reprapperMC/mini-gladiola/production_parts/machined_parts/bed_mount_plate/README

bed-mount-plate-mini_PP-MP0146_revD - without laser etching
bed-mount-plate-mini_PP-MP0146_revC - with laser etching
