reprapperMC/mini-gladiola/production_parts/machined_parts/electronics_case/README

revH - without laser etching
revG - with laser etching
