reprapperMC/mini-gladiola/gladiola_update.odt

Gladiola Feature Change/Addition | Notes
Cork/or other Dampening (z and y motors) | Using Moon’s dampener for Y axis, still reviewing for Z.
Wipe Fail Detect | Completed and need further testing
Thermal Runaway | Completed and need further testing
Moons Motors | Built up and testing with motors. Motors on BOM
Add fan guard inside of case on back side of fan to protect wiring captures and external ingress ease | Existing part – adding to BOM
Cable Chain Modifications/wiring improvements - Add ferrules to all power carrying wires and all wires connected to screw terminals. - Widen e-chains to maximum width available same height and radius in place today - Change all wires in cable chains to wiring rated for continuous bend applications - Correct wiring layout inside of the control box to address excessive wire bends, spiraling of wires, no service loops | Design Review held, prints out for quote and prototype
Sheet Metal - Power entry module opening need to account for powder coat thickness and over spray in the region. - Bed Plate – modified outline to accommodate safety warning etching, modified for cable chain attachment and powder coating - Bottom chassis – modified to accommodate cable chain attachment | Completed and out for quoting/prototyping
Pelonis Fans, extruder and case fan | So far current low speed fan is looking good. Testing thermal performance of z chip to verify
Tool head Mods | Decision not to move forward with most mods. Will be modifying the cap piece though
Plastic Components that are being modified or considering modified: Belt Mount strengthened Bearing holders on bed to add strain relief Bed corners to match taz 6 and possibly other materials Spool Mount - Spool mount v1.3, Mini- 50 NC's- propose extending mount tip 5mm to improve fit up clearance. Upper and lower chassis strain relief X end motor Possibly lower z’s if we do dampeners Extruder body and toolhead brace if toolhead Upper x bearing holder Wiper mount to TAZ6 version | dafsdfds
Evaluate Alternative Materials for components | PCTPE Gears, Cheetah Handle(possibly)
PP-GP0175 Y Idler mount, v1.3, Mini- RMA's and production parts show split parts, Change M8 FHS to a M8 BHCS, change screw head recess to accept the BHCS
Hardware: Black Oxide hardware- lacking oil protection- suggest dry finish Propose increasing the screw length used to secure PP-GP0173 to PP-GP0171 as it only gives 1 to 2 threads engagement | Evaluating Options
Remove or actually use the Z axis over travel switch | Removing
