reprapperMC/mini-gladiola/production_docs/toolhead_brace_notes.odt

Mini Toolhead change for gladiola:

A proposed change for the Gladiola batch of Mini's is to include a toolhead stiffening brace in the redesign.

An initial drop test was performed with a working foxglove mini equipped with the toolhead brace. This was a standard fedex drop test involving dropping the boxed printer on 1 corner, 3 edges and all 6 sides from a height of 30”. While the printer survived the test without damage, 1 of the foam pieces securing the x-carriage in place came loose, and the cable chain was sagging. We could likely prevent both of these issues with appliance tape securing the foam pieces, as the chain for gladiola should be much more robust than the foxglove version tested.

In order to be confident that the printer will survive shipping without the front and rear foam blocks, we will need to drop test a prototype unit with the updated sheet metal, printed parts and cable chains, as well as appliance tape securing the foam on the x axis.

PRO:

- Stiffer toolhead mounting, although there is little to no difference in the prints
- Early testing indicates that we would be able to ship the printer without the 2 pieces of foam that brace the front and back of the printer.
- The modified toolhead cap eliminates the need for zip ties when changing print heads.
  - This could also be done without the brace part

CONS:

- Although the printers and toolheads will be both backwards and forward compatable, a new printhead on and old machine and an old printhead on an new machine won't seem to fit together well.
  - We could resolve this by sending all new brace style toolheads with 2 M3x12 screws and washers, allowing users to print the braced cap to upgrade
  - We need to decide if and when we will roll this into the mini Flexystruder toolhead. Going from the braced version to having an unbraced accessory seems like a downgrade.
