reprapperMC/mini-gladiola/production_docs/Mini_Packing_list.pdf

## PACKING LIST

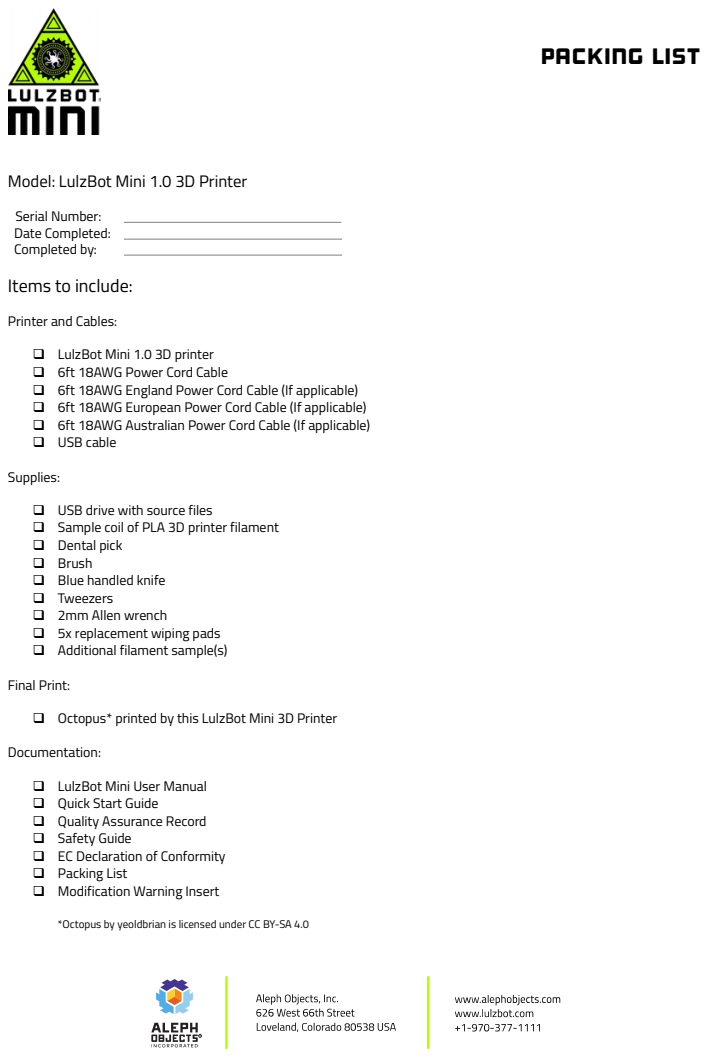
[picture p1: page 1]

Model: LulzBot Mini 1.0 3D Printer

Serial Number:
Date Completed:
Completed by:
Items to include:

Printer and Cables:
θ LulzBot Mini 1.0 3D printer
θ 6ft 18AWG Power Cord Cable
θ 6ft 18AWG England Power Cord Cable (If applicable)
θ 6ft 18AWG European Power Cord Cable (If applicable)
θ 6ft 18AWG Australian Power Cord Cable (If applicable)
θ USB cable
Supplies:
θ USB drive with source files
θ Sample coil of PLA 3D printer filament
θ Dental pick
θ Brush
θ Blue handled knife
θ Tweezers
θ 2mm Allen wrench
θ 5x replacement wiping pads
θ Additional filament sample(s)
Final Print:
θ Octopus* printed by this LulzBot Mini 3D Printer
Documentation:
θ LulzBot Mini User Manual
θ Quick Start Guide
θ Quality Assurance Record
θ Safety Guide
θ EC Declaration of Conformity
θ Packing List
θ Modification Warning Insert

*Octopus by yeoldbrian is licensed under CC BY-SA 4.0
