reprapperMC/mini-gladiola/production_parts/machined_parts/hexagon_hotend/Inspection_notes.odt

Incoming inspection notes on first 10 prototypes

Cooling block numbered by dots on upper ring

thermal grease is Insignia NS-PCYTC55 and is good to 300C

1. Single Dot

- Thermal grease applied
- Tube is bent
- Assembled heater block with old HC and thermistor
- Turning on temp to 290C for dwell test – Started at 7:25am – Stopped at 8:05am for inspection
- Lots of burn off smoke on initial heat up – Thermal grease? Stopped smoking after about 7 minutes – I think the smoke was from the machining oils on the nozzle.
- Wrong plating – Electroless Nickel with no PTFE
- No change in coating after 40 min 290C test
- Broke press fit loose with pliers and crescent wrench – add set screw back in

2. Two Dots

- Thermal grease applied
- Tube is bent
- Upper thread doesn't go quite flush
- Wrong plating – Electroless Nickel with no PTFE

3. Three Dots

- Thermal grease applied
- This can be used as a fully assembled nozzle
- Upper thread doesn't go quite flush
- Wrong plating – Electroless Nickel with no PTFE
- Being built up with new thermistor (#9) and HC from Xuanyuan Tech
- Now a flexystruder on a Mini
- Drilled out to 0.60mm nozzle size
- First print successful, didn't calibrate
- Printed a good bit of Ninjaflex through the nozzle
- Printed Semiflex – looks really good

4. Four Dots

- Thermal grease applied
- This can be used as a fully assembled nozzle
- Upper thread doesn't go quite flush
- Wrong plating – Electroless Nickel with no PTFE
- Started spinning at the press when heater block got tight

5. Five Dots

- No thermal grease
- This can be used as a fully assembled nozzle
- Upper thread doesn't go quite flush
- Wrong plating – Electroless Nickel with no PTFE
- Being built into full extruder – has old thermistor and HC
- In cluster since 10/22 in the evening

6. Six Dots

- No thermal grease
- This can be used as a fully assembled nozzle
- Upper thread doesn't go quite flush
- Wrong plating – Electroless Nickel with no PTFE
- Being built into full extruder – has old thermistor – has new HC from Xuanyuan Tech
- Ran 10m of ABS through with no issue at 75mm/min
- Ran 10m of Polycarbonate through at 75mm/min and noticed leaking (twice as fast as our fast print)
- Ran 10m of woodfill through the nozzle now at 75mm/min
- This was built with no loctite leaking makes sense

7. Seven Dots

- No thermal grease
- This can be used as a fully assembled nozzle
- Upper thread doesn't go quite flush
- Wrong plating – Electroless Nickel with no PTFE
- Forced removal of center tube – it's about the same as the Hexagon is to remove

8. Eight Dots

- No thermal grease
- This can be used as a fully assembled nozzle
- Upper thread doesn't go quite flush
- Wrong plating – Electroless Nickel with no PTFE
- Being built into full extruder – gave to Brent for speed testing – has old HC and thermistor

9. Nine Dots

- No thermal grease
- Upper thread doesn't go quite flush
- Going to extract tube to check press strength
- Wrong plating – Electroless Nickel with no PTFE
- Being built into full extruder – has old HC and thermistor installed on Mini- Running PLA
- Heating to 240C to run ABS through
- No visible smoke on heat up
- Ran a 3 hours house on medium and a 3 hour gear on fast with no issues
- Printing PCTPE gears (leveling had issues)
- Printing with Coffee PLA from Proto-pasta
- Printed HIPS
- Printed Bronzefill – clogged on first layer – wrong profile
- Printing Bronzefill again

10. Ten Dots

- Unknown if it's greased or not
- Labeled Bent from Shop
- Wrong plating – Electroless Nickel with no PTFE

Other parts

- 3x of the mount plates are out of spec. The nozzle doesn't slide on to them.
- Some of the nozzles were on the small side, tolerances on drawing should be updated
- There were huge metal chips in 3 of the nozzles
- Threads in top end of at least 3 cooling blocks are trash
- M6 on heat break tube and cooling block don't work with go/no-go gauges

Heater Cartridges:

Samples from Xuanyuan Technologies

22mm long instead of 20mm requested

Measured 18.9ohms (18.8-19.8 on RD ones)
