reprapperMC/mini-gladiola/production_docs/Mini-Subassembly-BOM.ods

Sheet: Engineering BOM
Description | AO Part # | Released to Order | Manufacturer | Manufacturer PN | Material | Category | Qty Per | UOM | Price Per Unit | N0TES | Price Total | Distributor | Distributor SKU | Vendor Subtotal | Guess Price/Unit | Guess Total | Guess Vendor Sub | Qty to Order | PO | PO Date | Expected Date | Notes | 1000 |  | Mass each (g) | Mass per Printer (g) | Mass Total (kg)
 |  |  |  |  |  |  |  |  |  |  |  |  |  |  |  |  |  | 3,050
This BOM does not yet reflect all of the modifications for Gladiola
Possibly Change part, part number or modify
Purchasing ordering – long lead item
 |  |  |  |  |  |  |  |  |  |  | #VALUE!
Gladiola Printer Assembly
Mini Frame with Y Axis Assembly
Bottom Plate | PP-MP0149_IR |  |  |  |  | Mechanical | 1 | ea | $28.25 |  | $28.25 | Rapid Sheet Metal |  |  |  | $28.25 |  | 3,050
Y Axis Assembly
Double Bearing Holder, switch, complete | - |  |  |  |  |  | - |  | $0.00
Double bearing holder Gladiola v0.1 | PP-GP0189??? |  |  |  |  | Printed | 1 | ea | $1.24 |  | $1.24 | Aleph Objects |  |  |  |  |  | 3,050 |  |  |  |  |  |  | 29.78 | 29.78 | 89.34 | black
Metric Brass Heat-Set Insert for Plastics Tapered, M3-.5 Internal Thread, 3.8mm Length | HD-MS0030 |  |  | 11125995 |  | Hardware | 4 | ea | $0.04 |  | $0.14 | Fastenal | 11125995 |  | $0.07 | $0.14 |  | 12,200 |  |  |  | Fastenal 1500 Pcs 10/8 34000 pcs 10/12 180,000 delivery 12/8/15 completes liability with fastenal moving to CEH for 2016 | 10/16/14 | 01/05/15 | PO04956 | 10/16/14 | 01/05/15 | PO04956 | 10/16/14 | 01/05/15
Metric Brass Heat-Set Insert for Plastics, Tapered, M2-.4 Internal Thread, 2.9MM Length | PP-MP0066 |  |  | 11126009 |  | Hardware | 4 | ea | $0.05 |  | $0.20 | Fastenal | 11126009 |  | $0.09 | $0.20 |  | 12,200 |  |  |  | 40,000 10/8 completes liability with fastenal moving to CEH for 2016 | Mcmaster | 94180A307
Double Bearing Holder, complete | - |  |  |  |  |  | - |  | $0.00
Double bearing holder Gladiola v0.1 | PP-GP0189 |  |  |  |  | Printed | 1 | ea | $1.24 |  | $1.24 | Aleph Objects |  |  |  |  |  | 3,050 |  |  |  |  |  |  | 29.78 | 29.78 | 89.34 | black
Metric Brass Heat-Set Insert for Plastics Tapered, M3-.5 Internal Thread, 3.8mm Length | HD-MS0030 |  |  | 11125995 |  | Hardware | 4 | ea | $0.04 |  | $0.14 | Fastenal | 11125995 |  | $0.07 | $0.14 |  | 12,200 |  |  |  | Fastenal 1500 Pcs 10/8 34000 pcs 10/12 180,000 delivery 12/8/15 completes liability with fastenal moving to CEH for 2016 | 10/16/14 | 01/05/15 | PO04956 | 10/16/14 | 01/05/15 | PO04956 | 10/16/14 | 01/05/15
SWITCH BASIC SPDT 3A .110QC 125V | EL-SW0022 | Y |  | SS-3GPT |  | Electronic | 2 | ea | $0.42 | Y | $0.84 | TTI | SW766-ND |  | $0.52 | $0.84 |  | 6,100 |  |  |  | TTI 18-20 wk Ltime Interium stock ordered Cyclop Electronics – until Heilind stock available
Metric Class 12.9 Socket Head Cap Screw Alloy Steel, Black, M2 Thread, 10mm Length, 0.4mm Pitch | HD-BT0107 |  |  | 0134599 |  | Hardware | 4 | ea | $0.02 |  | $0.09 | Fastenal | 0134599 |  | $0.04 | $0.09 |  | 6,080 |  |  |  | 8000 pcs requested delivery 10/16 | Mcmaster | 91290A017
Steel Flat Washer, DIN 125 zinc-plated class 4,M2 screw sz, 5mm OD, .25mm-.35mm thick | HD-WA0012 |  |  | 40350 |  | Hardware | 4 | ea | $0.00 |  | $0.01 | Fastenal | 40350 |  | $0.00 | $0.01 |  | 12,200 |  |  |  | 12,000 pcs requested delivery 10/19 | Mcmaster | 91166A180
DryLin® R - Solid polymer bearing RJM-01, 8mm | HD-BU0013 |  |  |  |  | Mechanical | 4 | ea | $1.15 |  | $4.60 | IGUS | RJM-01-08 | 2.90 | $2.00 | $4.60 | 0.00 | 12,200
8mm Smooth rod, 315mm, 304 Stainless Steel | HD-RD0035 | Y |  |  |  | Mechanical | 2 | ea | $3.65 | Y | $7.30 | Igus |  |  |  | $7.30 |  | 6,100
Y idler mount complete | - |  |  |  |  |  | - |  | $0.00 |  | #VALUE!
Y idler mount v1.3, Mini | PP-GP0175 |  |  |  |  | Printed | 1 | ea | $0.85 |  | $0.85 | Aleph Objects |  |  |  |  |  | 3,050 |  |  |  |  |  |  | 21.82 | 21.82 | 66.551 | black
Metric Brass Heat-Set Insert for Plastics Tapered, M3-.5 Internal Thread, 3.8mm Length | HD-MS0030 |  |  | 11125995 |  | Hardware | 4 | ea | $0.04 |  | $0.14 | Fastenal | 11125995 |  | $0.07 | $0.14 |  | 12,200 |  |  |  | Fastenal 1500 Pcs 10/8 34000 pcs 10/12 180,000 delivery 12/8/15 completes liability with fastenal moving to CEH for 2016 | 10/16/14 | 01/05/15 | PO04956 | 10/16/14 | 01/05/15 | PO04956 | 10/16/14 | 01/05/15
M8 Nyloc Nut, Zinc Plated | HD-NT0002 |  |  | 40163 |  | Hardware | 1 | ea | $0.03 |  | $0.03 | Fastenal | 40163 |  | $0.05 | $0.03 |  | 3,050 |  |  |  | Bin stock program Provided Fastenal totals for Foxglove demand and totals needed | Mcmaster | 90576A117
608-2RS ABEC3/C3 Rubber Sealed Bearing – BLACK | HD-MS0282 | Y |  |  |  | Mechanical | 2 | ea | $0.42 | Y | $0.84 | Just Great Bearings | 608-2RS ABEC3/C3 | 0.84 | $0.54 | $0.84 | 0.84 | 6,100 |  |  |  | SB Confirmed delivery middle October.
Black Alloy Steel Flat-Head Socket Cap Screw, Class 10.9, M8 Size, 40mm Length, 1.25mm Pitch | HD-BT0117 |  |  |  |  | Hardware | 1 | ea | $0.12 |  | $0.12 | Fastenal | 1139965 |  | $0.29 | $0.12 |  | 3,050 |  |  |  | Bin stock program Provided Fastenal totals for Foxglove demand and totals needed | Mcmaster | 91294A289
M8 Washer, Steel, Zinc Plated | HD-WA0006 |  |  | 1140357 |  | Hardware | 3 | ea | $0.01 |  | $0.03 | Fastenal | A1062TR-ND |  | $0.01 | $0.03 |  | 9,150 |  |  |  | Bin stock program Provided Fastenal totals for Foxglove demand and totals needed | Mcmaster | 91166A270
Y end motor complete | - |  |  |  |  |  | - |  | $0.00 |  | $0.00
Y End Motor | PP-GP0196 |  |  |  |  | Printed | 1 | ea | $0.99 |  | $0.99 | Aleph Objects |  |  |  |  |  | 3,050 |  |  |  |  |  |  | 27.3 | 27.3 | 83.265 | black
Metric Brass Heat-Set Insert for Plastics Tapered, M3-.5 Internal Thread, 3.8mm Length | HD-MS0030 |  |  | 11125995 |  | Hardware | 4 | ea | $0.04 |  | $0.14 | Fastenal | 11125995 |  | $0.07 | $0.14 |  | 12,200 |  |  |  | Fastenal 1500 Pcs 10/8 34000 pcs 10/12 180,000 delivery 12/8/15 completes liability with fastenal moving to CEH for 2016 | 10/16/14 | 01/05/15 | PO04956 | 10/16/14 | 01/05/15 | PO04956 | 10/16/14 | 01/05/15
M3 x 8 Bolt, BHCS, Black-Oxide | HD-BT0137 |  |  | 40868 |  | Hardware | 8 | ea | $0.01 |  | $0.09 | Fastenal | 40868 |  |  | $0.09 |  | 24,400 |  |  |  | 9000 pcs requested delivery 10/19 | Mcmaster | 91239A113
Black-Oxide 18-8 Stainless Steel Flat Washer, M3 Screw Size, 3.2mm ID, 7.0mm OD | HD-WA0038 |  |  |  |  |  | 8 | ea | $0.02 |  | $0.16 | Fastenal |  |  | $0.00 | $0.16 |  | 24,400
NEMA 17 Stepper Motor, Moons' - NOT INCLUDING wire harness - As per attached Drawing. | EL-MT0029 |  | Moons | MS17HD6P4150MS17HD6P4150-01-B | Moons | MS17HD6P4150-01-B | 1 | ea | $8.30 |  | $8.30 | 0 | PO11681 | 01/25/16 | 03/08/16 | The first 1500 units might have to ship via Air, remaining units will come FOB Chicago as needed to meet production. TS
GT2 Timing Pulley, 5mm Bore Aluminum w/set screws | HD-MS0033 |  |  | B & B Manufacturing, Inc | 16-2P06M6CA5 5MM BORE ALUMINUM |  | 1 | ea | $2.90 |  | $2.90 | 2.90 | 0 | 0.00 | 0
Moon’s motor Dampener | EL-MT0032 |  | Moons | 4696325000008 | Moons | Hardware | 1 | ea | $2.45 |  | $2.45
M3 x 6 Bolt, BHCS Black-Oxide | HD-BT0140 |  |  | 39502 |  | Hardware | 4 | ea | $0.02 |  | $0.08 | Fastenal | 39502 |  |  | $0.08 |  | 12,200 |  |  |  | 12,000 pcs requested delivery 10/19
Black-Oxide 18-8 Stainless Steel Flat Washer, M3 Screw Size, 3.2mm ID, 7.0mm OD | HD-WA0038 |  |  |  |  |  | 4 | ea | $0.02 |  | $0.08 | Fastenal |  |  | $0.00 | $0.08 |  | 12,200
GT2, Single sided Neoprene Belt | HD-BL0015 |  |  |  |  | Mechanical | 1 | ea | $1.93 |  | $1.93 | B & B Manufacturing, Inc | 744-2P-06 (2MR-744-06) |  | $2.29 | $1.93 |  | 3,050
Mini Bed Plate Assembly
Bed Mount Plate | PP-MP0146_rA |  |  |  |  | Mechanical | 1 | ea | $9.50 |  | $9.50 | Rapid Sheet Metal |  |  |  | $9.50 |  | 3,050
bed corners, mini v2.5 | PP-GP0248 |  |  |  |  | Printed | 4 | ea | $0.20 |  | $0.80
M3 x 8 Bolt, BHCS, Black-Oxide | HD-BT0137 |  |  | 40868 |  | Hardware | 13 | ea | $0.01 |  | $0.15 | Fastenal | 40868 |  |  | $0.15 |  | 39,650 |  |  |  | 9000 pcs requested delivery 10/19 | Mcmaster | 91239A113
Black-Oxide 18-8 Stainless Steel Flat Washer, M3 Screw Size, 3.2mm ID, 7.0mm OD | HD-WA0038 |  |  |  |  |  | 15 | ea | $0.02 |  | $0.30 | Fastenal |  |  | $0.00 | $0.30 |  | 45,750
Wiper mount v1.0, Mini | PP-GP0168 |  |  |  |  | Printed | 1 | ea | $0.38 |  | $0.38 | Aleph Objects |  |  |  |  |  | 3,050 |  |  |  |  |  |  | 11.39 | 11.39 | 34.7395 | black
LulzBot Wiper Pad | PP-FP0084 |  |  |  |  |  | 1 | ea | $0.29 |  | $0.29
Belt Mount Complete | - |  |  |  |  |  | -
Belt mount v1.0, Mini | PP-GP0181 |  |  |  |  | Printed | 1 | ea | $0.50 |  | $0.50 | Aleph Objects |  |  |  |  |  | 3,050 |  |  |  |  |  |  | 12.43 | 12.43 | 37.9115 | black
Metric Brass Heat-Set Insert for Plastics Tapered, M3-.5 Internal Thread, 3.8mm Length | HD-MS0030 |  |  | 11125995 |  | Hardware | 5 | ea | $0.04 |  | $0.18 | Fastenal | 11125995 |  | $0.07 | $0.18 |  | 15,250 |  |  |  | Fastenal 1500 Pcs 10/8 34000 pcs 10/12 180,000 delivery 12/8/15 completes liability with fastenal moving to CEH for 2016 | 10/16/14 | 01/05/15 | PO04956 | 10/16/14 | 01/05/15 | PO04956 | 10/16/14 | 01/05/15
Bottom Belt Mount | Need P/N |  |  |  |  |  | 1
M3 x 12 Bolt, SHCS Black-Oxide | HD-BT0039 |  |  | 39505 |  | Hardware | 2 | ea | $0.01 |  | $0.02 | Fastenal | 39505 |  | $0.01 | $0.02 |  | 6,100 |  |  |  | Bin stock program Provided Fastenal totals for Foxglove demand and totals needed | Mcmaster | 91290A117
M3 x 8 Bolt, BHCS, Black-Oxide | HD-BT0137 |  |  | 40868 |  | Hardware | 6 | ea | $0.01 |  | $0.07 | Fastenal | 40868 |  |  | $0.07 |  | 18,300 |  |  |  | 9000 pcs requested delivery 10/19 | Mcmaster | 91239A113
Black-Oxide 18-8 Stainless Steel Flat Washer, M3 Screw Size, 3.2mm ID, 7.0mm OD | HD-WA0038 |  |  |  |  |  | 6 | ea | $0.02 |  | $0.12 | Fastenal |  |  | $0.00 | $0.12 |  | 18,300
M3 Nyloc Nut, Zinc Plated | HD-NT0001 |  |  | 40143 |  | Hardware | 1 | ea | $0.05 | Fasten fan to cover | $0.05 | Fastenal | 40143 |  | $0.01 | $0.05 |  | 3,050 |  |  |  | Bin stock program Provided Fastenal totals for Foxglove demand and totals needed | Mcmaster | 90576A102
M3 star washer | HD-WA0035 |  |  |  |  |  | 1 |  | $0.02 |  | $0.02
M3 x 8 steel bolt | HD-BT0104 |  |  |  |  |  | 1 |  | $0.09 |  | $0.09
Bed Harness Completed Assembly | EL-HR0114 |  |  |  |  |  | 1
Igus Bed Harness | EL-HR0102 |  | Igus |  |  | Electronic | 1 | ea | $27.10 |  | $27.10
TVS Diode – 1500W, 5V Reverse Standoff, 6V Breakdown, 9.4V Clamp, 200A Surge | EL-MS0329 |  | ON Semiconductor | 1N6373RL4G |  | Electronic | 1 | ea | $0.00 |  | $0.00
Solder Sleeve B155-9002, one step | EL-MS0416 |  | Te Connectivity | B-155-9002 |  | Electronic | 1 | ea | $0.00 |  | $0.00 |  |  |  |  |  |  |  |  |  |  | Added in Rev F
Term Ring Non Ins 26-22AWG #4 Order Bulk Only | EL-MS0141 |  | Panduit | P22-4R-M |  | Electronic | 3 | ea | $0.07 |  | $0.00 | P22-4R-M |  |  | $0.21 |  | 0
CONN RECEPT FASTON 22-26AWG .110 | EL-MS0142 |  | TE Connectivity / AMP | 7-520365-2 |  | Electronic | 4 | ea | $0.08 |  | $0.00 | A27793-ND |  | $0.22 | $0.30 |  | 0
CONN TERM FEMALE 22-24AWG TIN | EL-MS0059 |  | Molex Inc. | 16-02-0086 / 16-02-0102 |  | Electronic | 9 | ea | $0.01 |  | $0.00 | WM2510TR-ND |  | $0.05 | $0.13 |  | 0
CONN HOUSING 2POS .100 W/LATCH | PC-CN0001 |  | Molex Inc. | 050579402 |  | Electronic | 1 | ea | $0.05 |  | $0.00 | WM2900-ND |  | $0.13 | $0.05 |  | 0
Heavy Duty Power Connectors HOUSING ONLY, BLACK POWERPOLE 15/45 | EL-MS0008 |  | Anderson | 1327G6-BK |  | Electronic | 2 | ea | $0.19 |  | $0.00 | 879-1327G6-BK |  | $0.26 | $0.38 |  | 0
Heavy Duty Power Connectors POWERPOLE 15A CONT | EL-MS0010 |  | Anderson | 1332-BK |  | Electronic | 2 | ea | $0.10 |  | $0.00 | 879-1332-BK | 0.00 | $0.10 | $0.20 | 0.52 | 0
Ferrule for 16 AWG wire | EL-MS0361 |  | Panduit | FSD78-6-D |  | Electronic | 2 | ea | $0.00 |  | $0.00
Polyester wire labels for thermal transfer printers | OF-MS0461 |  | BradyBondz | THT-3-423-10 |  | Electronic | 4 | ea | $0.00 |  | $0.00
Igus 6-wire Chainflex Cable | EL-WR0138 |  | Igus | CF9-02-06 |  | Electronic | 700 | mm | $0.00 |  | $0.00
IGUS Chainflex® CF9 control cable TPE | EL-WR0141 |  | Igus | CF9-02-02 |  | Electronic | 670 | mm | $0.00 |  | $0.00
IGUS 2-Wire 16AWG Chainflex Cable | EL-WR0137 |  | Igus | CF9-15-02 |  | Electronic | 630 | mm | $0.00 |  | $0.00
Igus 06 Series Energy Chain 20mm Inner Width, 28mm Bend Radius | EL-MS0379 |  | Igus | 06-20-028-0 |  | Electronic | 11 | ea | $0.00 |  | $0.00 | 06-10-028-0 |  |  | 0 |  | 8100 feet
Igus 06 Series Mounting Bracket Set 20mm Inner Width (male and female) | EL-MS0382 |  | Igus | E2-100-20-12 |  | Electronic | 1 | ea | $1.80 |  | $0.00 |  |  |  | 9,150 |  |  |  | Female and Males are sold as a set under a single MFR Part Number. Please see part number description in ERP for details and make sure we don't double order.
XY Harness Assembly | EL-HR0115 |  |  |  |  | Electronic
Ferrite Tubular Bead 10.16MM | EL-MS0343 |  | Laird-Signal Integrity Products | 28B0735-000 |  | Electronic | 1 | ea | $0.50 |  | $0.50 |  |  |  |  |  |  |  |  |  |  |  | `
Heat Shrink DL WL Q53X ¾" | EL-MS0259 |  | Qualtek | Q5-3X-3/4-01-QB48IN-5 |  | Electronic | 50 | mm | $0.01 |  | $0.50
Term Ring Non Ins 26-22AWG #4 Order Bulk Only | EL-MS0141 |  | Panduit | P22-4R-M |  | Electronic | 2 | ea | $0.07 |  | $0.14 | P22-4R-M |  |  | $0.14 |  | 0
CONN TERM FEMALE 22-24AWG TIN | EL-MS0059 |  | Molex Inc. | 16-02-0086 / 16-02-0102 |  | Electronic | 12 | ea | $0.01 |  | $0.18 | WM2510TR-ND |  | $0.05 | $0.18 |  | 0
CONN HOUSING 2POS .100 W/LATCH | PC-CN0001 |  | Molex Inc. | 050579402 |  | Electronic | 1 | ea | $0.05 |  | $0.05 | WM2900-ND |  | $0.13 | $0.50 |  | 0
Connector, 4 pin Female housing with latch | EL-MS0062 |  | Molex Inc. | 050579404 |  | Electronic | 3 | ea | $0.05 |  | $0.16 | SAGER | WM2902-ND |  | $0.12 | $0.16 |  | 9,150
Term Block Plug 2POS STR 5.08MM | PC-CN0032 |  | Molex | 395300002 |  | Electronic | 1 | ea | $0.46 |  | $0.46 | WM7819-ND |  | $0.56 | $0.91 |  | 0 |  |  |  | TTI confirmed, Juniperbush build may need to use some of this stock- SAGER 600 pcs 9/4 12 wks balance aprox 11/10 delivery- There is stock on hand from 10/16 delivery for Foxglove | 695 * 3050 / 304.8 = 6955 ft need 3 x 3200' rolls ordered 9600 ft 2 x 3200' rolls
Connector Housing 3POS .100 W/Latch | PC-CN0003 |  | Molex | 50579403 |  | Electronic | 3 | ea | $0.05 |  | $0.15 | WM2901-ND |  | $0.18 | $0.15 |  | 0
Shielded 4Cond 22AWG | EL-WR0099 |  | General Cable/Carol Brand | C0762A.41.10 |  | Electronic | 1680 | mm | $0.00 |  | $1.70 | C0762A.41.10 |  | $0.00 | $1.70 |  | 16,811
Motor JST 6-pin Housing | EL-MS0355 |  | JST | PHR-6 |  | Electronic | 3 | ea | $0.10 |  | $0.30
Female JST pin | EL-MS0351 |  | JST | SPH-002T-P0.5S |  | Electronic | 12 | ea | $0.05 |  | $0.60
Tubing, Corrugated Loom .25" | EL-MS0073 |  | Panduit | 708161 |  | Electronic | 790 | mm | $0.00 |  | $0.79 |  |  |  | $0.79 |  | 7,905 |  |  |  | 695 * 3050 / 304.8 = 6955 ft need 3 x 3200' rolls ordered 9600 ft 2 x 3200' rolls
24AWG Stranded – Black | EL-WR0105 |  |  | HU1569247BK |  | Electronic | 182 | mm | $0.00 |  | $0.01 | Allcable | HU1569247BK |  |  | $0.01 |  | 1,821
Ferrule, Terminals 16AWG NON-INSL | EL-MS0360 |  | Panduit | F78-8-M |  | Electronic | 1 | ea | $0.00 |  | $0.00
Flexible Polyolefin Heat Shrink Tubing 1/8" ID Before, 1/16" ID After, 100' L, Black | HD-TB0032 |  |  |  |  | Electronic | 65 | mm | $0.00 |  | $0.00
M3 x 6 Bolt, FHCS Black-Oxide | HD-BT0128 |  |  | 40921 |  | Hardware | 6 | ea | $0.04 |  | $0.22 | Fastenal | 40921 |  |  | $0.22 |  | 18,300 |  |  |  | Bin stock program Provided Fastenal totals for Foxglove demand and totals needed | Mcmaster | 91294A126
Bed clip v3 | PP-GP0249 |  |  |  |  |  | 1 | ea | $0.40 |  | $0.40
Square Bumper | HD-MS0054 |  | Advanced Antivibration components |  |  | Hardware | 4 | ea | $0.09 |  | $0.36
Left Plate | PP-FP0055_rD |  |  |  |  | Mechanical | 1 | ea | $17.75 |  | $17.75 | Rapid Sheet Metal |  |  |  | $17.75 |  | 3,050
Right Plate | PP-FP0052rC |  |  |  |  | Mechanical | 1 | ea | $17.75 |  | $17.75
Top Plate | PP-FP0051_rD |  |  |  |  | Mechanical | 1 | ea | $18.50 |  | $18.50 | Rapid Sheet Metal |  |  |  | $18.50 |  | 3,050
Relief Mount Complete (Upper) |  |  |  |  |  |  |  |  | $0.00 |  | $0.00
Relief Mount v3.0 | Need P/N |  |  |  |  | Printed | 1 | ea | $0.20 |  | $0.20
Metric Brass Heat-Set Insert for Plastics Tapered, M3-.5 Internal Thread, 3.8mm Length | HD-MS0030 |  |  | 11125995 |  | Hardware | 2 | ea | $0.04 |  | $0.07 | Fastenal | 11125995 |  | $0.07 | $0.07 |  | 6,100 |  |  |  | Fastenal 1500 Pcs 10/8 34000 pcs 10/12 180,000 delivery 12/8/15 completes liability with fastenal moving to CEH for 2016 | 10/16/14 | 01/05/15 | PO04956 | 10/16/14 | 01/05/15 | PO04956 | 10/16/14 | 01/05/15
Lower Relief Mount v 1.2 | Need P/N |  |  |  |  | Printed | 1 | ea | $1.00 |  | $1.00
Handle | - |  |  |  |  |  | -
Handle bar v2.4, Mini | PP-GP0169 |  |  |  |  | Printed | 1 | ea | $1.32 |  | $1.32 | Aleph Objects |  |  |  |  |  | 3,050 |  |  |  |  |  |  | 40.45 | 40.45 | 123.3725 | black
Metric Brass Heat-Set Insert for Plastics Tapered, M3-.5 Internal Thread, 3.8mm Length | HD-MS0030 |  |  | 11125995 |  | Hardware | 3 | ea | $0.04 |  | $0.11 | Fastenal | 11125995 |  | $0.07 | $0.11 |  | 9,150 |  |  |  | Fastenal 1500 Pcs 10/8 34000 pcs 10/12 180,000 delivery 12/8/15 completes liability with fastenal moving to CEH for 2016 | 10/16/14 | 01/05/15 | PO04956 | 10/16/14 | 01/05/15 | PO04956 | 10/16/14 | 01/05/15
M3 x 12 Bolt, SHCS Black-Oxide | HD-BT0039 |  |  | 39505 |  | Hardware | 5 | ea | $0.01 |  | $0.06 | Fastenal | 39505 |  | $0.01 | $0.06 |  | 15,250 |  |  |  | Bin stock program Provided Fastenal totals for Foxglove demand and totals needed | Mcmaster | 91290A117
Black-Oxide 18-8 Stainless Steel Flat Washer, M3 Screw Size, 3.2mm ID, 7.0mm OD | HD-WA0038 |  |  |  |  |  | 5 | ea | $0.02 |  | $0.10 | Fastenal |  |  | $0.00 | $0.10 |  | 15,250
Mini Spool Arm Assembly
Spool Hinge | - |  |  |  |  |  | -
Spool hinge v1.3, Mini | PP-GP0173 |  |  |  |  | Printed | 1 | ea | $0.39 |  | $0.39 | Aleph Objects |  |  |  |  |  | 3,050 |  |  |  |  |  |  | 10.69 | 10.69 | 32.6045 | black
Metric Brass Heat-Set Insert for Plastics Tapered, M3-.5 Internal Thread, 3.8mm Length | HD-MS0030 |  |  | 11125995 |  | Hardware | 4 | ea | $0.04 |  | $0.14 | Fastenal | 11125995 |  | $0.07 | $0.14 |  | 12,200 |  |  |  | Fastenal 1500 Pcs 10/8 34000 pcs 10/12 180,000 delivery 12/8/15 completes liability with fastenal moving to CEH for 2016 | 10/16/14 | 01/05/15 | PO04956 | 10/16/14 | 01/05/15 | PO04956 | 10/16/14 | 01/05/15
Spool arm v1.0, Mini | PP-GP0172 |  |  |  |  | Printed | 1 | ea | $0.60 |  | $0.60 | Aleph Objects |  |  |  |  |  | 3,050 |  |  |  |  |  |  | 16.72 | 16.72 | 50.996 | black
Spool Mount | - |  |  |  |  |  | -
Spool mount v1.3, Mini | PP-GP0171 |  |  |  |  | Printed | 1 | ea | $2.20 |  | $2.20
Metric Brass Heat-Set Insert For Plastics Tapered, M5-.8 Internal Thread, 6.7mm Length | HD-MS0158 |  |  | 11125997 |  | Hardware | 4 | ea | $0.07 |  | $0.30 | Fastenal | 11125997 |  | $0.17 | $0.30 |  | 12,200 |  |  |  | Fastenal 10,000 Pcs 10/8 30,000 12/8 completes liability with fastenal moving to CEH for 2016 | Mcmaster | 94180A361 - As of 09/17/2014 they have a 2 week lead time on this part. I don't want to fill in because Fastenal Rep is hoping to get units from the Manufacturer sooner, just can't promise
Alloy Steel Shoulder Screw, 6mm Diameter x 10mm Long Shoulder, M5 Thread | HD-BT0120 |  |  | 40000 |  | Hardware | 2 | ea | $0.55 |  | $1.11 | Fastenal | 40000 |  |  | $1.11 |  | 6,100 |  |  |  | Requested 4000 pcs delivery 10/19 | Mcmaster | 92981A100
Black-Oxide 18-8 Stainless Steel Flat Washer, M5 Screw Size, 5.3mm ID, 10.0mm OD | HD-WA0040 |  |  |  |  |  | 2 |  | $0.03 |  | $0.06 | Fastenal |  |  |  | $0.06 |  | 6,100 |  |  |  | Bin stock program Provided Fastenal totals for Foxglove demand and totals needed | Mcmaster | 91166A240
M5 x 14 Bolt, SHCS Black-Oxide | HD-BR0159 |  |  | 39544 |  | Hardware | 2 | ea | $0.12 |  | $0.24 | Fastenal | 39544 |  | $0.02 | $0.24 |  | 6,100 |  |  |  | Bin stock program Provided Fastenal totals for Foxglove demand and totals needed | Mcmaster | 91290A224
M3 x 6 Bolt, FHCS Black-Oxide | HD-BT0128 |  |  | 40921 |  | Hardware | 4 | ea | $0.04 |  | $0.15 | Fastenal | 40921 |  |  | $0.15 |  | 12,200 |  |  |  | Bin stock program Provided Fastenal totals for Foxglove demand and totals needed | Mcmaster | 91294A126
Mini X Carriage Assembly
Mini X End Idler Z Drive Assembly
NEMA 17 Stepper Motor, Moons' - NOT INCLUDING wire harness - As per at | EL-MT0029 |  | Moons | MS17HD6P4150MS17HD6P4150-01-B | Moons | MS17HD6P4150-01-B | 1 | ea | $8.30 |  | $8.30 | 0 | PO11681 | 01/25/16 | 03/08/16 | The first 1500 units might have to ship via Air, remaining units will come FOB Chicago as needed to meet production. TS
Moon’s motor Dampener | EL-MT0032 |  | Moons | 4696325000008 | Moons |  | 1 | ea | $2.45 |  | $2.45
Helical Flexible Shaft Coupling with Set Screw - X10835-5mm-5mm - Anodize IAW HPS1000 w/set screws | HD-MS0351 |  | Helical Products Company, Inc. | 30070 | Helical Products Company, Inc. | Mechanical | 1 | ea | $6.33 |  | $6.33 | 0 | PO11245 | 12/23/15 | 01/08/16 | Recieved QUOTE drafted PO11245 for Nutmeg and Olive. KG Toni will manage this line item.TS (R&D going to build up with R+W products coupler) - Pulling in the Nutmeg units by 1/8/16 – Olive will be here before 2/5/16. TS
Z lower right complete |  |  |  |  |  |  |  |  |  |  |  |  |  |  |  |  |  | 0 |  |  |  |  |  |  | 58 | 0 | 0 | green
Z lower right v1.2, Mini, Lulzbot green | PP-GP0205 |  |  |  |  | Printed | 1 | ea | $2.20 |  | $2.20 | Aleph Objects
Metric Brass Heat-Set Insert for Plastics Tapered, M3-.5 Internal Thread, 3.8mm Length | HD-MS0030 |  |  | 11125995 |  | Hardware | 5 | ea | $0.04 |  | $0.18 | Fastenal | 11125995 |  | $0.07 | $0.18 |  | 15,250 |  |  |  | Fastenal 1500 Pcs 10/8 34000 pcs 10/12 180,000 delivery 12/8/15 completes liability with fastenal moving to CEH for 2016 | 10/16/14 | 01/05/15 | PO04956 | 10/16/14 | 01/05/15 | PO04956 | 10/16/14 | 01/05/15
M3 x 10 SHCS | Need P/N |  |  |  |  |  | 2
M3 x 6 BHCS | HD-BT0096 |  |  | 39502 |  | Hardware | 2 | ea | $0.07 |  | $0.14 | Fastenal | 39502 |  |  | $0.14 |  | 6,100 |  |  |  | 12,000 pcs requested delivery 10/19
Black-Oxide 18-8 Stainless Steel Flat Washer, M3 Screw Size, 3.2mm ID, 7.0mm OD | HD-WA0038 |  |  |  |  |  | 4 | ea | $0.02 |  | $0.08 | Fastenal |  |  | $0.00 | $0.08 |  | 12,200
Drive Rod 10mm (Rev D) | HD-RD0037 |  |  |  |  | Mechanical | 1 | ea | $16.94 |  | $16.94 | Thomson |  |  |  | $16.94 |  | 3,050
10mm x 2mm Flange mount supernut | HD-NT0047 |  |  | MTS10 x 2m |  | Mechanical | 1 | ea | $4.81 |  | $4.81 | Thomson |  |  |  | $4.81 |  | 3,050
M5 x 10 Bolt, SHCS Black-Oxide | HD-BT0048 |  |  | 39544 |  | Hardware | 3 | ea | $0.02 |  | $0.06 | Fastenal | 39544 |  | $0.02 | $0.06 |  | 9,150 |  |  |  | Bin stock program Provided Fastenal totals for Foxglove demand and totals needed | Mcmaster | 91290A224
Black-Oxide 18-8 Stainless Steel Flat Washer, M5 Screw Size, 5.3mm ID, 10.0mm OD | HD-WA0040 |  |  |  |  |  | 3 |  | $0.03 |  | $0.09 | Fastenal |  |  |  | $0.09 |  | 9,150 |  |  |  | Bin stock program Provided Fastenal totals for Foxglove demand and totals needed | Mcmaster | 91166A240
Mini X End Idler Assembly
X end idler v2.4, Mini, Complete
X end idler v2.4, Mini | PP-GP0185 |  |  |  |  | Printed | 1 | ea | $3.31 |  | $3.31 | Aleph Objects |  |  |  |  |  | 3,050 |  |  |  |  |  |  | 91.17 | 91.17 | 278.0685 | black
Metric Brass Heat-Set Insert For Plastics Tapered, M5-.8 Internal Thread, 6.7mm Length | HD-MS0158 |  |  | 11125997 |  | Hardware | 3 | ea | $0.07 |  | $0.22 | Fastenal | 11125997 |  | $0.17 | $0.22 |  | 9,150 |  |  |  | Fastenal 10,000 Pcs 10/8 30,000 12/8 completes liability with fastenal moving to CEH for 2016 | Mcmaster | 94180A361 - As of 09/17/2014 they have a 2 week lead time on this part. I don't want to fill in because Fastenal Rep is hoping to get units from the Manufacturer sooner, just can't promise
Metric Brass Heat-Set Insert for Plastics Tapered, M3-.5 Internal Thread, 3.8mm Length | HD-MS0030 |  |  | 11125995 |  | Hardware | 2 | ea | $0.04 |  | $0.07 | Fastenal | 11125995 |  | $0.07 | $0.07 |  | 6,100 |  |  |  | Fastenal 1500 Pcs 10/8 34000 pcs 10/12 180,000 delivery 12/8/15 completes liability with fastenal moving to CEH for 2016 | 10/16/14 | 01/05/15 | PO04956 | 10/16/14 | 01/05/15 | PO04956 | 10/16/14 | 01/05/15
608-2RS ABEC3/C3 Rubber Sealed Bearing – BLACK | HD-MS0282 |  |  |  |  | Mechanical | 2 | ea | $0.42 |  | $0.84 | Just Great Bearings | 608-2RS ABEC3/C3 | 0.84 | $0.54 | $0.84 | 0.84 | 6,100 |  |  |  | SB Confirmed delivery middle October.
DryLin® R - Solid polymer bearing RJM-01, 8mm | HD-BU0013 | Y |  |  |  | Mechanical | 2 | ea | $1.15 | Y | $2.30 | IGUS | RJM-01-08 | Err:509 | $2.00 | $2.30 | Err:509 | 6,100
M8 Nyloc Nut, Zinc Plated | HD-NT0002 |  |  | 40163 |  | Hardware | 1 | ea | $0.03 |  | $0.03 | Fastenal | 40163 |  | $0.05 | $0.03 |  | 3,050 |  |  |  | Bin stock program Provided Fastenal totals for Foxglove demand and totals needed | Mcmaster | 90576A117
M8 Washer, Steel, Zinc Plated | HD-WA0006 |  |  | 1140357 |  | Hardware | 2 | ea | $0.01 |  | $0.02 | Fastenal | A1062TR-ND |  | $0.01 | $0.02 |  | 6,100 |  |  |  | Bin stock program Provided Fastenal totals for Foxglove demand and totals needed | Mcmaster | 91166A270
Black Alloy Steel Flat-Head Socket Cap Screw, Class 10.9, M8 Size, 45mm Length, 1.25mm Pitch | HD-BT0131 |  |  |  |  | Hardware | 1 | ea | $0.13 |  | $0.13 | Fastenal | 0154350 |  | $0.33 | $0.13 |  | 3,050 |  |  |  | Bin stock program Provided Fastenal totals for Foxglove demand and totals needed | Mcmaster | 91294A290
Z upper right v1.2, Mini, Complete
Z upper right v1.2, Mini | PP-GP0180 |  |  |  |  | Printed | 1 | ea | $1.10 |  | $1.10 | Aleph Objects |  |  |  |  |  | 3,050 |  |  |  |  |  |  | 32.25 | 32.25 | 98.3625 | black
Metric Brass Heat-Set Insert for Plastics Tapered, M3-.5 Internal Thread, 3.8mm Length | HD-MS0030 |  |  | 11125995 |  | Hardware | 6 | ea | $0.04 |  | $0.21 | Fastenal | 11125995 |  | $0.07 | $0.21 |  | 18,300 |  |  |  | Fastenal 1500 Pcs 10/8 34000 pcs 10/12 180,000 delivery 12/8/15 completes liability with fastenal moving to CEH for 2016 | 10/16/14 | 01/05/15 | PO04956 | 10/16/14 | 01/05/15 | PO04956 | 10/16/14 | 01/05/15
Bearing 627 Ball Bearings 627 RS – BLACK | HD-MS0277 |  |  |  |  | Mechanical | 2 | ea | $0.65 |  | $1.30 | Just Great Bearings | 627-2RS | 1.30 | $0.54 | $1.30 | 1.30 | 6,100 |  |  |  | SB Confirmed delivery middle October.
8mm Smooth rod, 315mm, 304 Stainless Steel | HD-RD0035 |  |  |  |  | Mechanical | 1 | ea | $3.65 |  | $3.65 | Igus |  |  |  | $3.65 |  | 3,050
M3 Set Screw (Grub Screw) | HD-BT0012 |  |  | 40818 |  | Hardware | 1 | ea | $0.03 |  | $0.03 | Fastenal | 40818 |  | $0.02 | $0.03 |  | 3,050 |  |  |  | Bin stock program Provided Fastenal totals for Foxglove demand and totals needed | Mcmaster | 91390A100
Mini X End Motor Z Drive Assembly
NEMA 17 Stepper Motor, Moons' - NOT INCLUDING wire harness - As per attached Drawing. | EL-MT0029 |  | Moons | MS17HD6P4150MS17HD6P4150-01-B | Moons | MS17HD6P4150-01-B | 1 | ea | $8.30 |  | $8.30 | 0 | PO11681 | 01/25/16 | 03/08/16 | The first 1500 units might have to ship via Air, remaining units will come FOB Chicago as needed to meet production. TS
Helical Flexible Shaft Coupling with Set Screw - X10835-5mm-5mm - Anodize IAW HPS1000 | HD-MS0351 |  | Helical Products Company, Inc. | 30070 | Helical Products Company, Inc. | Mechanical | 1 | ea | $6.33 |  | $6.33 | 0 | PO11245 | 12/23/15 | 01/08/16 | Recieved QUOTE drafted PO11245 for Nutmeg and Olive. KG Toni will manage this line item.TS (R&D going to build up with R+W products coupler) - Pulling in the Nutmeg units by 1/8/16 – Olive will be here before 2/5/16. TS
Moon’s motor Dampener | EL-MT0032 |  | Moons | 4696325000008 | Moons |  | 1 | ea | $2.45 |  | $2.45
Z lower left v1.2, Mini, Lulzbot green, complete
Z lower left v1.2, Mini, Lulzbot green | PP-GP0204 |  |  |  |  | Printed | 1 | ea | $2.02 |  | $2.02 | Aleph Objects |  |  |  |  |  | 3,050 |  |  |  |  |  |  | 58 | 58 | 176.9 | green
Metric Brass Heat-Set Insert for Plastics Tapered, M3-.5 Internal Thread, 3.8mm Length | HD-MS0030 |  |  | 11125995 |  | Hardware | 5 | ea | $0.04 |  | $0.18 | Fastenal | 11125995 |  | $0.07 | $0.18 |  | 15,250 |  |  |  | Fastenal 1500 Pcs 10/8 34000 pcs 10/12 180,000 delivery 12/8/15 completes liability with fastenal moving to CEH for 2016 | 10/16/14 | 01/05/15 | PO04956 | 10/16/14 | 01/05/15 | PO04956 | 10/16/14 | 01/05/15
M3 x 10 SHCS | Need P/N |  |  |  |  |  | 2
M3 x 6 BHCS | Need P/N |  |  | 39502 |  | Hardware | 2 | ea | $0.02 | attaching y Axis to Frame | $0.04 | Fastenal | 39502 |  |  | $0.04 |  | 6,100 |  |  |  | 12,000 pcs requested delivery 10/19
Black-Oxide 18-8 Stainless Steel Flat Washer, M3 Screw Size, 3.2mm ID, 7.0mm OD | HD-WA0038 |  |  |  |  |  | 4 | ea | $0.02 |  | $0.08 | Fastenal |  |  | $0.00 | $0.08 |  | 12,200
Drive Rod 10mm (Rev D) | HD-RD0037 |  |  |  |  | Mechanical | 1 | ea | $16.94 |  | $16.94 | Thomson |  |  |  | $16.94 |  | 3,050
10mm x 2mm Flange mount supernut | HD-NT0047 |  |  | MTS10 x 2m |  | Mechanical | 1 | ea | $4.81 |  | $4.81 | Thomson |  |  |  | $4.81 |  | 3,050
Bearing 627 Ball Bearings 627 RS – BLACK | HD-MS0277 |  |  |  |  | Mechanical | 2 | ea | $0.65 |  | $1.30 | Just Great Bearings | 627-2RS | 1.30 | $0.54 | $1.30 | 1.30 | 6,100 |  |  |  | SB Confirmed delivery middle October.
Mini X End Motor Assembly |  |  |  |  |  |  |  |  |  |  | $0.00
X end motor complete |  |  |  |  |  |  |  |  |  |  |  |  |  |  |  |  |  |  |  |  |  |  |  |  | 100.91 | 0 | 0 | black
X end motor v1.6, Mini | PP-GP0182 |  |  |  |  | Printed | 1 | ea | $3.82 |  | $3.82 | Aleph Objects |  |  |  |  |  | 3,050 |  |  |  |  |  |  | 100.91 | 100.91 | 307.7755 | black
Metric Brass Heat-Set Insert For Plastics Tapered, M5-.8 Internal Thread, 6.7mm Length | HD-MS0158 |  |  | 11125997 |  | Hardware | 3 | ea | $0.07 |  | $0.22 | Fastenal | 11125997 |  | $0.17 | $0.22 |  | 9,150 |  |  |  | Fastenal 10,000 Pcs 10/8 30,000 12/8 completes liability with fastenal moving to CEH for 2016 | Mcmaster | 94180A361 - As of 09/17/2014 they have a 2 week lead time on this part. I don't want to fill in because Fastenal Rep is hoping to get units from the Manufacturer sooner, just can't promise
Metric Brass Heat-Set Insert for Plastics Tapered, M3-.5 Internal Thread, 3.8mm Length | HD-MS0030 |  |  | 11125995 |  | Hardware | 6 | ea | $0.04 |  | $0.21 | Fastenal | 11125995 |  | $0.07 | $0.21 |  | 18,300 |  |  |  | Fastenal 1500 Pcs 10/8 34000 pcs 10/12 180,000 delivery 12/8/15 completes liability with fastenal moving to CEH for 2016 | 10/16/14 | 01/05/15 | PO04956 | 10/16/14 | 01/05/15 | PO04956 | 10/16/14 | 01/05/15
Metric Brass Heat-Set Insert for Plastics, Tapered, M2-.4 Internal Thread, 2.9MM Length | PP-MP0066 |  |  | 11126009 |  | Hardware | 4 | ea | $0.05 |  | $0.20 | Fastenal | 11126009 |  | $0.09 | $0.20 |  | 12,200 |  |  |  | 40,000 10/8 completes liability with fastenal moving to CEH for 2016 | Mcmaster | 94180A307
DryLin® R - Solid polymer bearing RJM-01, 8mm | HD-BU0013 | Y |  |  |  | Mechanical | 2 | ea | $1.15 | Y | $2.30 | IGUS | RJM-01-08 | Err:509 | $2.00 | $2.30 | Err:509 | 6,100
M3 x 6 Bolt, FHCS Black-Oxide | HD-BT0128 |  |  | 40921 |  | Hardware | 4 | ea | $0.04 |  | $0.15 | Fastenal | 40921 |  |  | $0.15 |  | 12,200 |  |  |  | Bin stock program Provided Fastenal totals for Foxglove demand and totals needed | Mcmaster | 91294A126
SWITCH BASIC SPDT 3A .110QC 125V | EL-SW0022 |  |  | SS-3GPT |  | Electronic | 2 | ea | $0.42 |  | $0.84 | TTI | SW766-ND |  | $0.52 | $0.84 |  | 6,100 |  |  |  | TTI 18-20 wk Ltime Interium stock ordered Cyclop Electronics – until Heilind stock available
Metric Class 12.9 Socket Head Cap Screw Alloy Steel, Black, M2 Thread, 10mm Length, 0.4mm Pitch | HD-BT0107 |  |  | 0134599 |  | Hardware | 4 | ea | $0.02 |  | $0.09 | Fastenal | 0134599 |  | $0.04 | $0.09 |  | 6,080 |  |  |  | 8000 pcs requested delivery 10/16 | Mcmaster | 91290A017
Steel Flat Washer, DIN 125 zinc-plated class 4,M2 screw sz, 5mm OD, .25mm-.35mm thick | HD-WA0012 |  |  | 40350 |  | Hardware | 4 | ea | $0.00 |  | $0.01 | Fastenal | 40350 |  | $0.00 | $0.01 |  | 12,200 |  |  |  | 12,000 pcs requested delivery 10/19 | Mcmaster | 91166A180
NEMA 17 Stepper Motor, Moons' - NOT INCLUDING wire harness - As per attached Drawing. | EL-MT0029 |  | Moons | MS17HD6P4150MS17HD6P4150-01-B | Moons | MS17HD6P4150-01-B | 1 | ea | $8.30 |  | $8.30 | 0 | PO11681 | 01/25/16 | 03/08/16 | The first 1500 units might have to ship via Air, remaining units will come FOB Chicago as needed to meet production. TS
M3 x 12 Bolt, SHCS Black-Oxide | HD-BT0039 |  |  | 39505 |  | Hardware | 4 | ea | $0.01 |  | $0.05 | Fastenal | 39505 |  | $0.01 | $0.05 |  | 12,200 |  |  |  | Bin stock program Provided Fastenal totals for Foxglove demand and totals needed | Mcmaster | 91290A117
Black-Oxide 18-8 Stainless Steel Flat Washer, M3 Screw Size, 3.2mm ID, 7.0mm OD | HD-WA0038 |  |  |  |  |  | 4 | ea | $0.02 |  | $0.08 | Fastenal |  |  | $0.00 | $0.08 |  | 12,200
GT2 Timing Pulley, 5mm Bore Aluminum | HD-MS0033 |  |  | B & B Manufacturing, Inc | 16-2P06M6CA5 5MM BORE ALUMINUM | Hardware | 1 | ea | $2.90 |  | $2.90 | 2.90 | #VALUE! | #VALUE! | #VALUE!
M5 x 10 Bolt, SHCS Black-Oxide | HD-BT0048 |  |  | 39544 |  | Hardware | 3 | ea | $0.02 |  | $0.06 | Fastenal | 39544 |  | $0.02 | $0.06 |  | 9,150 |  |  |  | Bin stock program Provided Fastenal totals for Foxglove demand and totals needed | Mcmaster | 91290A224
Black-Oxide 18-8 Stainless Steel Flat Washer, M5 Screw Size, 5.3mm ID, 10.0mm OD | HD-WA0040 |  |  |  |  |  | 3 |  | $0.03 |  | $0.09 | Fastenal |  |  |  | $0.09 |  | 9,150 |  |  |  | Bin stock program Provided Fastenal totals for Foxglove demand and totals needed | Mcmaster | 91166A240
Z upper left v1.2, Mini, complete
Z upper left v1.2, Mini | PP-GP0179 |  |  |  |  | Printed | 1 | ea | $1.10 |  | $1.10 | Aleph Objects |  |  |  |  |  | 3,050 |  |  |  |  |  |  | 32.25 | 32.25 | 98.3625 | black
Metric Brass Heat-Set Insert for Plastics Tapered, M3-.5 Internal Thread, 3.8mm Length | HD-MS0030 |  |  | 11125995 |  | Hardware | 6 | ea | $0.04 |  | $0.21 | Fastenal | 11125995 |  | $0.07 | $0.21 |  | 18,300 |  |  |  | Fastenal 1500 Pcs 10/8 34000 pcs 10/12 180,000 delivery 12/8/15 completes liability with fastenal moving to CEH for 2016 | 10/16/14 | 01/05/15 | PO04956 | 10/16/14 | 01/05/15 | PO04956 | 10/16/14 | 01/05/15
8mm Smooth rod, 315mm, 304 Stainless Steel | HD-RD0035 |  |  |  |  | Mechanical | 1 | ea | $3.65 |  | $3.65 | Igus |  |  |  | $3.65 |  | 3,050
M3 Set Screw (Grub Screw) | HD-BT0012 |  |  | 40818 |  | Hardware | 3 | ea | $0.03 |  | $0.08 | Fastenal | 40818 |  | $0.02 | $0.08 |  | 9,150 |  |  |  | Bin stock program Provided Fastenal totals for Foxglove demand and totals needed | Mcmaster | 91390A100
X Extruder Harness (Igus Assembly) | EL-HR0108 |  | Igus |  |  |  | 1 | ea | $68.62 |  | $68.62 | Igus
Ferrite Tubular Bead 10.16MM | EL-MS0343 |  | Laird-Signal Integrity Products | 28B0735-000 |  | Electronic | 1 | ea | $0.00 |  | $0.00
Heat Shrink DL WL Q53X ¾" | EL-MS0259 |  | Qualtek | Q5-3X-3/4-01-QB48IN-4 |  | Electronic | 50 | mm | $0.00 |  | $0.00
CONN TERM FEMALE 22-24AWG TIN | EL-MS0059 |  | Molex | 16-02-0086 / 16-02-0102 |  | Electronic | 32 | ea | $0.01 |  | $0.00 | TTI | WM2510TR-ND |  | $0.05 | $0.47 |  | 97,600
CONN HOUSING 2POS .100 W/LATCH | PC-CN0001 |  | Molex | 050579402 |  | Electronic | 3 | ea | $0.05 |  | $0.00 | SAGER | WM2900-ND |  | $0.13 | $0.16 |  | 9,150
Connector Housing 3POS .100 W/Latch | PC-CN0003 |  | Molex | 50579403 |  | Electronic | 3 | ea | $0.05 |  | $0.00 | SAGER | WM2901-ND |  | $0.18 | $0.15 |  | 9,150
Connector, 4 pin Female housing with latch | EL-MS0062 |  | Molex | 050579404 |  | Electronic | 2 | ea | $0.05 |  | $0.00 | SAGER | WM2902-ND |  | $0.12 | $0.10 |  | 6,100
20-POS .100 Dual (Black) | EL-MS0074 |  | Molex | 22-55-2201 |  | Electronic | 1 | ea | $0.51 |  | $0.00 | SAGER | WM2527-ND |  |  | $1.02 |  | 6,100
24 AWG 6.0mm Pin Length Single Wire - Insulated Ferrule | EL-MS0362 |  | Panduit | FSD73-6-D |  | Electronic | 2 | ea | $0.00 |  | $0.00
Term Block Plug 2POS STR 5.08MM | PC-CN0032 |  | Molex | 395300002 |  | Electronic | 1 | ea | $0.46 |  | $0.00 | TTI | WM7819-ND |  | $0.56 | $0.46 |  | 3,050 |  |  |  | TTI confirmed, Juniperbush build may need to use some of this stock- SAGER 600 pcs 9/4 12 wks balance aprox 11/10 delivery- There is stock on hand from 10/16 delivery for Foxglove
Term Ring Non Ins 26-22AWG #4 Order Bulk Only | EL-MS0141 |  | Panduit | P22-4R-M |  | Electronic | 2 | ea | $0.07 |  | $0.00 | TTI | P22-4R-M |  |  | $0.14 |  | 6,100 |  |  |  |  | `
CONN RECEPT FASTON 22-26AWG .110 | EL-MS0142 |  | TE Connectivity / AMP | 7-520365-2 |  | Electronic | 4 | ea | $0.08 |  | $0.00 | TTI | A27793-ND |  | $0.22 | $0.30 |  | 12,200
Heat-Shrink Tubing 1/8" ID Before, 1/16" ID After, 100' L, Black | HD-TB0032 |  | EDC | 84-01250 |  | Electronic | 100 | mm | $0.00 |  | $0.00 | McMaster-Carr | 7856K33
Motor JST 6-pin Housing | EL-MS0355 |  | JST | PHR-6 |  | Electronic | 1 | ea | $0.00 |  | $0.00
Female JST pin | EL-MS0351 |  | JST | SPH-002T-P0.5S |  | Electronic | 4 | ea | $0.00 |  | $0.00
Heat Shrink Tubing – 0.19-0.09 – Black, 100' | EL-MS0247 |  | Electronics Distributors Corp. | 88-01870 |  | Electronic | 280 | mm | $0.00 |  | $0.00
Polyester wire labels for thermal transfer printers | OF-MS0461 |  | BradyBondz | THT-3-423-10 |  | Electronic | 9 | ea | $0.00 |  | $0.00
Igus 6-wire Chainflex Cable | EL-WR0138 |  | Igus | CF9-02-06 |  | Electronic | 3270 | mm | $0.00 |  | $0.00 |  |  |  |  |  |  |  |  |  |  | Length increased on rev F
Igus 4-wire Shielded Chainflex Cable | EL-WR0140 |  | Igus | CF11-02-02-02 |  | Electronic | 1870 | mm | $0.00 |  | $0.00
Igus 06 Series Energy Chain 20mm Inner Width, 28mm Bend Radius | EL-MS0379 |  | Igus | 06-20-028-0 |  | Electronic | 18 | ea | $0.00 |  | $0.00 | IGUS | 06-10-028-0 |  |  | 0 |  | 8100 feet
Igus 06 Series Energy Chain 30mm Inner Width, 28mm Bend Radius | EL-MS0380 |  | Igus | 06-30-028-0 |  | Electronic | 11 | ea | $0.00 |  | $0.00
Igus 06 Series Mounting Bracket Set 20mm Inner Width (male and female) | EL-MS0382 |  | Igus | E2-100-20-12 |  | Electronic | 1 | ea | $1.80 |  | $0.00 |  |  |  |  | 9,150 |  |  |  | Female and Males are sold as a set under a single MFR Part Number. Please see part number description in ERP for details and make sure we don't double order.
Igus 06 Series Mounting Bracket Set 30mm Inner Width (male and female) | EL-MS0383 |  | Igus | E2-100-30-12 |  | Electronic | 1 | ea | $5.10 |  | $0.00 |  |  |  |  | 0
Wire Tie, 8" | HD-MS0058 |  |  |  |  |  | 3 |  | $0.02 |  | $0.06
m3 X 6 flat head(attaching motor and idler assemblies to chassis) |  |  |  |  |  |  | 20
Mini Print Head Assembly |  |  |  |  |  |  |  |  |  |  | $0.00
Upper bearing holder
Upper bearing holder v1.1, Mini | PP-GP0188 |  |  |  |  | Printed | 1 | ea | $1.46 |  | $1.46 | Aleph Objects |  |  |  |  |  | 3,050 |  |  |  |  |  |  | 30.69 | 30.69 | 93.6045 | black | Black
Metric Brass Heat-Set Insert for Plastics Tapered, M3-.5 Internal Thread, 3.8mm Length | HD-MS0030 |  |  | 11125995 |  | Hardware | 8 | ea | $0.04 |  | $0.28 | Fastenal | 11125995 |  | $0.07 | $0.28 |  | 24,400 |  |  |  | Fastenal 1500 Pcs 10/8 34000 pcs 10/12 180,000 delivery 12/8/15 completes liability with fastenal moving to CEH for 2016 | 10/16/14 | 01/05/15 | PO04956 | 10/16/14 | 01/05/15 | PO04956 | 10/16/14 | 01/05/15
DryLin® R - Solid polymer bearing RJM-01, 8mm | HD-BU0013 |  |  |  |  | Mechanical | 4 | ea | $1.15 |  | $4.60 | IGUS | RJM-01-08 | Err:509 | $2.00 | $4.60 | Err:509 | 12,200
M3 x 12 Bolt, SHCS Black-Oxide | HD-BT0039 |  |  | 39505 |  | Hardware | 9 | ea | $0.01 |  | $0.11 | Fastenal | 39505 |  | $0.01 | $0.11 |  | 27,450 |  |  |  | Bin stock program Provided Fastenal totals for Foxglove demand and totals needed | Mcmaster | 91290A117
Black-Oxide 18-8 Stainless Steel Flat Washer, M3 Screw Size, 3.2mm ID, 7.0mm OD | HD-WA0038 |  |  |  |  |  | 9 | ea | $0.02 |  | $0.18 | Fastenal |  |  | $0.00 | $0.18 |  | 27,450
8mm Smooth rod, 315mm, 304 Stainless Steel | HD-RD0035 |  |  |  |  | Mechanical | 2 | ea | $3.65 |  | $7.30 | Igus |  |  |  | $7.30 |  | 6,100
X carriage v1.0, Mini | PP-GP0183 |  |  |  |  | Printed | 1 | ea | $2.08 |  | $2.08 | Aleph Objects |  |  |  |  |  | 3,050 |  |  |  |  |  |  | 52.36 | 52.36 | 159.698 | black
Belt Mount Complete
Belt mount v1.0, Mini | PP-GP0181 |  |  |  |  | Printed | 1 | ea | $1.50 |  | $1.50 | Aleph Objects |  |  |  |  |  | 3,050 |  |  |  |  |  |  | 12.43 | 12.43 | 37.9115 | black
Metric Brass Heat-Set Insert for Plastics Tapered, M3-.5 Internal Thread, 3.8mm Length | HD-MS0030 |  |  | 11125995 |  | Hardware | 5 | ea | $0.04 |  | $0.18 | Fastenal | 11125995 |  | $0.07 | $0.18 |  | 15,250 |  |  |  | Fastenal 1500 Pcs 10/8 34000 pcs 10/12 180,000 delivery 12/8/15 completes liability with fastenal moving to CEH for 2016 | 10/16/14 | 01/05/15 | PO04956 | 10/16/14 | 01/05/15 | PO04956 | 10/16/14 | 01/05/15
Bottom Clamp | PN – printed part |  |  |  |  |  | 1
GT2, Single sided Neoprene Belt |  |  |  |  |  | Mechanical | 1 | ea | $1.93 |  | $1.93 | B & B Manufacturing, Inc | 744-2P-06 (2MR-744-06) |  | $2.29 | $1.93 |  | 3,050
Extruder Assembly |  |  |  |  |  |  |  |  |  |  | $0.00
Beefy Extruder Idler, v0.3 | PP-GP0241 |  |  |  |  | Printed | 1 | ea | $0.41 |  | $0.41 | Aleph Objects |  |  |  |  |  | 3,050 |  |  |  |  |  |  | 9.23 | 9.23 | 28.1515 | black
608-2RS ABEC3/C3 Rubber Sealed Bearing – BLACK | HD-MS0282 | Y |  |  |  | Mechanical | 1 | ea | $0.42 | Y | $0.42 | Just Great Bearings | 608-2RS ABEC3/C3 | 0.42 | $0.54 | $0.42 | 0.42 | 3,050 |  |  |  | SB Confirmed delivery middle October.
8mm Smooth Rod x 18-19mm (Nubbin) | HD-RD0004 | Y |  |  |  | Mechanical | 1 | ea | $1.50 | Y | $1.50 | Igus |  |  | $4.50 | $1.50 |  | 3,050
Wade extruder body for Hex nozzle v1.4.1 | PP-GP0186 |  |  |  |  | Printed | 1 | ea | $1.50 |  | $1.50 | Aleph Objects |  |  |  |  |  | 3,050 |  |  |  |  |  |  | 40.5 | 40.5 | 123.525 | black | 01/05/15
Wade Reloaded Bearing Washer | PPGP0060 |  |  |  |  |  | 1 |  |  |  | $0.00
Herringbone Large Gear v1.3, Lulzbot green | PP-GP0191 |  |  |  |  | Printed | 1 | ea | $1.15 |  | $1.15 | Aleph Objects |  |  |  |  |  | 3,050 |  |  |  |  |  |  | 23 | 23 | 70.15 | green | Green
608-2RS ABEC3/C3 Rubber Sealed Bearing – BLACK | HD-MS0282 | Y |  |  |  | Mechanical | 2 | ea | $0.42 | Y | $0.84 | Just Great Bearings | 608-2RS ABEC3/C3 | 0.84 | $0.54 | $0.84 | 0.84 | 6,100 |  |  |  | SB Confirmed delivery middle October.
M3 Nut, Zinc Plated | HD-NT0004 |  |  | 40302 |  | Hardware | 2 | ea | $0.01 |  | $0.01 | Fastenal | 40302 |  | $0.01 | $0.01 |  | 6,100 |  |  |  | Bin stock program Provided Fastenal totals for Foxglove demand and totals needed | Mcmaster | 90591A121
M3 x 25 Bolt, SHCS Black-Oxide | HD-BT0041 |  |  | 39508 |  | Hardware | 1 | ea | $0.03 |  | $0.03 | Fastenal | 39508 |  | $0.03 | $0.03 |  | 3,050 |  |  |  | Bin stock program Provided Fastenal totals for Foxglove demand and totals needed | Mcmaster | 91290A125
M3 Washer, Black Oxide | HD-WA0038 |  |  | 40352 |  | Hardware | 4 | ea | $0.00 |  | $0.01 | Fastenal | 40352 |  | $0.00 | $0.01 |  | 12,200 |  |  |  | Bin stock program Provided Fastenal totals for Foxglove demand and totals needed | Mcmaster | 91166A210
Hobbed Bolt, M8 x 50mm Hex head, 26mm offset, Stainless Steel | HD-BT0108 |  |  |  |  | Hardware | 1 | ea | $4.84 |  | $4.84 | Quattro |  |  |  | $4.84 |  | 3,050
M8 Washer, Steel, Zinc Plated | HD-WA0006 |  |  | 1140357 |  | Hardware | 3 | ea | $0.01 |  | $0.03 | Fastenal | A1062TR-ND |  | $0.01 | $0.03 |  | 9,150 |  |  |  | Bin stock program Provided Fastenal totals for Foxglove demand and totals needed | Mcmaster | 91166A270
M8 Nyloc Nut, Zinc Plated | HD-NT0002 |  |  | 40163 |  | Hardware | 1 | ea | $0.03 |  | $0.03 | Fastenal | 40163 |  | $0.05 | $0.03 |  | 3,050 |  |  |  | Bin stock program Provided Fastenal totals for Foxglove demand and totals needed | Mcmaster | 90576A117
Metric Spring Steel Shim - DIN 988 0.5mm Thick, 8mm ID, 14mm OD | HD-WA0008 |  |  | 11511045 |  | Hardware | 1 | ea | $0.05 |  | $0.05 | Fastenal | 11511045 |  | $0.05 | $0.05 |  | 3,000 |  |  |  | Bin stock program Provided Fastenal totals for Foxglove demand and totals needed | Mcmaster | 98055A114
Metric Spring Steel Shim - DIN 988 1.0mm Thick, 8mm ID, 14mm OD | HD-WA0009 |  |  | 11511046 |  | Hardware | 1 | ea | $0.05 |  | $0.05 | Fastenal | 1151146 |  | $0.06 | $0.05 |  | 3,050 |  |  |  | Bin stock program Provided Fastenal totals for Foxglove demand and totals needed | Mcmaster | 98055A115
Herringbone Small Gear v1.1, Lulzbot green | PP-GP0192 |  |  |  |  | Printed | 1 | ea | $0.26 |  | $0.26 | Aleph Objects |  |  |  |  |  | 3,050 |  |  |  |  |  |  | 3.91 | 3.91 | 11.9255 | green | Err:509
M3 Set Screw (Grub Screw) | HD-BT0012 |  |  | 40818 |  | Hardware | 1 | ea | $0.03 |  | $0.03 | Fastenal | 40818 |  | $0.02 | $0.03 |  | 3,050 |  |  |  | Bin stock program Provided Fastenal totals for Foxglove demand and totals needed | Mcmaster | 91390A100
NEMA 17 Stepper Motor, Moons' - NOT INCLUDING wire harness - As per attached Drawing. | EL-MT0029 |  | Moons | MS17HD6P4150MS17HD6P4150-01-B | Moons | MS17HD6P4150-01-B | 1 | ea | $8.30 |  | $8.30 | 0 | PO11681 | 01/25/16 | 03/08/16 | The first 1500 units might have to ship via Air, remaining units will come FOB Chicago as needed to meet production. TS
M4 Nut,Zinc-Plated Steel | HD-NT0011 |  |  | 40143 |  | Hardware | 4 | ea | $0.01 |  | $0.02 | Fastenal | 40143 |  | $0.00 | $0.02 |  | 12,200 |  |  |  | Bin stock program Provided Fastenal totals for Foxglove demand and totals needed | Mcmaster | 90591A141
M3 x 12 Bolt, SHCS Black-Oxide | HD-BT0039 |  |  | 39505 |  | Hardware | 3 | ea | $0.01 |  | $0.04 | Fastenal | 39505 |  | $0.01 | $0.04 |  | 9,150 |  |  |  | Bin stock program Provided Fastenal totals for Foxglove demand and totals needed | Mcmaster | 91290A117
M4 Washer, Black Oxide | HD-WA0039 |  |  | 40353 |  | Hardware | 4 | ea | $0.00 |  | $0.01 | Fastenal | 40353 |  | $0.00 | $0.01 |  | 12,200 |  |  |  | Bin stock program Provided Fastenal totals for Foxglove demand and totals needed | Mcmaster | 91166A230
M4 x 55 Bolt, SHCS Black-Oxide | HD-BT0052 |  |  | ZT2530055PF0000 |  | Hardware | 2 | ea | $0.08 |  | $0.16 | Fastenal | ZT2530055PF0000 |  | $0.08 | $0.16 |  | 6,100 |  |  |  | Bin stock program Provided Fastenal totals for Foxglove demand and totals needed | Mcmaster | 91290A187
Beefy Idler Latch_v2.2 | PP-GP0245 |  |  |  |  | Printed | 1 | ea | $0.12 |  | $0.12 | Aleph Objects |  |  |  |  |  | 3,050 |  |  |  |  |  |  | 2.75 | 2.75 | 8.3875 | black
Thumb Screw Knob for M4 SHCS, Black | HD-MS0031 |  |  | 11102951 |  | Hardware | 2 | ea | $0.08 |  | $0.17 | Fastenal | 11102951 |  | $0.10 | $0.17 |  | 6,100 |  |  |  | Bin stock program Provided Fastenal totals for Foxglove demand and totals needed | Mcmaster | 91175A062
Spring, Extruder, 6mm OD, 0.8mm WD, 9.7mm FL | HD-MS0027 |  |  |  |  | Hardware | 2 | ea | $0.16 |  | $0.32 | Associated Spring | C0240-032-0380-M | 0.32 | $0.17 | $0.32 | 0.32 | 6,100
Extruder Mount Complete
Extruder mount v3.0, Mini | PP-GP0251 |  |  |  |  | Printed | 1 | ea | $1.31 |  | $1.31 | Aleph Objects |  |  |  |  |  | 3,050 |  |  |  |  |  |  | 31.55 | 31.55 | 96.2275 | black
Metric Brass Heat-Set Insert For Plastics Tapered, M5-.8 Internal Thread, 6.7mm Length | HD-MS0158 |  |  | 11125997 |  | Hardware | 3 | ea | $0.07 |  | $0.22 | Fastenal | 11125997 |  | $0.17 | $0.22 |  | 9,150 |  |  |  | Fastenal 10,000 Pcs 10/8 30,000 12/8 completes liability with fastenal moving to CEH for 2016 | Mcmaster | 94180A361 - As of 09/17/2014 they have a 2 week lead time on this part. I don't want to fill in because Fastenal Rep is hoping to get units from the Manufacturer sooner, just can't promise
Metric Brass Heat-Set Insert for Plastics Tapered, M3-.5 Internal Thread, 3.8mm Length | HD-MS0030 |  |  | 11125995 |  | Hardware | 3 | ea | $0.04 |  | $0.11 | Fastenal | 11125995 |  | $0.07 | $0.11 |  | 9,150 |  |  |  | Fastenal 1500 Pcs 10/8 34000 pcs 10/12 180,000 delivery 12/8/15 completes liability with fastenal moving to CEH for 2016 | 10/16/14 | 01/05/15 | PO04956 | 10/16/14 | 01/05/15 | PO04956 | 10/16/14 | 01/05/15
Reprap Modified Hexagon Hotend, Lulzbot Edition, 3.0mm Filament, 1.5 mm nozzle | HE-SH0031 |  |  |  |  | Hardware | 1 | ea | $23.00 |  | $23.00 | Reprapdiscount |  |  |  | $23.00 |  | 3,050
M4 Washer, Blk Oxide | HD-WA0039 |  |  | 40353 |  | Hardware | 2 | ea | $0.00 |  | $0.01 | Fastenal | 40353 |  | $0.00 | $0.01 |  | 6,100 |  |  |  | Bin stock program Provided Fastenal totals for Foxglove demand and totals needed | Mcmaster | 91166A230
M4 x 25 Bolt, SHCS Black-Oxide | HD-MS0229 |  |  | 11103314 |  | Hardware | 2 | ea | $0.32 |  | $0.63 | Fastenal | 11103314 |  |  | $0.63 |  | 6,100 |  |  |  | Bin stock program Provided Fastenal totals for Foxglove demand and totals needed | Mcmaster | 91290A176
Heatsink fan duct, TAZ6, v1.0 | PP-GP0232 |  |  |  |  | Printed | 1 | ea | $0.65 |  | $0.65
Metric Brass Heat-Set Insert for Plastics Tapered, M3-.5 Internal Thread, 3.8mm Length | HD-MS0030 |  |  | 11125995 |  | Hardware | 4 | ea | $0.04 |  | $0.14 | Fastenal | 11125995 |  | $0.07 | $0.14 |  | 12,200 |  |  |  | Fastenal 1500 Pcs 10/8 34000 pcs 10/12 180,000 delivery 12/8/15 completes liability with fastenal moving to CEH for 2016 | 10/16/14 | 01/05/15 | PO04956 | 10/16/14 | 01/05/15 | PO04956 | 10/16/14 | 01/05/15
Pelonis Fan 5V 40mm x 40mmx 10mm, low flow | EL-FA0034 |  |  |  |  |  | 1 | ea |  |  | $0.00
Fan Mount Complete |  |  |  |  |  |  |  |  |  |  | $0.00
Extruder Fan Mount v2.0, Mini | PP-GP0252 |  |  |  |  | Printed | 1 | ea | $0.53 |  | $0.53 | Aleph Objects |  |  |  |  |  | 3,050 |  |  |  |  |  |  | 10.6 | 10.6 | 32.33 | black
Metric Brass Heat-Set Insert for Plastics Tapered, M3-.5 Internal Thread, 3.8mm Length | HD-MS0030 |  |  | 11125995 |  | Hardware | 2 | ea | $0.04 |  | $0.07 | Fastenal | 11125995 |  | $0.07 | $0.07 |  | 6,100 |  |  |  | Fastenal 1500 Pcs 10/8 34000 pcs 10/12 180,000 delivery 12/8/15 completes liability with fastenal moving to CEH for 2016 | 10/16/14 | 01/05/15 | PO04956 | 10/16/14 | 01/05/15 | PO04956 | 10/16/14 | 01/05/15
Metric Brass Heat-Set Insert for Plastics, Tapered, M2-.4 Internal Thread, 2.9MM Length | PP-MP0066 |  |  | 11126009 |  | Hardware | 2 | ea | $0.05 |  | $0.10 | Fastenal | 11126009 |  | $0.09 | $0.10 |  | 6,100 |  |  |  | 40,000 10/8 completes liability with fastenal moving to CEH for 2016 | Mcmaster | 94180A307
SWITCH BASIC SPDT 3A .110QC 125V | EL-SW0022 | Y |  | SS-3GPT |  | Electronic | 1 | ea | $0.42 |  | $0.42 | TTI | SW766-ND |  | $0.52 | $0.42 |  | 3,050 |  |  |  | TTI 18-20 wk Ltime Interium stock ordered Cyclop Electronics – until Heilind stock available
Metric Class 12.9 Socket Head Cap Screw Alloy Steel, Black, M2 Thread, 10mm Length, 0.4mm Pitch | HD-BT0107 |  |  | 0134599 |  | Hardware | 2 | ea | $0.02 |  | $0.04 | Fastenal | 0134599 |  | $0.04 | $0.04 |  | 3,040 |  |  |  | 8000 pcs requested delivery 10/16 | Mcmaster | 91290A017
Steel Flat Washer, DIN 125 zinc-plated class 4,M2 screw sz, 5mm OD, .25mm-.35mm thick | HD-WA0012 |  |  | 40350 |  | Hardware | 2 | ea | $0.00 |  | $0.00 | Fastenal | 40350 |  | $0.00 | $0.00 |  | 6,100 |  |  |  | 12,000 pcs requested delivery 10/19 | Mcmaster | 91166A180
M3 x 14 Bolt FHCS, Black-Oxide | HD-BT0118 |  |  | 40925 |  | Hardware | 2 | ea | $0.02 |  | $0.04 | Fastenal | 40925 |  |  | $0.04 |  | 6,100 |  |  |  | 2000 requested delivery 10/19 | Mcmaster | 91294A133
Pelonis Fan 24V 40mm x 40mmx 10mm, low flow | EL-FA0032 |  |  |  |  |  | 1 |  | $2.00 |  | $2.00
M3 x 12 Bolt, SHCS Black-Oxide | HD-BT0039 |  |  | 39505 |  | Hardware | 6 | ea | $0.01 |  | $0.07 | Fastenal | 39505 |  | $0.01 | $0.07 |  | 18,300 |  |  |  | Bin stock program Provided Fastenal totals for Foxglove demand and totals needed | Mcmaster | 91290A117
M3 x 25 Bolt, SCHS blk-oxide | HD-BT0041 |  |  |  |  |  | 1 | ea |  |  | $0.00
M3 Washer, Black oxide | HD-WA0038 |  |  |  |  |  | 1 | ea |  |  | $0.00
X max switch wiring | need assy # |  |  |  |  |  |  |  |  |  | $0.00
CONN TERM MALE 22-24AWG TIN | EL-MS0205 |  | Molex | 16-02-0107 |  | Electronic | 15 | ea | $0.02 |  | $0.28 | TTI | WM2517TR-ND |  | $0.04 | $0.28 |  | 45,750
CONN RECEPT FASTON 22-26AWG .110 | EL-MS0142 |  |  | 7-520365-2 |  | Electronic | 2 | ea | $0.08 |  | $0.15 | TTI | A27793-ND |  | $0.22 | $0.15 |  | 6,100
24AWG Stranded – Black | EL-WR0105 |  |  | HU1569247BK |  | Electronic | 160 | mm | $0.00 |  | $0.01 | Allcable | HU1569247BK |  |  | $0.01 |  | 1,601
24AWG Stranded – Purple | EL-WR0120 |  |  | HU1569247VT |  | Electronic | 160 | mm | $0.00 |  | $0.01 | Allcable | HU1569247VT |  |  | $0.01 |  | 1,601
20-POS .100 Dual (Black) | EL-MS0074 |  |  | 22-55-2201 |  | Electronic | 1 | ea | $0.51 |  | $0.51 | SAGER | WM2527-ND |  |  | $81.62 |  | 3,050
x carriage cover |  |  |  |  |  |  | 1 |  |  |  | $0.00
M3 shcs |  |  |  |  |  |  | 12
M3 Washer, Black oxide | HD-WA0038 |  |  |  |  |  | 2
M5 x 14 Bolt, SHCS Black_Oxide | HD-BT0049 |  |  | 1139539 |  | Hardware | 3 | ea | $0.02 |  | $0.07 | Fastenal | 1139539 |  | $0.03 | $0.07 |  | 9,150 |  |  |  | Bin stock program Provided Fastenal totals for Foxglove demand and totals needed
Black-Oxide 18-8 Stainless Steel Flat Washer, M5 Screw Size, 5.3mm ID, 10.0mm OD | HD-WA0040 |  |  |  |  |  | 3 |  | $0.03 |  | $0.09 | Fastenal |  |  |  | $0.09 |  | 9,150 |  |  |  | Bin stock program Provided Fastenal totals for Foxglove demand and totals needed | Mcmaster | 91166A240
Mini Electrical Cover Assembly |  |  |  |  |  |  |  |  |  |  | $0.00
Laser Etching Services for the Mini Electronics Cover |  |  |  |  |  | Etching | 1 | ea | $9.91 |  | $9.91 | Laser Engraving Designs, LLC |  |  |  | $9.91 |  | 3,050
Electronics cover | PP-FP0082_rA |  |  |  |  | Mechanical | 1 | ea | $20.00 |  | $20.00 | Rapid Sheet Metal |  |  |  | $20.00 |  | 3,050
SWITCH ROCKER DPST 20A 250V, illuminated red | EL-SW0023 |  | E-Switch | R5BBLKREDFF2 |  | Electronic | 1 | ea | $1.25 |  | $1.25 | Future |  |  |  | $1.25 |  | 3,050 | PO11896 |  |  | 12-14 wk lead time 2/5/16 Advised Julie this PO must be placed ASAP since current lead times put us with a 5/20 delivery date. TS - Per Jeff, Glad is not slated to start until July so we are holding off on this. TS
UV-Resistant Cable Tie Holder, Adhesive Back/Screw Mount, 4-Way, for.18" Maximum Tie, Black | HD-MS0249 |  |  |  |  | Hardware | 2 | ea | $0.24 |  | $0.48 | EDC (Electronics Distributors Corp. | 7582k22 |  |  | $0.48 |  | 6,100
AC Power Entry Modules SC MT FUSED .25" TAB | PP-MP0028 |  | Bulgin | PF0030/63 |  | Electronic | 1 | ea | $2.69 |  | $2.69 | Heilind | 161-PF0030/63 |  | $3.16 | $2.69 |  | 3,050 |  |  |  | Toni working w/heilindLT 12-14 wks Heilind, expediting. Digikey has some stock, high cost Mouser has some stock also
Cartridge Fuses(We need to change this to a ceramic one like EL-MS0347 but likely rated to a lower current. UPDATE – Erick spec'd one, we still need part number and to test it.) | EL-MS0414 |  |  | F4710-ND |  | Electronic | 2 | ea | $0.38 |  | $0.76 | Mouser | 576-0233007.MXP |  | $0.45 | $0.76 |  | 6,100
Ferrite Tubular Bead 19.00mm | EL-MS0216 |  |  |  |  |  | 1 | ea
Mini PS to Ground Post Extension | EL-HR0069 |  |  |  |  |  |  |  |  |  | $0.00
REEL – RING TONGUE CONN 16-22 AWG #10 PIDG | EL-MS0211 |  | TE | 2-36154-2 |  | Electronic | 1 | ea | $0.09 |  | $0.09 | SAGER | A1062TR-ND | Err:509 | $0.111 | $0.09 | Err:509 | 3,050
Conn Ring 16-22 AWG #4 Red PIDG | EL-MS0246 |  |  | 2-323758-1 |  | Electronic | 1 | ea | $0.41 |  | $0.41 | TTI | A27229TR-ND |  |  | $0.41 |  | 6,000 |  |  |  | TTI 10k min reels 5000 Confirmed 10/16 delivery 11-14 wks leadtime requested quote heilind 10 wks 5k min 0.414ea some stock at digikey
16AWG Stranded – Green w/ yellow stripe | EL-WR0124 |  |  | HU15691626GN |  | Electronic | 50 | mm | $0.00 |  | $0.16 | Allcable | HU15691626GN |  |  | $0.16 |  | 500
Mini Plug to Ground Post Extension | EL-HR0068 |  |  |  |  |  |  |  |  |  | $0.00
Conn Ring 16-22 AWG #4 Red PIDG | EL-MS0246 |  |  | 2-323758-1 |  | Electronic | 1 | ea | $0.41 |  | $0.41 | TTI | A27229TR-ND |  |  | $0.41 |  | 6,000 |  |  |  | TTI 10k min reels 5000 Confirmed 10/16 delivery 11-14 wks leadtime requested quote heilind 10 wks 5k min 0.414ea some stock at digikey
16AWG Stranded – Green w/ yellow stripe | EL-WR0124 |  |  | HU15691626GN |  | Electronic | 80 | mm | $0.00 |  | $0.26 | Allcable | HU15691626GN |  |  | $0.26 |  | 801
Conn Fast Receptacle14-16 AWG .250 | EL-MS0143 |  |  | 3-350819-2 |  | Electronic | 1 | ea | $0.07 |  | $0.07 | TTI | 22-26AWG .110 |  | $0.13 | $0.07 |  | 22,000
Metric 18-8 Stainless Steel External Serrated Lock Washer, M3 Screw Size, 6mm OD, 0.4mm min Thick | HD-WA0035 |  |  | 11511313 |  | Hardware | 1 | ea | $0.02 |  | $0.02 | Fastenal | 91120A120 |  |  | $0.02 |  | 3,050 |  |  |  | Bin stock program Provided Fastenal totals for Foxglove demand and totals needed
POWER SUP 150W 24V 6.25A PNL MT | EL-PS0025 |  | Delta | PMC-24V150W1AA |  | Electronic | 1 | ea | $23.00 |  | $23.00 | DELTA | PMC-24V150W1AA | 23.00 | $37.91 | $23.00 | 23.00 | 3,050
Mini PS to Rambo Harness | EL-HR0107 |  |  |  |  |  |  |  |  |  | $0.00
Term Block Plug 4POS STR 5.08MM | PC-CN0046 |  |  | 0395300004 |  | Electronic | 1 | ea | $0.76 |  | $0.76 | TTI | WM7953-ND |  | $1.22 | $0.76 |  | 3,050 |  |  |  | TTI 16 wk leadtimeconfirmed delivery 10/16
Ferrule for 16 AWG wire | EL-MS0361 |  |  |  |  |  | 4 |  |  |  | $0.00
16AWG Stranded – Red | EL-WR0106 |  |  | C2065A.21.03 |  | Electronic | 400 | mm | $0.00 |  | $1.15 | Allcable | C2065R-1000-ND |  |  | $1.15 |  | 4,003
16AWG Stranded – Black | EL-WR0121 |  |  | HU15691626BK |  | Electronic | 400 | mm | $0.00 |  | $1.15 | Allcable | HU15691626BK |  |  | $1.15 |  | 4,003
REEL – RING TONGUE CONN 16-22 AWG #10 PIDG | EL-MS0211 |  | TE | 2-36154-2 |  | Electronic | 4 | ea | $0.09 |  | $0.34 | SAGER | A1062TR-ND | Err:509 | $0.111 | $0.34 | Err:509 | 12,200
Switch to PS Extension | EL-HR0107 |  |  |  |  |  | 1 |  |  |  | $0.00
16AWG Stranded – Black | EL-WR0121 |  |  | HU15691626BK |  | Electronic | 260 | mm | $0.00 |  | $0.75 | Allcable | HU15691626BK |  |  | $0.75 |  | 2,602
16AWG Stranded – White | EL-WR0123 |  |  | HU15691626WE |  |  | 260 | mm | $0.00 |  | $0.75 | Allcable
Conn Fast Receptacle14-16 AWG .250 | EL-MS0143 |  |  | 3-350819-2 |  | Electronic | 2 | ea | $0.07 |  | $0.14 | TTI | 22-26AWG .110 |  | $0.13 | $0.14 |  | 22,000
REEL – RING TONGUE CONN 16-22 AWG #10 PIDG | EL-MS0211 |  | TE | 2-36154-2 |  | Electronic | 2 | ea | $0.09 |  | $0.17 | SAGER | A1062TR-ND | Err:509 | $0.111 | $0.17 | Err:509 | 6,100
Plug to Sw Extension | EL-HR0104 |  |  |  |  |  | 1 |  |  |  | $0.00
16AWG Stranded – Black | EL-WR0121 |  |  | HU15691626BK |  | Electronic | 560 | mm | $0.00 |  | $1.62 | Allcable | HU15691626BK |  |  | $1.62 |  | 5,604
16AWG Stranded – White | EL-WR0123 |  |  | HU15691626WE |  |  | 560 | mm | $0.00 |  | $1.62 | Allcable
Conn Fast Receptacle14-16 AWG .250 | EL-MS0143 |  |  | 3-350819-2 |  | Electronic | 4 | ea | $0.07 |  | $0.28 | TTI | 22-26AWG .110 |  | $0.13 | $0.28 |  | 22,000
Wire Tie, 8" | HD-MS0058 |  |  | 63126 |  | Hardware | 2 | ea | $0.02 |  | $0.05 | Electronics Distributors Corp (Distrubutor for Advanced Cable Tie) | APU-08-18-0-M | Err:509 | $0.02 | $0.05 | Err:509 | 6,100 |  |  |  |  | McMaster | 7130K32
Case Fan Assembly | Assembly # |  |  |  |  |  |  |  |  |  | $0.00
PELONIS FAN, high flow,24VDC,BALL,31.60CFM,80×80×15 MM,100mA | EL-FA0045 |  |  |  |  |  | 1 | ea | $8.79 |  | $8.79 |  |  | 8.79 | $1.95 | $8.79 | 8.79 | 3,050
female molex pins for 22-24AWG wire | EL-MS0001 |  |  |  |  |  | 2 | ea |  |  | $0.00
2 pin female molex connector | PC-CN0001 |  |  |  |  |  | 1 |  | $0.05 |  | $0.05
Fan guard control box | Need P/N |  |  |  |  |  | 1 | ea | $0.30 |  | $0.30
M3 x 6 Bolt, FHCS Black-Oxide | HD-BT0128 |  |  | 40921 |  | Hardware | 6 | ea | $0.04 | 6 Attach Cover to Chassis, 4 attach ps to cover, 2 for power input | $0.22 | Fastenal | 40921 |  |  | $0.22 |  | 18,300 |  |  |  | Bin stock program Provided Fastenal totals for Foxglove demand and totals needed | Mcmaster | 91294A126
M3 x 25 Bolt FLCS, Black-Oxide | HD-BT0135 |  |  | 40929 |  | Hardware | 4 | ea | $0.03 | Fasten fan to cover | $0.13 | Fastenal | 40929 |  | $0.08 | $0.13 |  | 12,200 |  |  |  | Bin stock program Provided Fastenal totals for Foxglove demand and totals needed
M3 Nyloc Nut, Zinc Plated | HD-NT0001 |  |  | 40143 |  | Hardware | 5 | ea | $0.05 | Fasten fan to cover | $0.25 | Fastenal | 40143 |  | $0.01 | $0.25 |  | 15,250 |  |  |  | Bin stock program Provided Fastenal totals for Foxglove demand and totals needed | Mcmaster | 90576A102
Black-Oxide 18-8 Stainless Steel Flat Washer, M3 Screw Size, 3.2mm ID, 7.0mm OD | HD-WA0038 |  |  |  |  |  | 4 | ea | $0.02 |  | $0.08 | Fastenal |  |  | $0.00 | $0.08 |  | 12,200
Mini RAMBo 1.3, assembled board only |  |  |  |  |  | Electronic | 1 | ea | $57.00 |  | $57.00 | UltiMachine |  | 57.00 | $57.00 | $57.00 | 57.00 | 3,050
Cosmos ® mini Aluminum Chips VGA RAM Cooling Heatsinks 6(L)x6(W)x3.5(H)mm Industrial Packaging | PP-MP0049 |  |  |  |  | Hardware | 1 | ea | $0.04 |  | $0.04 | PCCooler |  |  |  |  |  | 3,050 |  |  |  | We have 300K of these – we will never have to reorder these.
Glass Bed Assembly |  |  |  |  |  |  |  |  |  |  | $0.00
Borosilicate Glass Bed 170mm x 170mm | HD-MS0211-1 | Y |  |  |  | Mechanical | 1 | ea | $6.75 | Y | $6.75 | Allen Scientific |  | 6.75 | $12.05 | $6.75 | 6.75 | 3,500
Ultem PEI, 0.010" x 26" x 90ft rolls (CONFIRM THIS LENGTH IF WE CHANGE VENDORS) | HD-MS0311 |  |  | SULT1000NA.010X26.000X90FT |  | Mechanical | 0.0025641025641 | ea | $730.00 |  | $1.87 | SABIC / Professional Plastics |  | 0 |  |  |  | 11 rolls |  |  |  | Per Toni- 'we will review in December'Toni has these / Calculations for PEI ~ 20 cm lengths are used and we get 3 units off of the width of 26” we need 200mm lengths so we will need 9656.16 feet of material / 65 foot rolls = 10.09 rolls at $730.00 per = 7365.70 / 3050 =
3M 468MP Adhesive Transfer Tape – 26” x 60 yards | HD-MS0310 |  | HBM | TAPE3M468MP.005X26.000X60YD .005" |  | Mechanical | 0.0012820512821 | ea | $409.99 |  | $0.53 | HBM |  | 0 |  | $0.53 |  | 8-10 |  |  |  | Pull in 2 logs as first articles before production units. TS
Silicon Heater, 24V, 168mm x 168mm, Self Adhesive, w/ connectors | PC-BD0029 | Y |  | NPH PC-BD0029 |  | Electronics | 1 | ea | $27.95 | Y | $27.95 | National Plastic Heater | NPH PC-BD0029 | 27.95 | $27.95 | $27.95 | 27.95 | 3,050
Bed leveling washer, 303 SST | PP-MP0082 |  |  |  |  | Hardware | 4 | ea | $2.90 |  | $11.60 | MBK |  |  |  | $11.60 |  | 12,200
Metric Aluminum Unthreaded Spacer, 4.5mm OD, 6mm Length, M3 Screw Size |  |  |  | 11225-04164 |  | Hardware | 4 | ea | $0.21 |  | $0.84 |  |  |  |  | $0.84 |  | 12,200
M3 x 12 Bolt FHCS, SST | HD-BT0136 |  |  | M42510012A4000 |  | Hardware | 4 | ea | $0.05 |  | $0.20 | Fastenal | M42510012A4000 |  |  | $0.20 |  | 12,200 |  |  |  | 6000 pcs requested delivery | Mcmaster | 92125A132
Cable Guide, Bed | PN – printed part |  |  |  |  |  | 1
USB support mini v1.0 | Need P/N |  |  |  |  | Printed | 1 | ea |  |  | $0.00
Chasiss Ground Cable |  |  |  |  |  |  | 1
Black 24 AWG Wire | EL-WR0105 |  |  |  |  |  | 100
Ring Term. Non ins. 26-22 AWG | EL-MS0141 |  |  |  |  |  | 2
Ground fingers
M3 x 8 Bolt, BHCS, SST | HD-BT0104 |  |  |  |  | Hardware | 4 | ea | $0.09 |  | $0.35 | Fastenal | MB251008A |  |  | $0.35 |  | 12,200 |  |  |  | Bin stock program Provided Fastenal totals for Foxglove demand and totals needed | Mcmaster | 92095A181
M3 x 16 Stainless Flathead | Need P/N |  |  |  |  |  | 4 | ea | $0.10 |  | $0.40
M3 Nyloc Nut, Zinc Plated | HD-NT0001 |  |  | 40143 |  | Hardware | 1 | ea | $0.05 |  | $0.05 | Fastenal | 40143 |  | $0.01 | $0.05 |  | 3,050 |  |  |  | Bin stock program Provided Fastenal totals for Foxglove demand and totals needed | Mcmaster | 90576A102
Metric 18-8 Stainless Steel External Serrated Lock Washer, M3 Screw Size, 6mm OD, 0.4mm min Thick | HD-WA0035 |  |  | 11511313 |  | Hardware | 1 | ea | $0.02 |  | $0.02 | Fastenal | 91120A120 |  |  | $0.02 |  | 3,050 |  |  |  | Bin stock program Provided Fastenal totals for Foxglove demand and totals needed
Wire Tie, 8" | HD-MS0058 |  |  | 63126 |  | Hardware | 6 | ea | $0.02 |  | $0.14 | Electronics Distributors Corp (Distrubutor for Advanced Cable Tie) | APU-08-18-0-M | Err:509 | $0.02 | $0.14 | Err:509 | 18,300 |  |  |  |  | McMaster | 7130K32
Wire tie mounts |  |  |  |  |  |  | 2
M3 x 6 Bolt, FHCS Black-Oxide | HD-BT0128 |  |  | 40921 |  | Hardware | 6 | ea | $0.04 | xz axis to chassis | $0.22 | Fastenal | 40921 |  |  | $0.22 |  | 18,300 |  |  |  | Bin stock program Provided Fastenal totals for Foxglove demand and totals needed | Mcmaster | 91294A126
Extreme-Temperature Pipe Sealant & Threadlocker, 4 oz bottle, blue | TL-CS0040 |  |  |  |  | Consumable | 0.1 | g | $0.07 |  | $0.01 | Mcmaster | 7604A55 |  |  | $0.01 |  |  |  |  |  | We have to purchase this as needed. 6 month shelf life – Bob Bowman will advise when to reorder this
Loctite® Threadlocker 220, 0.34 oz. Bottle | TL-CS0169 |  |  | 1810A315 |  | Consumable | 0.1 | g | $0.07 |  | $0.01 | Mcmaster | 1810A315 |  |  | $0.01 |  |  |  |  | see notes | 2/3/16 per Mickey I am adding this to the BOM in replace of TL-CS0140 but I do not show TL-CS0140 was ever on this BOM.TS ** PLEASE JUST ORDER THIS AS NEEDED DUE TO EXPIRATION DATES VS. CONSUMPTION.TS)
Packaging |  |  |  |  |  |  |  |  |  |  | $0.00
1.5# RECY & 2# CROSSLINK W/ 10030 CH URETHANE | SH-PG0075 |  |  |  |  | Packaging | 1 | ea | $20.53 |  | $20.53 | Shipper's Supply | 20140922SA |  |  | $20.53 |  | 3,050
22x17x19 275# dw white/ OUTSIDE PRINT 2 COLOR | SH-PG0076 |  |  |  |  | Packaging | 1 | ea | $3.70 |  | $3.70 | Shipper's Supply |  |  |  | $3.70 |  | 3,050
#260 White Reinforced Gummed Tape with LulzBot Printed Logo, 10 Pack | Need pn |  |  |  |  |  | 0.018
Label, Lulzbot Mini Barcode | DC-LB0028 |  |  |  |  | Packaging | 1 | ea | $0.14 |  | $0.14 | The print shop of loveland |  |  |  | $0.14 |  | 3,050
Mini v1 serial number sticker | DC-LB0029 |  |  |  |  | Packaging | 1 | ea | $0.01 |  | $0.01 | The print shop of loveland |  |  |  | $0.01 |  | 3,050
Sample Material |  |  |  |  |  |  |  |  |  |  | $0.00
3 x 4" 2 Mil Reclosable Polypropylene Bags | SH-PG0002 |  |  |  |  | Packaging | 1 | ea | $0.02 |  | $0.02 | Uline | S-1292 |  |  | $0.02 |  | 3,050
9 x 12" 8 Mil Reclosable Bags | SH-PG0083 |  |  |  |  | Packaging | 1 | ea | $0.27 |  | $0.27 | Uline | S-13440 |  |  | $0.27 |  | 3,050
6 x 10" 6 Mil Reclosable Bags | SH-PG0084 |  |  |  |  | Packaging | 1 | ea | $0.17 |  | $0.17 | Uline | S-17767 |  |  | $0.17 |  | 3,050
Documents |  |  |  |  |  |  |  |  |  |  | $0.00
Packing List, Mini 2.? | DC-MS0028 |  |  |  |  | Packaging | 1 | ea | $0.24 |  | $0.24 | The print shop of loveland |  |  |  | $0.24 |  | 3,050
Quality assurance record Mini 2.4 | DC-MS0029 |  |  |  |  | Packaging | 1 | ea | $0.72 |  | $0.72 | The print shop of loveland |  |  |  | $0.72 |  | 3,050
Lulzbot Mini Poster | DC-MS0030 |  |  |  |  | Packaging | 1 | ea | $0.75 |  | $0.75 | The print shop of loveland |  |  |  | $0.75 |  | 3,050
Mini Warning sheet | DC-MS0031 |  |  |  |  | Packaging | 1 | ea | $0.07 |  | $0.07 | The print shop of loveland |  |  |  | $0.07 |  | 3,050
Quick start guide, Mini | DC-MS0032 |  |  |  |  | Packaging | 1 | ea | $0.95 |  | $0.95 | Citizen Printing |  |  |  | $0.95 |  | 3,050
CE Declaration of Conformity, Mini v1.0 | DC-MS0033 |  |  |  |  | Packaging | 1 | ea | $0.11 |  | $0.11 | The print shop of loveland |  |  |  | $0.11 |  | 3,050
Modification Warning Insert Modification 2.75 x 8.5 on 100 lb. Astrobright Lift Off Lemon Very Bright | DC-LB0063 |  |  |  |  | Packaging | 1 | ea | $0.07 |  | $0.07 | The print shop of loveland
ToolKit |  |  |  |  |  |  |  |  |  |  | $0.00
.003 Stainless Steel/Straight Instrument Cleaner Brush | TL-MS0020 |  |  |  |  | Tools | 1 | ea | $5.29 |  | $5.29 | GORDON BRUSH MFG CO, INC | 906501 | 5.29 | $2.00 | $5.29 | 5.29 | 3,050 |  |  |  | 255 x 12 = 3060 Notified Gordon brush, early deliveries require prior approval. Confirm lead time.
SWM Style USB Flash drive, 4gb, Black Pre-flashed with Data and Logo | EL-MS0262 |  |  |  |  | Tools | 1 | ea | $3.95 |  | $3.95 | Nexcopy |  |  |  | $3.95 |  | 3,050
Pro Dental Pick, 5 3/4 in With Caps | TL-HD0046 |  |  |  |  | Tools | 1 | ea | $0.97 |  | $0.97 | Image Supply | (DP-19) M S V | 0.97 | $1.05 | $0.97 | 0.97 | 3,050
7 1/2" Nylon Handle Clam Knife | TL-HD0009 |  |  |  |  | Tools | 1 | ea | $2.03 |  | $2.03 | WEBstaurant Store | 35340592 |  |  | $2.03 |  | 3,050
LASER ETCHING ON CLAM KNIFE | TL-HD0359 |  |  |  |  |  |  |  | $0.47 |  | $0.00 | Laser Engraving Designs, LLC |  |  |  |  |  | 6,100
Clam Knife Sheath Sticker - Caution Sharp Blade! (1"x2.5" Rectangle) | DC-LB0062 |  |  |  |  | Packaging | 1 | ea | $0.03 |  | $0.03 | Sticker Giant
6'' Deluxe Bent Stainless Steel Tweezer with Serrated Teeth | TL-HD0049 |  |  |  |  | Tools | 1 | ea | $1.44 |  | $1.44 | ROEDER | TWE6 |  |  | $1.44 |  | 3,050
2mm Allen Wrench | TL-HD0223 |  |  |  |  | Tools | 1 | ea | $0.17 |  | $0.17 | MSC industrial | 5747035 |  |  | $0.17 |  | 3,050
LulzBot Wiper Pads | PP-FP0084 |  |  |  |  |  | 5 | ea | $0.29 |  | $1.43
6ft USB 2.0 A/B Gold Device Cable Ferrite Chokes A Male B Male | EL-CA0063 |  |  | U023-006 |  | Electronic | 1 | ea | $2.89 |  | $2.89 | EDC (Electronics Distributors Corp. | Tripplite U023-006 | 1.10 | $1.09 | $2.89 | 1.10 | 3,050
6ft 18AWG Power Cord Cable w/ 3 Conductor PC Power Connector Socket (C13/5-15P) – Black | EL-CA0030 |  |  |  |  | Electronic | 1 | ea | $1.10 |  | $1.10 | Linvox | 5279 |  | $1.65 | $1.10 |  | 3,050
6ft 18AWG England Power Cord Cable - H05VV-F NEMA C13 – Black | EL-CA0031 |  |  |  |  |  |  |  |  |  | $0.00 | Linvox | 7691 |  |  |  |  |  |  |  |  | confirmed
6ft 18AWG European Power Cord Cable - H05VV-F NEMA C13 – Black | EL-CA0032 |  |  |  |  |  |  |  |  |  | $0.00 | Linvox | 7692 |  |  |  |  |  |  |  |  | confirmed
 |  |  |  | 63126 |  | Hardware
 |  |  |  |  |  |  |  |  |  |  | $0.00
 |  |  |  |  |  |  |  |  |  |  | $0.00
 |  |  |  |  |  |  |  |  |  |  | $0.00
 |  |  |  |  |  |  |  |  |  |  | $0.00
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
