reprapperMC/mini-gladiola/production_parts/machined_parts/hexagon_hotend/Hot_end_BOM.ods

Category | AO Part # | Description | Manufacturer | Manufacturer PN | Distributor | Distributor SKU | Qty Per | UOM | Price Per Unit | Price Total | Qty to Order
 |  |  |  |  |  |  |  |  |  | $227.05
Mechanical | PP-MP0113 | Cooling Block 3mm short | MBK |  |  |  | 1 | ea | $38.80 | $38.80 | 10
Mechanical | PP-MP0114 | Heater Block 16 x 18 x 17 | MBK |  |  |  | 1 | ea | $26.90 | $26.90 | 10
Mechanical | PP-MP0118-X | Hexagon Nozzle | MBK |  |  |  | 1 | ea | $39.90 | $39.90 | 10
Mechanical | PP-MP0115 | Retention Plate v2 | MBK |  |  |  | 1 | ea | $9.80 | $9.80 | 10
Mechanical | PP-MP0112 | Hexagon HB Tube | MBK |  |  |  | 1 | ea | $68.60 | $68.60 | 10
Mechanical | PP-MP0116 | Upper Thread 3.2 | MBK |  |  |  | 1 | ea | $18.60 | $18.60 | 10
Mechanical | PP-MP0117 | Hexagon Mount Plate | MBK |  |  |  | 1 | ea | $19.90 | $19.90 | 10
Electrical | New Part | Heater Cartridge 30W 24VDC, 6mm diam, 20-22mm long |  |  |  |  | 1 | ea | $1.00 | $1.00 | 20
Hardware | HD-BT0162 | Alloy Steel Cup Point Set Screw, M3 Size, 4mm Long, 0.5mm Pitch |  |  | Mcmaster | 91390A098 | 1 | ea | $0.05 | $0.05 | 100
Hardware | HD-MS0230 | Black-Oxide Class 12.9 Socket Head Cap Screw, Alloy Steel, M2 Thread, 6mm Length, 0.4mm Pitch |  |  | Fastenal |  | 1 | ea | $0.03 | $0.03 | 0 | This will go away if pressing tube in works
Electrical | EL-HR0073 | Thermistor Assembly v1.0 | Allcable |  |  |  | 1 | ea |  | $3.47
Electrical | EL-TH0010 | NTC Thermistors 100kohm 3%, 4267 | Semitec | 104NT-4-R025H42G | Mouser | 954-104NT-4-R025H42G | 1 | ea | $3.01 | $3.01 | 20
Electrical | HD-TB0058 | High-Temperature Chemical-Resistant Tube Sleeving, .015" ID, for 28 AWG Wire |  |  | Mcmaster | 5335K11 | 40 | mm | $0.00 | $0.02 | 10ft
Electrical | EL-WR0130 | Wire, HOOK-UP STRND 28AWG BLACK 100' | Alpha Wire | 6710 BK005 | Digikey | 6710 BK005-ND | 200 | mm | $0.00 | $0.20 | 100ft
Electrical | EL-WR0131 | Wire, HOOK-UP STRND 28AWG RED 100' | Alpha Wire | 6710 RD005 | Digikey | 6710 RD005-ND | 200 | mm | $0.00 | $0.20 | 100ft
Electrical | EL-WR0133 | INSULTHERM TRU-FIT 18AWG | Insultherm | FGLG.18BK | Allcable | FGLG.18BK | 80 | mm | $0.00 | $0.03 | 250ft
