reprapperMC/mini-gladiola/production_parts/printed_parts/printed_part_status.ods

Sheet: Sheet1
Part number | Part name | Model status | Number required for emc | notes
 | Z-upper right | Ready to print | 1 | passed torque 8 in-lbs, passed pullout (6x M3's) used to mount non-axially loaded part that is mounted to a plate
 | Z-upper Left | Ready to print | 1 | passed torque 8 in-lbs, passed pullout (6x M3's) used to mount non-axially loaded part that is mounted to a plate
 | Z-lower left | Ready to print | 2
 | Z-lower right | Ready to print | 2
 | X-end motor | Ready to print | 2
 | X-end idler | Ready to print | 2
 | strain relief mount | Ready to print | 0
 | strain relief mount lower | Ready to print | 0
 | Y-idler | Ready to print | 2
 | y rod mount | Ready to print | 2
 | double bearing holder | In testing | 4
 | belt mount | Ready to print | 0 | 6 in-lbs closes clamp and does not split insert side of mount; 8 in-lbs of torque will split insert side of clamp; mount inserts passed torque 8 in-lbs, passed pullout (3x M3's) used to secure mount plate
 | bed corner | Ready to print | 8
 | wiper mount | Ready to print | 2
 | handle | Ready to print | 1 | Chamfer for inserts to be included, excess plastic bloom; increase insert hole depth- Soldering iron tip extends beyond insert by 1.5mm. Total hole depth to be near 5.4mm
 | X-carriage cap | Ready to print | 2
 | upper x bearing holder | Ready to print | 2
 | X-carriage | Ready to print | 2
 | extruder mount | Ready to print | 0 | Fan mount M3 holes crack at 8 in-lbs torque applied, pull out force is acceptable, front M3 passed 8 in-lbs torque and pull out
 | heatsink fan mount | Same as Olive | 2 | pull from current olive
 | extruder body | Same as foxglove | 2 | use same gcode as foxglove
 | Beefy extruder idler | NEW!! | 0 | We are going to roll with the extruder idler and latch from Opah, files have been updated
 | extruder washer | Ready to print | 0
 | Beefy idler latch | NEW!! | 2 | We are going to roll with the extruder idler and latch from Opah, files have been updated
 | small herringbone | Same as foxglove | 0
 | large herringbone | Same as foxglove | 0
 | Spool arm | Ready to print | 0
 | spool arm support | Ready to print | 2
 | spool arm bracket | Ready to print | 0
 | bed clip | Ready to print | 0 | test parts do not fit bed connectors, parts (2) cracked
 | upper bearing | Ready to print | 2
 | extruder fan mount | Ready to print | 0

Sheet: For R&D build
Part Name | Odoo Description | Odoo Part Number | Status | Pre-cosmetic approval (BI) | Mechanical Approval (Y/N) | Cosmetic Approval (Y/N) | Approved for cluster production (M.S.)
upper x bearing holder | upper-bearing-holder_black_v3.0 | PP-GP0257_v3.0 | Ready to print | 1.1.0.2 | Y | Y | Y
wiper mount | Wiper Mount, v1.1 | PP-GP0231 | Ready to print | 1.0.0.2 | Y | Y | Y
X-carriage | x-carriage-mini_black_v1.1 | PP-GP0256_v1.1 | Ready to print | 2.3.0.2 | Y | Y | Y
Z-lower left | lower-z-left-mini_lulz-green_v1.6 | PP-GP0269_v1.6 | Ready to print | 0.0.0.0 | Y | Y | Y
Z-lower right | lower-z-right-mini_lulz-green_v1.6 | PP-GP0270_v1.6 | Ready to print | 0.0.0.1 | Y | Y | Y
X-end motor | x-end-motor-mini_black_v1.7 | PP-GP0267_v1.7 | Ready to print | 2.2.0.4 | Y | Y | Y
X-end idler | x-end-idler-mini_black_v2.8 | PP-GP0268_v2.5 | Ready to print | 5.6.0.5 | Y | Y
strain relief mount lower | strain-relief-lower_black_1.2 | PP-GP0265_v1.2 | Ready to print | 0.1.0.1 | Y | Y | Y
double bearing holder | double-bearing-holder_black_v1.4 | PP-GP0262_v1.4 | Ready to print | 0.0.0.3 | Y | Y | Y
bed corner | bed corners, mini v2.5 | PP-GP0248 | Ready to print | 1.2.0.0 | Y | Y | Y
handle | handle-bar_black_v2.5 | PP-GP0259_v2.5 | Ready to print | 0.0.0.1 | Y | Y | Y
X-carriage cap | x-carriage-cap_black_v2.4 | PP-GP0258_v2.4 | Ready to print | 1.1.0.0 | Y | Y | Y
heatsink fan mount | heatsink-fan-duct_black_v0.6 | PP-GP0232 | Ready to print | 0.0.0.0 | Y | Y | Y
Beefy extruder idler | Beefy Extruder Idler v0.3 | PP-GP0241 | Ready to print | 1.3.1.0 | Y | Y | Y
Beefy idler latch | Beefy Idler Latch v2.2 | PP-GP0245 | Ready to print | 0.0.0.0 | Y | Y | Y
small herringbone | Herringbone Small Gear v1.1, Lulzbot green | PP-GP0192 | Same as foxglove | Use existing Gcode | Y | Y | Y
large herringbone | Herringbone Large Gear v1.3, Lulzbot green | PP-GP0191 | Same as foxglove | Use existing Gcode | Y | Y | Y
spool arm bracket | spool-arm-bracket_black_v1.0 | PP-GP0253_v1.0 | Ready to print | 2.1.0.0 | Y | Y | Y
bed clip | bed clip v3 | PP-GP0249 | Ready to print | 0.1.0.0 | Y | Y | Y
usb support | USB support mini v1.0 | PP-GP0247 | Ready to print | 2.2.0.4 | Y
Z-upper right | z-upper-mini-right_black_v2.0 | PP-GP0272_v2.0 | Ready to print | 1.1.0.4 | Y | Y | Y
Z-upper Left | z-upper-mini-left_black_v2.0 | PP-GP0271_v2.0 | Ready to print | 0.0.0.2 | Y | Y | Y
strain relief mount | strain-relief-upper_black_v3.0 | PP-GP0266_v3.0 | Ready to print | 0.0.0.3 | Y | Y | Y
Y-idler | y-idler-mini_black_v1.4 | PP-GP0264_v1.4 | Ready to print | 3.1.1.4 | Y | Y
y motor mount | y-motor-mount_black_v1.4 | PP-GP0263_v1.4 | Ready to print | 1.0.1.4 | Y | Y
belt mount | belt-mount_black_v1.1 | PP-GP0261_v1.1 | Ready to print | 1.0.1.3 | Y | Y | Y
Belt clamp | belt-clamp_black_v1.1 | PP-GP0260_v1.1 | Ready to print | 0.0.0.1 | Y | Y | Y
extruder mount | Extruder Mount v3.0, Mini | PP-GP0251 | Ready to print | 1.1.0.3 | Y | Y | Y
extruder body | extruder-body-hex_black_v1.4.1 | PP-GP0186 | Ready to print | 4.3.0.3 | Y | Y | Y
extruder washer | Extruder Washer v3.0, Taz | PP-GP0060 | Same as foxglove | Use existing Gcode | Y | Y | Y
Spool arm | spool-arm-mini_black_v1.4 | PP-GP0255_v1.4 | Ready to print | 1.1.1.2 | Y | Y
spool arm support | spool-arm-support_black_v1.1 | PP-GP0254_v1.1 | Ready to print | 0.0.0.2 | Y | Y
extruder fan mount | Extruder Fan Mount v2.1, Mini | PP-GP0252 | Ready to print | 0.1.0.2 | Y | N(part change) | N(part change)
