reprapperMC/mini-gladiola/production_docs/Mount_price_comparison.ods

Spool Mount | Tooling Cost | Time | Price for 10,000 | Extended price | Notes
Printed | $0.00 | Now | $2.24 | $2.24 | Inserts are purchased and installed by us
DP Colorado | $17,000.00 | 10 Weeks | $1.03 | $2.73 | Inserts are installed by them but supplied by us
Proto Mold | $6,125.00 | 2 Weeks | $4.44 | $5.05 | Inserts are purchased and installed by us
