reprapperMC/mini-gladiola/Assembly/Changes for assembly/extruder-body-hex-for-asm.step

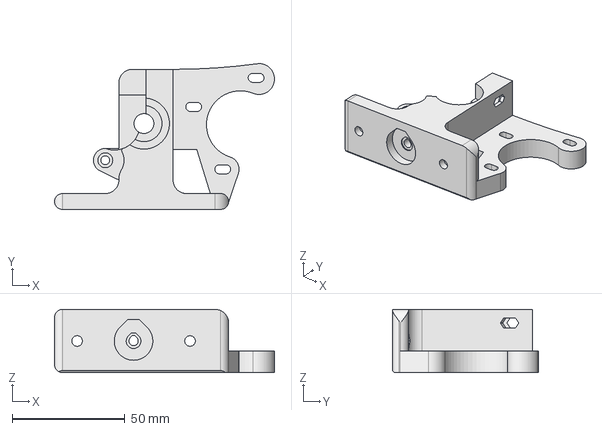
[picture p2: CAD file, 2016-11-16]
Assembly/Changes for assembly/extruder-body-hex-for-asm.step
97.4 x 64.5 x 28.0 mm
