reprapperMC/mini-gladiola/Assembly/assembly_parts/drive_rod_10mm_mini_full_length.step

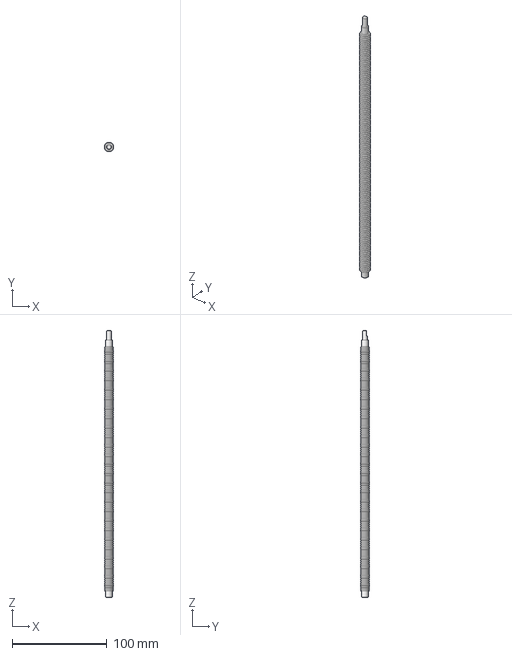
[picture p3: CAD file, 2016-11-16]
Assembly/assembly_parts/drive_rod_10mm_mini_full_length.step
9.99 x 10.00 x 282.0 mm
