reprapperMC/mini-gladiola/Assembly/assembly_parts/nema17_damper.step

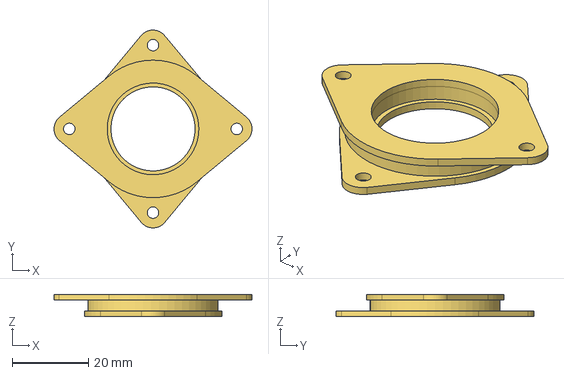
[picture p5: CAD file, 2016-11-18]
Assembly/assembly_parts/nema17_damper.step
51.8 x 51.8 x 5.80 mm
