reprapperMC/mini-gladiola/Assembly/x_motor_end_assm.fcstd

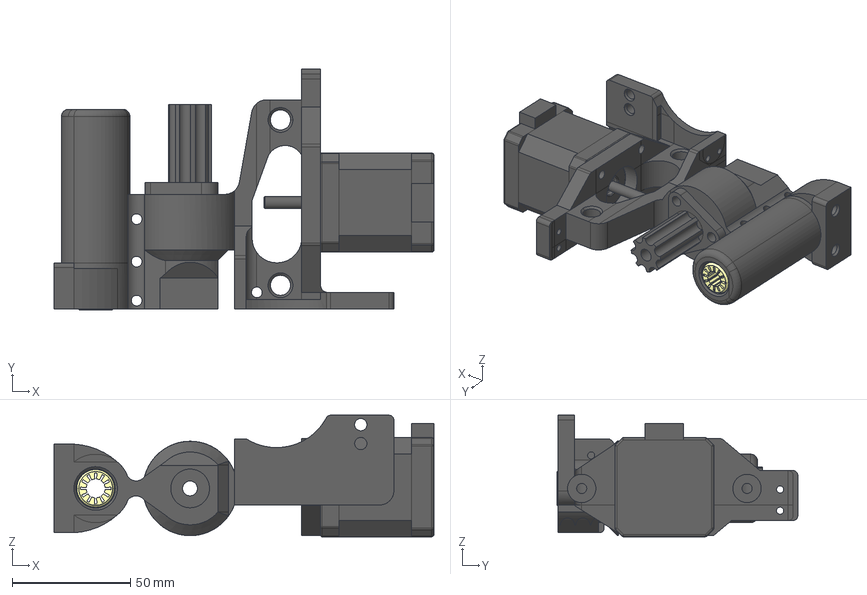
[picture p6: CAD file, 2016-11-18]
Assembly/x_motor_end_assm.fcstd
160.9 x 101.9 x 51.5 mm
x_end_motor_mini_black_v2_0_step1_01
mts10x2m_stp1_01
RJM_01_08_1_stp1_01
RJM_01_08_1_stp1_02
NEMA17_step1_01
