reprapperMC/mini-gladiola/production_parts/jigs/HerringBone6shooter.stl

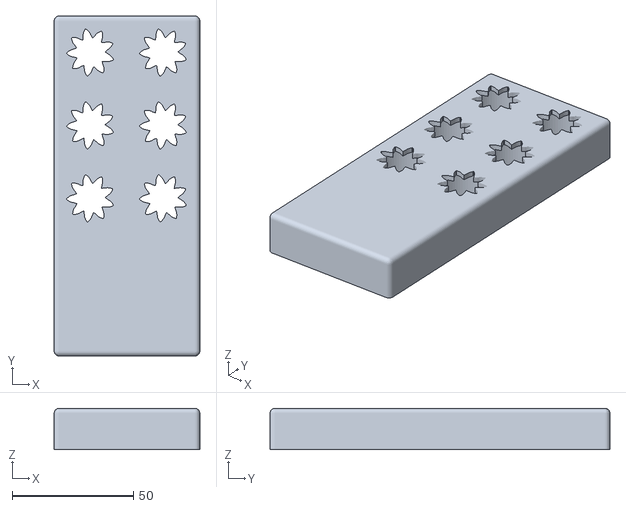
[picture p7: CAD file, 2017-08-30]
production_parts/jigs/HerringBone6shooter.stl
60.0 x 140.0 x 17.0
