reprapperMC/mini-gladiola/production_parts/machined_parts/8_mm_rod/8x19mm_smooth_rod_revB.fcstd

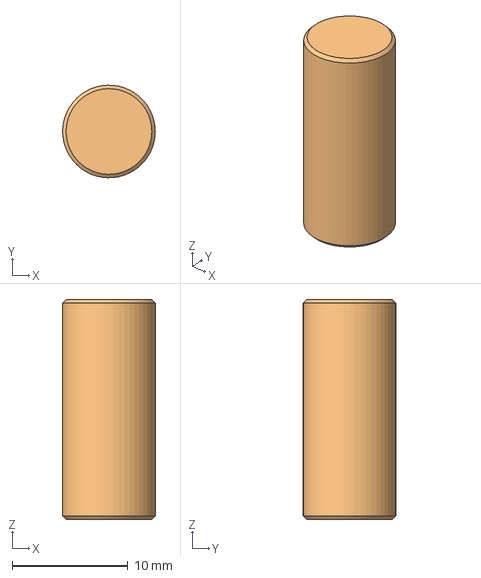
[picture p8: CAD file, 2017-07-31]
production_parts/machined_parts/8_mm_rod/8x19mm_smooth_rod_revB.fcstd
7.99 x 8.00 x 19.0 mm
