reprapperMC/mini-gladiola/production_parts/machined_parts/bed_mount_plate/bed-mount-plate-mini_PP-FP0138_revF.fcstd

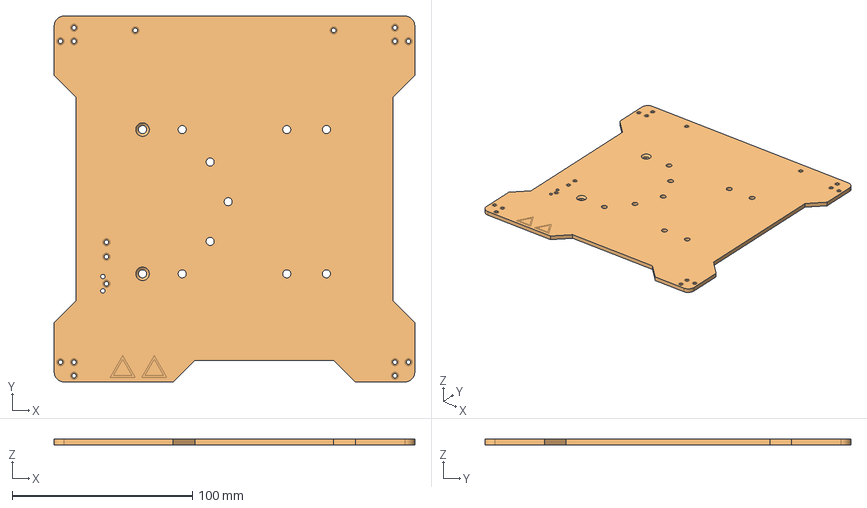
[picture p9: CAD file, 2017-12-08]
production_parts/machined_parts/bed_mount_plate/bed-mount-plate-mini_PP-FP0138_revF.fcstd
200.0 x 203.0 x 3.18 mm
