reprapperMC/mini-gladiola/production_parts/machined_parts/bottom_plate_mini/bottom-plate-mini_PP-MP0149_revE.step

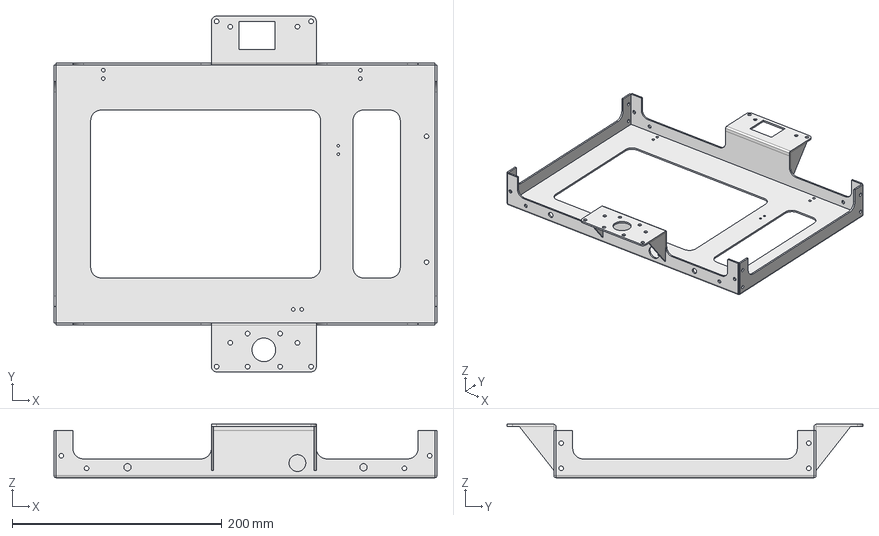
[picture p10: CAD file, 2018-03-05]
production_parts/machined_parts/bottom_plate_mini/bottom-plate-mini_PP-MP0149_revE.step
365.0 x 339.0 x 51.0 mm
