reprapperMC/mini-gladiola/production_parts/machined_parts/drive_rods/drive_rod_10mm_mini_HD-RD0037_revF.fcstd

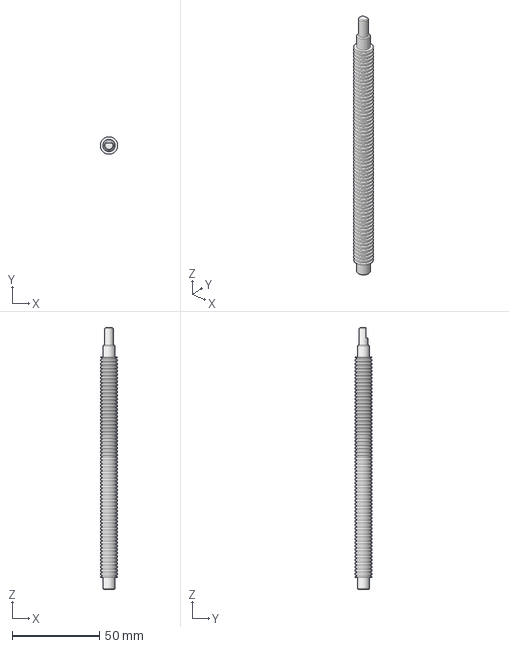
[picture p11: CAD file, 2017-02-20]
production_parts/machined_parts/drive_rods/drive_rod_10mm_mini_HD-RD0037_revF.fcstd
9.99 x 10.00 x 150.0 mm
