reprapperMC/mini-gladiola/production_parts/machined_parts/electronics_case/electronics-case-mini_PP-FP0139_revJ.fcstd

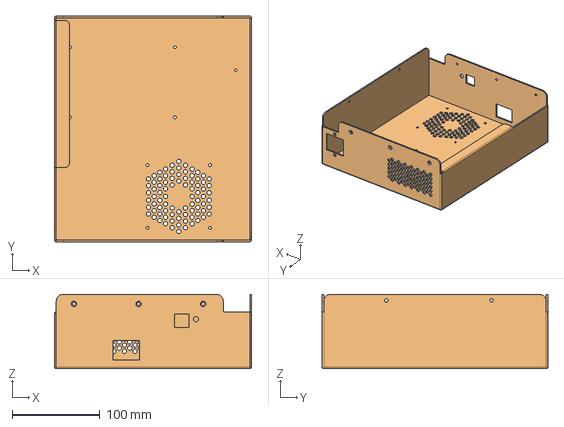
[picture p12: CAD file, 2017-12-08]
production_parts/machined_parts/electronics_case/electronics-case-mini_PP-FP0139_revJ.fcstd
225.0 x 258.0 x 85.0 mm
