reprapperMC/mini-gladiola/production_parts/machined_parts/hexagon_hotend/source/Upper_Thread.fcstd

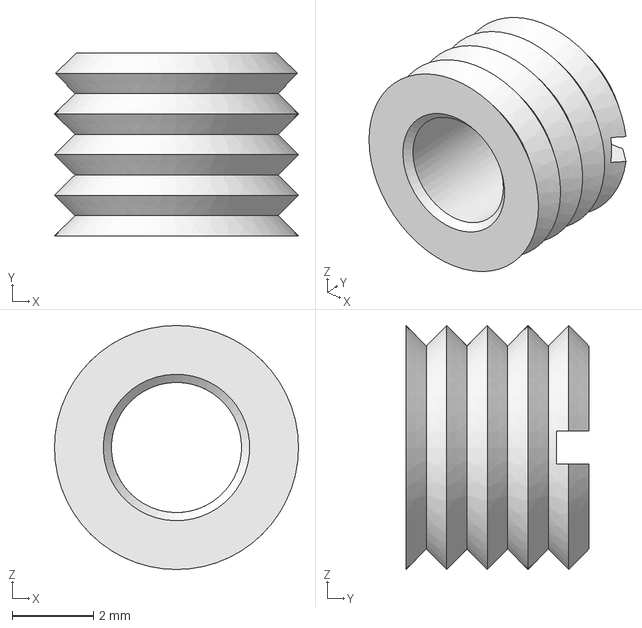
[picture p13: CAD file, 2016-05-03]
production_parts/machined_parts/hexagon_hotend/source/Upper_Thread.fcstd
6.00 x 4.50 x 6.00 mm
