reprapperMC/mini-gladiola/production_parts/machined_parts/hexagon_hotend/STEP/Hotend_single_component.fcstd

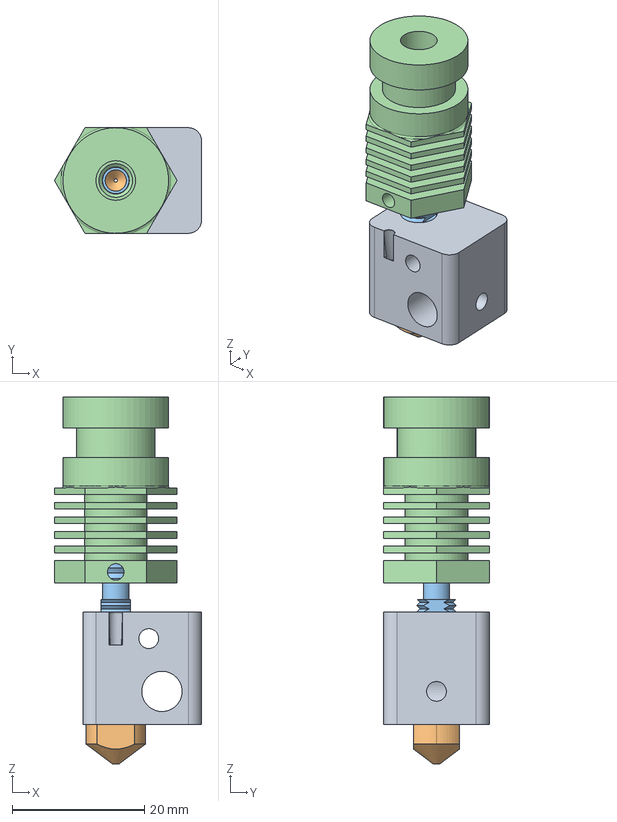
[picture p14: CAD file, 2016-11-16]
production_parts/machined_parts/hexagon_hotend/STEP/Hotend_single_component.fcstd
22.3 x 16.1 x 55.6 mm
Heater_Block_16_x_18_x_17_step1_01
Nozzle_step1_01
Heat_Break_Tube_step1_01
Cooling_Block_3mm_short_step1_01
