reprapperMC/mini-gladiola/production_parts/machined_parts/hotend_mount_plate/MOARstruder-mount-plate_PP-MP0156_revA.fcstd

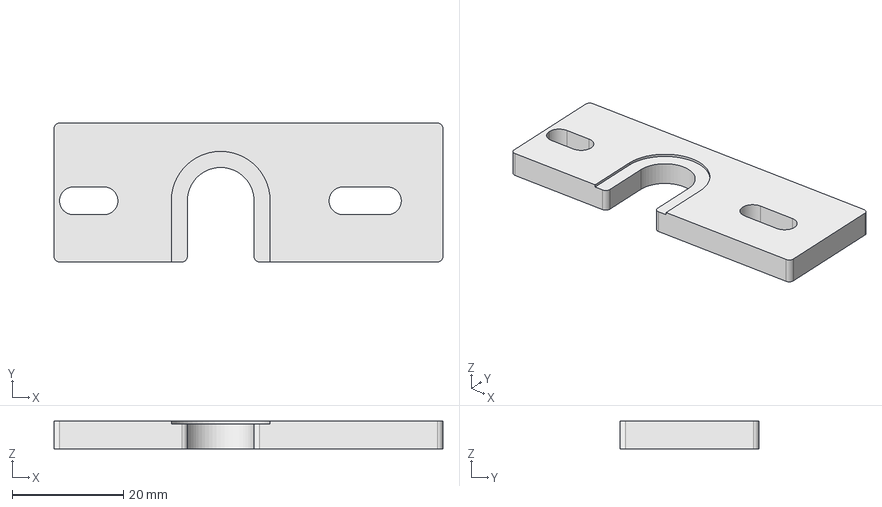
[picture p15: CAD file, 2019-01-09]
production_parts/machined_parts/hotend_mount_plate/MOARstruder-mount-plate_PP-MP0156_revA.fcstd
70.0 x 25.0 x 5.00 mm
