reprapperMC/mini-gladiola/production_parts/machined_parts/left_side/left-side-mini_PP-FP0055_revH.step

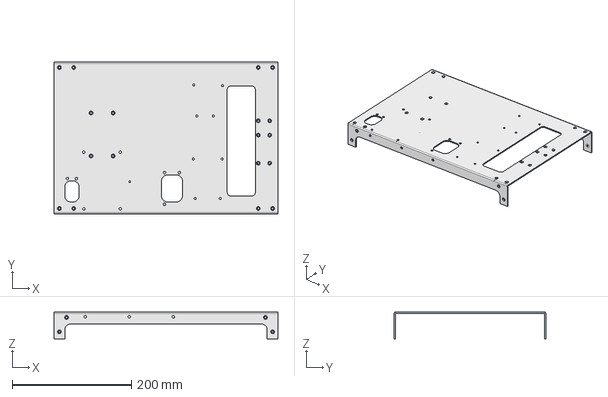
[picture p16: CAD file, 2016-09-20]
production_parts/machined_parts/left_side/left-side-mini_PP-FP0055_revH.step
375.0 x 254.0 x 45.0 mm
