reprapperMC/mini-gladiola/production_parts/machined_parts/right_side/right-side-mini_PP-FP0052_revF.step

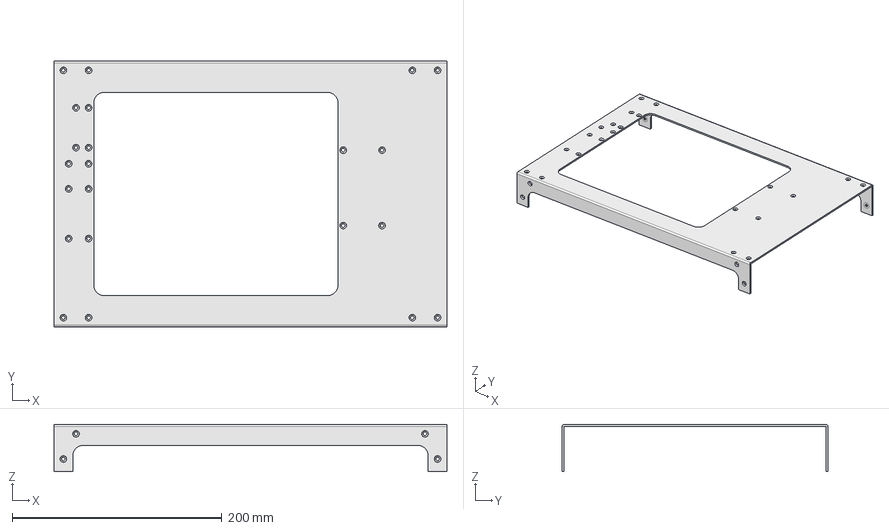
[picture p17: CAD file, 2016-08-25]
production_parts/machined_parts/right_side/right-side-mini_PP-FP0052_revF.step
375.0 x 254.0 x 45.0 mm
