reprapperMC/mini-gladiola/production_parts/machined_parts/smooth_rod_mini/8mmx315_rod_v1.0.step

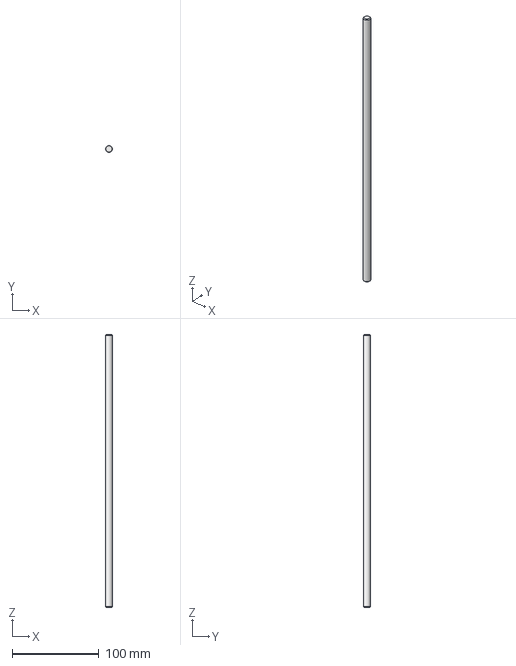
[picture p18: CAD file, 2016-11-16]
production_parts/machined_parts/smooth_rod_mini/8mmx315_rod_v1.0.step
7.99 x 8.00 x 315.0 mm
