reprapperMC/mini-gladiola/production_parts/machined_parts/top_plate_mini/top-plate-mini_PP-FP0051_revH.fcstd

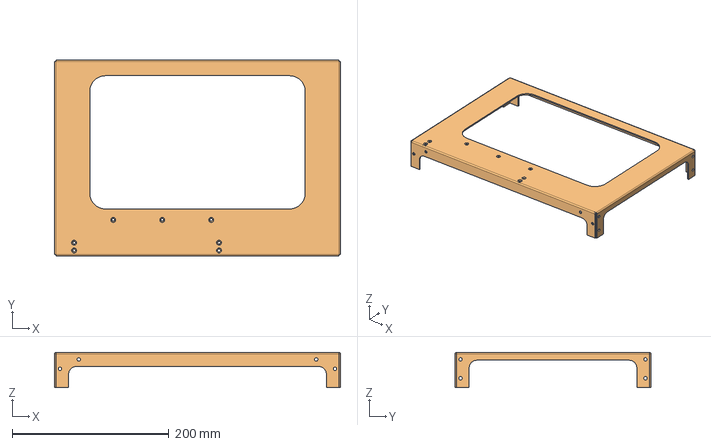
[picture p19: CAD file, 2017-12-08]
production_parts/machined_parts/top_plate_mini/top-plate-mini_PP-FP0051_revH.fcstd
365.0 x 250.0 x 45.0 mm
