reprapperMC/mini-gladiola/production_parts/printed_parts/bed_corner/bed_corner_v2.7.step

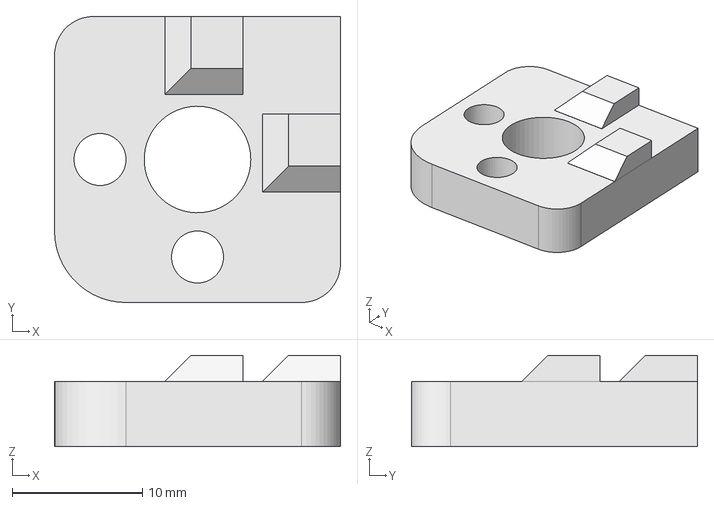
[picture p21: CAD file, 2016-11-16]
production_parts/printed_parts/bed_corner/bed_corner_v2.7.step
22.0 x 22.0 x 7.00 mm
