reprapperMC/mini-gladiola/production_parts/printed_parts/beefy_extruder_idler/beefy_extruder_idler_v0.4.step

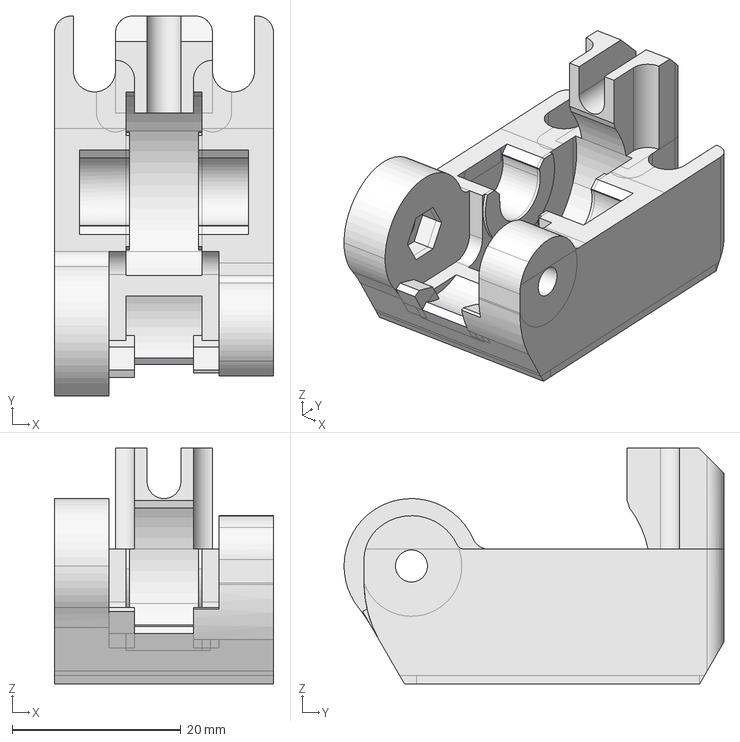
[picture p22: CAD file, 2016-11-16]
production_parts/printed_parts/beefy_extruder_idler/beefy_extruder_idler_v0.4.step
26.0 x 45.1 x 28.0 mm
