reprapperMC/mini-gladiola/production_parts/printed_parts/beefy_idler_latch/beefy_idler_latch_v2.2.step

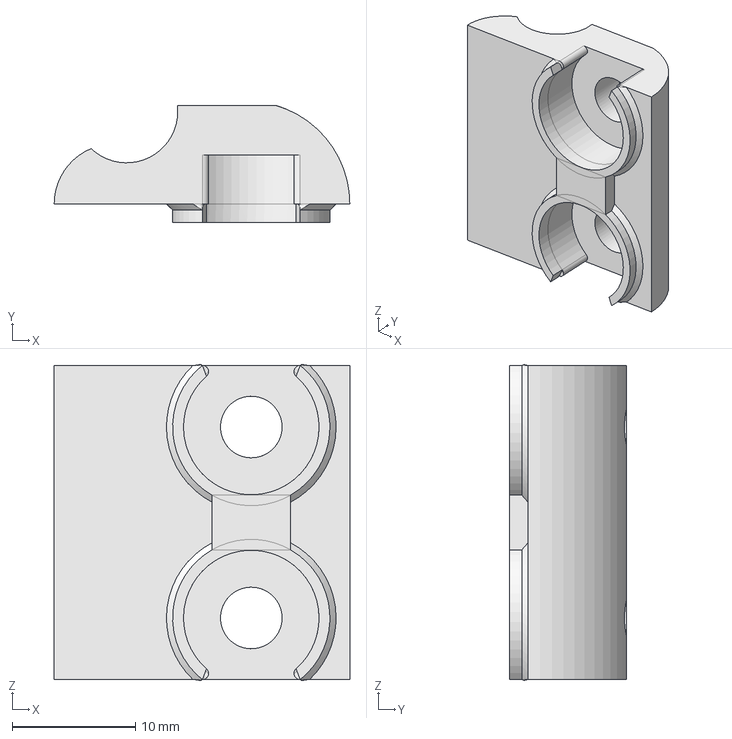
[picture p23: CAD file, 2016-11-16]
production_parts/printed_parts/beefy_idler_latch/beefy_idler_latch_v2.2.step
24.0 x 9.50 x 25.6 mm
