reprapperMC/mini-gladiola/production_parts/printed_parts/belt-clamp/belt-clamp-mini_black_v1.2.fcstd

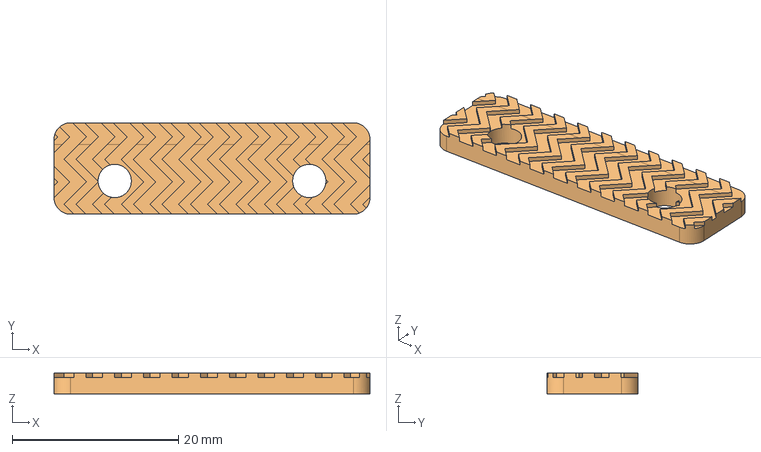
[picture p24: CAD file, 2016-11-28]
production_parts/printed_parts/belt-clamp/belt-clamp-mini_black_v1.2.fcstd
38.0 x 11.0 x 2.50 mm
