reprapperMC/mini-gladiola/production_parts/printed_parts/belt-mount/belt-mount_black_v1.2.fcstd

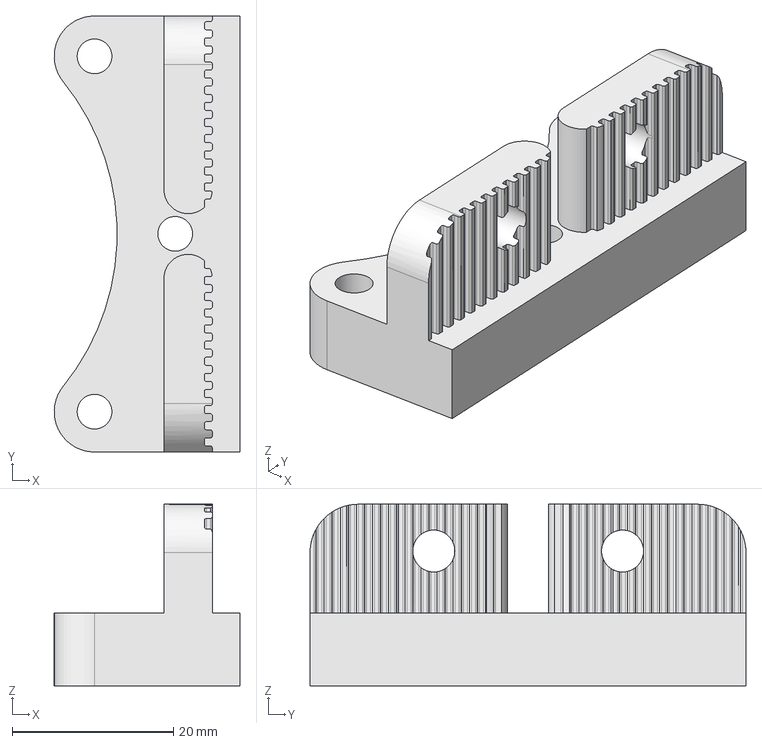
[picture p25: CAD file, 2016-11-28]
production_parts/printed_parts/belt-mount/belt-mount_black_v1.2.fcstd
23.0 x 54.0 x 22.5 mm
