reprapperMC/mini-gladiola/production_parts/printed_parts/double-bearing-holder/double-bearing-holder_black_v1.4.step

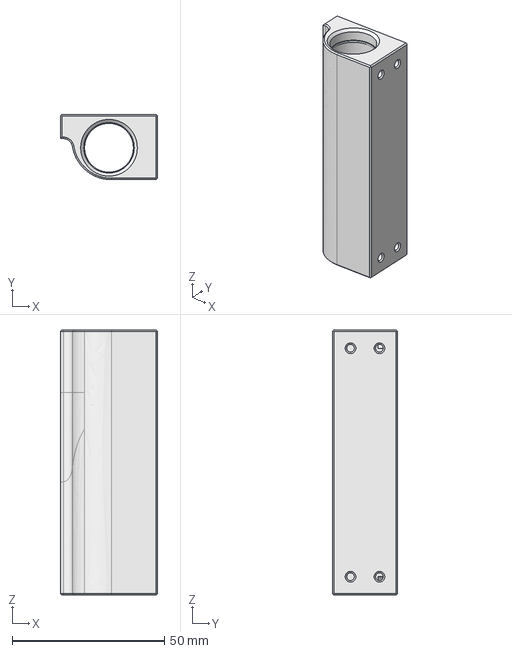
[picture p26: CAD file, 2016-11-16]
production_parts/printed_parts/double-bearing-holder/double-bearing-holder_black_v1.4.step
32.0 x 21.5 x 87.0 mm
