reprapperMC/mini-gladiola/production_parts/printed_parts/extruder-body-hex/extruder-body-hex_black_v1.4.1.stl

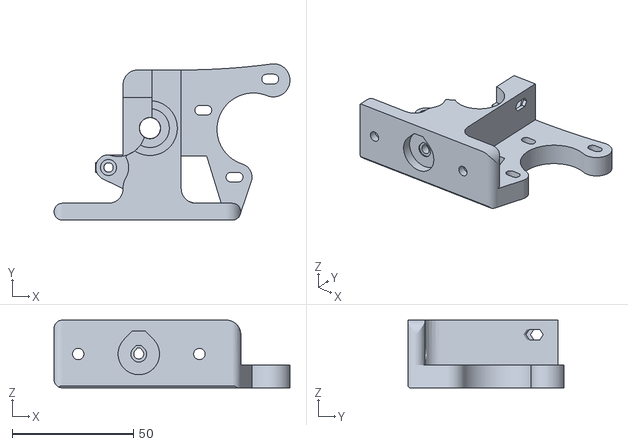
[picture p27: CAD file, 2016-08-12]
production_parts/printed_parts/extruder-body-hex/extruder-body-hex_black_v1.4.1.stl
97.4 x 64.5 x 28.0
