reprapperMC/mini-gladiola/production_parts/printed_parts/extruder_fan_mount/extruder_fan_mount_2.1_mini.step

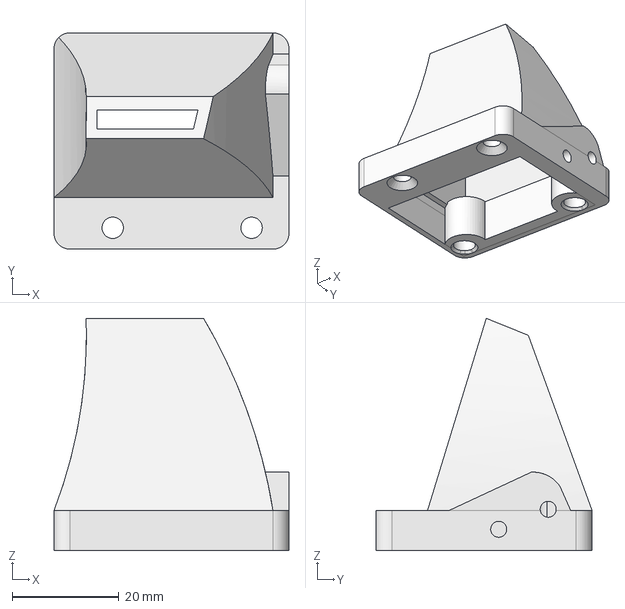
[picture p28: CAD file, 2016-11-16]
production_parts/printed_parts/extruder_fan_mount/extruder_fan_mount_2.1_mini.step
44.0 x 40.5 x 43.5 mm
