reprapperMC/mini-gladiola/production_parts/printed_parts/extruder_mount/extruder_mount_v2.11.step

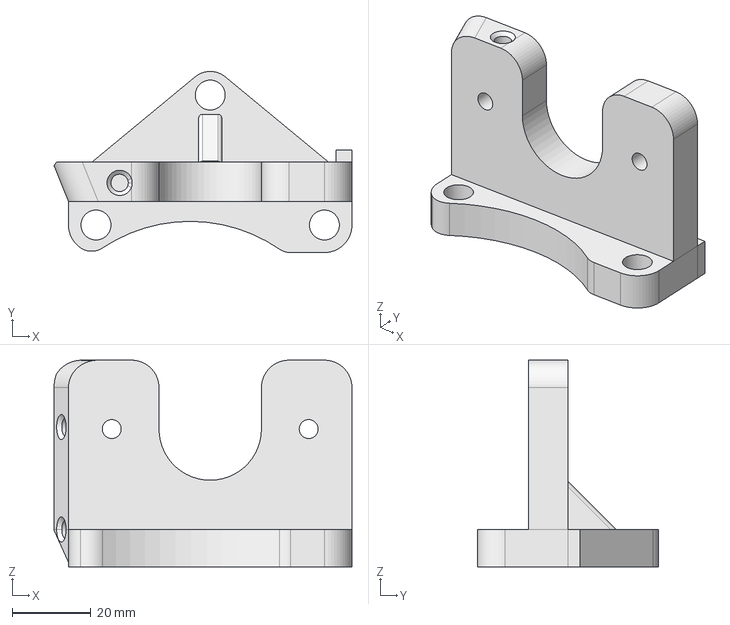
[picture p29: CAD file, 2016-11-16]
production_parts/printed_parts/extruder_mount/extruder_mount_v2.11.step
75.7 x 46.0 x 52.5 mm
