reprapperMC/mini-gladiola/production_parts/printed_parts/handle/handle-bar_black_v2.7.step

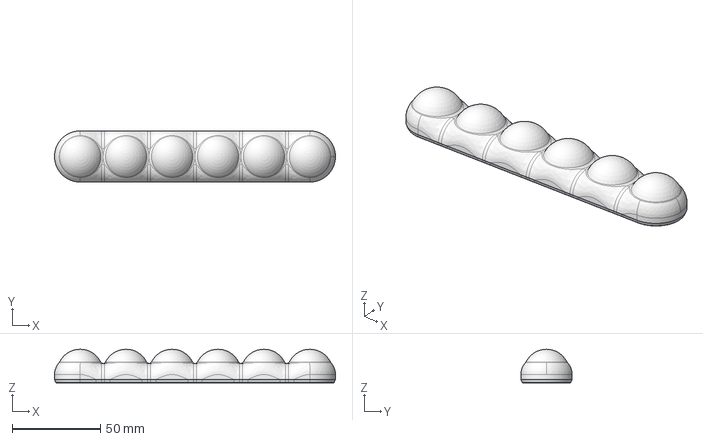
[picture p30: CAD file, 2016-11-16]
production_parts/printed_parts/handle/handle-bar_black_v2.7.step
159.0 x 29.0 x 19.0 mm
