reprapperMC/mini-gladiola/production_parts/printed_parts/heatsink-fan-duct/heatsink-fan-duct_black_v0.6.step

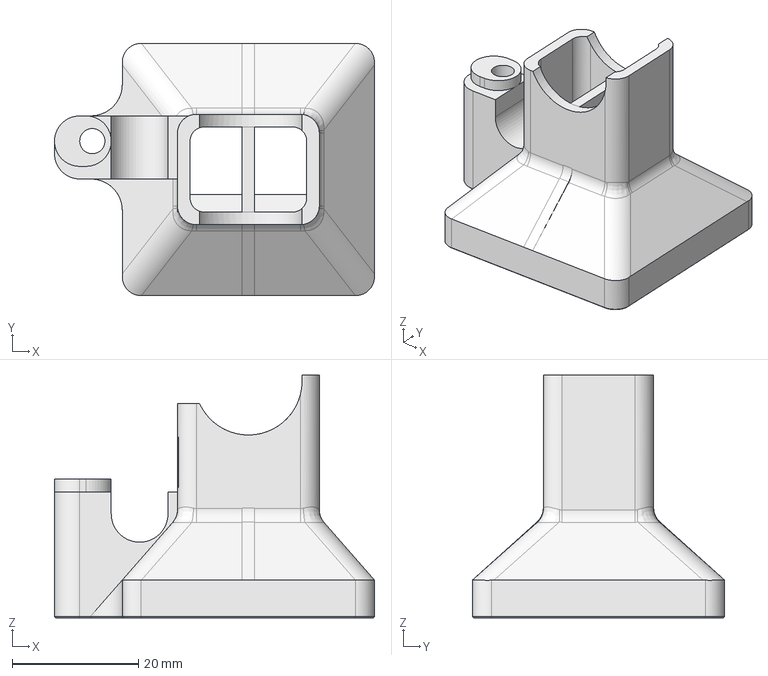
[picture p31: CAD file, 2016-11-16]
production_parts/printed_parts/heatsink-fan-duct/heatsink-fan-duct_black_v0.6.step
50.8 x 40.0 x 38.5 mm
