reprapperMC/mini-gladiola/production_parts/printed_parts/herringbone-gears/small-herringbone/herringbone_small_gear-1.1-highres.stl

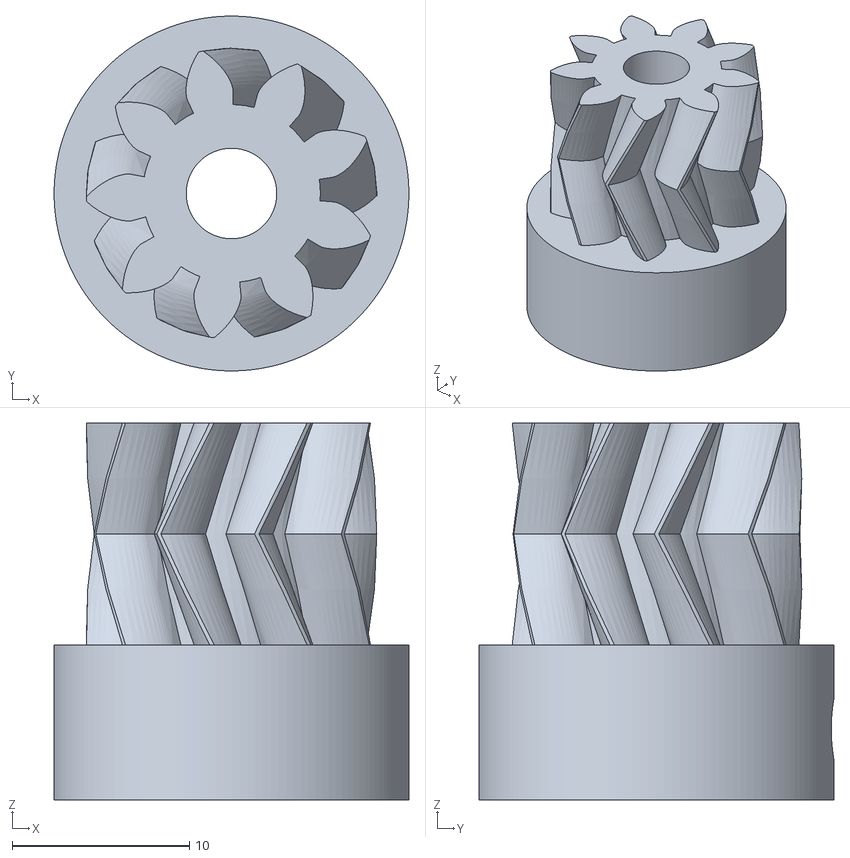
[picture p32: CAD file, 2016-05-03]
production_parts/printed_parts/herringbone-gears/small-herringbone/herringbone_small_gear-1.1-highres.stl
20.0 x 20.0 x 21.2
