reprapperMC/mini-gladiola/production_parts/printed_parts/herringbone_large_gear_blk/lrg_herringbone_gear_v1.3.stl

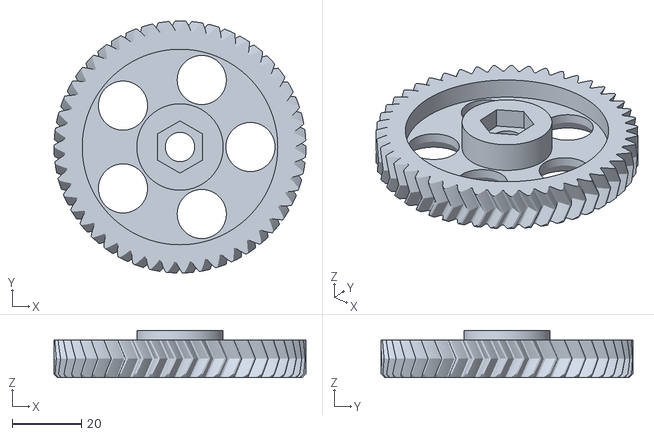
[picture p33: CAD file, 2016-05-03]
production_parts/printed_parts/herringbone_large_gear_blk/lrg_herringbone_gear_v1.3.stl
73.0 x 73.0 x 13.8
