reprapperMC/mini-gladiola/production_parts/printed_parts/lower-z-left-mini/lower-z-left-mini_lulz-green_v1.6.step

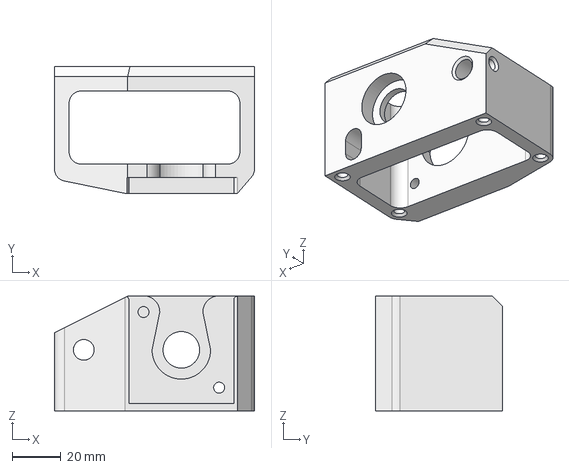
[picture p34: CAD file, 2016-11-16]
production_parts/printed_parts/lower-z-left-mini/lower-z-left-mini_lulz-green_v1.6.step
82.0 x 52.0 x 47.0 mm
