reprapperMC/mini-gladiola/production_parts/printed_parts/spool-arm-bracket/spool-arm-bracket_black_v1.0.step

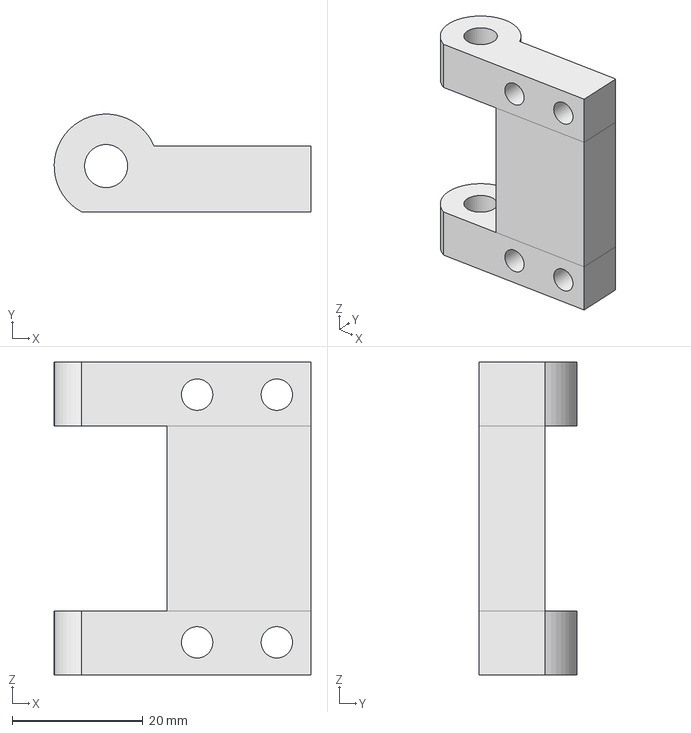
[picture p35: CAD file, 2016-11-16]
production_parts/printed_parts/spool-arm-bracket/spool-arm-bracket_black_v1.0.step
39.3 x 14.9 x 47.9 mm
