reprapperMC/mini-gladiola/production_parts/printed_parts/spool-arm-support/rd-test/spool-arm-support_black_v1.3.fcstd

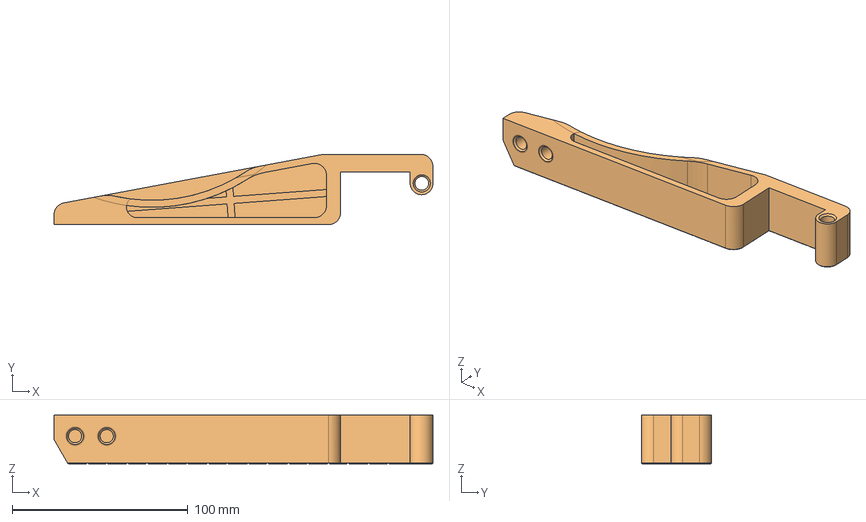
[picture p37: CAD file, 2016-10-25]
production_parts/printed_parts/spool-arm-support/rd-test/spool-arm-support_black_v1.3.fcstd
215.5 x 40.0 x 27.8 mm
