reprapperMC/mini-gladiola/production_parts/printed_parts/spool-arm-support/spool-arm-support_black_v1.3.stl

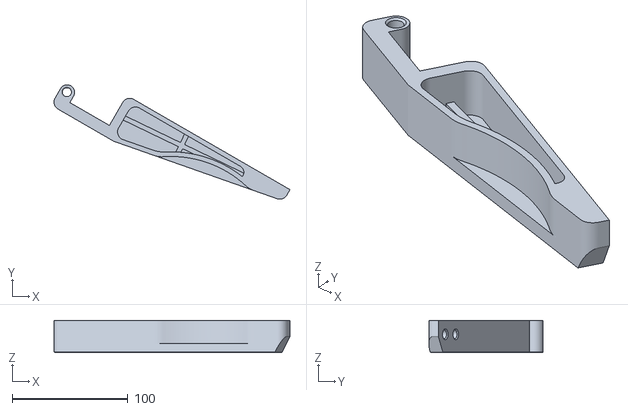
[picture p38: CAD file, 2017-08-08]
production_parts/printed_parts/spool-arm-support/spool-arm-support_black_v1.3.stl
204.1 x 98.9 x 27.8
