reprapperMC/mini-gladiola/production_parts/printed_parts/strain-relief-lower/strain-relief-lower_black_1.2.step

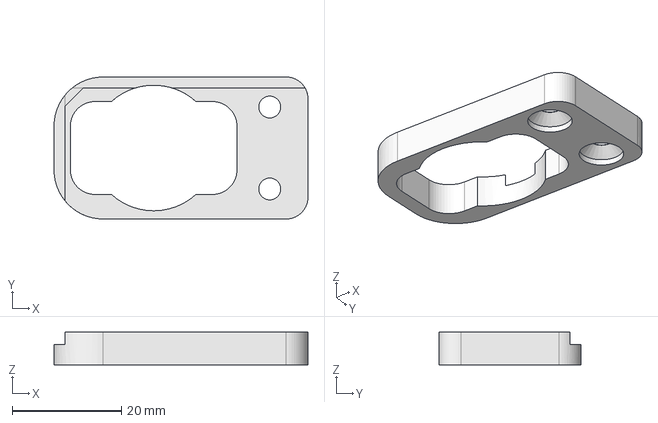
[picture p39: CAD file, 2016-11-16]
production_parts/printed_parts/strain-relief-lower/strain-relief-lower_black_1.2.step
46.5 x 26.0 x 6.00 mm
