reprapperMC/mini-gladiola/production_parts/printed_parts/strain-relief-upper/strain-relief-upper_black_v3.0.step

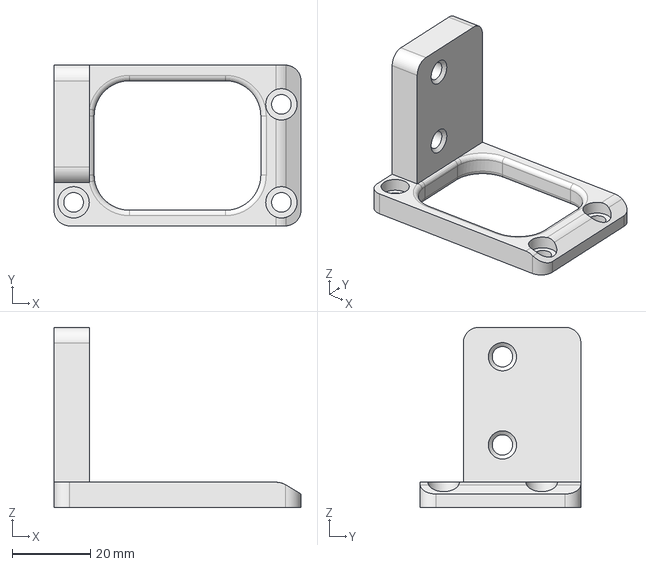
[picture p40: CAD file, 2016-11-16]
production_parts/printed_parts/strain-relief-upper/strain-relief-upper_black_v3.0.step
63.0 x 41.0 x 46.0 mm
