reprapperMC/mini-gladiola/production_parts/printed_parts/upper-bearing-holder/upper-bearing-holder_black_v3.0.step

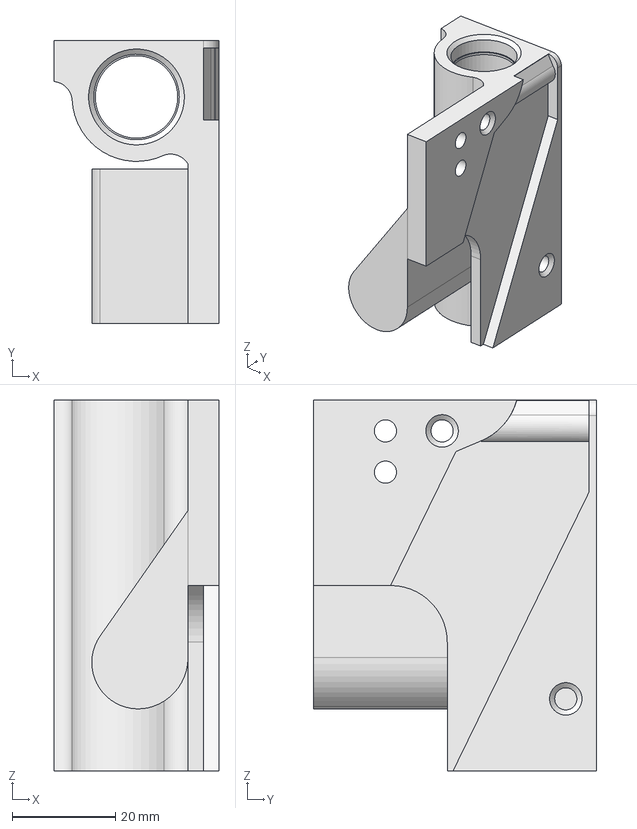
[picture p41: CAD file, 2016-11-16]
production_parts/printed_parts/upper-bearing-holder/upper-bearing-holder_black_v3.0.step
32.0 x 55.0 x 72.0 mm
