reprapperMC/mini-gladiola/production_parts/printed_parts/usb_support/usb_support_mini_v1.0.step

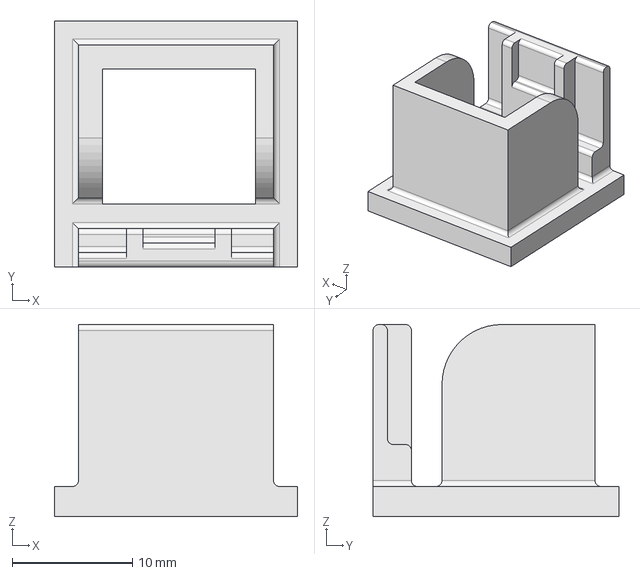
[picture p42: CAD file, 2016-11-16]
production_parts/printed_parts/usb_support/usb_support_mini_v1.0.step
20.2 x 20.5 x 16.0 mm
