reprapperMC/mini-gladiola/production_parts/printed_parts/wiper_mount/wiper_mount_v1.step

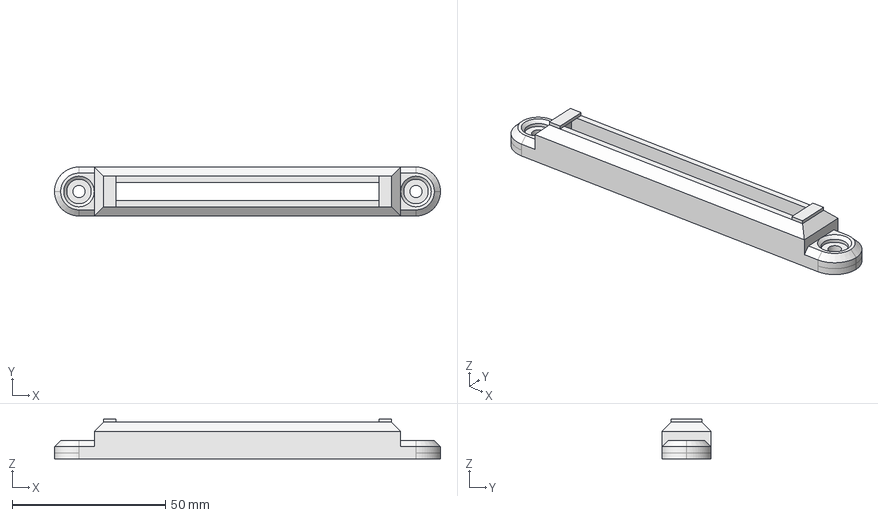
[picture p43: CAD file, 2016-11-16]
production_parts/printed_parts/wiper_mount/wiper_mount_v1.step
126.0 x 16.0 x 13.0 mm
