reprapperMC/mini-gladiola/production_parts/printed_parts/x-carriage-cap/x-carriage-cap_black_v2.5.fcstd

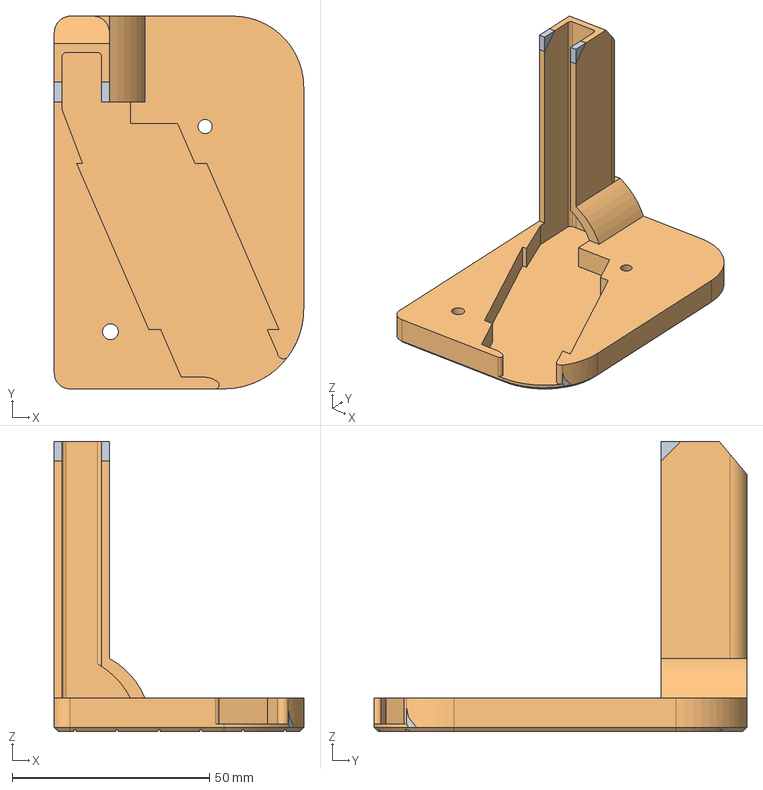
[picture p44: CAD file, 2016-12-02]
production_parts/printed_parts/x-carriage-cap/x-carriage-cap_black_v2.5.fcstd
63.2 x 94.5 x 73.5 mm
