reprapperMC/mini-gladiola/production_parts/printed_parts/x-carriage/x-carriage-mini_black_v1.1.step

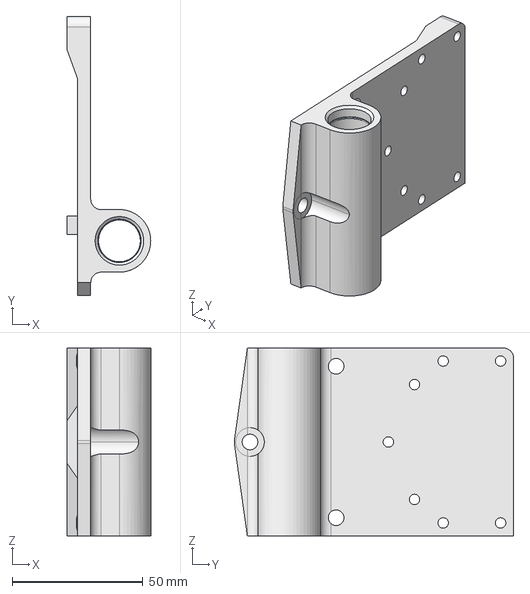
[picture p45: CAD file, 2016-11-16]
production_parts/printed_parts/x-carriage/x-carriage-mini_black_v1.1.step
32.0 x 107.0 x 72.0 mm
