reprapperMC/mini-gladiola/production_parts/printed_parts/x-end-motor/testing/CableGuideBeam-Gladiola7.stl

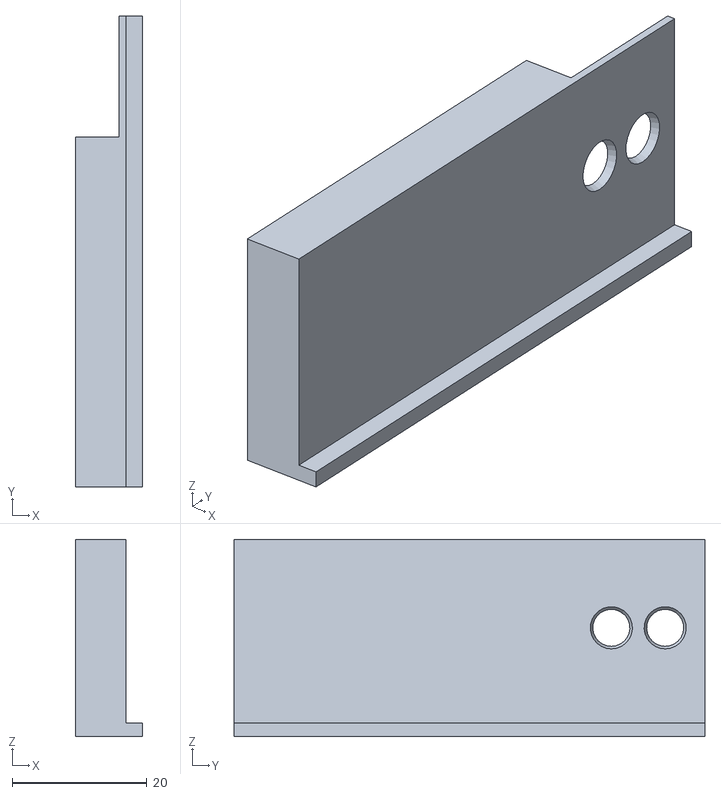
[picture p46: CAD file, 2017-07-21]
production_parts/printed_parts/x-end-motor/testing/CableGuideBeam-Gladiola7.stl
10.0 x 70.0 x 29.3
