reprapperMC/mini-gladiola/production_parts/printed_parts/x-end-motor/x-end-motor-mini_black_v2.0.step

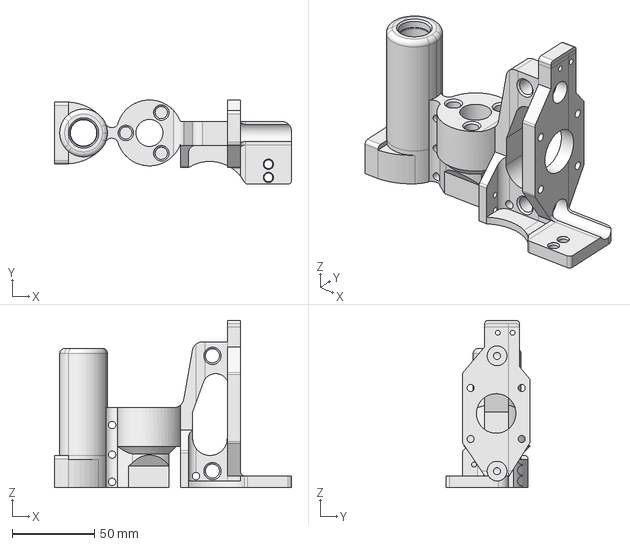
[picture p47: CAD file, 2016-11-16]
production_parts/printed_parts/x-end-motor/x-end-motor-mini_black_v2.0.step
143.9 x 51.0 x 101.5 mm
