reprapperMC/mini-gladiola/production_parts/printed_parts/x-end_idler/x-end-idler-mini_black_v2.8.step

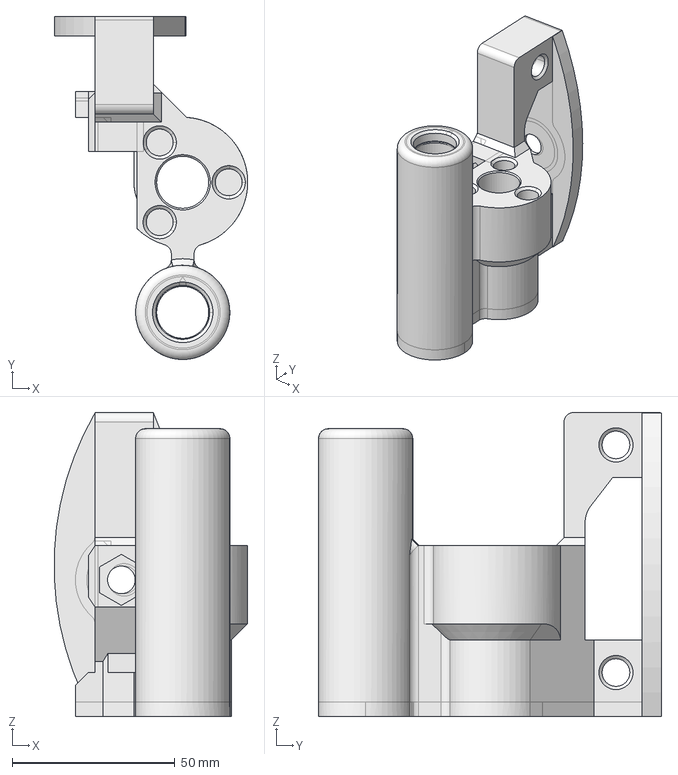
[picture p48: CAD file, 2016-11-16]
production_parts/printed_parts/x-end_idler/x-end-idler-mini_black_v2.8.step
59.5 x 105.5 x 93.5 mm
