reprapperMC/mini-gladiola/production_parts/printed_parts/x-end_motor/x_end_motor_v1.5.fcstd

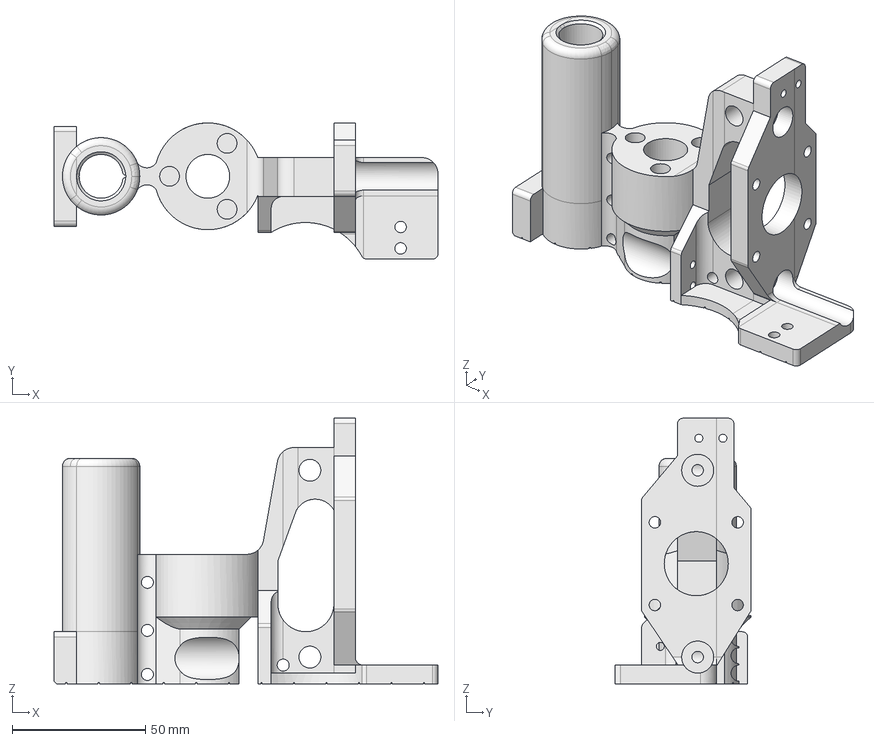
[picture p49: CAD file, 2016-06-15]
production_parts/printed_parts/x-end_motor/x_end_motor_v1.5.fcstd
143.9 x 51.0 x 99.5 mm
