reprapperMC/mini-gladiola/production_parts/printed_parts/y-idler/y-idler-mini_black_v1.4.step

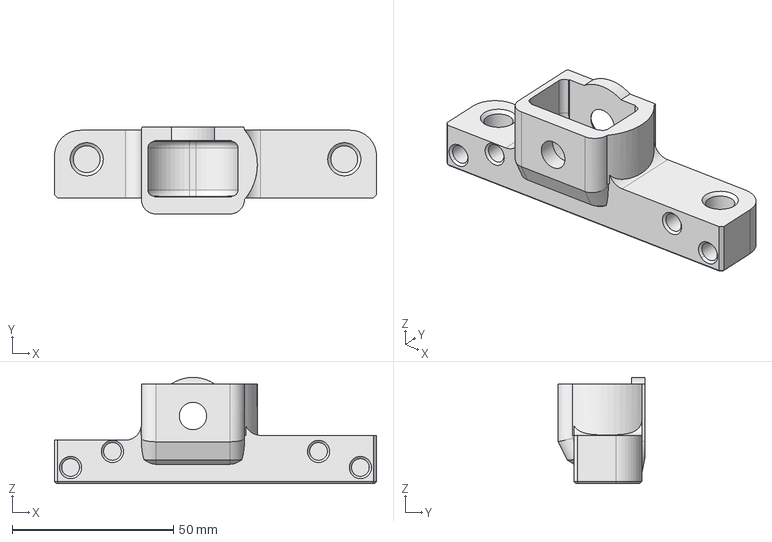
[picture p50: CAD file, 2016-11-16]
production_parts/printed_parts/y-idler/y-idler-mini_black_v1.4.step
100.0 x 27.0 x 33.0 mm
