reprapperMC/mini-gladiola/production_parts/printed_parts/y-motor-mount/y-motor-mount_black_v1.step

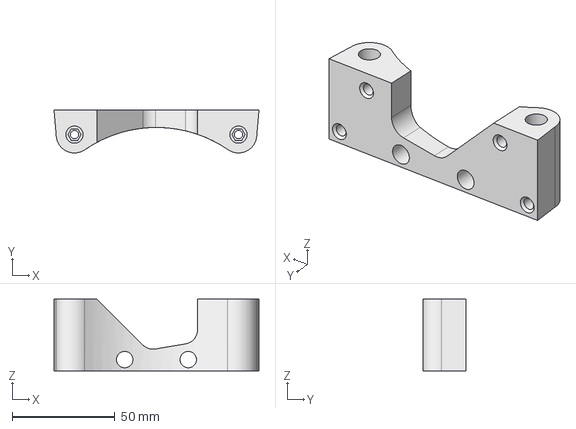
[picture p51: CAD file, 2016-11-16]
production_parts/printed_parts/y-motor-mount/y-motor-mount_black_v1.step
100.0 x 21.0 x 35.0 mm
