reprapperMC/mini-gladiola/production_parts/printed_parts/z-upper-mini-left/MiniZ-UpperLeft_24mmBearingHole.fcstd

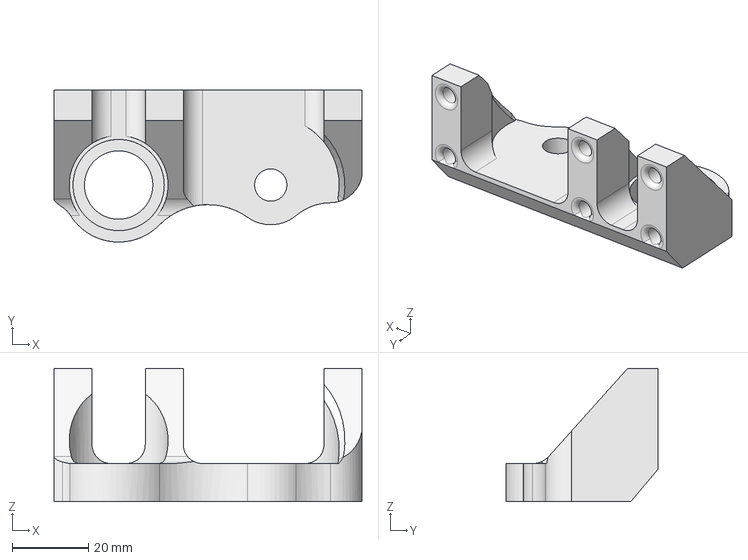
[picture p52: CAD file, 2017-08-14]
production_parts/printed_parts/z-upper-mini-left/MiniZ-UpperLeft_24mmBearingHole.fcstd
81.0 x 40.0 x 35.0 mm
