reprapperMC/mini-gladiola/sample_prints/make_test_parts/XY_resonance_test.stl

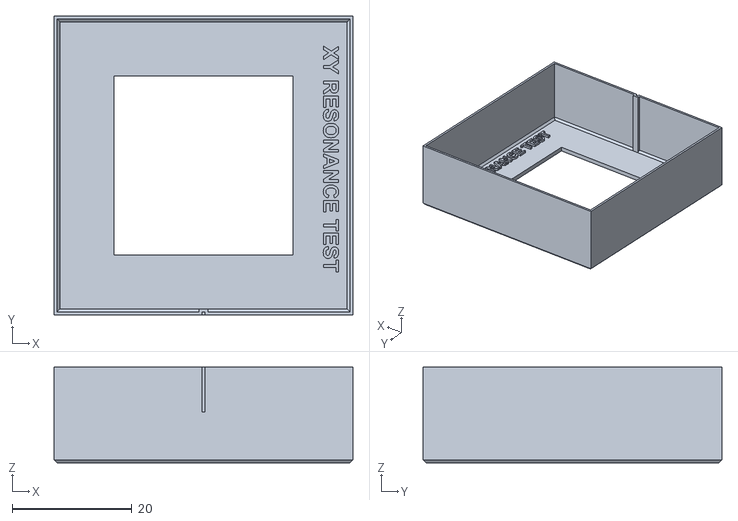
[picture p53: CAD file, 2016-05-03]
sample_prints/make_test_parts/XY_resonance_test.stl
50.0 x 50.0 x 16.0
