reprapperMC/mini-gladiola/sample_prints/oshw_keychain/logoOSHW.stl

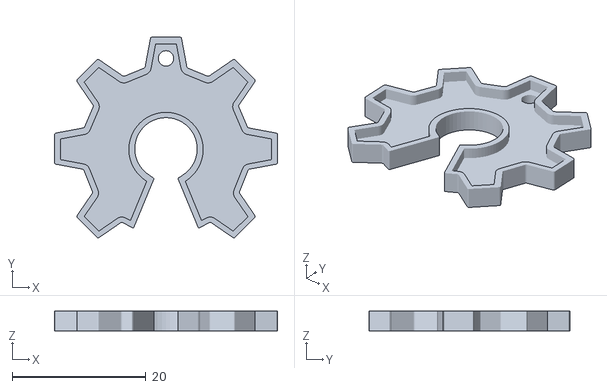
[picture p54: CAD file, 2016-05-03]
sample_prints/oshw_keychain/logoOSHW.stl
33.3 x 30.0 x 2.94
