reprapperMC/mini-gladiola/sample_prints/rocktopus/rocktopus_nsedit.stl

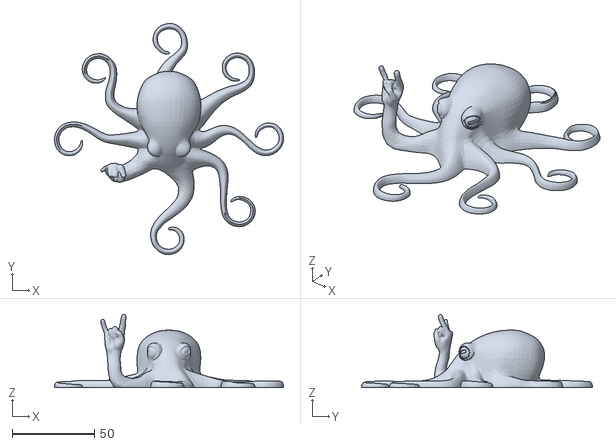
[picture p55: CAD file, 2016-11-21]
sample_prints/rocktopus/rocktopus_nsedit.stl
139.2 x 140.6 x 44.6
