reprapperMC/mini-gladiola/Assembly/assembly_parts/power_switch.fcstd

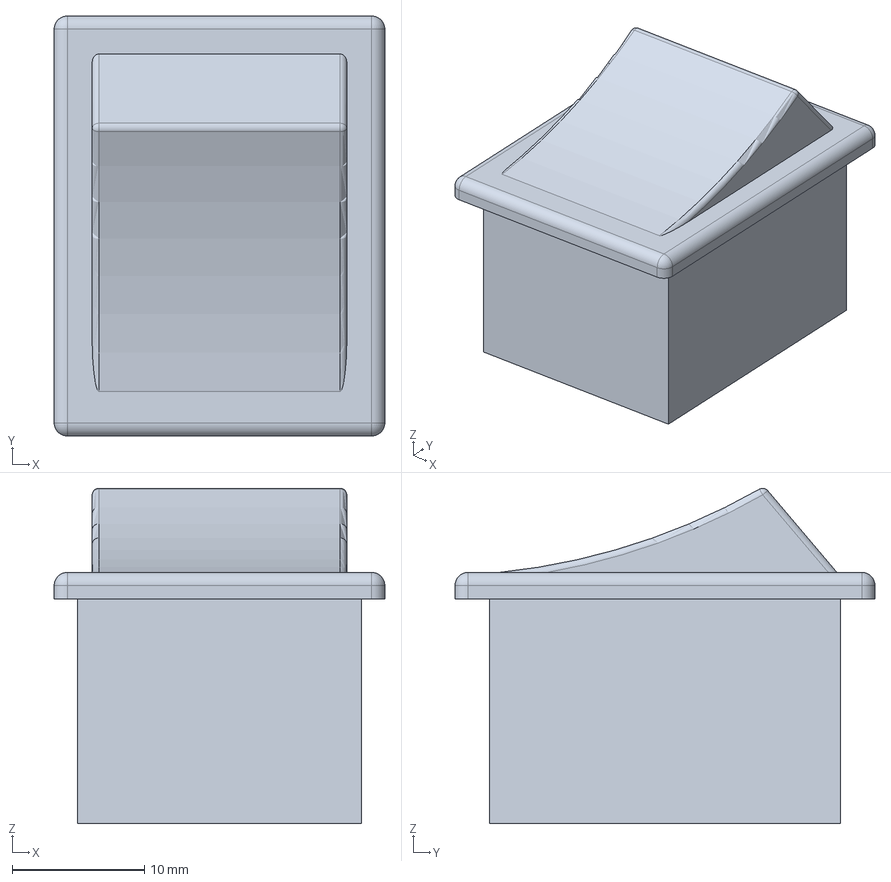
[picture p56: CAD file, 2016-11-18]
Assembly/assembly_parts/power_switch.fcstd
25.0 x 31.8 x 25.4 mm
