reprapperMC/mini-gladiola/Assembly/Changes for assembly/608ZZ_bearing.step

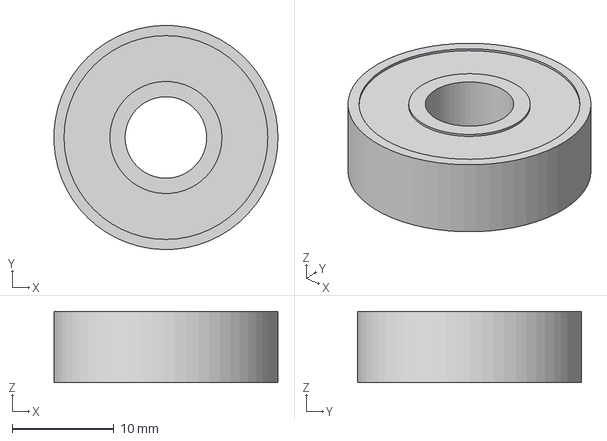
[picture p57: CAD file, 2016-11-16]
Assembly/Changes for assembly/608ZZ_bearing.step
22.0 x 22.0 x 7.00 mm
