reprapperMC/mini-gladiola/Assembly/x_idler_end_assm.fcstd

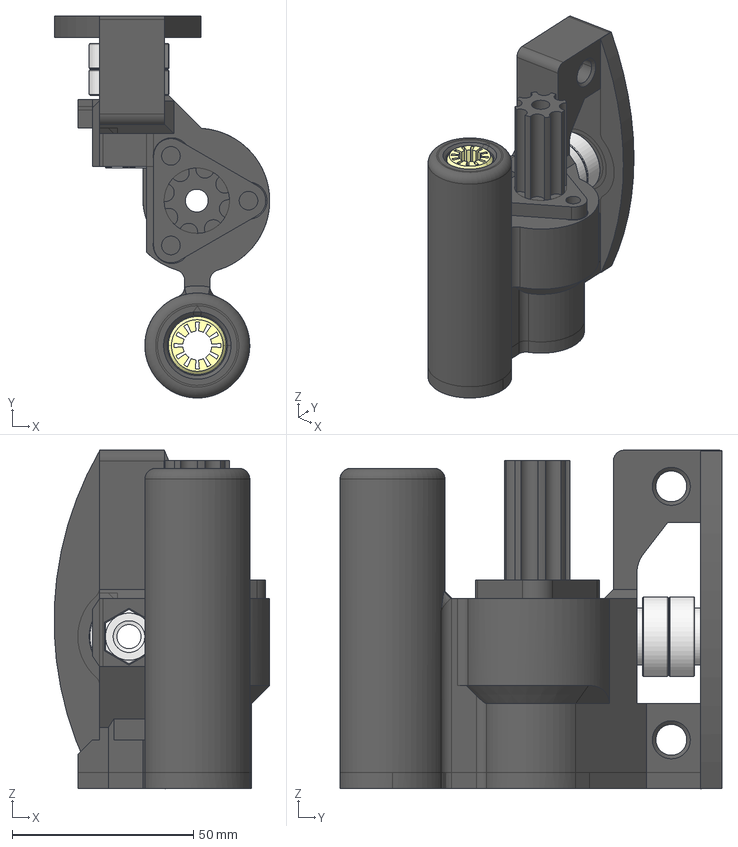
[picture p58: CAD file, 2016-11-18]
Assembly/x_idler_end_assm.fcstd
59.5 x 105.5 x 93.5 mm
x_end_idler_mini_black_v2_8_step1_01
RJM_01_08_1_stp1_01
RJM_01_08_1_stp1_02
mts10x2m_stp1_01
m8_washer_step1_01
m8_washer_step1_02
_08_bearing_step1_01
_08_bearing_step1_02
m8_nut_step1_01
