reprapperMC/mini-gladiola/production_parts/jigs/Herring6shooterTOP.stl

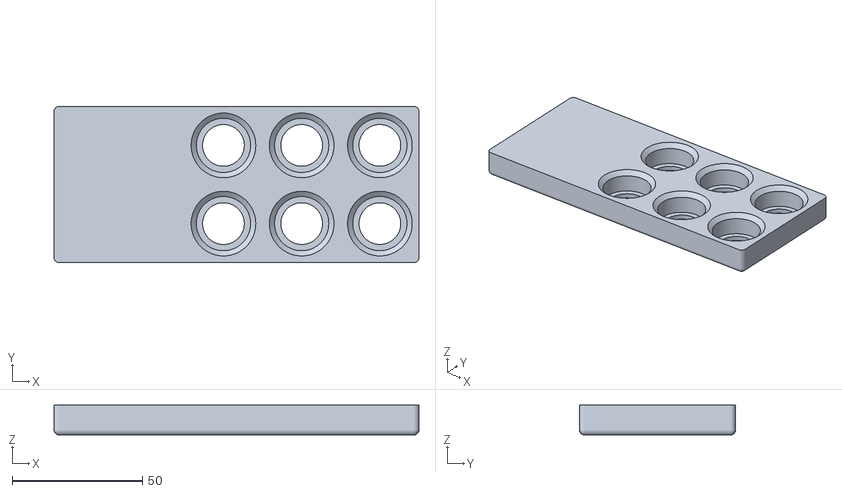
[picture p59: CAD file, 2017-08-30]
production_parts/jigs/Herring6shooterTOP.stl
140.0 x 60.0 x 11.5
