reprapperMC/mini-gladiola/production_parts/machined_parts/8_mm_rod/8x19mm_smooth_rod_revA.step

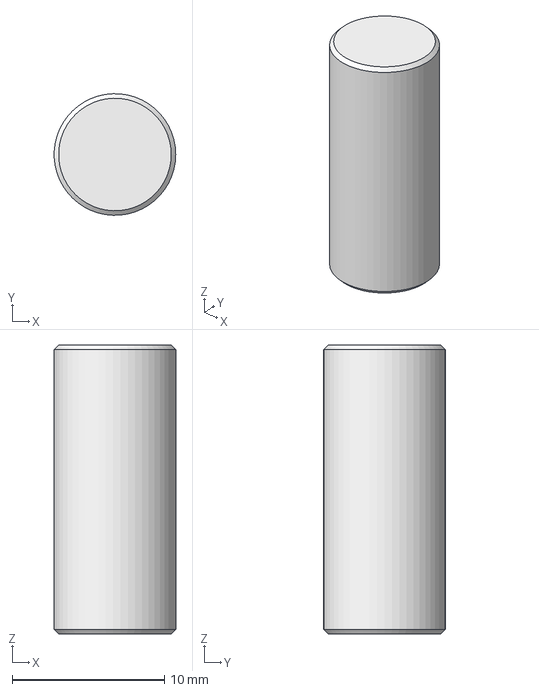
[picture p60: CAD file, 2016-11-16]
production_parts/machined_parts/8_mm_rod/8x19mm_smooth_rod_revA.step
7.99 x 8.00 x 19.0 mm
