reprapperMC/mini-gladiola/production_parts/machined_parts/bed_mount_plate/bed_mount_plate_mini_v1.2_revB.step

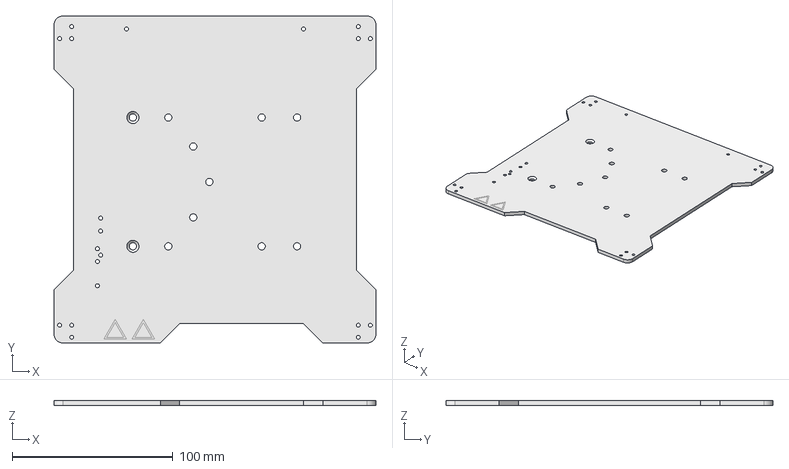
[picture p61: CAD file, 2016-08-18]
production_parts/machined_parts/bed_mount_plate/bed_mount_plate_mini_v1.2_revB.step
200.0 x 203.0 x 3.18 mm
