reprapperMC/mini-gladiola/production_parts/machined_parts/electronics_case/electronics_case_revE.step

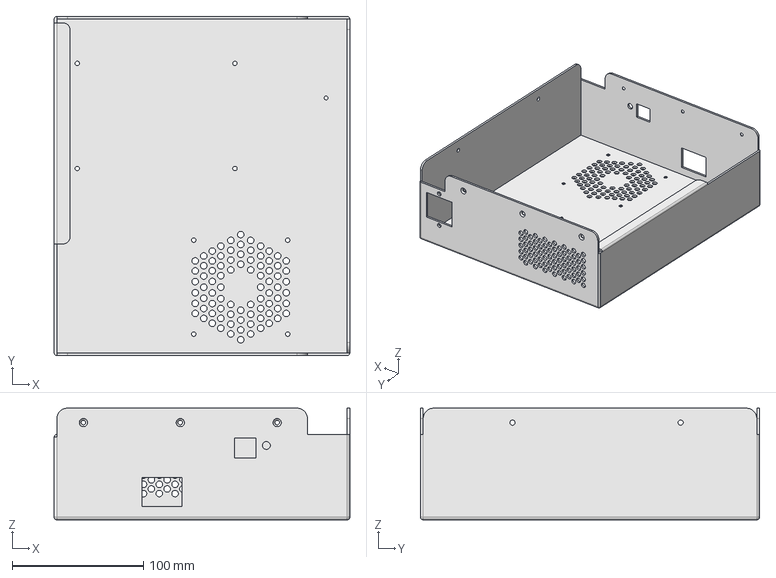
[picture p62: CAD file, 2016-08-18]
production_parts/machined_parts/electronics_case/electronics_case_revE.step
225.0 x 258.0 x 85.0 mm
