reprapperMC/mini-gladiola/production_parts/machined_parts/hexagon_hotend/STEP/Heat_Break_Tube.step

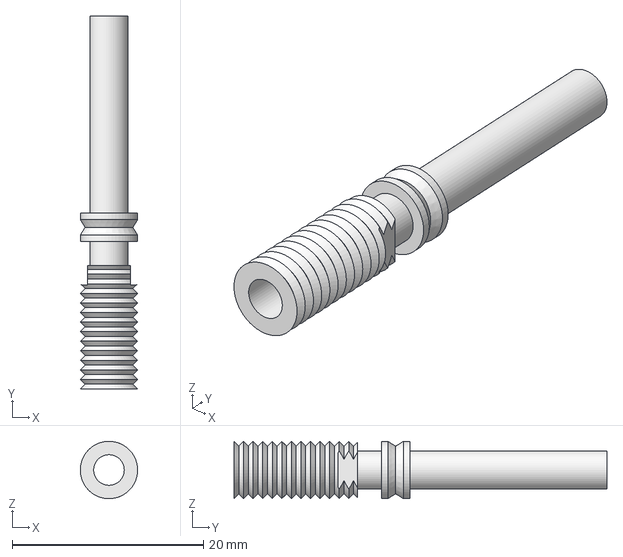
[picture p63: CAD file, 2016-05-03]
production_parts/machined_parts/hexagon_hotend/STEP/Heat_Break_Tube.step
5.99 x 39.0 x 6.00 mm
