reprapperMC/mini-gladiola/production_parts/machined_parts/top_plate_mini/top_plate_mini_v1.1_revE.step

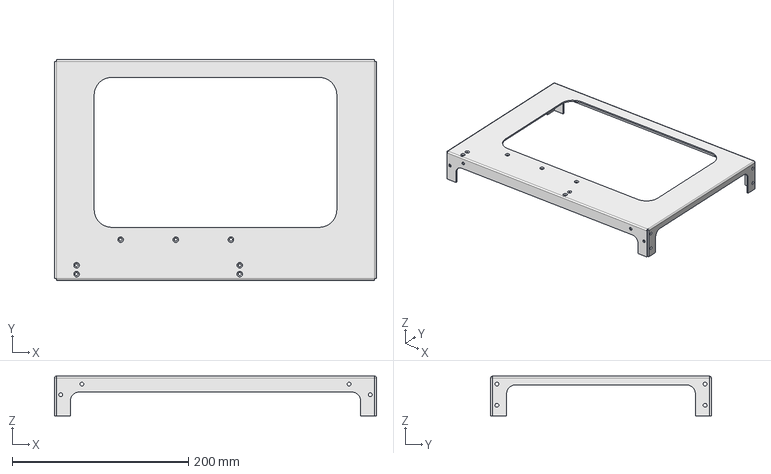
[picture p64: CAD file, 2016-08-18]
production_parts/machined_parts/top_plate_mini/top_plate_mini_v1.1_revE.step
365.0 x 250.0 x 45.0 mm
