reprapperMC/mini-gladiola/production_parts/printed_parts/spool-arm-support/spool-arm-support_black_v1.1.step

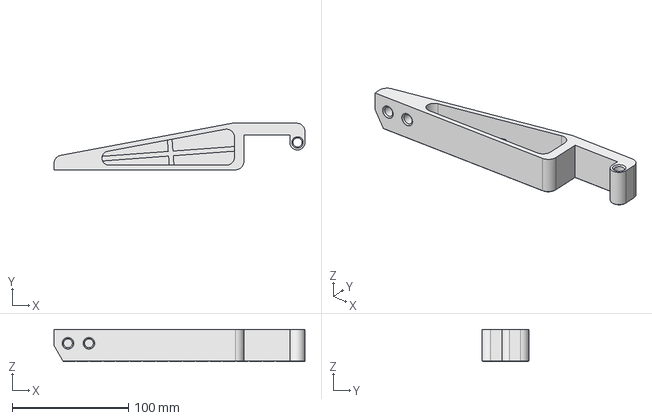
[picture p65: CAD file, 2016-11-16]
production_parts/printed_parts/spool-arm-support/spool-arm-support_black_v1.1.step
215.5 x 40.0 x 27.8 mm
