reprapperMC/mini-gladiola/production_parts/printed_parts/wiper_mount/wiper_mount_x3.stl

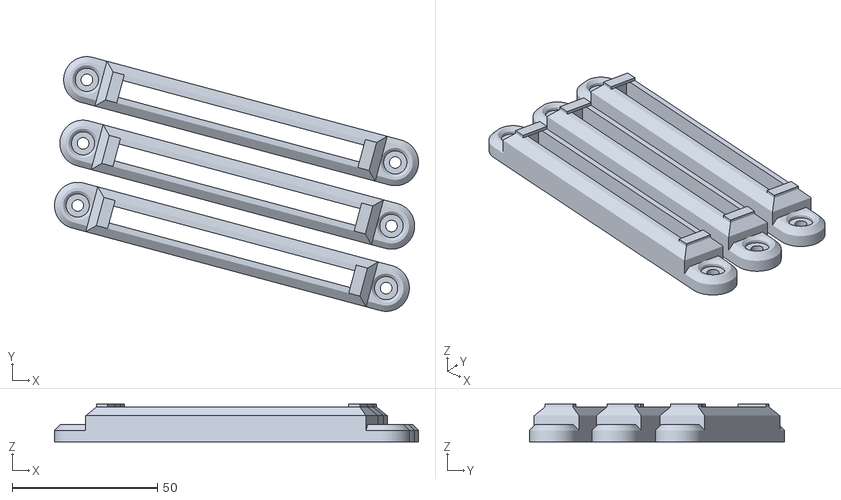
[picture p66: CAD file, 2016-09-07]
production_parts/printed_parts/wiper_mount/wiper_mount_x3.stl
125.4 x 87.8 x 13.0
