reprapperMC/mini-gladiola/production_parts/printed_parts/x-end-motor/testing/x-end-motor-mini_black_v2.2.stl

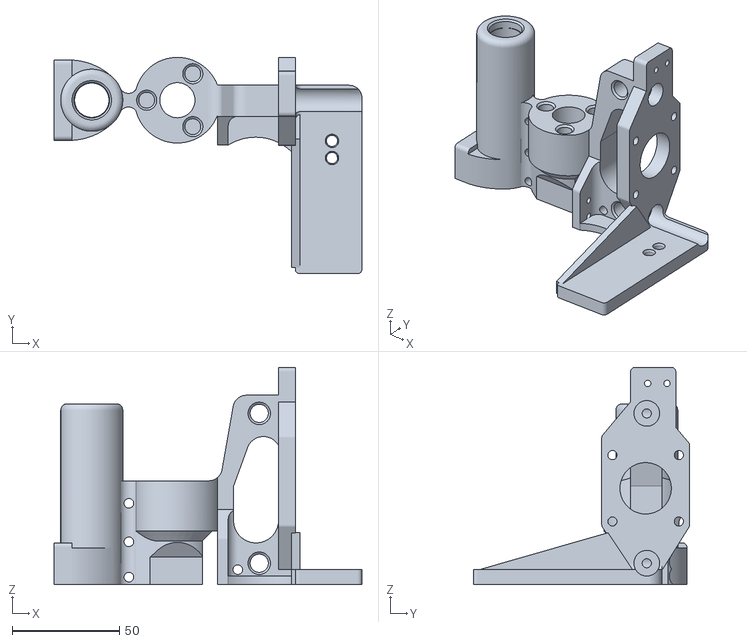
[picture p67: CAD file, 2017-07-17]
production_parts/printed_parts/x-end-motor/testing/x-end-motor-mini_black_v2.2.stl
143.9 x 101.0 x 101.5
