reprapperMC/mini-gladiola/production_parts/printed_parts/x-end_idler/x_end_idler_mini_v2.2.fcstd

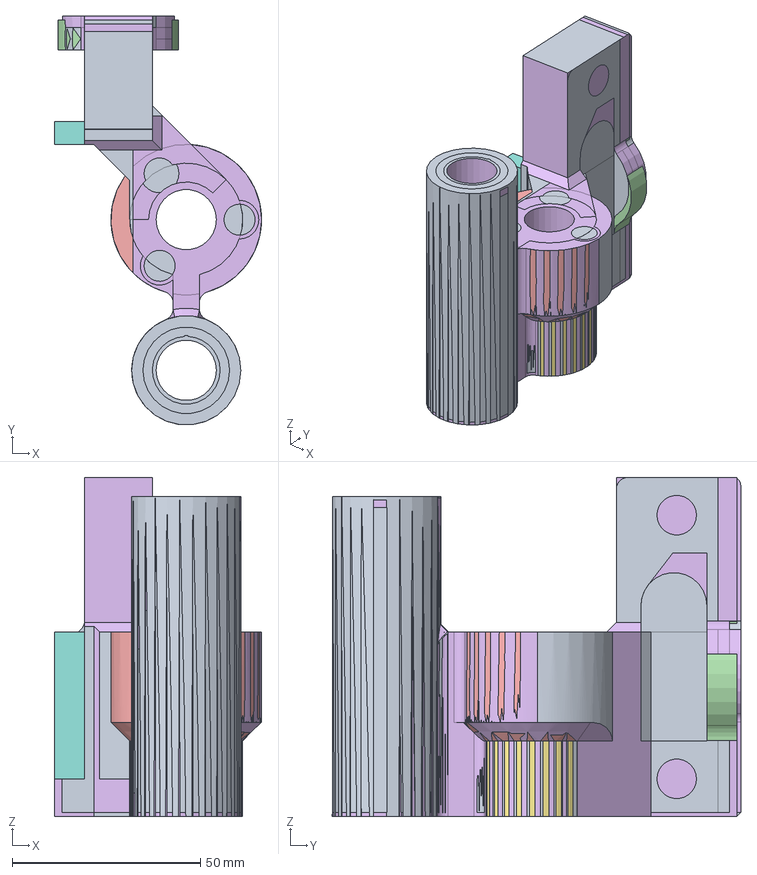
[picture p68: CAD file, 2016-06-23]
production_parts/printed_parts/x-end_idler/x_end_idler_mini_v2.2.fcstd
55.0 x 108.5 x 90.0 mm
