reprapperMC/mini-gladiola/production_parts/printed_parts/y-idler/y-idler-mini_black_v1.6.fcstd

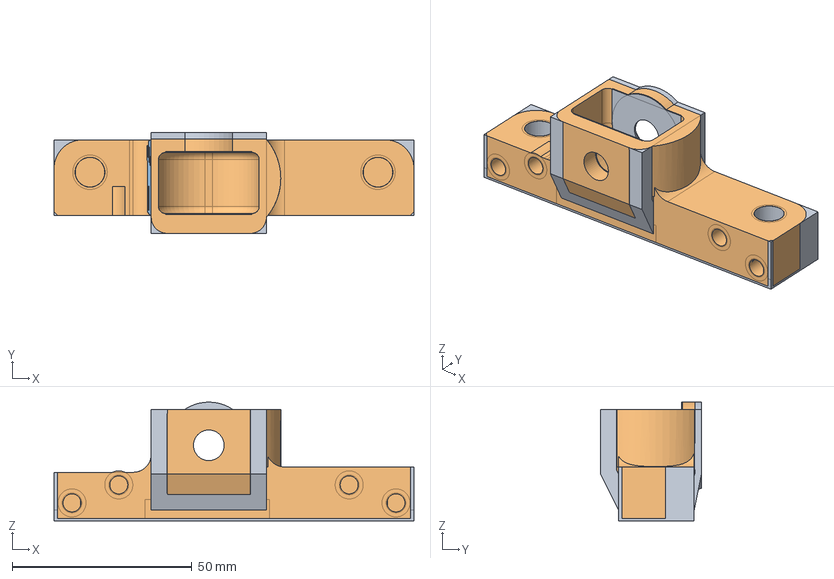
[picture p69: CAD file, 2016-11-10]
production_parts/printed_parts/y-idler/y-idler-mini_black_v1.6.fcstd
100.0 x 28.0 x 33.0 mm
