reprapperMC/mini-gladiola/production_parts/printed_parts/y-motor-mount/y-motor-mount_black_v1.4.fcstd

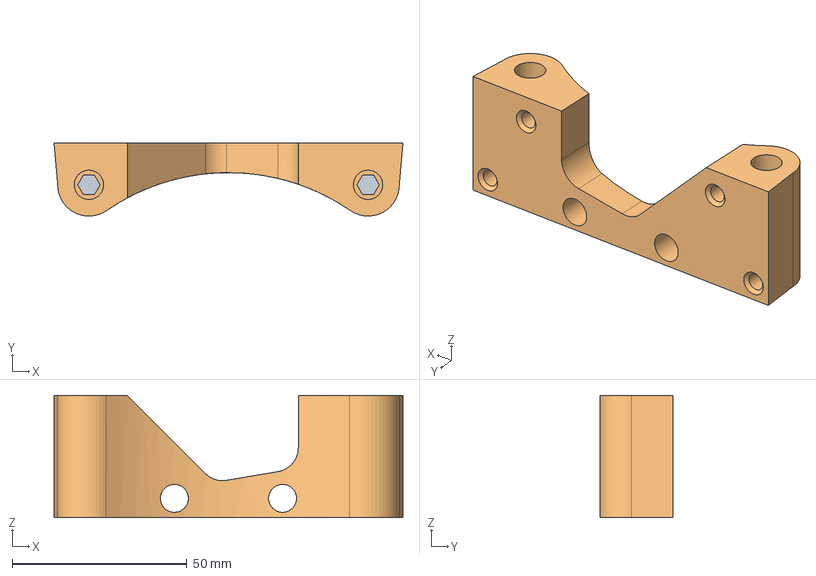
[picture p70: CAD file, 2016-09-08]
production_parts/printed_parts/y-motor-mount/y-motor-mount_black_v1.4.fcstd
100.0 x 21.0 x 35.0 mm
