reprapperMC/mini-gladiola/production_parts/printed_parts/z-upper-mini-left/z-upper-mini-left_black_v2.step

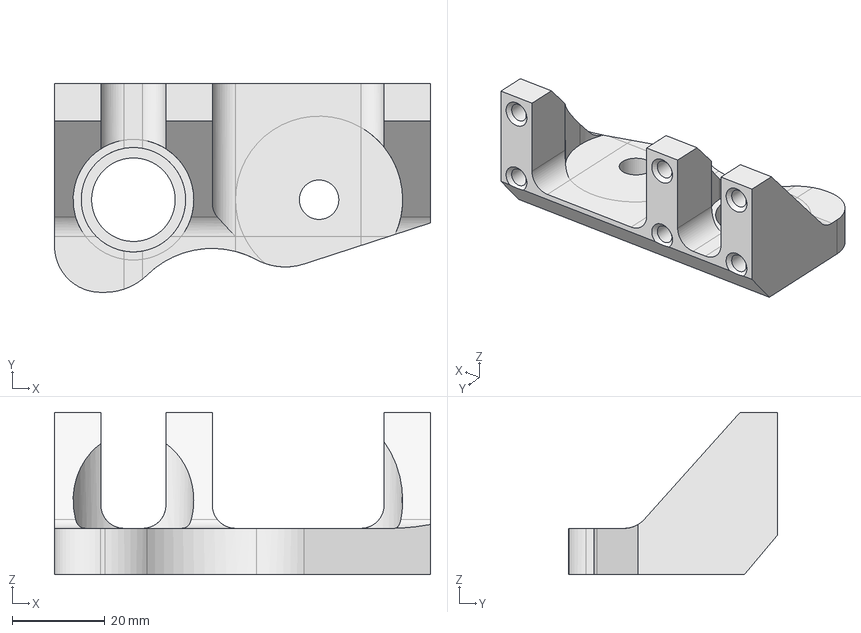
[picture p71: CAD file, 2016-11-16]
production_parts/printed_parts/z-upper-mini-left/z-upper-mini-left_black_v2.step
81.0 x 45.0 x 35.0 mm
