reprapperMC/mini-gladiola/sample_prints/make_test_parts/dimensional_accuracy_test.stl

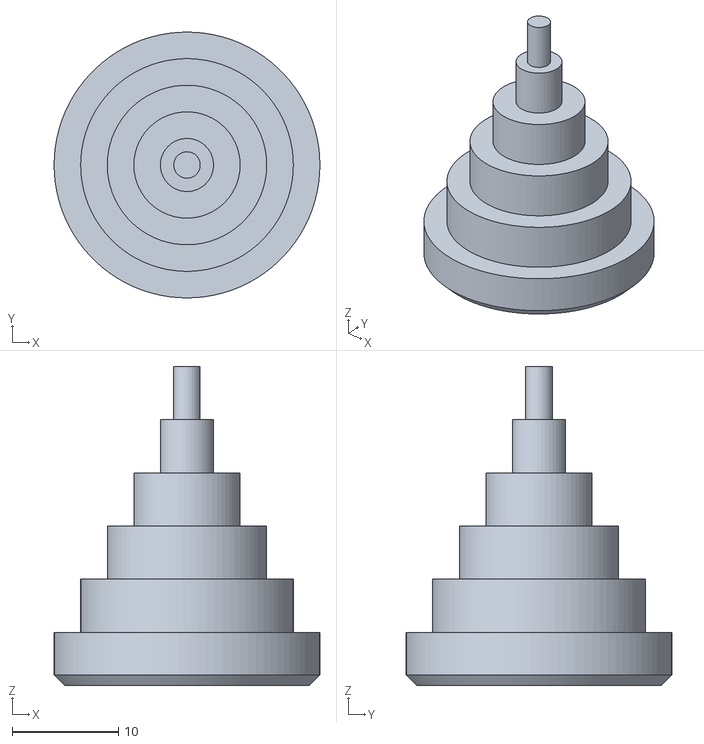
[picture p72: CAD file, 2016-05-03]
sample_prints/make_test_parts/dimensional_accuracy_test.stl
25.0 x 25.0 x 30.0
