reprapperMC/mini-gladiola/Assembly/assembly_parts/mts10x2m.stp

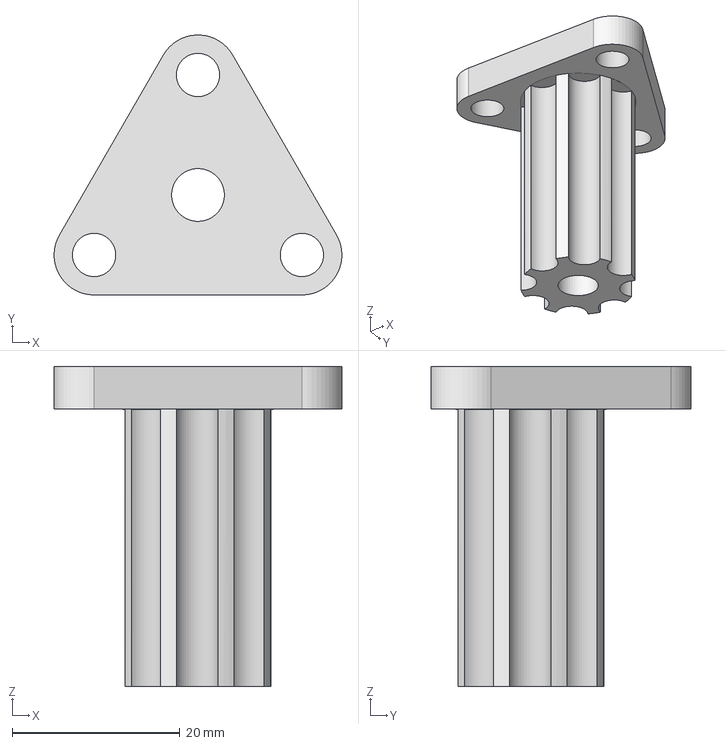
[picture p73: CAD file, 2016-11-18]
Assembly/assembly_parts/mts10x2m.stp
34.3 x 30.9 x 38.1 mm
