reprapperMC/mini-gladiola/Assembly/mini-gladiola_v1.fcstd

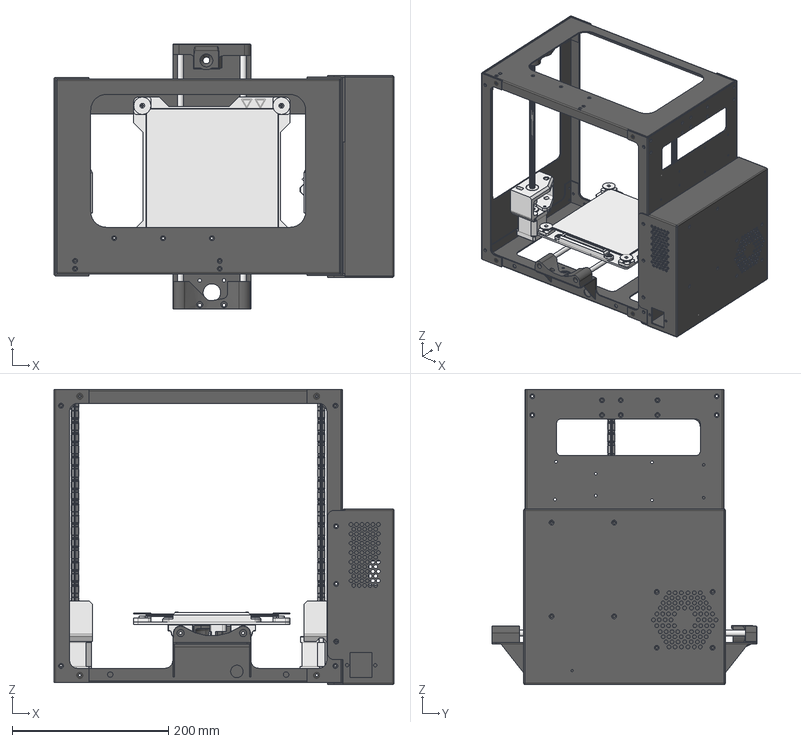
[picture p74: CAD file, 2016-11-16]
Assembly/mini-gladiola_v1.fcstd
435.0 x 339.0 x 378.0 mm
bottom_plate_mini_PP_MP0149_revB_step1_01
top_plate_mini_PP_FP0051_revF_step1_01
y_motor_mount_black_v1_step1_01
y_idler_mini_black_v1_4_step1_01
left_side_mini_PP_FP0055_revH_step1_01
right_side_mini_PP_FP0052_revF_step1_01
Y_Axis_01
electronics_case_mini_PP_FP0082_revG_step1_01
lower_z_right_mini_lulz_green_v1_6_step1_01
lower_z_left_mini_lulz_green_v1_6_step1_01
NEMA17_step1_01
NEMA17_step1_002
z_coupler_step1_01
_27_bearing_step1_01
_27_bearing_step1_002
z_coupler_step1_002
drive_rod_10mm_mini_full_length_step1_01
drive_rod_10mm_mini_full_length_step1_002
_27_bearing_step1_01002
_27_bearing_step1_01003
z_upper_mini_left_black_v2_step1_01
z_upper_mini_right_black_v2_0_step1_01
