reprapperMC/mini-gladiola/production_parts/jigs/HerringBone6shooterTOP.fcstd

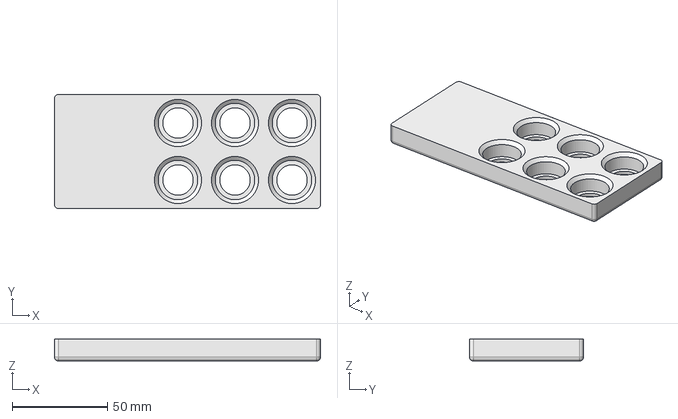
[picture p75: CAD file, 2017-08-30]
production_parts/jigs/HerringBone6shooterTOP.fcstd
140.0 x 60.0 x 11.5 mm
