reprapperMC/mini-gladiola/production_parts/printed_parts/wiper_mount/wiper_mount_v1.1-x3.stl

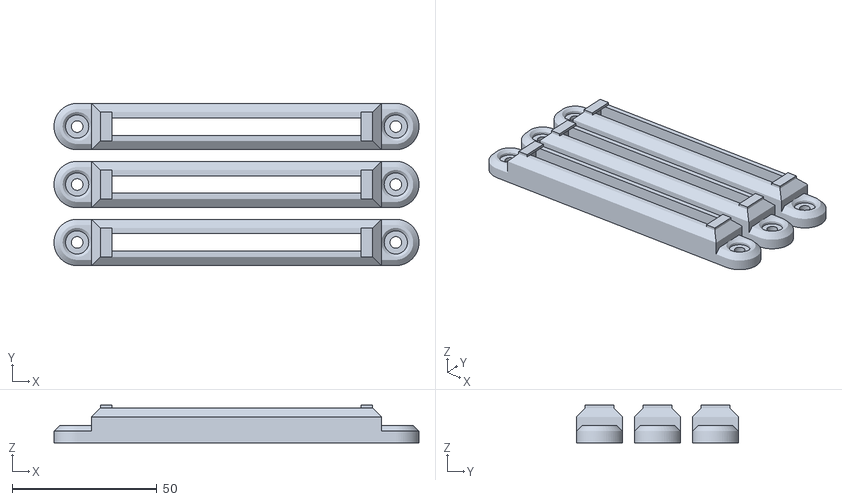
[picture p76: CAD file, 2016-06-22]
production_parts/printed_parts/wiper_mount/wiper_mount_v1.1-x3.stl
126.0 x 56.0 x 13.0
