reprapperMC/mini-gladiola/production_parts/printed_parts/z-upper-mini-left/z-upper-mini-left_black_v2.0.fcstd

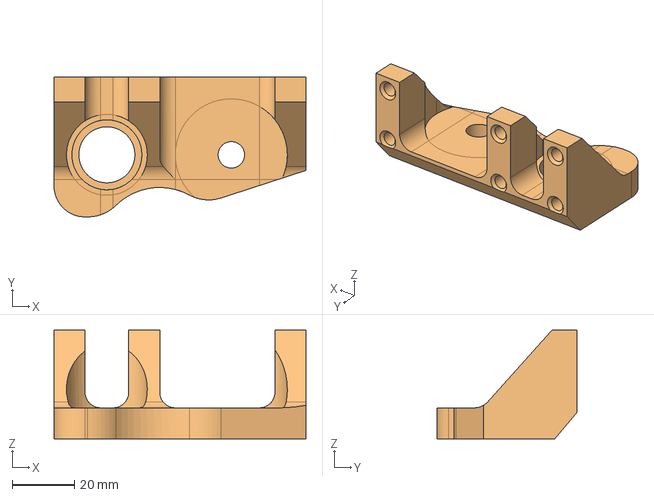
[picture p77: CAD file, 2016-10-07]
production_parts/printed_parts/z-upper-mini-left/z-upper-mini-left_black_v2.0.fcstd
81.0 x 45.0 x 35.0 mm
