reprapperMC/mini-gladiola/sample_prints/make_test_parts/overhang_test.stl

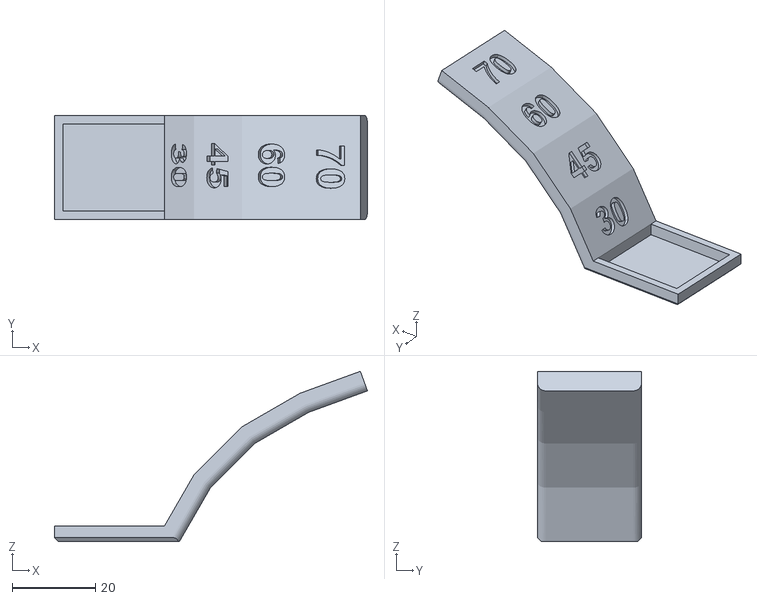
[picture p78: CAD file, 2016-05-03]
sample_prints/make_test_parts/overhang_test.stl
75.2 x 25.0 x 40.9
