reprapperMC/mini-gladiola/production_parts/jigs/Gladiola_y_rod_mount_insert_jig_0.2.stl

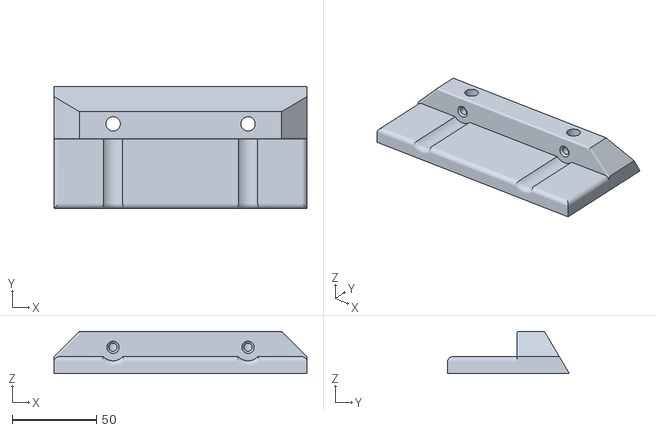
[picture p79: CAD file, 2017-06-21]
production_parts/jigs/Gladiola_y_rod_mount_insert_jig_0.2.stl
150.0 x 72.2 x 25.0
