reprapperMC/mini-gladiola/production_parts/machined_parts/hexagon_hotend/STEP/Retention_Plate_v2.step

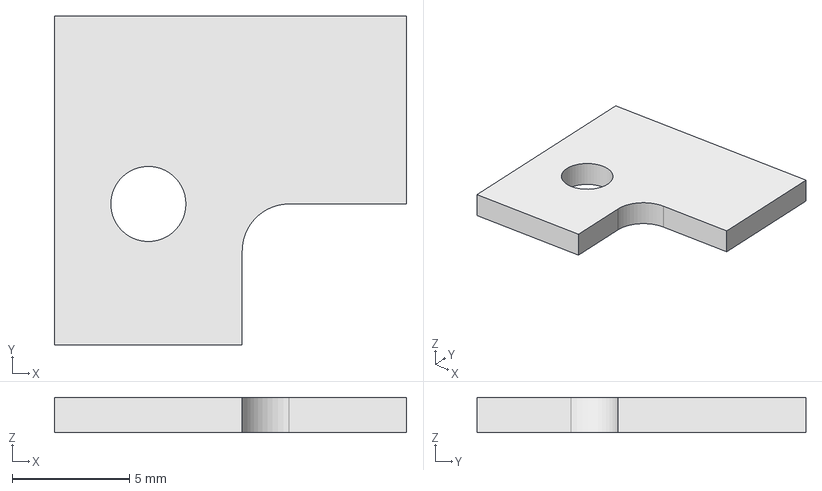
[picture p80: CAD file, 2016-05-03]
production_parts/machined_parts/hexagon_hotend/STEP/Retention_Plate_v2.step
15.0 x 14.0 x 1.50 mm
