reprapperMC/mini-gladiola/sample_prints/make_test_parts/XY_resonance_1.0mm_walls.stl

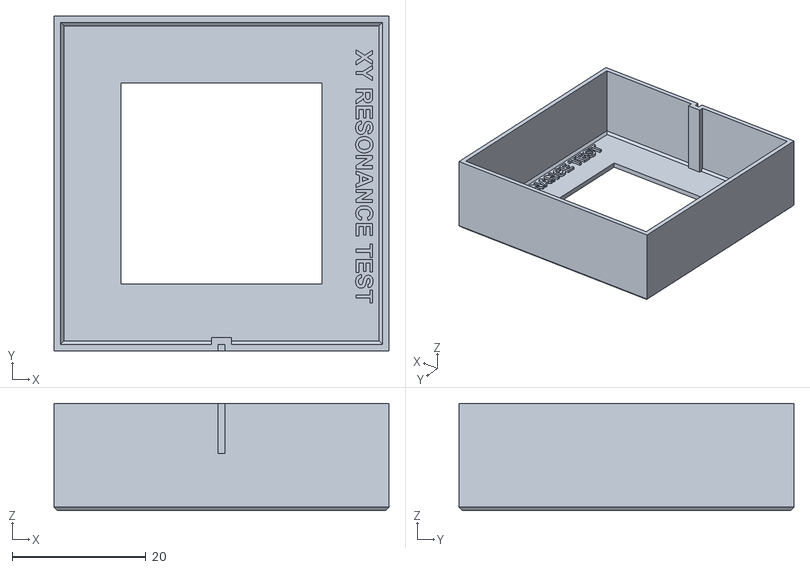
[picture p81: CAD file, 2016-05-03]
sample_prints/make_test_parts/XY_resonance_1.0mm_walls.stl
50.0 x 50.0 x 16.0
