reprapperMC/mini-gladiola/Assembly/assembly_parts/z_coupler.step

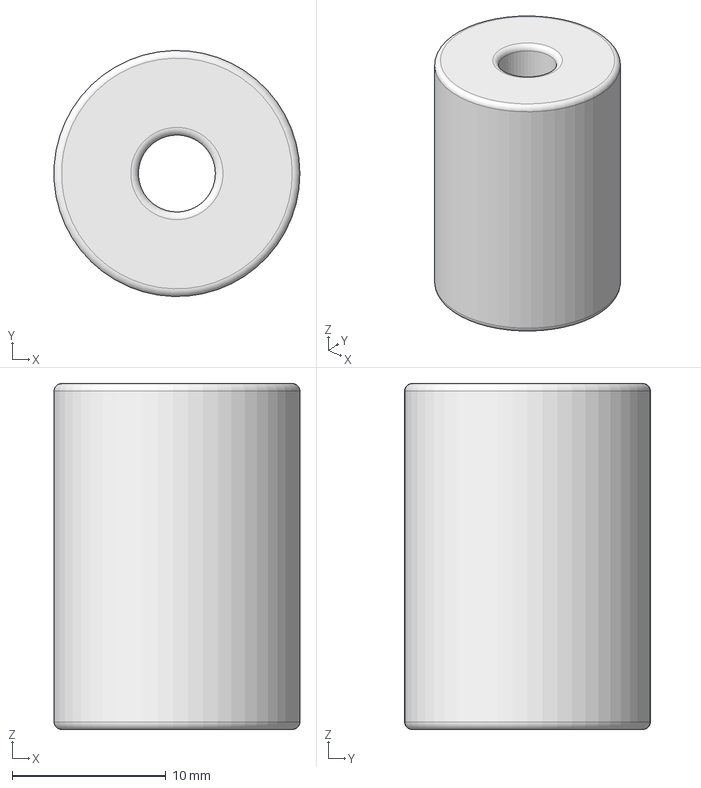
[picture p82: CAD file, 2016-11-16]
Assembly/assembly_parts/z_coupler.step
16.0 x 16.0 x 22.5 mm
