reprapperMC/mini-gladiola/Assembly/Y-Axis.fcstd

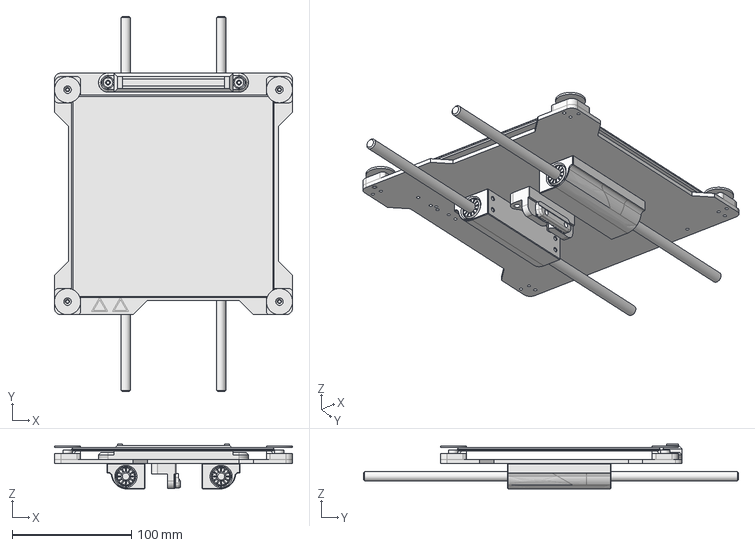
[picture p83: CAD file, 2016-11-16]
Assembly/Y-Axis.fcstd
200.0 x 315.0 x 37.7 mm
bed_mount_plate_mini_PP_MP0146_revC_step1_01
muxedAssembly
