reprapperMC/mini-gladiola/production_parts/jigs/glad_y_rod_mount_insertion_jig.fcstd

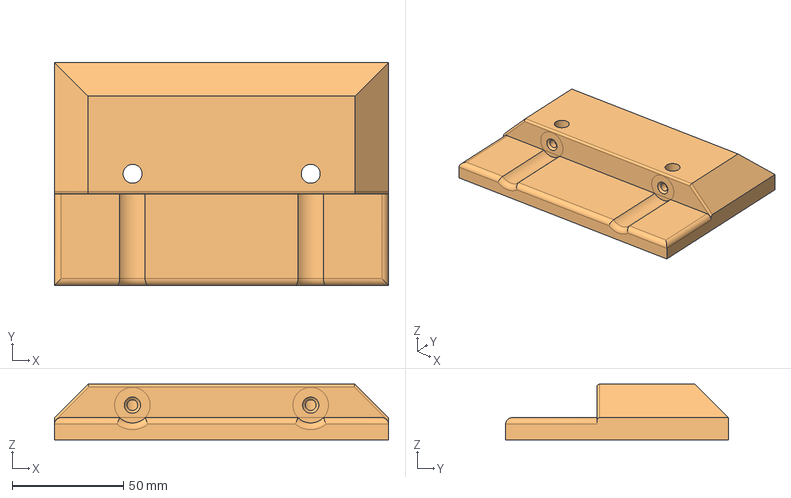
[picture p84: CAD file, 2017-06-19]
production_parts/jigs/glad_y_rod_mount_insertion_jig.fcstd
150.0 x 100.0 x 25.0 mm
