reprapperMC/mini-gladiola/production_parts/machined_parts/hexagon_hotend/STEP/Mounting_plate.step

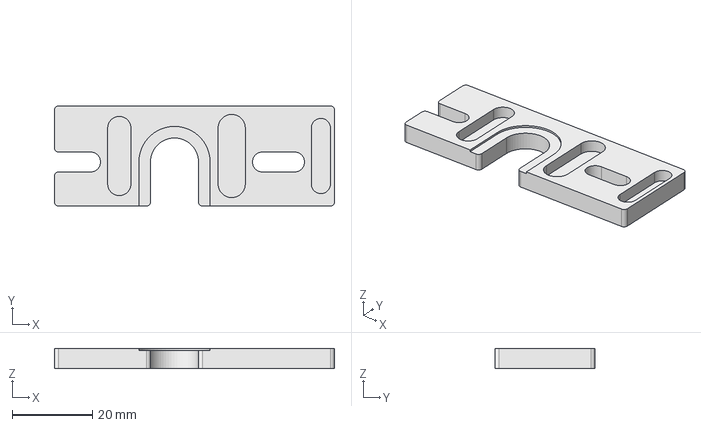
[picture p85: CAD file, 2016-05-03]
production_parts/machined_parts/hexagon_hotend/STEP/Mounting_plate.step
70.0 x 25.0 x 5.00 mm
