reprapperMC/mini-gladiola/sample_prints/make_test_parts/Z_resonance_test.stl

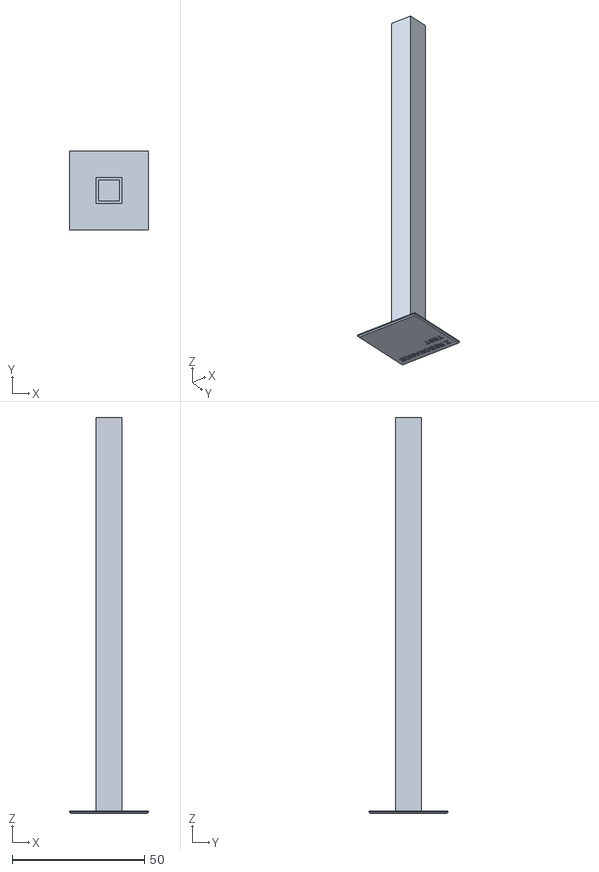
[picture p86: CAD file, 2016-05-03]
sample_prints/make_test_parts/Z_resonance_test.stl
30.0 x 30.0 x 150.0
