reprapperMC/mini-gladiola/Assembly/Beltmount_Clamp.fcstd

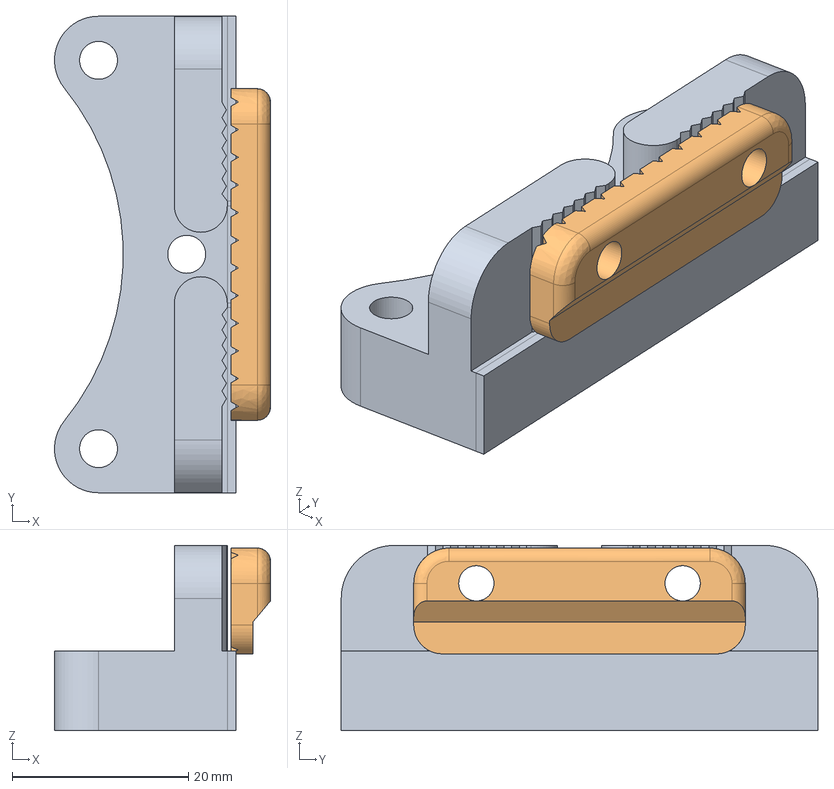
[picture p87: CAD file, 2016-11-16]
Assembly/Beltmount_Clamp.fcstd
24.5 x 54.0 x 21.0 mm
belt_mount_black_v1_1_step1_01
belt_clamp_black_v1_1_step1_01
