reprapperMC/mini-gladiola/production_parts/jigs/Gladiola_y_rod_mount_insert_jig.stl

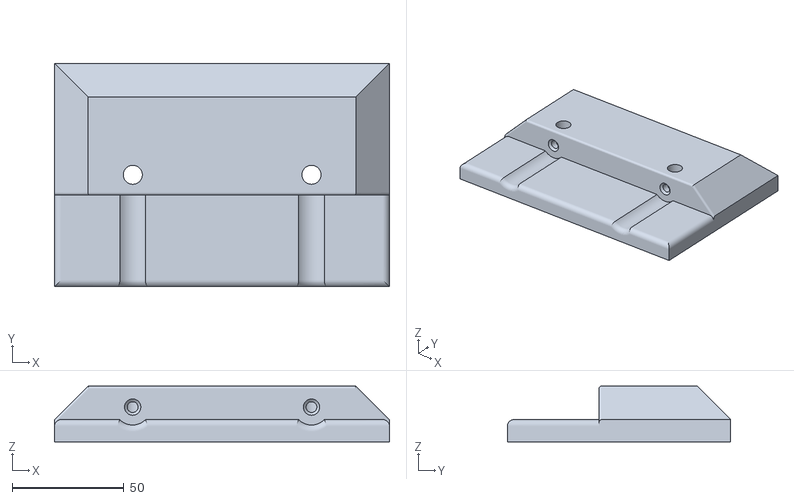
[picture p88: CAD file, 2017-06-19]
production_parts/jigs/Gladiola_y_rod_mount_insert_jig.stl
150.0 x 100.0 x 25.0
