reprapperMC/mini-gladiola/production_parts/machined_parts/hexagon_hotend/STEP/Heater_Block_16_x_18_x_27.step

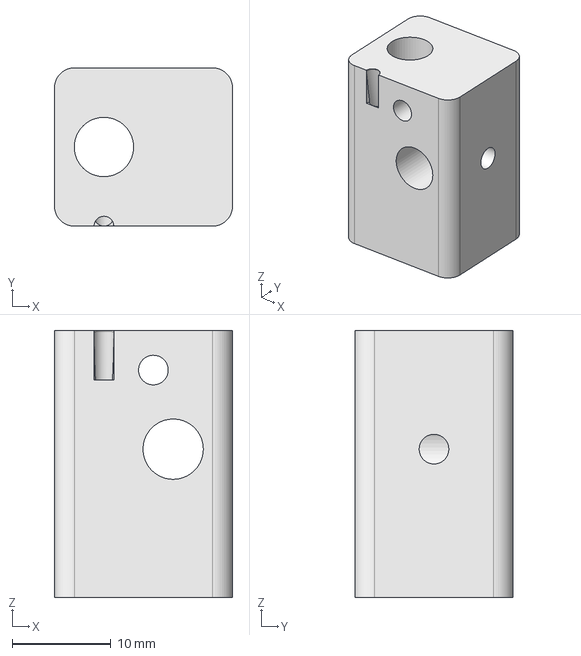
[picture p89: CAD file, 2016-05-03]
production_parts/machined_parts/hexagon_hotend/STEP/Heater_Block_16_x_18_x_27.step
18.0 x 16.0 x 27.0 mm
