reprapperMC/mini-gladiola/sample_prints/make_test_parts/fine_positive_features.stl

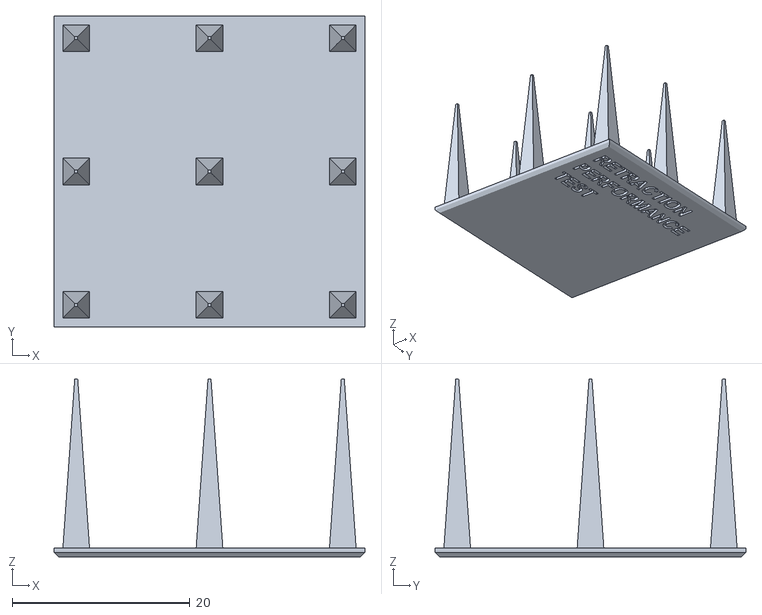
[picture p90: CAD file, 2016-05-03]
sample_prints/make_test_parts/fine_positive_features.stl
35.0 x 35.0 x 20.0
