reprapperMC/mini-gladiola/production_parts/jigs/EL-HR0180_80mm_spacer.fcstd

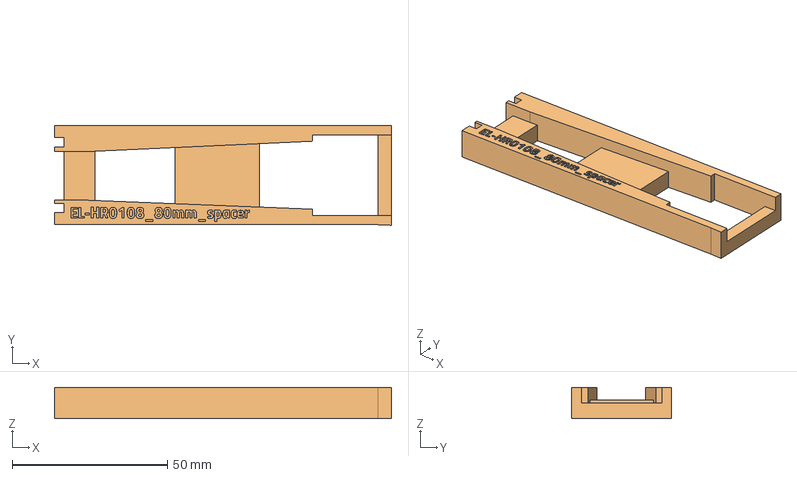
[picture p91: CAD file, 2016-11-23]
production_parts/jigs/EL-HR0180_80mm_spacer.fcstd
108.4 x 32.0 x 10.0 mm
