reprapperMC/mini-gladiola/production_parts/machined_parts/hexagon_hotend/STEP/Cooling_Block_3mm_short.step

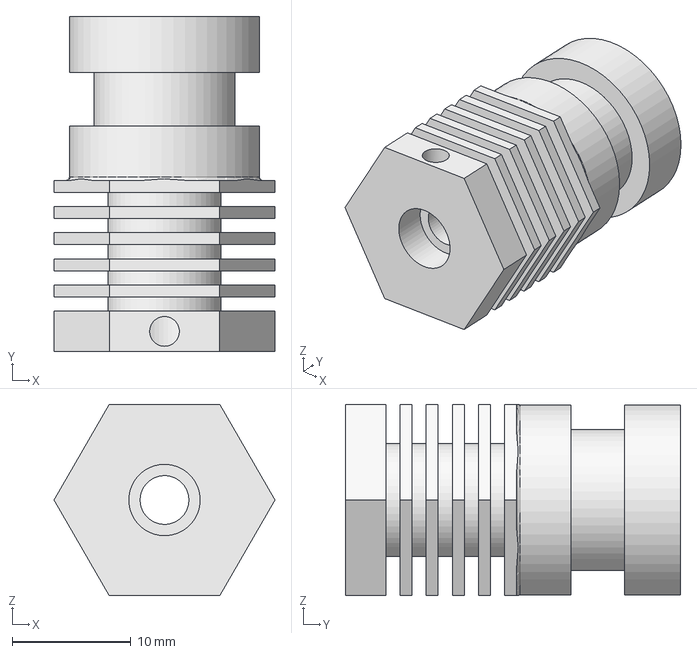
[picture p92: CAD file, 2016-05-03]
production_parts/machined_parts/hexagon_hotend/STEP/Cooling_Block_3mm_short.step
18.6 x 28.2 x 16.1 mm
