reprapperMC/mini-gladiola/sample_prints/make_test_parts/bridging_test.stl

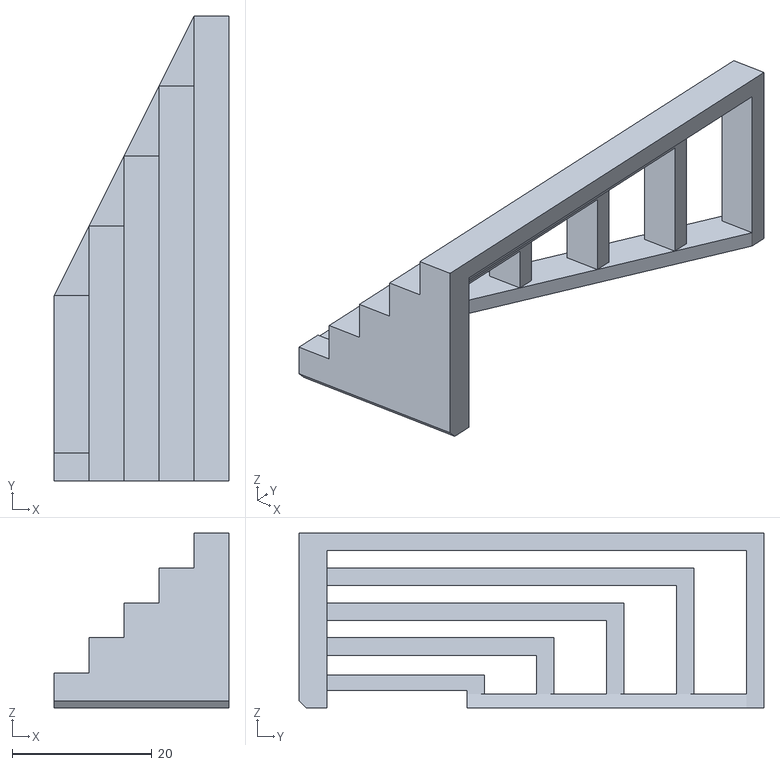
[picture p93: CAD file, 2016-05-03]
sample_prints/make_test_parts/bridging_test.stl
25.0 x 66.5 x 25.0
