reprapperMC/mini-gladiola/Assembly/assembly_parts/12mm_drive_rod.fcstd

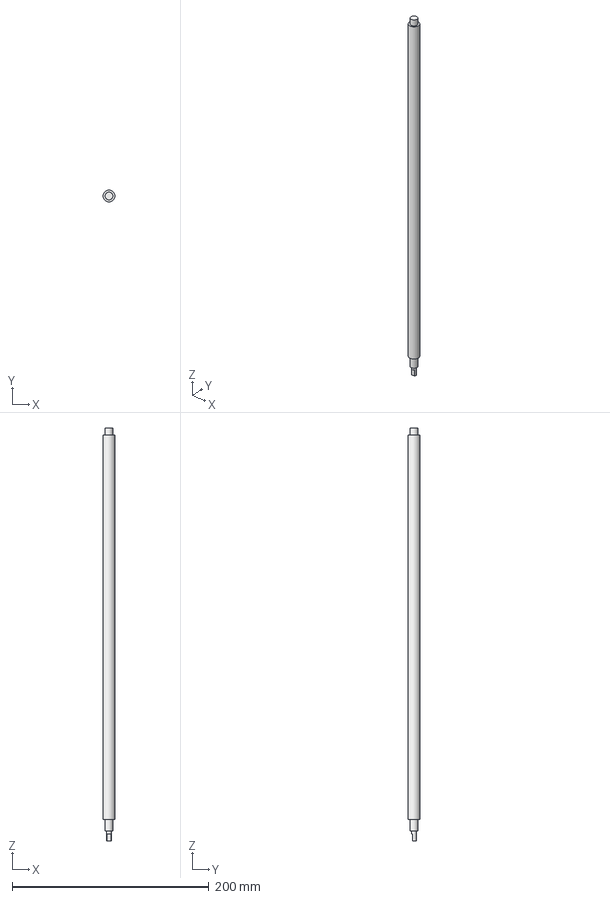
[picture p94: CAD file, 2016-11-16]
Assembly/assembly_parts/12mm_drive_rod.fcstd
12.0 x 12.0 x 420.0 mm
