reprapperMC/mini-gladiola/production_parts/jigs/EL-HR0108_80mm_spacer.stl

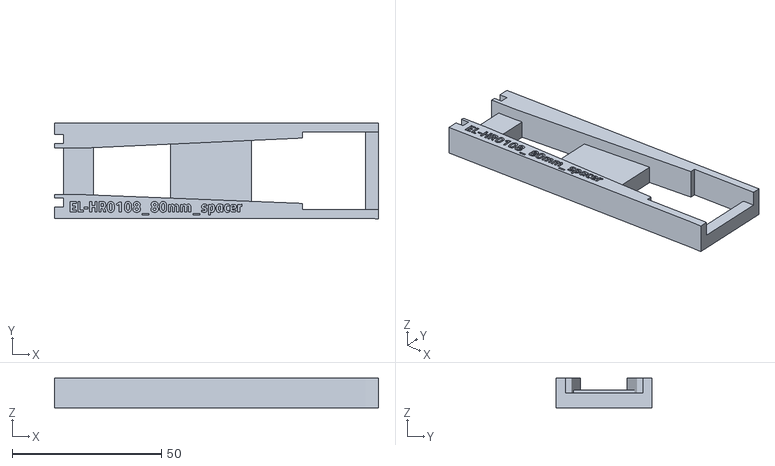
[picture p95: CAD file, 2016-11-23]
production_parts/jigs/EL-HR0108_80mm_spacer.stl
108.4 x 32.0 x 10.0
