reprapperMC/mini-gladiola/production_parts/machined_parts/hexagon_hotend/STEP/Heater_Block_16_x_18_x_17.step

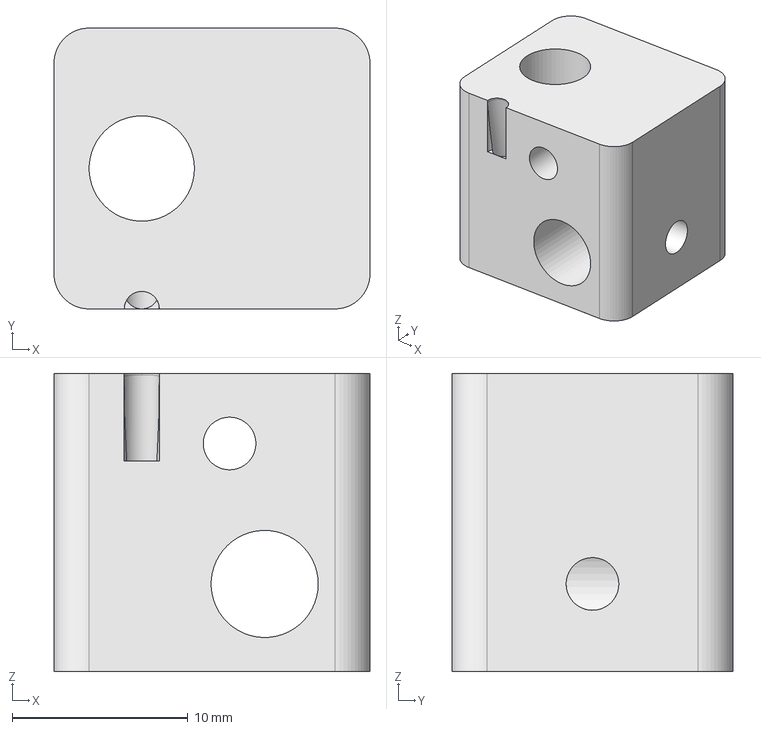
[picture p96: CAD file, 2016-05-03]
production_parts/machined_parts/hexagon_hotend/STEP/Heater_Block_16_x_18_x_17.step
18.0 x 16.0 x 17.0 mm
