reprapperMC/mini-gladiola/sample_prints/make_test_parts/negative_space_tolerance_test.stl

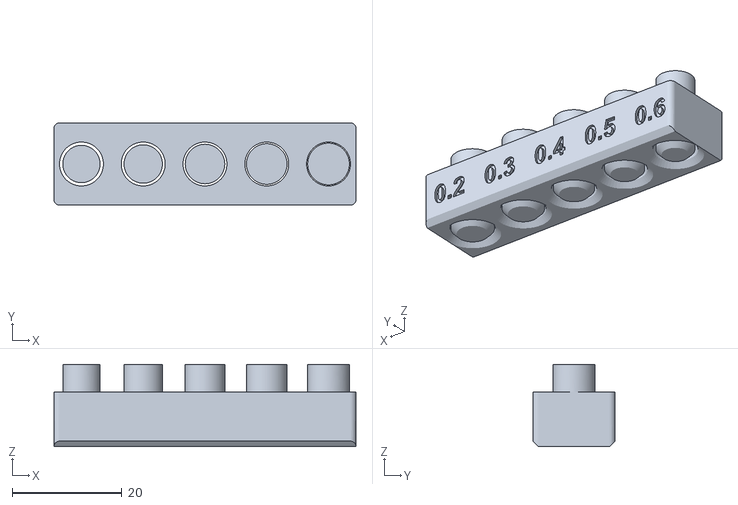
[picture p97: CAD file, 2016-05-03]
sample_prints/make_test_parts/negative_space_tolerance_test.stl
55.0 x 15.0 x 15.0
