reprapperMC/mini-gladiola/production_parts/jigs/X-MIN_WRAP_JIG.fcstd

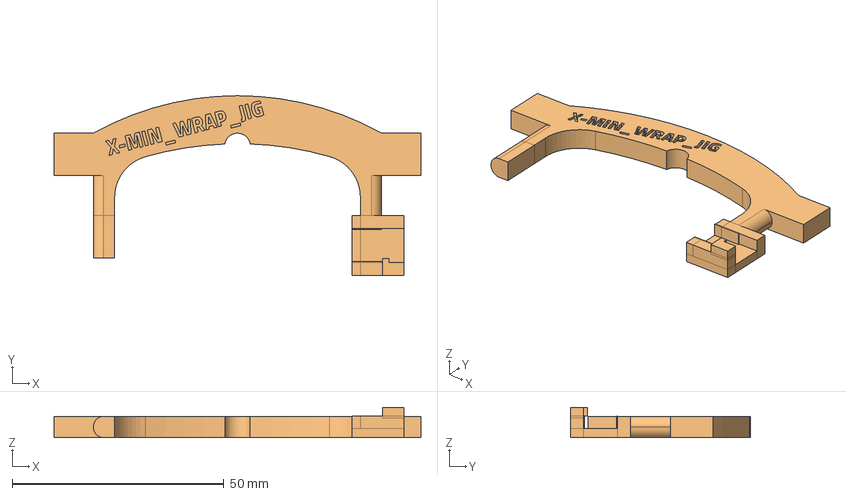
[picture p98: CAD file, 2016-11-23]
production_parts/jigs/X-MIN_WRAP_JIG.fcstd
86.6 x 42.4 x 7.14 mm
