reprapperMC/mini-gladiola/production_parts/machined_parts/hexagon_hotend/STEP/Nozzle_long.step

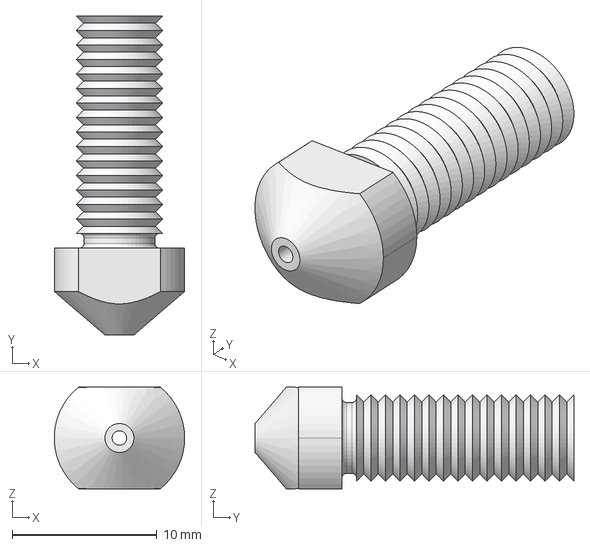
[picture p99: CAD file, 2016-05-03]
production_parts/machined_parts/hexagon_hotend/STEP/Nozzle_long.step
8.99 x 22.0 x 7.00 mm
