reprapperMC/mini-gladiola/Assembly/assembly_parts/40mm_fan.step

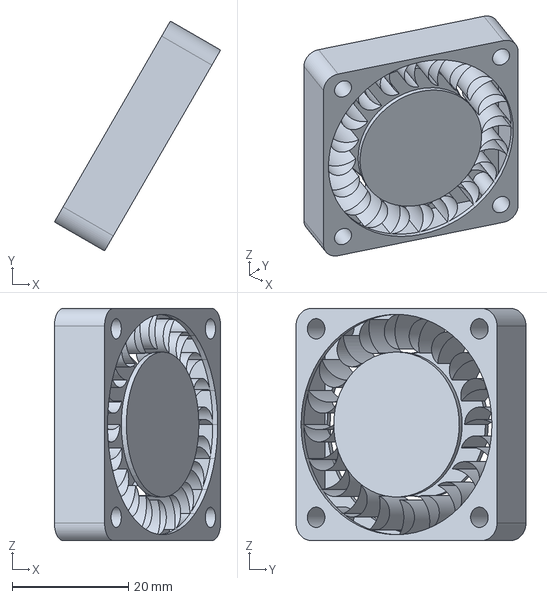
[picture p100: CAD file, 2016-11-16]
Assembly/assembly_parts/40mm_fan.step
28.7 x 39.6 x 40.0 mm
