reprapperMC/mini-gladiola/production_parts/jigs/beefy_spacer_v0.3.fcstd

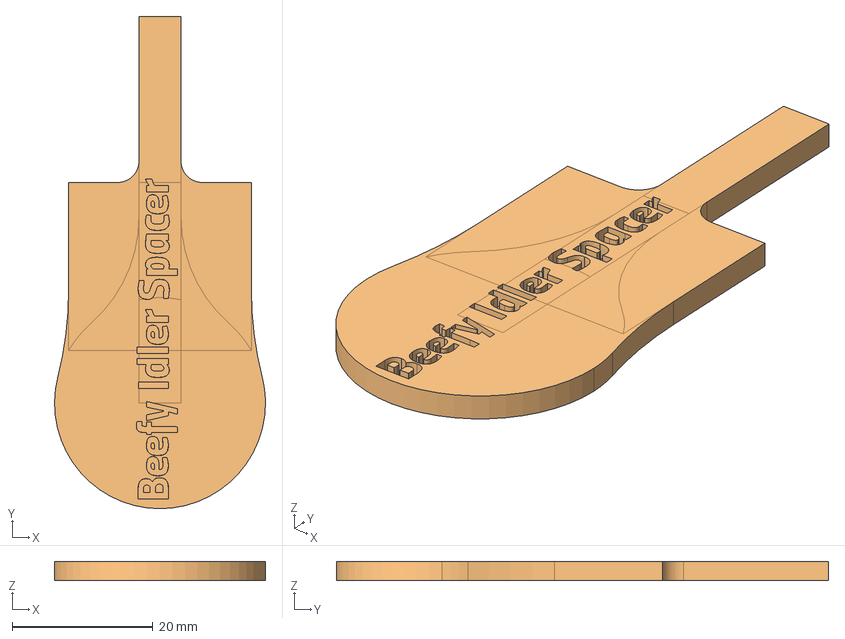
[picture p101: CAD file, 2016-11-23]
production_parts/jigs/beefy_spacer_v0.3.fcstd
30.0 x 70.0 x 2.75 mm
