reprapperMC/mini-gladiola/Assembly/assembly_parts/NEMA17.step

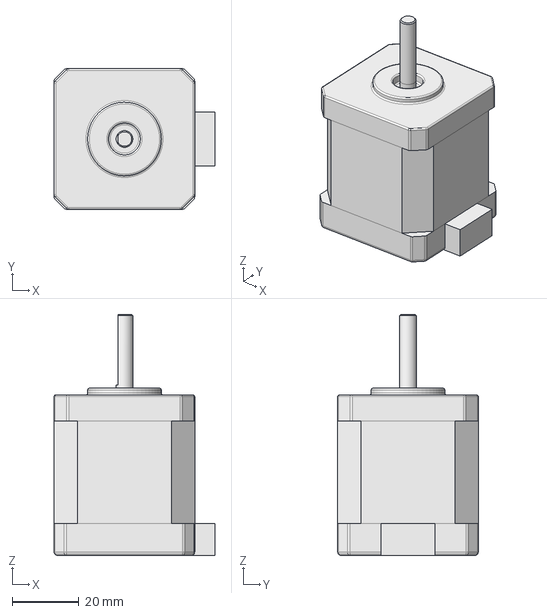
[picture p102: CAD file, 2016-11-16]
Assembly/assembly_parts/NEMA17.step
48.0 x 42.0 x 72.0 mm
