reprapperMC/mini-gladiola/production_parts/jigs/YZharnessjig1.fcstd

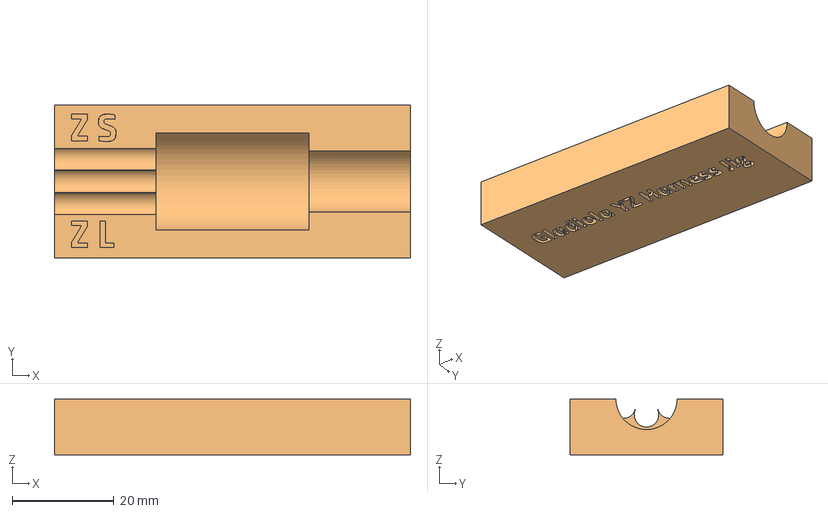
[picture p103: CAD file, 2016-11-16]
production_parts/jigs/YZharnessjig1.fcstd
70.0 x 30.0 x 11.0 mm
