reprapperMC/mini-gladiola/Assembly/assembly_parts/608_bearing.step

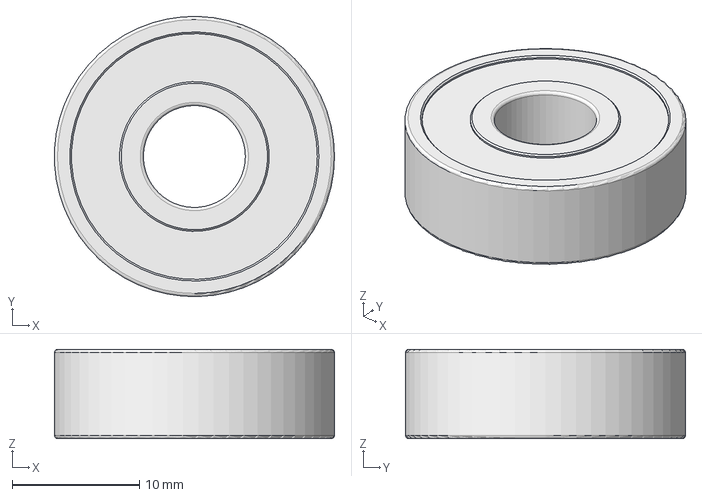
[picture p104: CAD file, 2016-11-16]
Assembly/assembly_parts/608_bearing.step
22.0 x 22.0 x 7.00 mm
