reprapperMC/mini-gladiola/production_parts/jigs/Glad_tie_down_jig.fcstd

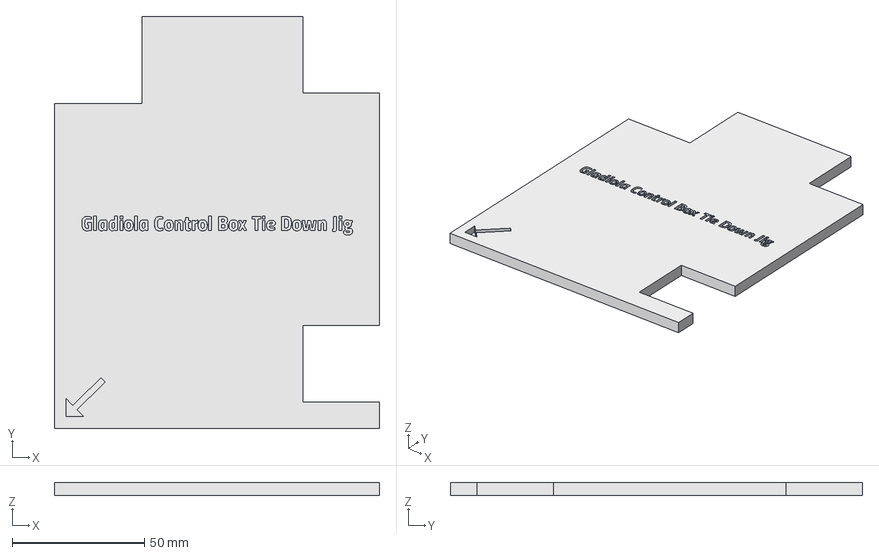
[picture p105: CAD file, 2016-11-09]
production_parts/jigs/Glad_tie_down_jig.fcstd
123.0 x 156.0 x 5.00 mm
