reprapperMC/mini-gladiola/production_parts/jigs/Gladiola_y_motor_jig.fcstd

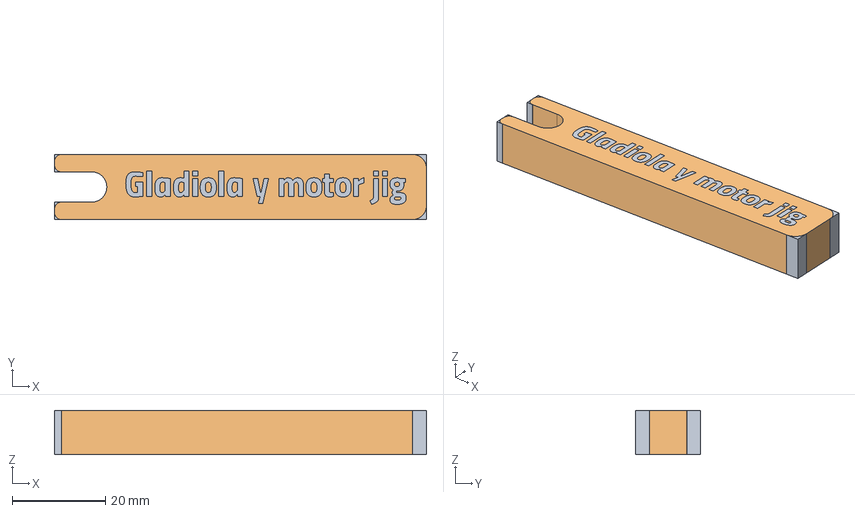
[picture p106: CAD file, 2016-10-24]
production_parts/jigs/Gladiola_y_motor_jig.fcstd
80.0 x 14.0 x 9.50 mm
Fillet002Body
