reprapperMC/mini-gladiola/production_parts/jigs/Gladiola_x_motor_jig.fcstd

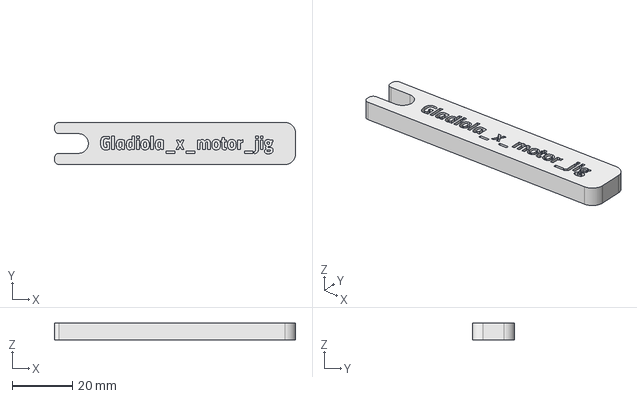
[picture p107: CAD file, 2016-10-24]
production_parts/jigs/Gladiola_x_motor_jig.fcstd
80.0 x 14.0 x 5.50 mm
