reprapperMC/mini-gladiola/Assembly/assembly_parts/compressed_spring.step

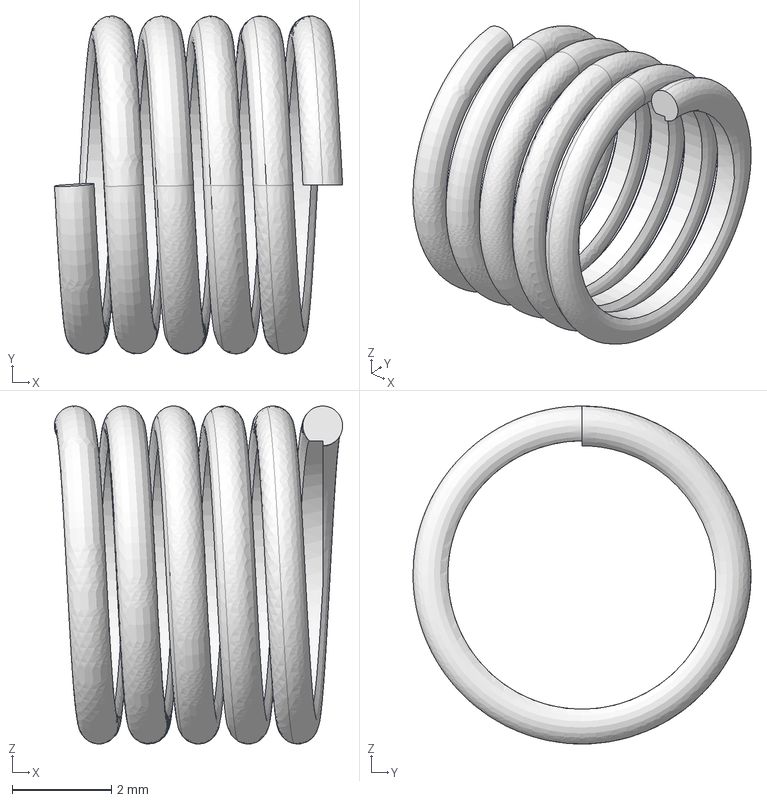
[picture p108: CAD file, 2016-11-16]
Assembly/assembly_parts/compressed_spring.step
5.80 x 6.80 x 6.80 mm
