reprapperMC/mini-gladiola/production_parts/jigs/Y-Extension_Radius_Jig.fcstd

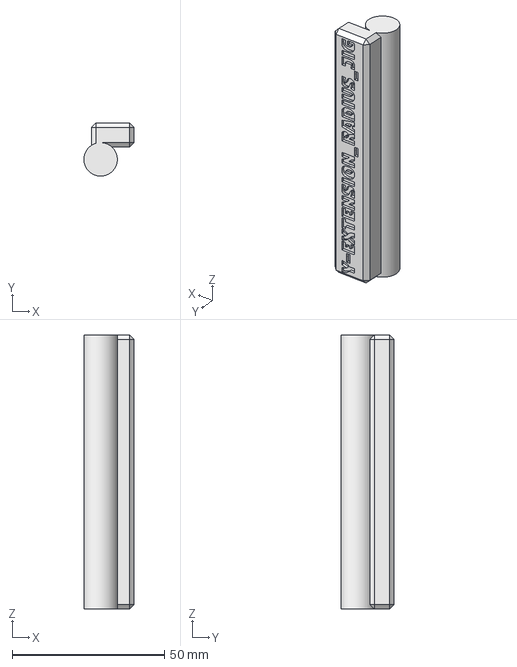
[picture p109: CAD file, 2016-10-24]
production_parts/jigs/Y-Extension_Radius_Jig.fcstd
16.5 x 17.5 x 90.0 mm
