reprapperMC/mini-gladiola/production_parts/jigs/Glad_80mmFanJig.fcstd

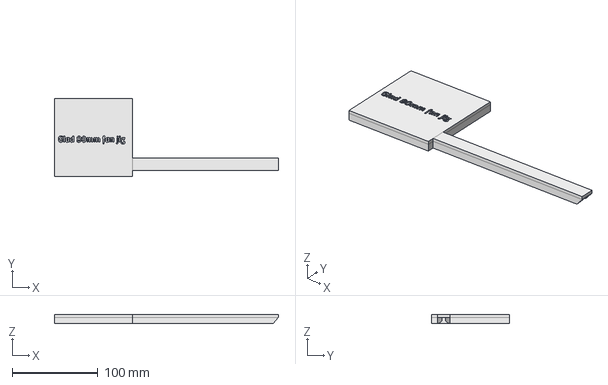
[picture p110: CAD file, 2016-10-18]
production_parts/jigs/Glad_80mmFanJig.fcstd
260.5 x 90.5 x 10.0 mm
