reprapperMC/mini-gladiola/Assembly/assembly_parts/pulley.fcstd

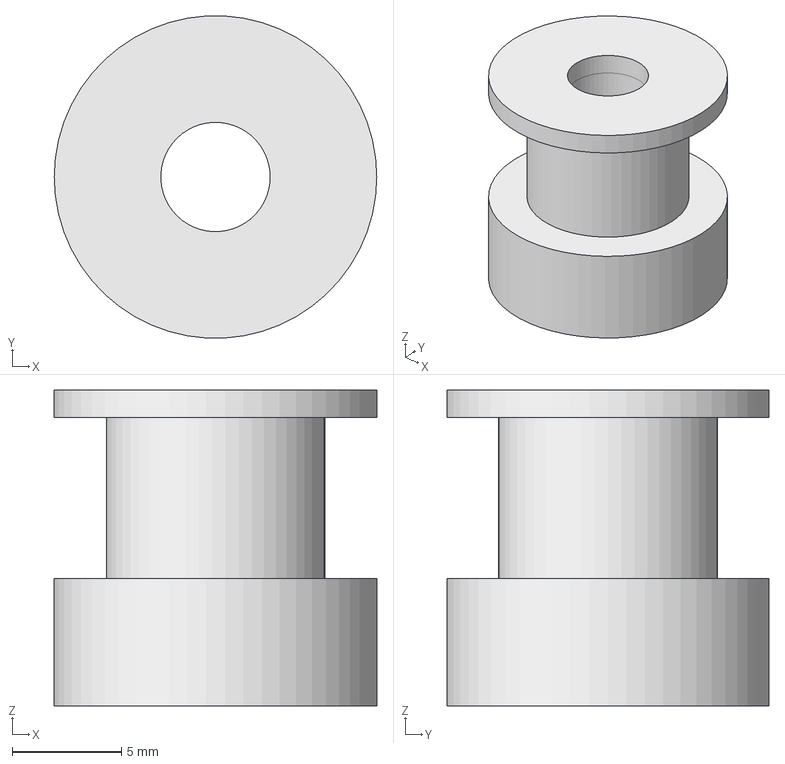
[picture p111: CAD file, 2016-11-16]
Assembly/assembly_parts/pulley.fcstd
14.8 x 14.7 x 14.4 mm
