reprapperMC/mini-gladiola/production_parts/jigs/15mm_z_motor_jig.fcstd

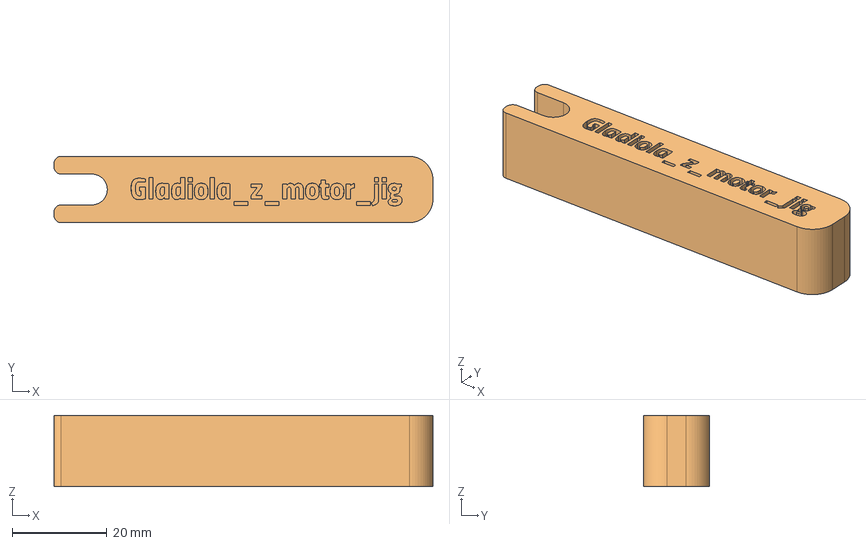
[picture p112: CAD file, 2016-09-01]
production_parts/jigs/15mm_z_motor_jig.fcstd
80.0 x 14.0 x 15.0 mm
