reprapperMC/mini-gladiola/Assembly/assembly_parts/510mm_extrusion.fcstd

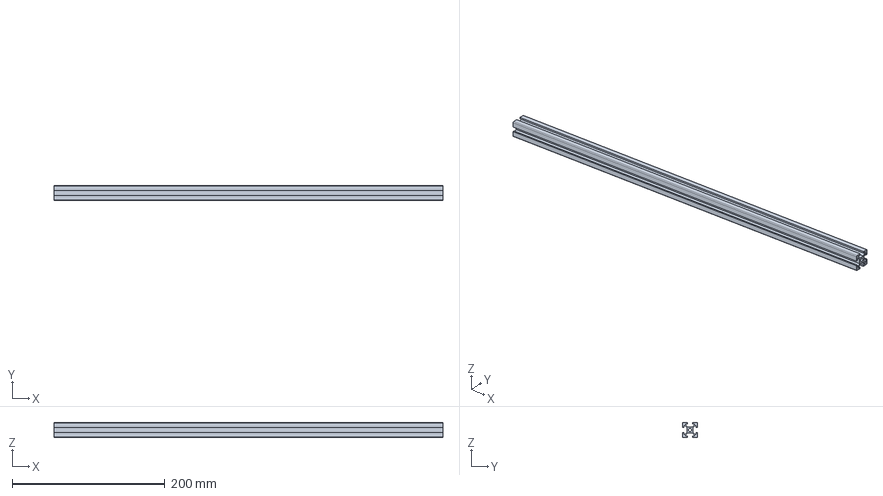
[picture p113: CAD file, 2016-11-16]
Assembly/assembly_parts/510mm_extrusion.fcstd
510.0 x 20.0 x 20.0 mm
