reprapperMC/mini-gladiola/production_parts/jigs/heat_pad_alignment_jig_mini.fcstd

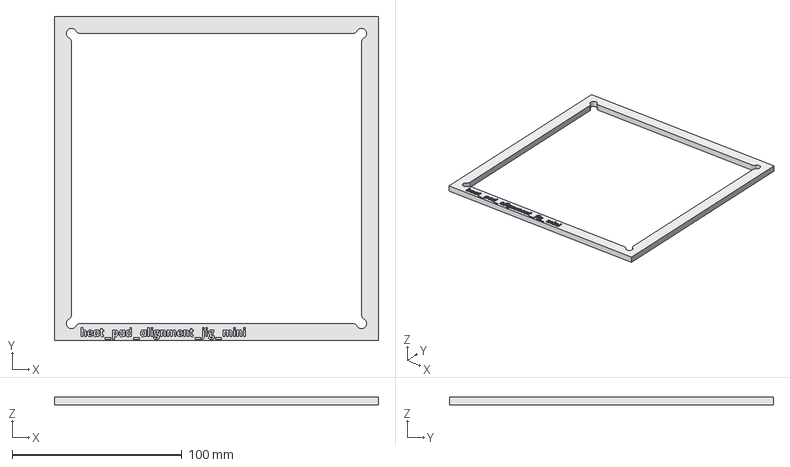
[picture p114: CAD file, 2016-05-03]
production_parts/jigs/heat_pad_alignment_jig_mini.fcstd
191.0 x 191.0 x 5.00 mm
