reprapperMC/mini-gladiola/production_parts/jigs/z-low3r_spacer_v0.1.fcstd

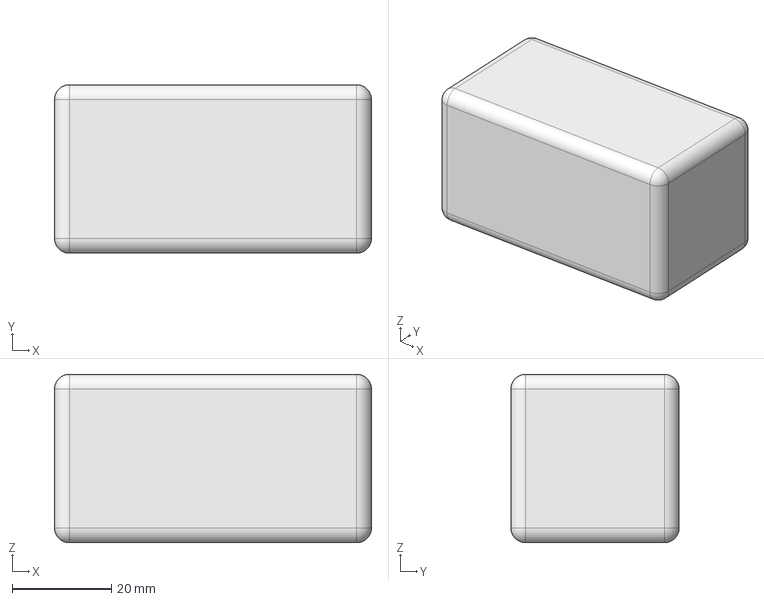
[picture p115: CAD file, 2016-05-03]
production_parts/jigs/z-low3r_spacer_v0.1.fcstd
64.0 x 34.0 x 34.0 mm
