reprapperMC/mini-gladiola/Assembly/assembly_parts/500mm_extrusion.fcstd

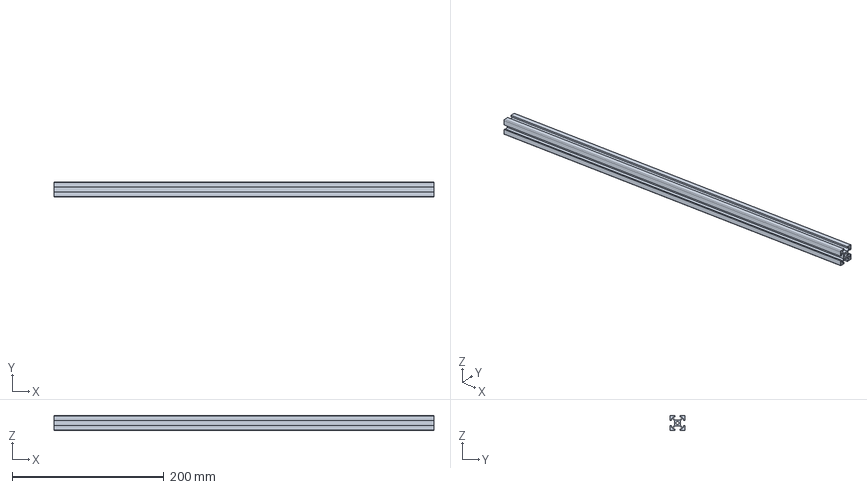
[picture p116: CAD file, 2016-11-16]
Assembly/assembly_parts/500mm_extrusion.fcstd
500.0 x 20.0 x 20.0 mm
