reprapperMC/mini-gladiola/Assembly/assembly_parts/boro_glass_bed_170x170.step

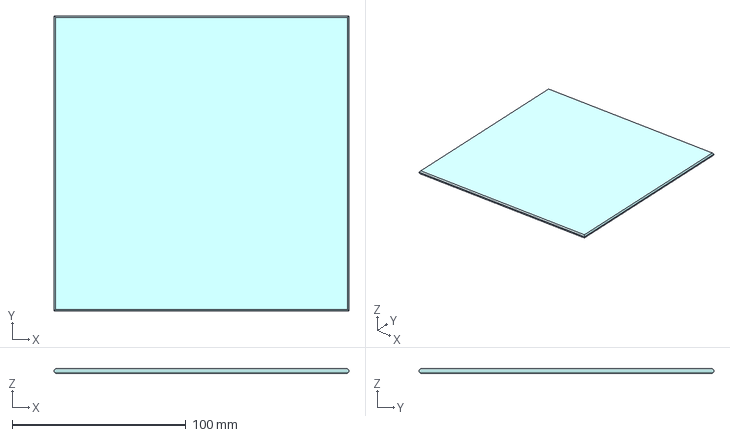
[picture p117: CAD file, 2016-11-16]
Assembly/assembly_parts/boro_glass_bed_170x170.step
170.0 x 170.0 x 3.00 mm
