reprapperMC/mini-gladiola/Assembly/assembly_parts/RJM_01_08_1.stp

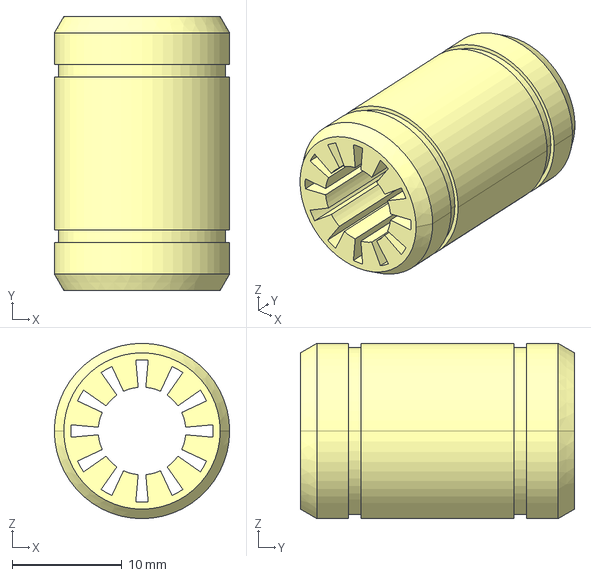
[picture p118: CAD file, 2016-11-16]
Assembly/assembly_parts/RJM_01_08_1.stp
16.0 x 25.0 x 16.0 mm
