reprapperMC/mini-gladiola/(list of files, cad)

Other CAD files:
production_parts/printed_parts/lower-z-right-mini/lower-z-right-mini_lulz-green_v1.6.step
production_parts/printed_parts/z-upper-mini-right/MiniZ-UpperRight_24mmBearingHole.fcstd
production_parts/machined_parts/bottom_plate_mini/bottom_plate_mini_v1.2_PP-MP0149.step
production_parts/machined_parts/right_side/right_side_mini_revF.step
production_parts/printed_parts/extruder_fan_mount/extruder_fan_mount_v2.1_mini.fcstd
production_parts/printed_parts/extruder_mount/testing/extruder_mount_v2.14.fcstd
production_parts/printed_parts/x-end-motor/x-end-motor-mini_black_v2.1.stl
production_parts/printed_parts/z-upper-mini-right/z-upper-mini-right_black_v2.0.step
production_parts/machined_parts/drive_rods/drive_rod_10mm_mini_HD-RD0037.step
production_parts/machined_parts/left_side/left_side_mini_revG.step
production_parts/machined_parts/top_plate_mini/top_plate_mini_v1.1.step
Assembly/AO-Hexagon-Hotend.fcstd
production_parts/printed_parts/wiper_mount/wiper_mount_v1.1.fcstd
Assembly/assembly_parts/627_bearing.step
Assembly/Hotend_Step2.step
Assembly/Hotend_Step.step
production_parts/jigs/heat_pad_alignment_jig_mini_1.fcstd
Assembly/Changes for assembly/608ZZ_bearing.fcstd
Assembly/assembly_parts/608_bearing.fcstd
Assembly/assembly_parts/627_bearing.fcstd
Assembly/assembly_parts/Boro-Glass_bed_170x170.fcstd
Assembly/assembly_parts/MTS10x2m_lead_nut.step
Assembly/assembly_parts/MTS10x2m_leadnut.fcstd
Assembly/assembly_parts/NEMA17.fcstd
Assembly/assembly_parts/drive_nut.fcstd
Assembly/assembly_parts/m3x8x8_bed_spacer.fcstd
Assembly/assembly_parts/m3x8x8_bed_spacer.step
Assembly/assembly_parts/m8_extruder_bolt.fcstd
Assembly/assembly_parts/m8_extruder_bolt.step
Assembly/assembly_parts/m8_nut.step
Assembly/assembly_parts/m8_washer.fcstd
Assembly/assembly_parts/m8_washer.step
Assembly/assembly_parts/nema17_damper.fcstd
Assembly/assembly_parts/thumbscrew_m4x55.step
Assembly/assembly_parts/z_coupler.fcstd
production_parts/jigs/15mm_z_motor_jig.stl
production_parts/jigs/Glad_80mmFanJig.stl
production_parts/jigs/Gladiola_x_motor_jig.stl
production_parts/jigs/Gladiola_y_motor_jig.stl
production_parts/jigs/X-MIN_WRAP_JIG.stl
production_parts/jigs/Y-Extension_Radius_Jig.stl
production_parts/jigs/beefy_spacer_v0.3.stl
production_parts/jigs/glad_tie_down_jig.stl
production_parts/jigs/heat_pad_alignment_jig_mini.stl
production_parts/jigs/heat_pad_alignment_jig_mini_1.stl
production_parts/jigs/nut_insert_tool.fcstd
production_parts/jigs/nut_insert_tool.stl
production_parts/jigs/yz_harness_jig1.stl
production_parts/machined_parts/8_mm_rod/8x19mm_smooth_rod_revA.fcstd
production_parts/machined_parts/bed_leveling_washer/bed_leveling_washer_revA.fcstd
production_parts/machined_parts/bed_leveling_washer/bed_leveling_washer_v2.0_PP-MP0082.fcstd
production_parts/machined_parts/bed_leveling_washer/bed_leveling_washer_v2.0_PP-MP0082_rev_IR.step
production_parts/machined_parts/bottom_plate_mini/bottom-plate-mini_PP-MP0149_revE.fcstd
production_parts/machined_parts/drive_rods/drive_rod_10mm_mini_HD-RD0037_revE.fcstd
production_parts/machined_parts/hexagon_hotend/source/Cooling_Block_3mm_short.fcstd
production_parts/machined_parts/hexagon_hotend/source/Heat_Break_Tube.fcstd
production_parts/machined_parts/hexagon_hotend/source/Heater_Block_16_x_18_x_17.fcstd
production_parts/machined_parts/hexagon_hotend/source/Heater_Block_16_x_18_x_27.fcstd
production_parts/machined_parts/hexagon_hotend/source/Mounting_plate.fcstd
production_parts/machined_parts/hexagon_hotend/source/Nozzle.fcstd
production_parts/machined_parts/hexagon_hotend/source/Nozzle_long.fcstd
production_parts/machined_parts/hexagon_hotend/source/Retention_Plate _v2.fcstd
production_parts/machined_parts/left_side/left-side-mini_PP-FP0055_revG.step
production_parts/machined_parts/left_side/left-side-mini_PP-FP0055_revH.fcstd
production_parts/machined_parts/right_side/right-side-mini_PP-FP0052_revF.fcstd
production_parts/machined_parts/smooth_rod_mini/8mmx315_rod_v1.0.fcstd
production_parts/printed_parts/bed_clip/bed_clip_v3.fcstd
production_parts/printed_parts/bed_clip/bed_clip_v3.stl
production_parts/printed_parts/bed_corner/bed_corner_v2.7.fcstd
production_parts/printed_parts/bed_corner/bed_corner_v2.7.stl
production_parts/printed_parts/beefy_extruder_idler/beefy_extruder_idler_v0.4.fcstd
production_parts/printed_parts/beefy_extruder_idler/beefy_extruder_idler_v0.4.stl
production_parts/printed_parts/beefy_idler_latch/beefy_idler_latch_v2.2.fcstd
production_parts/printed_parts/beefy_idler_latch/beefy_idler_latch_v2.2.stl
production_parts/printed_parts/belt-clamp/belt-clamp-mini_black_v1.2.stl
production_parts/printed_parts/belt-mount/belt-mount_black_v1.2.stl
production_parts/printed_parts/double-bearing-holder/double-bearing-holder_black_v1.4.fcstd
production_parts/printed_parts/double-bearing-holder/double-bearing-holder_black_v1.4.stl
production_parts/printed_parts/extruder_fan_mount/extruder_fan_mount_v2.1_mini.stl
production_parts/printed_parts/extruder_mount/extruder_mount_v2.11.fcstd
production_parts/printed_parts/extruder_mount/extruder_mount_v2.11.stl
production_parts/printed_parts/extruder_mount/testing/extruder_mount_v2.12.blend
production_parts/printed_parts/extruder_mount/testing/extruder_mount_v2.12.fcstd
production_parts/printed_parts/extruder_mount/testing/extruder_mount_v2.12.stl
production_parts/printed_parts/extruder_mount/testing/extruder_mount_v2.13.fcstd
production_parts/printed_parts/extruder_mount/testing/extruder_mount_v2.13.stl
production_parts/printed_parts/extruder_mount/testing/extruder_mount_v2.14.stl
production_parts/printed_parts/extruder_washer/extruder_washer_v3.0-x16.stl
production_parts/printed_parts/handle/handle-bar_black_v2.7.fcstd
production_parts/printed_parts/handle/handle-bar_black_v2.7.stl
production_parts/printed_parts/heatsink-fan-duct/heatsink-fan-duct_black_v0.6.stl
production_parts/printed_parts/lower-z-left-mini/lower-z-left-mini_lulz-green_v1.6.fcstd
production_parts/printed_parts/lower-z-left-mini/lower-z-left-mini_lulz-green_v1.6.stl
production_parts/printed_parts/lower-z-right-mini/lower-z-right-mini_lulz-green_v1.6.fcstd
production_parts/printed_parts/lower-z-right-mini/lower-z-right-mini_lulz-green_v1.6.stl
production_parts/printed_parts/spool-arm-bracket/spool-arm-bracket_black_v1.0.fcstd
production_parts/printed_parts/spool-arm-bracket/spool-arm-bracket_black_v1.0.stl
production_parts/printed_parts/spool-arm-mini/spool-arm-mini_black_v1.4.fcstd
production_parts/printed_parts/spool-arm-mini/spool-arm-mini_black_v1.4.stl
production_parts/printed_parts/spool-arm-support/rd-test/spool-arm-support_black_v1.2.fcstd
production_parts/printed_parts/spool-arm-support/rd-test/spool-arm-support_black_v1.2.stl
production_parts/printed_parts/spool-arm-support/rd-test/spool-arm-support_black_v1.3.stl
production_parts/printed_parts/spool-arm-support/spool-arm-support_black_v1.1.fcstd
production_parts/printed_parts/spool-arm-support/spool-arm-support_black_v1.1.stl
production_parts/printed_parts/strain-relief-lower/strain-relief-lower_black_1.2.fcstd
production_parts/printed_parts/strain-relief-lower/strain-relief-lower_black_1.2.stl
production_parts/printed_parts/strain-relief-upper/strain-relief-upper_black_v3.0.fcstd
production_parts/printed_parts/strain-relief-upper/strain-relief-upper_black_v3.0.stl
production_parts/printed_parts/upper-bearing-holder/upper-bearing-holder_black_v3.0.fcstd
production_parts/printed_parts/upper-bearing-holder/upper-bearing-holder_black_v3.0.stl
production_parts/printed_parts/usb_support/usb_support_mini_v1.0.fcstd
production_parts/printed_parts/usb_support/usb_support_mini_v1.0.stl
production_parts/printed_parts/wiper_mount/wiper_mount_v1.1.stl
production_parts/printed_parts/x-carriage-cap/x-carriage-cap_black_v2.5.stl
production_parts/printed_parts/x-carriage/x-carriage-mini_black_v1.1.fcstd
production_parts/printed_parts/x-carriage/x-carriage-mini_black_v1.1.stl
production_parts/printed_parts/x-end-motor/testing/x-end-motor-mini_black_v2.2.blend
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
