reprapperMC/mini-gladiola/documentation/Manual/Source/Advanced.tex

%
% Advanced.tex
% Advanced Techniques
%
% LulzBot® Mini User Manual
%
% Copyright (C) 2016 Aleph Objects, Inc.
%
% This document is licensed under the Creative Commons Attribution 4.0
% International Public License (CC BY-SA 4.0) by Aleph Objects, Inc.
%
%

\section{\texttt{Intro}}
\index{advanced techniques}
\glossary{3D Printer}{Also referred to as additive manufacturing, is the process of fabricating objects from 3D model data, through the deposition of a material in accumulative layers.}
\glossary{Spool}{Plastic filament coiled and stored on a plastic reel. 3mm filament is referred over 1.75mm filament due to improved feeding and better mounting options.}
\glossary{Filament}{Plastic material in a ``string'' like form, as it is fed to the printer.}
\glossary{ABS}{Acrylonitrile butadiene styrene thermoplastic. Usually extrudes at 230°C with the Budaschnozzle and 240°C - 250°C with the LulzBot Hexagon Hot End.}
\glossary{PLA}{Polylactic acid is a corn-based biodegradable polymer. Usually extrudes at \texttt{185°C} with the Budaschnozzle and \texttt{205°C} with the LulzBot Hexagon Hot End.}
\glossary{HDPE}{High-density polyethylene.}
\glossary{Polycarbonate}{A strong and impact-resistant thermoplastic. Usually extrudes at ~\texttt{300°C}.}
\glossary{HIPS}{High-impact polystyrene. Usually extrudes at \texttt{230°C} with the Budaschnozzle and \texttt{230°C} with the LulzBot Hexagon Hot End}
\glossary{Laywoo-D3}{Wooden filament similar to PLA. Forty percent of its content consists of recycled wood. Usually prints at ~\texttt{180°C} to \texttt{210°C}. Color can be changed by varying the extrusion temperature.}
After you become familiar with printing using the default settings, a few advanced techniques may help in getting better and more consistent prints from the LulzBot Mini 3D printer. Some of these instructions are items and materials not included with the Mini. With any of these additional items or materials, follow safety and usage guidelines as instructed by the manufacturer.

\section{\texttt{Changing nozzles}}
\index{nozzle}
\glossary{Nozzle}{The metal tip at the bottom of the hot end. It has a small hole where the plastic filament comes out of the printer.}
\glossary{Layer height}{The thickness of each individual deposited layer of the three-dimensional model when cut with a slicing program.}
\index{high resolution}
\index{hot end}
\glossary{Hot end}{The hot end is the whole part where the plastic melts, including the nozzle, heater block, thermistor, and heat sink. The LulzBot Hexagon Hot End comes standard on the Mini.}
\index{threaded extension}
\glossary{Threaded extension}{Used to separate the heater block and nozzle from the PEEK insulator. The plastic filament passes through the threaded extension into the melting chamber.}
\textcolor{red}{Hot end related issues will not be covered under warranty after nozzle changes}.

Your hot end is equipped with a 0.50mm nozzle. This nozzle diameter will print faster than a 0.35mm nozzle. Purchase a tool head from \texttt{LulzBot.com} with an alternate nozzle diameter for quick, easy, and simple changes.

Due to the specific torque of 30 inch pounds required to tighten the nozzle when removed, removing the nozzle is not recommended. Failure to properly tighten the nozzle to the specific recommended torque may lead to leaks or damage if over-tightened.

\definecolor{green2}{rgb}{0.00,0.375,0.0}
\section{\texttt{Firmware Flashing}}
\label{ssec:num2}
We include the latest version of 3D printer firmware with each update of Cura LulzBot Edition. In order to update your firmware:
\begin{itemize}
\item Download the latest version of Cura LulzBot Edition from \texttt{LulzBot.com/Cura}.
\item Install Cura by following the specific instructions for your operating system. 
\item Start Cura by launching it from your list of installed applications.
\item Add a new machine by selecting \texttt{Machine > Add New Machine}.
\item Select \texttt{LulzBot Mini}.
\item Select the appropriate tool head.
\item Install the latest stable firmware by selecting \texttt{Machine > Install Default Firmware}.
\end{itemize}

\section{Z Offset}
\label{ssec:Z Offset}
\index{Z offset}
\index{first layer height}
Your LulzBot Mini 3D printer has the ability to change the first layer height (Z offset) directly through Cura. In the lower right hand corner of the Control Window in Cura, enter the following commands. (The green text explains the command, do not enter it.)
\begin{itemize}
\item \texttt{M851}                    \textcolor{green2}{; This will report your current Z offset}
\item \texttt{M851 ZXXX}                    \textcolor{green2}{; This will update your Z offset to XXX}
\item \texttt{M500}                    \textcolor{green2}{; Save new offset}
\end{itemize}

To decrease the Z-offset between your nozzle tip and the print surface (decreasing the gap,) subtract from your current offset when changing XXX. To increase the Z-offset between the nozzle tip and the print surface (increasing the gap,) add to your current offset when changing XXX. When updating your offset, be sure to make small changes between prints. \textcolor{red}{We recommend making changes using small, 0.1 mm increments at a time.} 

%\glossary{PEEK}{Polyether ether ketone: an organic polymer used to insulate the hot end due to its mechanical properties at elevated temperatures.}
%In most cases the nozzle is best changed when the hot end is slightly warm. NEVER try to remove the nozzle when the hot end is at extrusion temperature. At higher temperatures the threaded extension expands in the nozzle causing the nozzle to bind if turned. Heat the hot end to \texttt{160°C}. This will soften the plastic inside the hot end and allow the nozzle to be loosened off the threaded extension. Power off the printer and before it cools unscrew the nozzle. Take care when removing the nozzle while the hot end is hot. Wear leather gloves or use a towel to turn the nozzle off the hot end.

%\index{wrench}
%\index{heater block}
\glossary{Heater block}{Machined from aluminum, the heater block generates heat with a heater resistor and uses a thermistor to measure the temperature.}
\glossary{Thermistor}{A special type of resistor that changes resistance based on temperature. It is used to measure temperature on the nozzle and the heated bed.}
\glossary{Heater resistor}{A special type of resistor that is used to apply heat in a small area.}
%The LulzBot Hexagon does not currently have additional nozzle sizes. If a nozzle change is required you will need to tighten the nozzle to the recommended 30in/lb of torque.

%Prior to any modifications make sure the that printer is unplugged from both the wall and the computer. Use a 7mm wrench to turn the nozzle and a 18mm wrench to hold the heater block. A guide on assembling the LulzBot Hexagon hot end is available at \texttt{http://ohai-kit.alephobjects.com}

%\index{anti-seize}
%If you will be changing nozzles frequently we suggest reapplying a small amount of high temperature anti-seize compound to the inside threads of the nozzles. You will need an anti-seize capable of temperatures of at least \texttt{250°C}.

\section{\texttt{Bed Adhesion}}
\index{warping}
\index{bottle}
\index{NinjaFlex}
\index{SemiFlex}
\index{Polycarbonate}
\index{t-glase}
\index{Nylon}
\index{brim}
\index{PEI}
\index{IPA}
\index{Isopropyl alcohol}
You may find that during printing, printed objects lift off the print surface on the corners. Activate the \texttt{Brim} setting in Cura to help increase the surface area of the first layer of the print to improve part adhesion. If the corners of the printed object still lift, clean the PEI surface with IPA/ Isopropyl Alcohol and sand the surface with fine 2000-3000 grit sandpaper. While almost all 3D printing filaments will adhere well to the PEI print surface, some materials may need an application of a PVA glue solution/gluestick for improved print adhesion. These materials include nylon- and polycarbonate-based filament. Flexible materials such as Ninjaflex, SemiFlex, and some co-polyester-based filaments can adhere too well and can be released easier from the PEI print surface with an application of a PVA glue solution/glue stick to the heated bed prior to starting the printing process.

\subsection{\texttt{ABS/Acetone Glue}}
\label{sec:ABS/Acetone Glue}
\index{acetone}
\index{ABS}
\index{bed adhesion}

\glossary{Acetone}{A colorless, volatile, flammable liquid ketone, (CH3)2CO, used as a solvent for ABS.}
Acetone is not included or required with the LulzBot Mini 3D printer. \textcolor{red}{Acetone and ABS solution is NOT recommended anymore, as the PEI print surface works well without it.}

\subsection{\texttt{Glue stick/PVA Glue solution}}
\label{sec:Glue stick/PVA Glue solution}
\index{PVA}
\index{glue stick}
\index{white glue}
\index{school glue}
\index{bed adhesion}
\index{Nylon}
\glossary{PVA}{Polyvinyl acetate is the main ingrediant in white glue, wood glue and the common school glue stick.}
While almost all 3D printing filaments will adhere well to the PEI print surface, Nylon-, Polyester-, polycarbonate-, and Amphora\textsuperscript{\miniscule{\texttrademark}}-based filament print adhesion can be improved with the application of an unscented PVA-based glue solution/glue stick. Flexible filaments such as NinjaFlex\textsuperscript{\miniscule{\textregistered}} and SemiFlex\textsuperscript{\miniscule{\texttrademark}} can adhere too well and require an application of PVA-based glue to the print surface for easy print removal. Failure to properly treat the print surface can lead to a permanent bond to the PEI print surface and will require replacement which may not be covered under warranty.

%\index{PET sheet}
%\glossary{PET}{Polyethylene terephthalate.}
%To apply the acetone/ABS mixture, put a small amount onto a paper towel. Now, rub the towel onto the cool PET print surface to apply a \emph{thin} layer of ABS. Generally only one thin layer of the acetone/ABS solution is needed. However, you can apply multiple coats if needed.

\section{\texttt{Using 1.75mm filament}}
\index{1.75mm filament}
%\index{PTFE tube}
\glossary{PTFE}{Polytetrafluoroethylene is a synthetic fluoropolymer used in the Budaschnozzle for it's low coefficient of friction. This limits the TAZ 1-4 Budaschnozzle top extrusion temperature to 250°C. The LulzBot Mini does not use a hot end with a PTFE insert and can reach a \texttt{300°C} extrusion temperatuere.}

Your LulzBot Mini 3D printer is set up to use 3mm plastic filament by default and may be capable of printing 1.75mm filament with no hardware modification. While many of our advanced users are able to do so, your results may vary.  More information can be found in our User Forums at: \texttt{https://forum.lulzbot.com/viewtopic.php?f=16\&t=1923}
