reprapperMC/mini-gladiola/documentation/Manual/Source/slic3r/Title.tex

%!TEX root = Slic3r-Manual.tex
% clear the page style
\date {}
\thispagestyle{empty}
\begingroup
\centering 

\begin{center}
{\Huge \scshape Slic3r User Manual}

\end{center}

\vspace{40mm}

\begin{center}


\vspace{20mm}

{\large \itshape Gary Hodgson}

\vspace{20mm}

{\large \itshape Sponsored by }


\end{center}
\endgroup
