reprapperMC/mini-gladiola/production_parts/printed_parts/printed_part_name_modifications_8-24-16.ods

USB support mini v1.0 | PP-GP0247
z-upper-mini-right_black_v2.0 | PP-GP0272_v2.0
z-upper-mini-left_black_v2.0 | PP-GP0271_v2.0
lower-z-right-mini_lulz-green_v1.6 | PP-GP0270_v1.6
lower-z-left-mini_lulz-green_v1.6 | PP-GP0269_v1.6
x-end-motor-mini_black_v1.7 | PP-GP0267_v1.7
x-end-idler-mini_black_v2.5 | PP-GP0268_v2.5
strain-relief-upper_black_v3.0 | PP-GP0266_v3.0
strain-relief-lower_black_1.2 | PP-GP0265_v1.2
y-idler-mini_black_v1.4 | PP-GP0264_v1.4
y-motor-mount_black_v1.4 | PP-GP0263_v1.4
double-bearing-holder_black_v1.4 | PP-GP0262_v1.4
belt-mount_black_v1.1 | PP-GP0261_v1.1
belt-clamp_black_v1.1 | PP-GP0260_v1.1
bed corners, mini v2.5 | PP-GP0248
Wiper Mount, v1.1 | PP-GP0231
handle-bar_black_v2.5 | PP-GP0259_v2.5
x-carriage-cap_black_v2.4 | PP-GP0258_v2.4
upper-bearing-holder_black_v3.0 | PP-GP0257_v3.0
x-carriage-mini_black_v1.1 | PP-GP0256_v1.1
Extruder Mount v3.0, Mini | PP-GP0251
heatsink-fan-duct_black_v0.6 | PP-GP0232
extruder-body-hex_black_v1.4.1 | PP-GP0186
Beefy Extruder Idler v0.3 | PP-GP0241
Extruder Washer v3.0, Taz | PP-GP0060
Beefy Idler Latch v2.2 | PP-GP0245
Herringbone Small Gear v1.1, Lulzbot green | PP-GP0192
Herringbone Large Gear v1.3, Lulzbot green | PP-GP0191
spool-arm-mini_black_v1.4 | PP-GP0255_v1.4
spool-arm-support_black_v1.1 | PP-GP0254_v1.1
spool-arm-bracket_black_v1.0 | PP-GP0253_v1.0
bed clip v3 | PP-GP0249
Extruder Fan Mount v2.0, Mini | PP-GP0252
unchanged
new name / part number
