reprapperMC/mini-gladiola/documentation/Manual/Source/COVER/links/DSC_4686.JPG

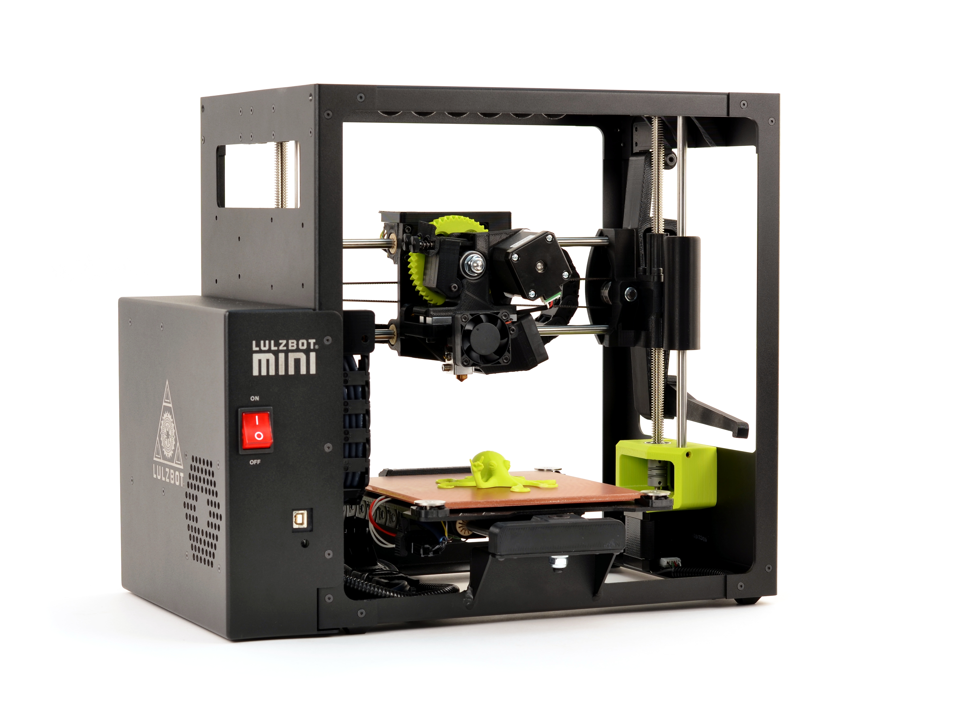
documentation/Manual/Source/COVER/links/DSC_4686.JPG
