reprapperMC/mini-gladiola/documentation/Manual/Source/images-1600x1200/Layer_Height1.jpg

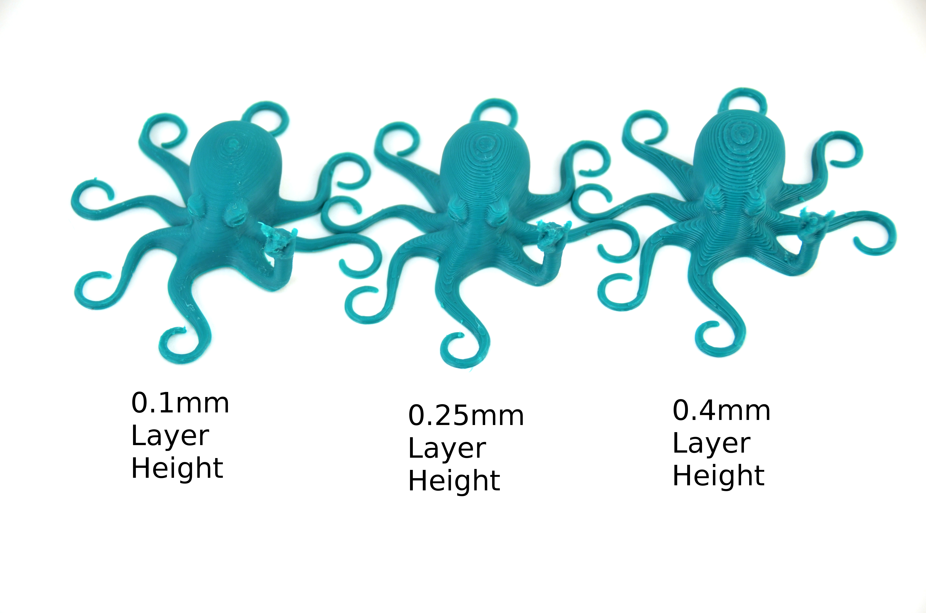
documentation/Manual/Source/images-1600x1200/Layer_Height1.jpg
