reprapperMC/mini-gladiola/documentation/Manual/Source/images-1600x1200/Support.JPG

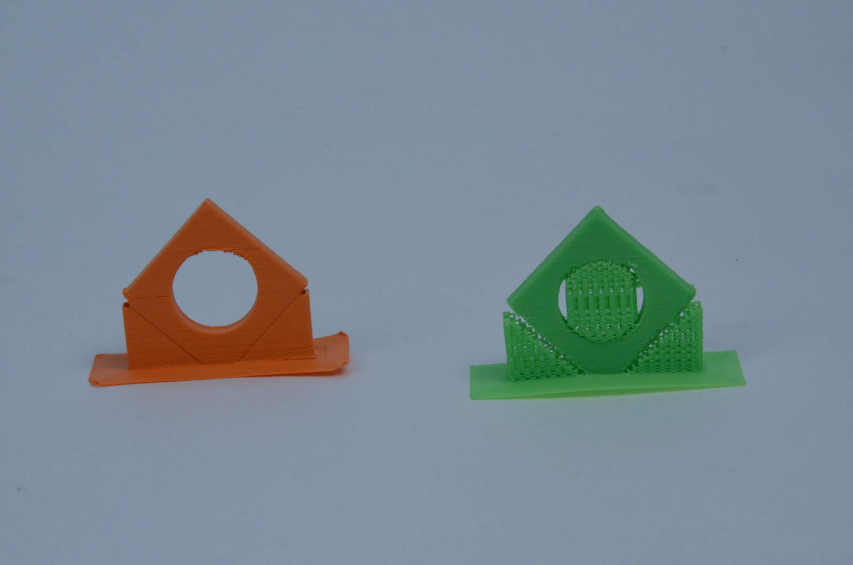
documentation/Manual/Source/images-1600x1200/Support.JPG
