reprapperMC/mini-gladiola/documentation/Quick_Start_Guide/Source/New_Pics/cooling_position.JPG

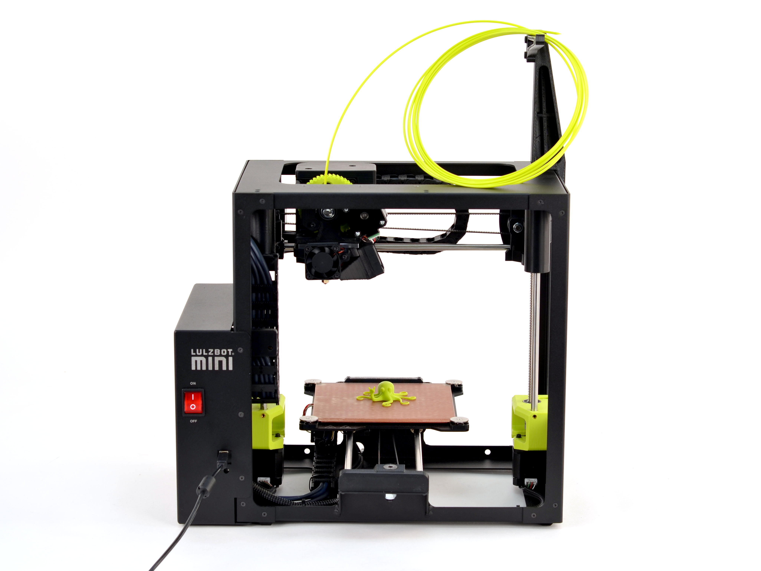
documentation/Quick_Start_Guide/Source/New_Pics/cooling_position.JPG
