reprapperMC/mini-gladiola/documentation/Quick_Start_Guide/Source/New_Pics/first_rocktopus_print.JPG

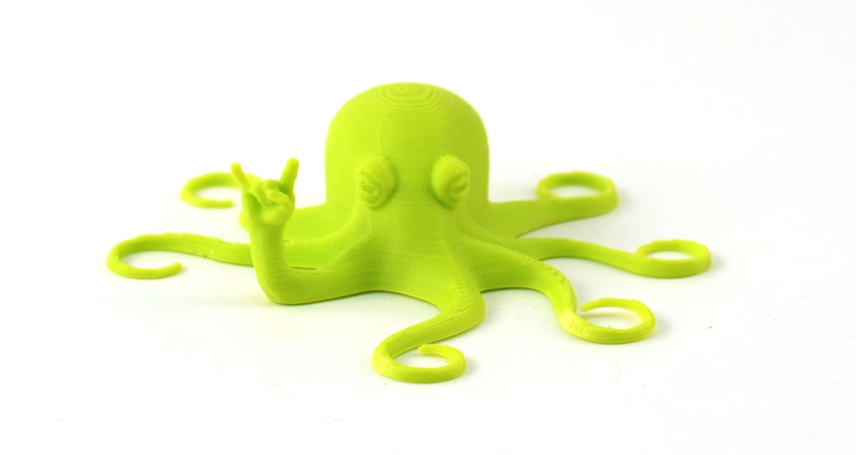
documentation/Quick_Start_Guide/Source/New_Pics/first_rocktopus_print.JPG
