reprapperMC/mini-gladiola/documentation/Quick_Start_Guide/Source/New_Pics/foam_blocks_installed.JPG

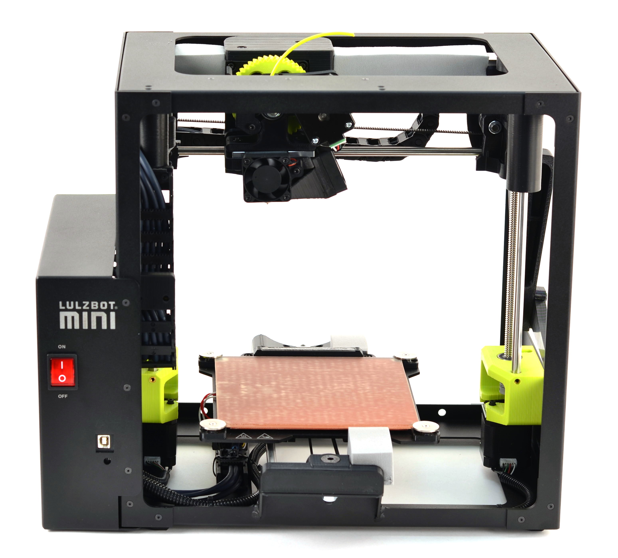
documentation/Quick_Start_Guide/Source/New_Pics/foam_blocks_installed.JPG
