reprapperMC/mini-gladiola/documentation/Quick_Start_Guide/Source/New_Pics/Plug_in_AC_Power.jpg

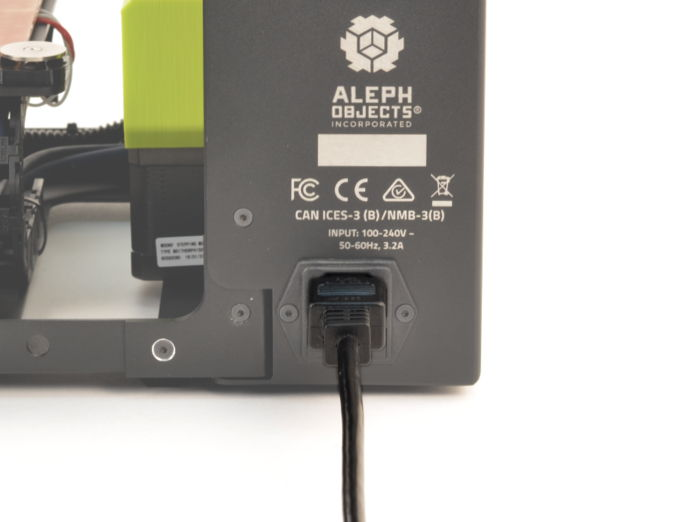
documentation/Quick_Start_Guide/Source/New_Pics/Plug_in_AC_Power.jpg
