reprapperMC/mini-gladiola/documentation/Quick_Start_Guide/Source/New_Pics/plug_USB.JPG

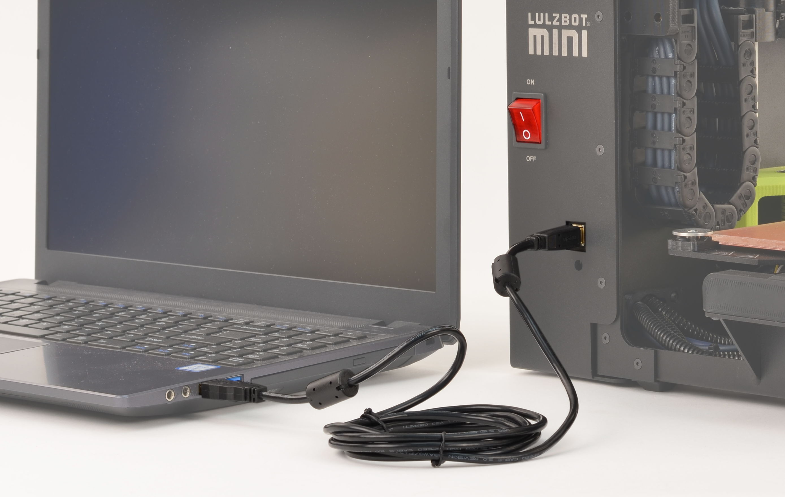
documentation/Quick_Start_Guide/Source/New_Pics/plug_USB.JPG
