reprapperMC/mini-gladiola/documentation/Quick_Start_Guide/Source/New_Pics/power_off.JPG

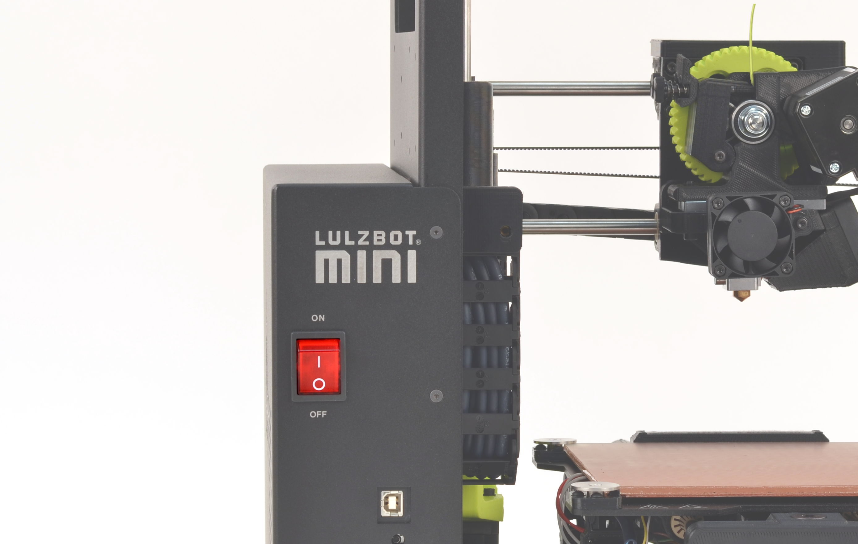
documentation/Quick_Start_Guide/Source/New_Pics/power_off.JPG
