reprapperMC/mini-gladiola/documentation/Quick_Start_Guide/Source/New_Pics/power_on.JPG

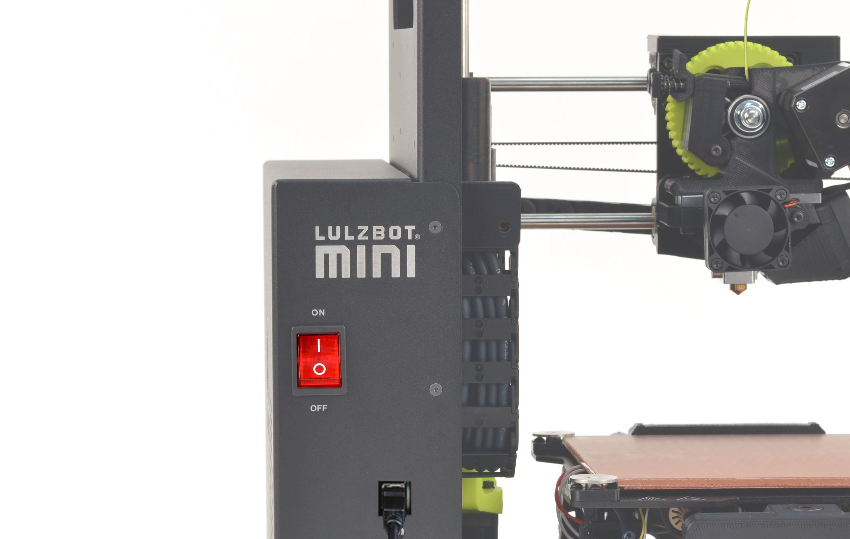
documentation/Quick_Start_Guide/Source/New_Pics/power_on.JPG
