reprapperMC/mini-gladiola/documentation/Quick_Start_Guide/Source/New_Pics/ready_mc/6b_RightSide.jpg

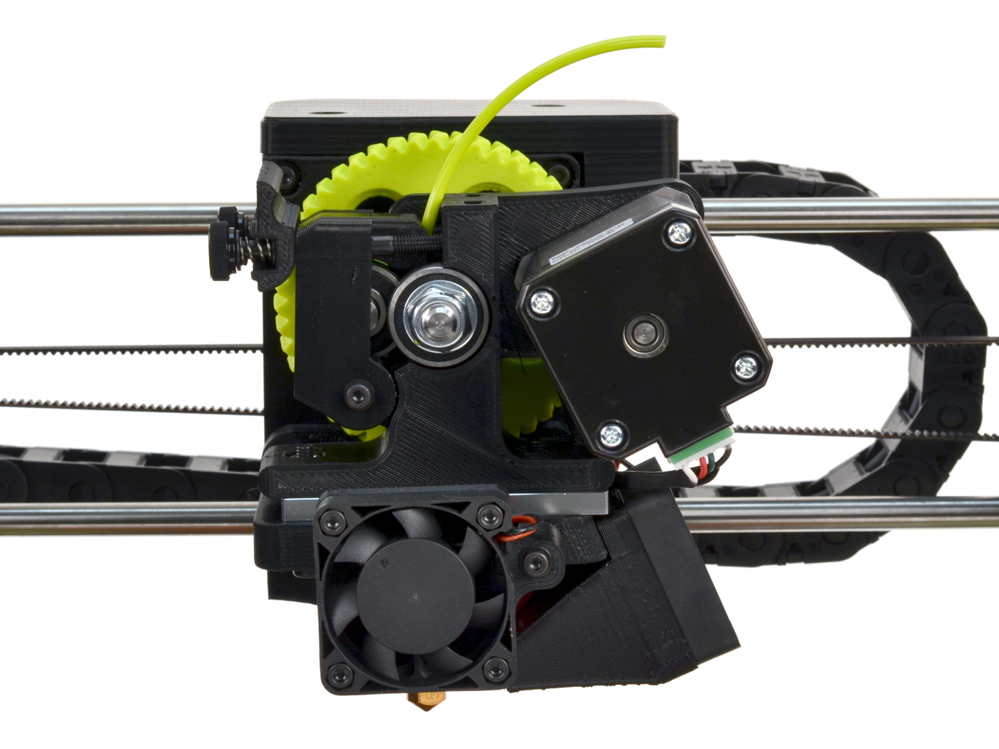
documentation/Quick_Start_Guide/Source/New_Pics/ready_mc/6b_RightSide.jpg
