reprapperMC/mini-gladiola/documentation/Quick_Start_Guide/Source/New_Pics/ready_mc/Clam_Knife_01.png

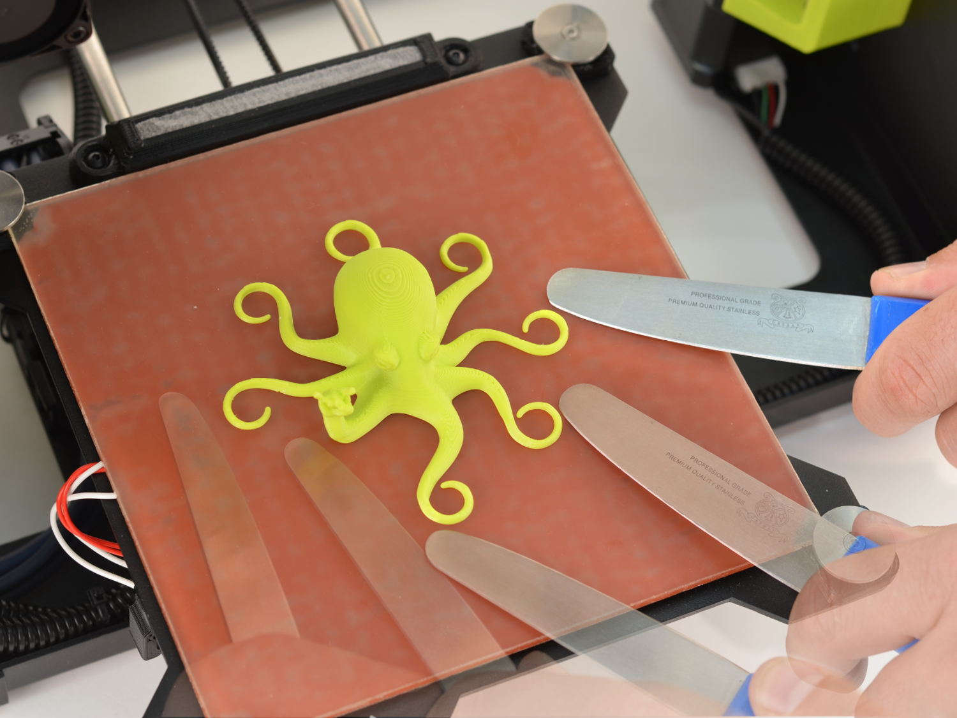
documentation/Quick_Start_Guide/Source/New_Pics/ready_mc/Clam_Knife_01.png
