reprapperMC/mini-gladiola/documentation/Quick_Start_Guide/Source/New_Pics/ready_mc/Mini_Gladiola.JPG

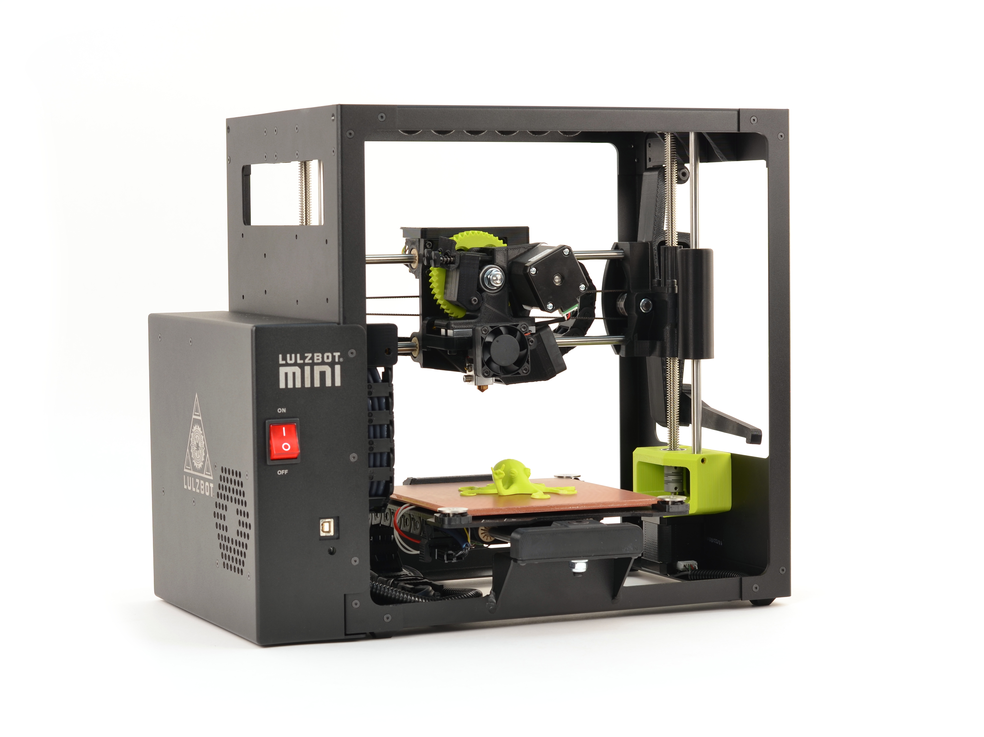
documentation/Quick_Start_Guide/Source/New_Pics/ready_mc/Mini_Gladiola.JPG
