reprapperMC/mini-gladiola/documentation/Quick_Start_Guide/Source/New_Pics/ready_mc/Step8b.JPG

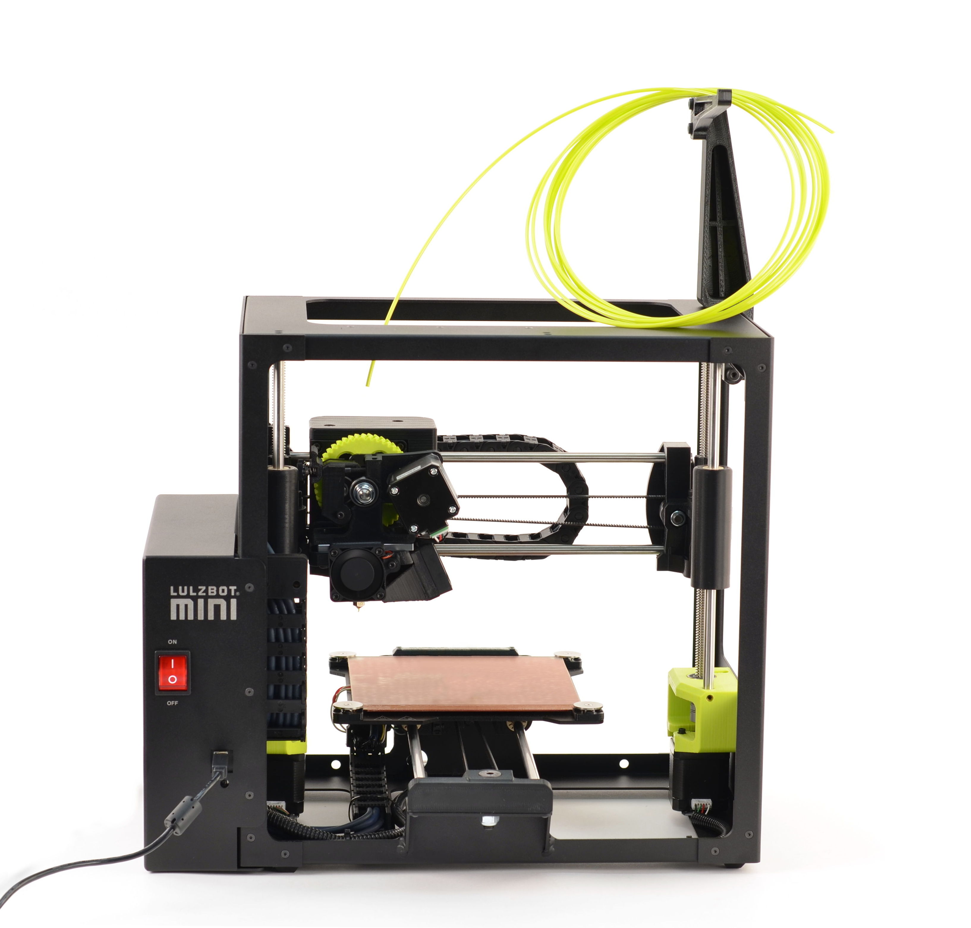
documentation/Quick_Start_Guide/Source/New_Pics/ready_mc/Step8b.JPG
