reprapperMC/mini-gladiola/documentation/Quick_Start_Guide/Source/New_Pics/ready_mc/test_octopus_print.JPG

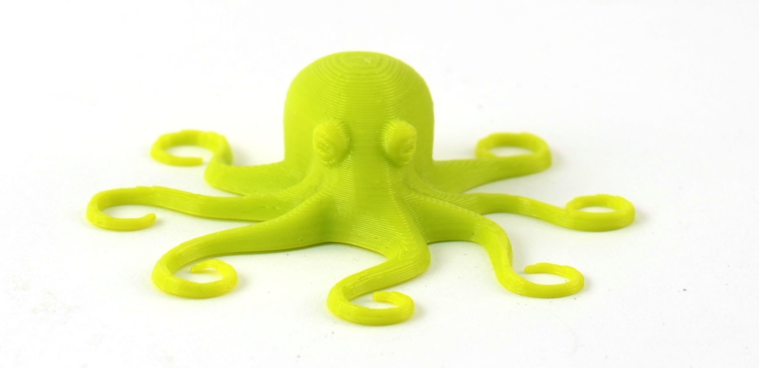
documentation/Quick_Start_Guide/Source/New_Pics/ready_mc/test_octopus_print.JPG
