reprapperMC/mini-gladiola/documentation/Quick_Start_Guide/Source/New_Pics/Step11c.JPG

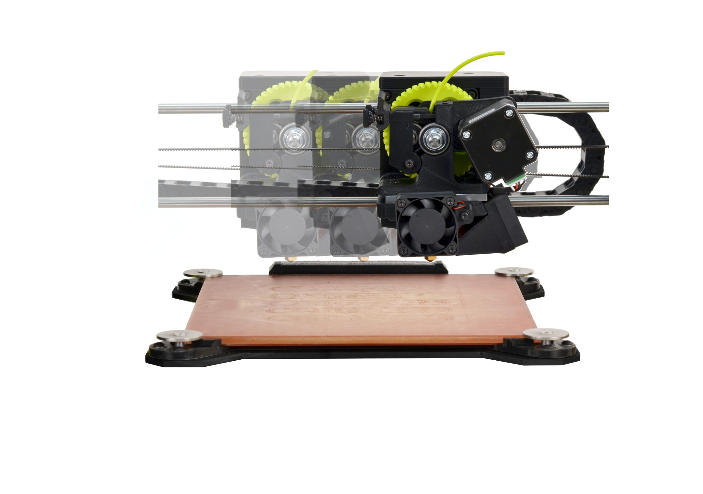
documentation/Quick_Start_Guide/Source/New_Pics/Step11c.JPG
