reprapperMC/mini-gladiola/documentation/Quick_Start_Guide/Source/Screen_Shots/delete_object.png

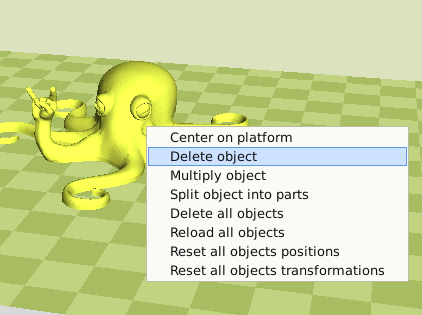
documentation/Quick_Start_Guide/Source/Screen_Shots/delete_object.png
