reprapperMC/mini-gladiola/documentation/Quick_Start_Guide/Source/Screen_Shots/load_model.png

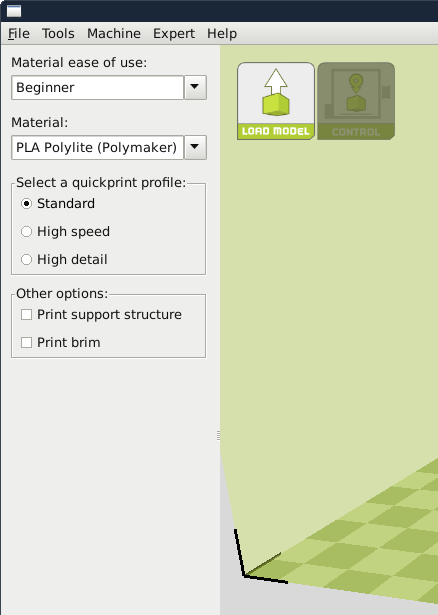
documentation/Quick_Start_Guide/Source/Screen_Shots/load_model.png
