reprapperMC/mini-gladiola/documentation/Quick_Start_Guide/Source/Screen_Shots/Select_Printer.png

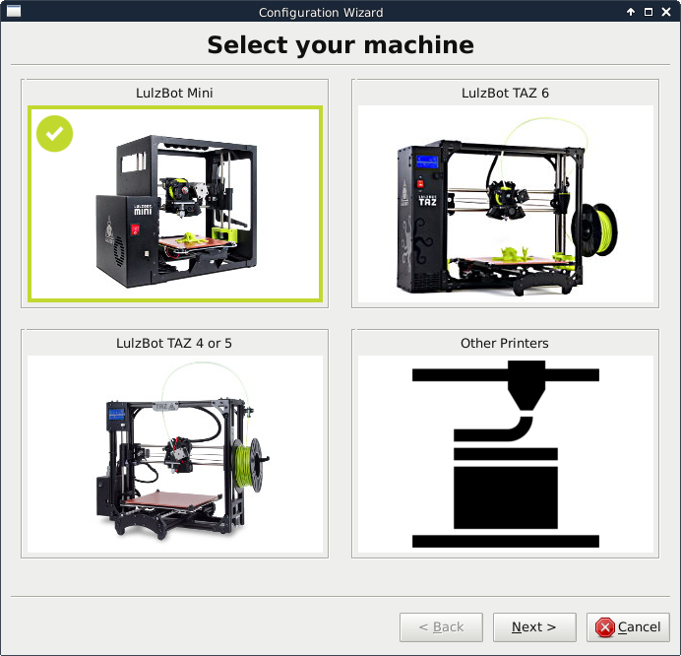
documentation/Quick_Start_Guide/Source/Screen_Shots/Select_Printer.png
