reprapperMC/mini-gladiola/documentation/Quick_Start_Guide/Source/Screen_Shots/select_profile.png

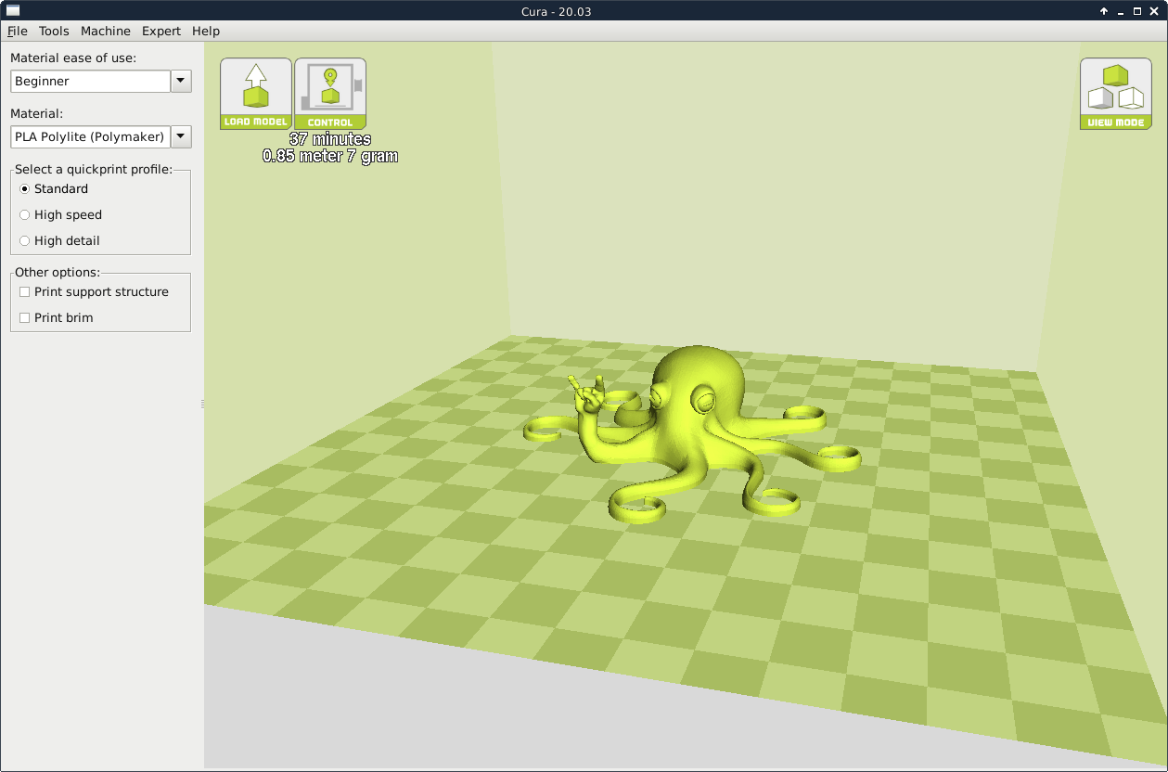
documentation/Quick_Start_Guide/Source/Screen_Shots/select_profile.png
