reprapperMC/mini-gladiola/documentation/Quick_Start_Guide/Source/Screen_Shots/Select_Tool_Head.png

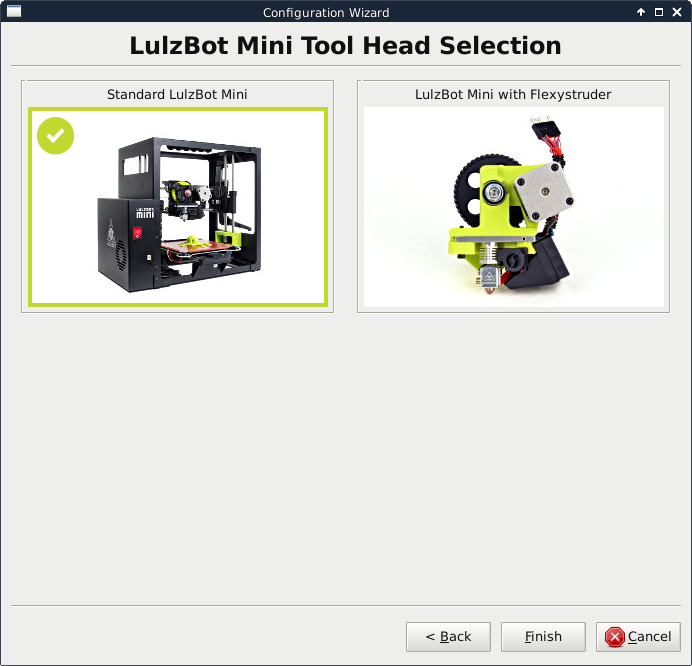
documentation/Quick_Start_Guide/Source/Screen_Shots/Select_Tool_Head.png
