reprapperMC/mini-gladiola/documentation/Quick_Start_Guide/Source/Screen_Shots/set_nozzle_temp.png

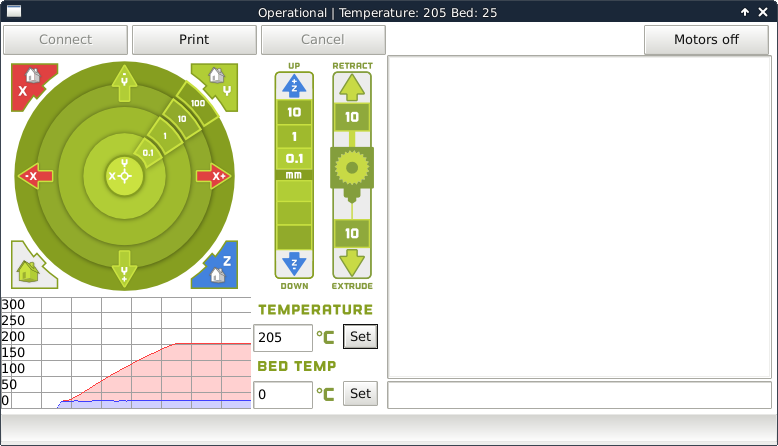
documentation/Quick_Start_Guide/Source/Screen_Shots/set_nozzle_temp.png
