reprapperMC/mini-gladiola/production_docs/test_docs/TP-RD-00016.odt

Title: FCC & CE Testing

Test Plan: TP-RD-00016

Document Generated: 10/12/16

Document Last Updated: 10/24/16

Test Dates: 09/26/16, 10/21/16

Testing Location: EMI Test Lab LLC

PURPOSE:

Achieve FCC and CE compliance for radiated emissions on the Gladiola Mini.

RESULTS SUMMARY:

10/21/16 – Gladiola Verification

The results of the examination on 10/21/16 showed that the Gladiola Mini continues to pass with the modifications made after the 09/26/16 test. Two units which were assembled in manufacturing were verified to pass radiated emissions. Run 1 (Mini 1) resulted in a -1.75dB margin at ~208MHz at a horizontal polarity with the turn table at 168°. Run 2 (Mini 2) resulted in a -0.97dB margin at ~192.01MHz at a horizontal polarity with the turn table at 152°. Run 3 (Mini 1) resulted in a -2.83dB margin at ~30MHz at a vertical polarity with the turn table at 156°. The greatest sources of noise were found to radiate from the max Y-switch, the Z stepper motors, and the USB port (ATmega32U2). The Mini 1 unit was selected to be the dedicated machine for the rest of the testing since it was physically constructed closest to the final desired assembly.

09/26/16 – Gladiola Verification

The results of the examination on 09/26/16 showed that the Gladiola Mini continues to pass with the modifications made after the 08/03/16 experimentation. The Gladiola Mini tested during this session represented the closest configuration to production coming from R&D. The appropriate modifications were made to avoid making the endstops normally closed and did not require the previously proposed firmware modifications. The frequency found to be closest to the limit was ~30MHz with the antenna in its vertical polarity and the turn table's azimuth at 248.0°, the margin at this frequency being -3.51μV/m. The second closest quasi-peak being ~224MHz @168° (horizontal) with a margin of -3.97μV/m. The low frequency 30MHz was found to mostly radiating from the X-motor (as well as all the other motors), the 224MHz is known to mostly radiated from the X-min endstop (as well as all the other endstops). The unit was also tested for conducted emissions and was found to pass with significant margin. The previously composed formal EMC test reports were validated by these measurements and still apply to the LulzBot Mini product line.

CONCLUSION:

10/21/16 – Gladiola Verification

The first two production unit which were assembled by manufacturing as a practice run were found to pass the radiated emissions limits as defined by CISPR 22. A formal test report will be produced which covers the rest of the standards.

09/26/16 – Gladiola Verification

The prototype unit which was assembled to be as close as possible to the production units was found to pass the radiated emissions limits as defined by CISPR 22. Additional testing will be done on two units assembled by manufacturing technicians, a test report will be produced for the unit with a lower margin. After those two units are verified the first production unit will also be tested, another report from the lab may be created for this unit as well.

EQUIPMENT:

An HP 8566B Spectrum Analyzer was used when performing the radiated emissions test.

Here is an image of the semi-anechoic chamber and the antenna:

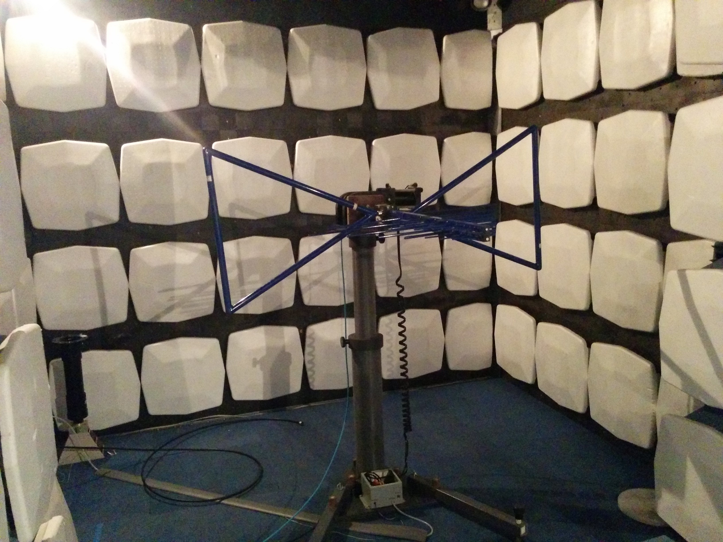
[picture p226: figure]

Here is an image of the Gladiola Mini 2 which was tested on 10/21/16:

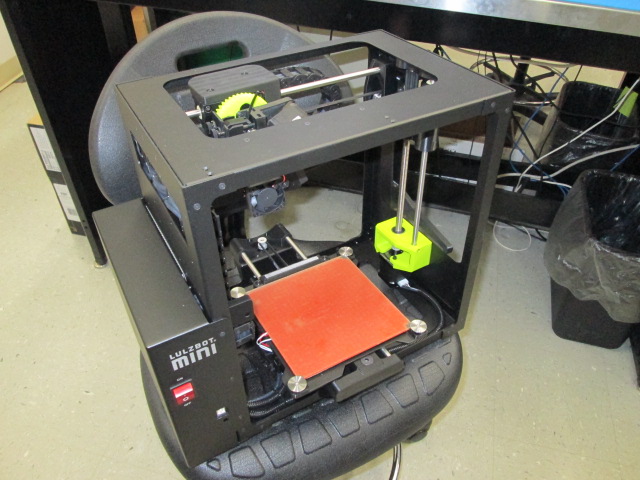
[picture p227: figure]

Here is an image of the Gladiola Mini which was tested on 09/26/16:

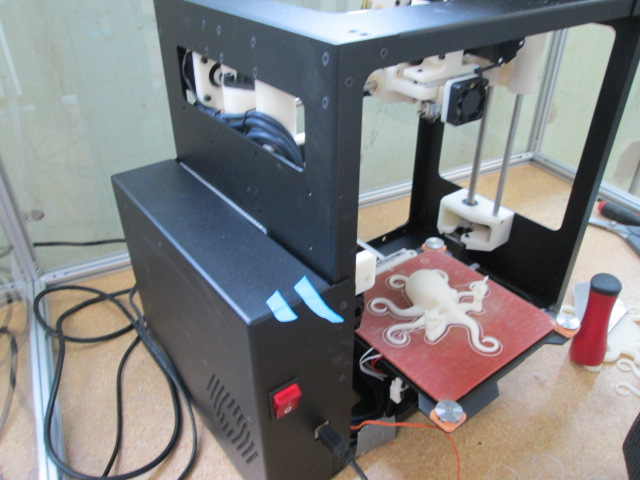
[picture p228: figure]

PROCEDURE:

EMI Testing Procedure:

Place the machine on the turning table in the anechoic chamber. Run through the spectrum (30MHz – 1GHz) with the antenna in its horizontal and vertical positions. If any frequency is found to be above the limit then examine those frequencies individually and modify the machine as needed in an attempt to attenuate those radiated frequencies.

TEST DATA and RESULTS:

The following data was gathered on 10/21/2016 when Gladiola Mini passed radiated emissions:

Run 1:

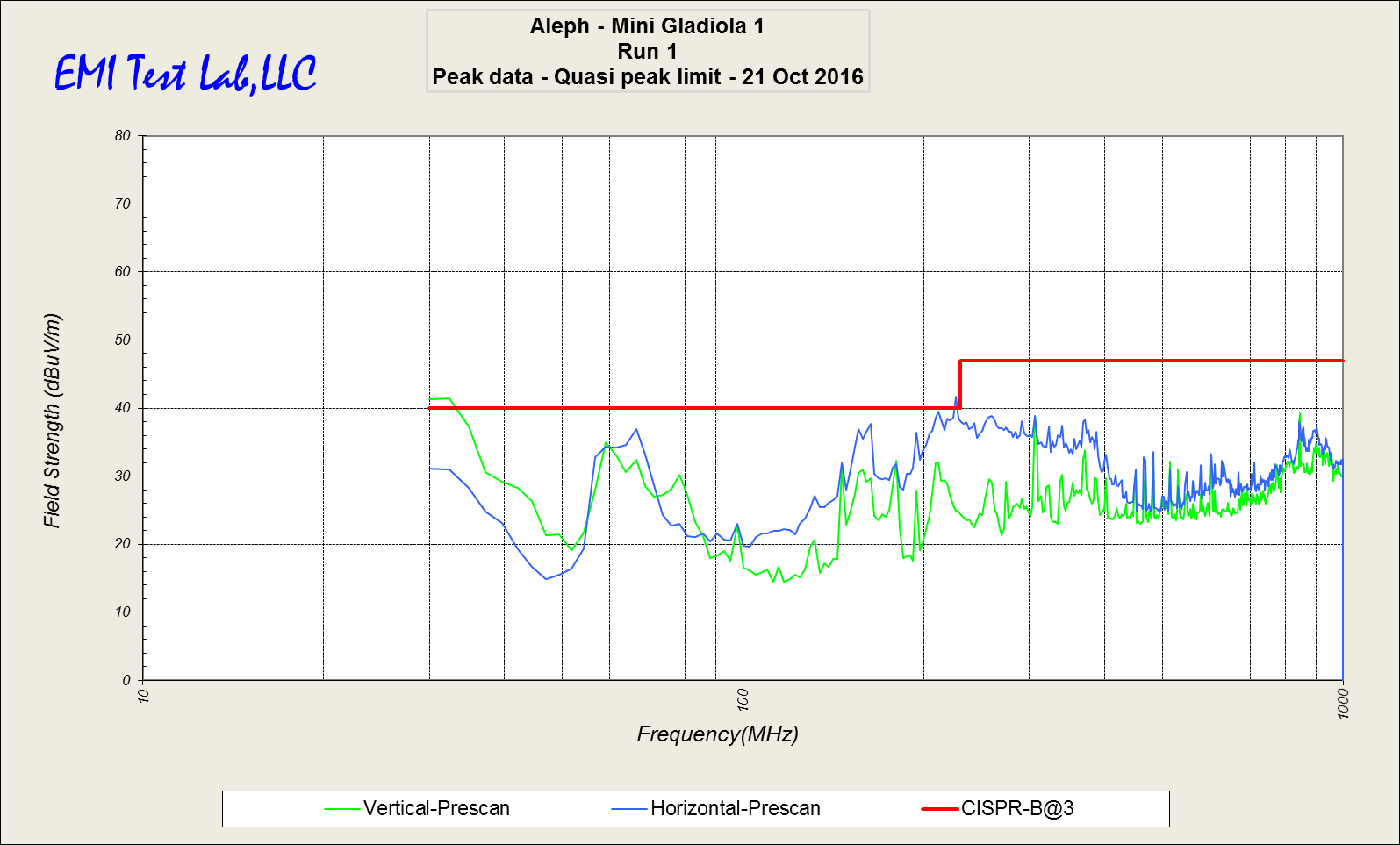
[picture p229: figure]
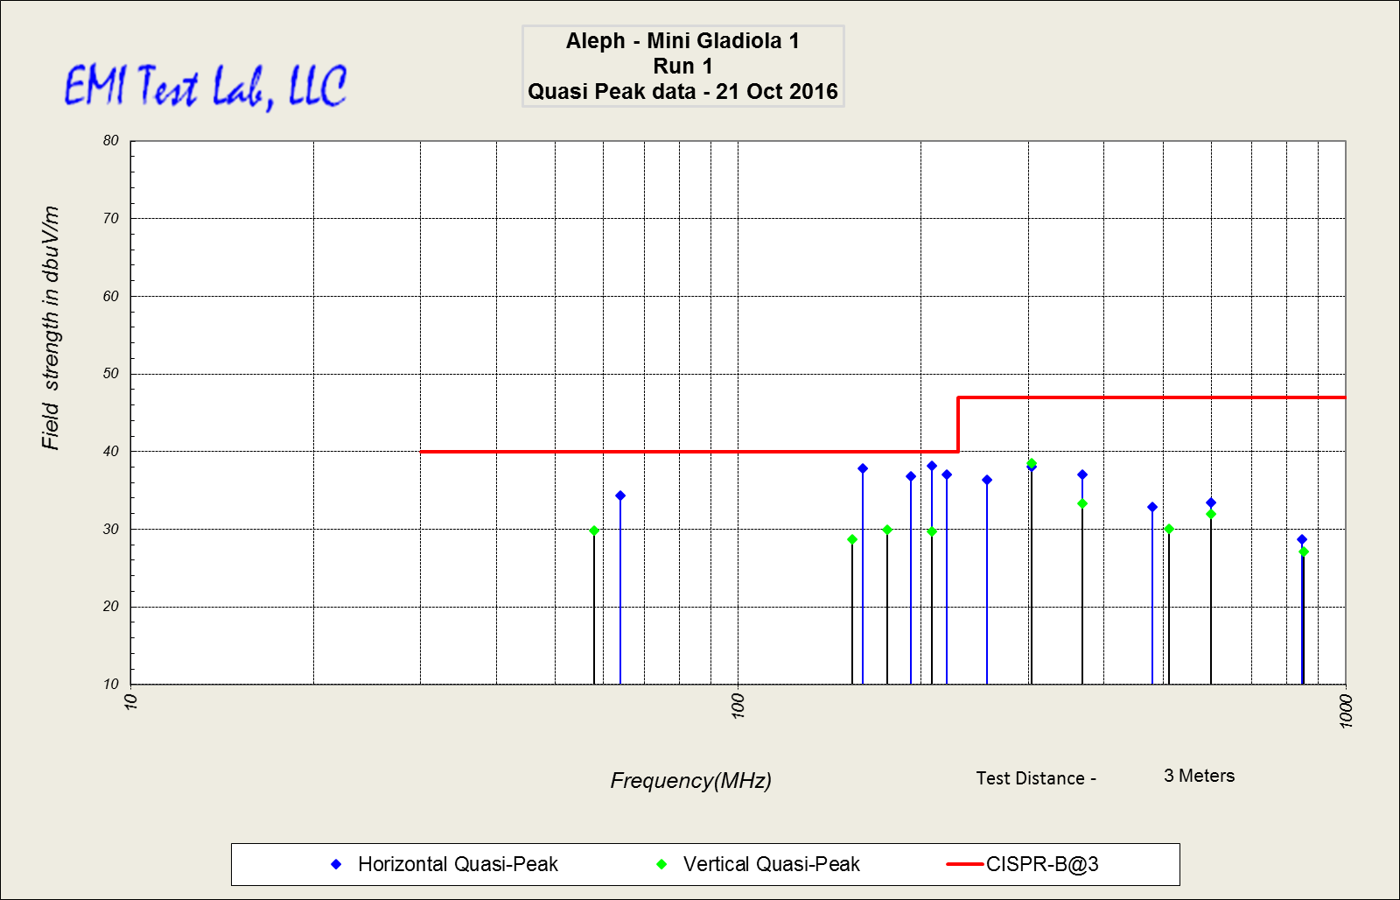
[picture p230: figure]

Run 2:

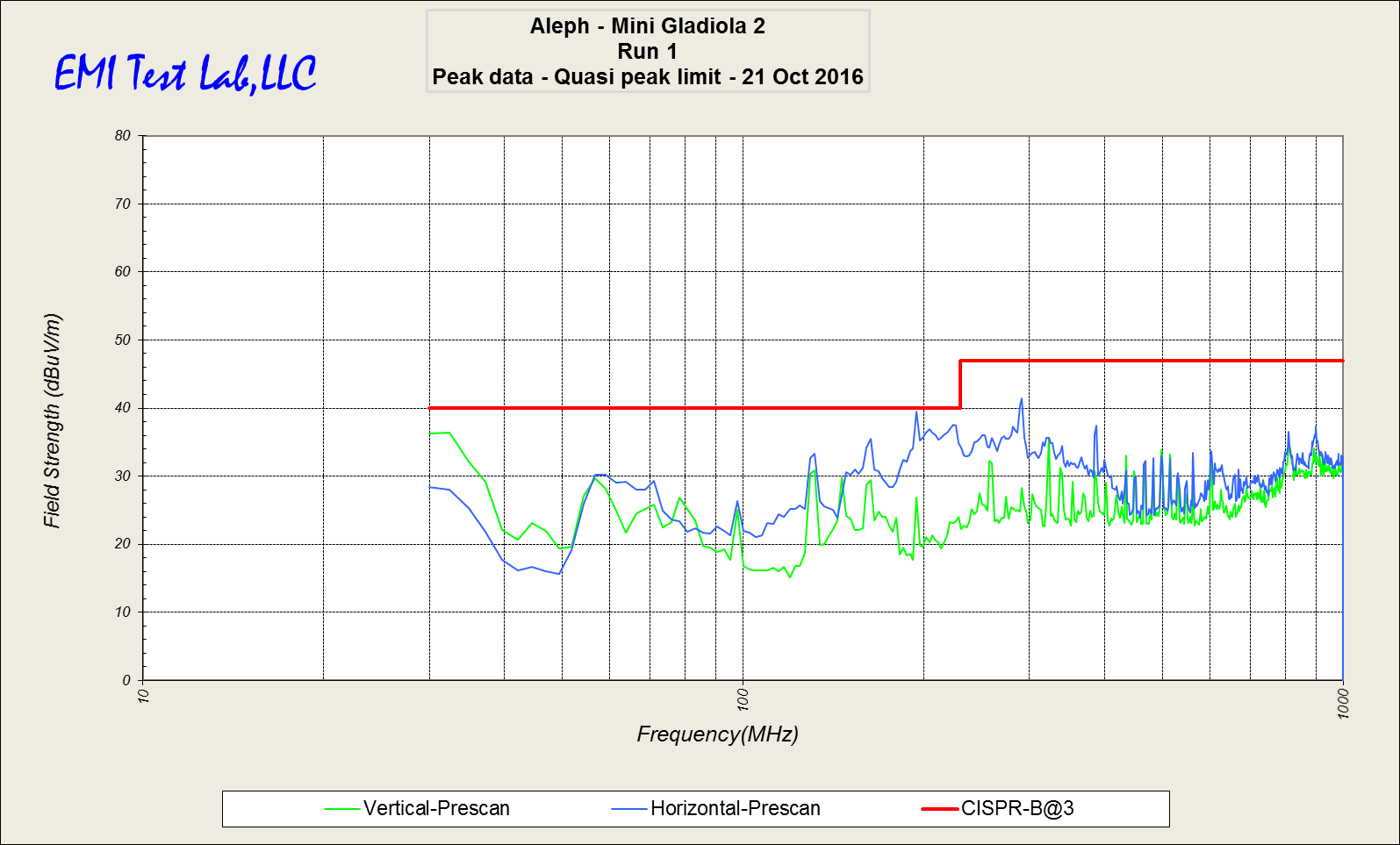
[picture p231: figure]
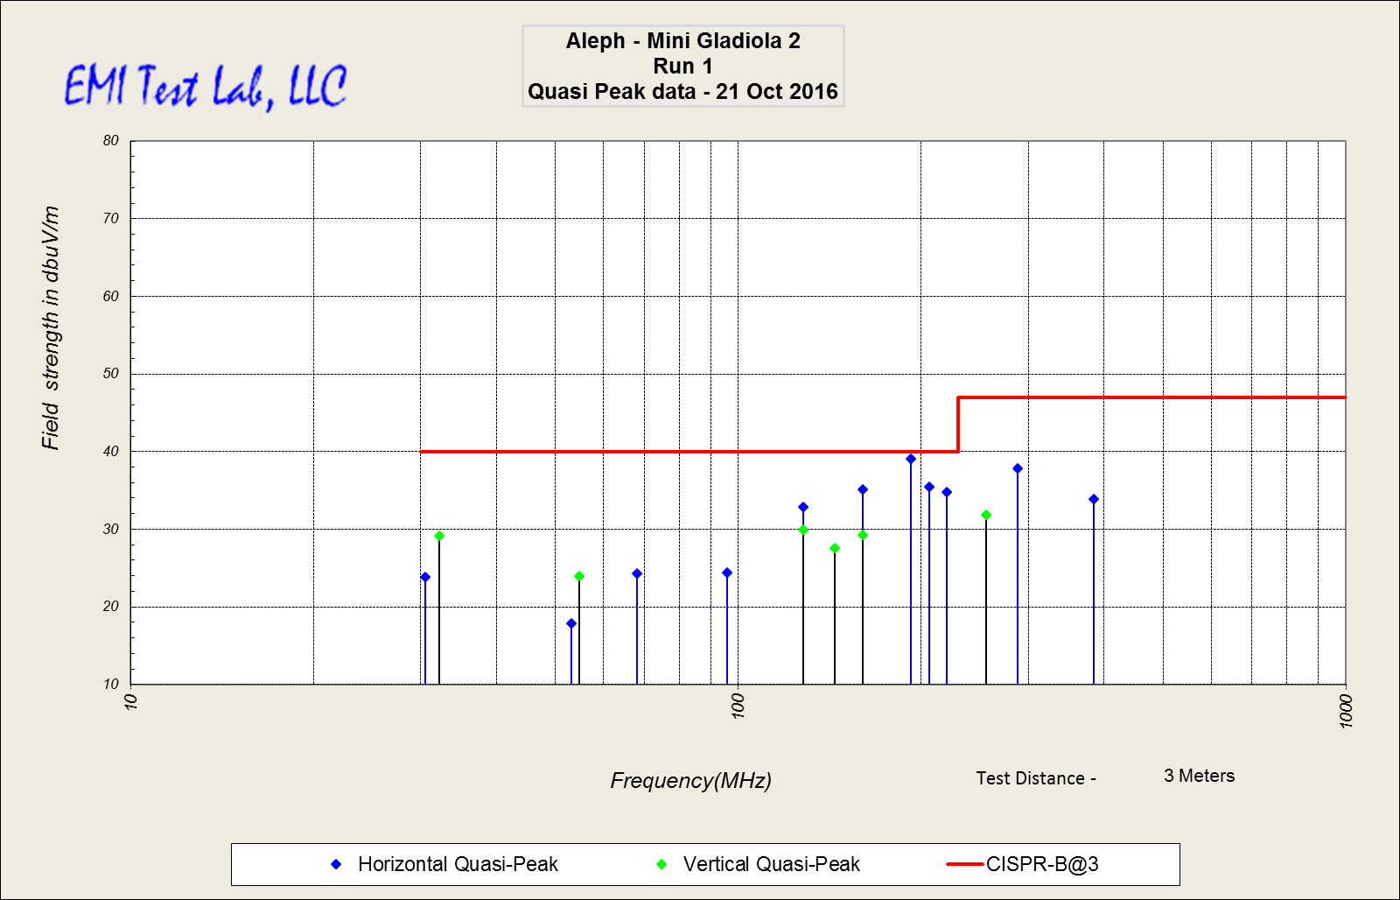
[picture p232: figure]

Run 3:

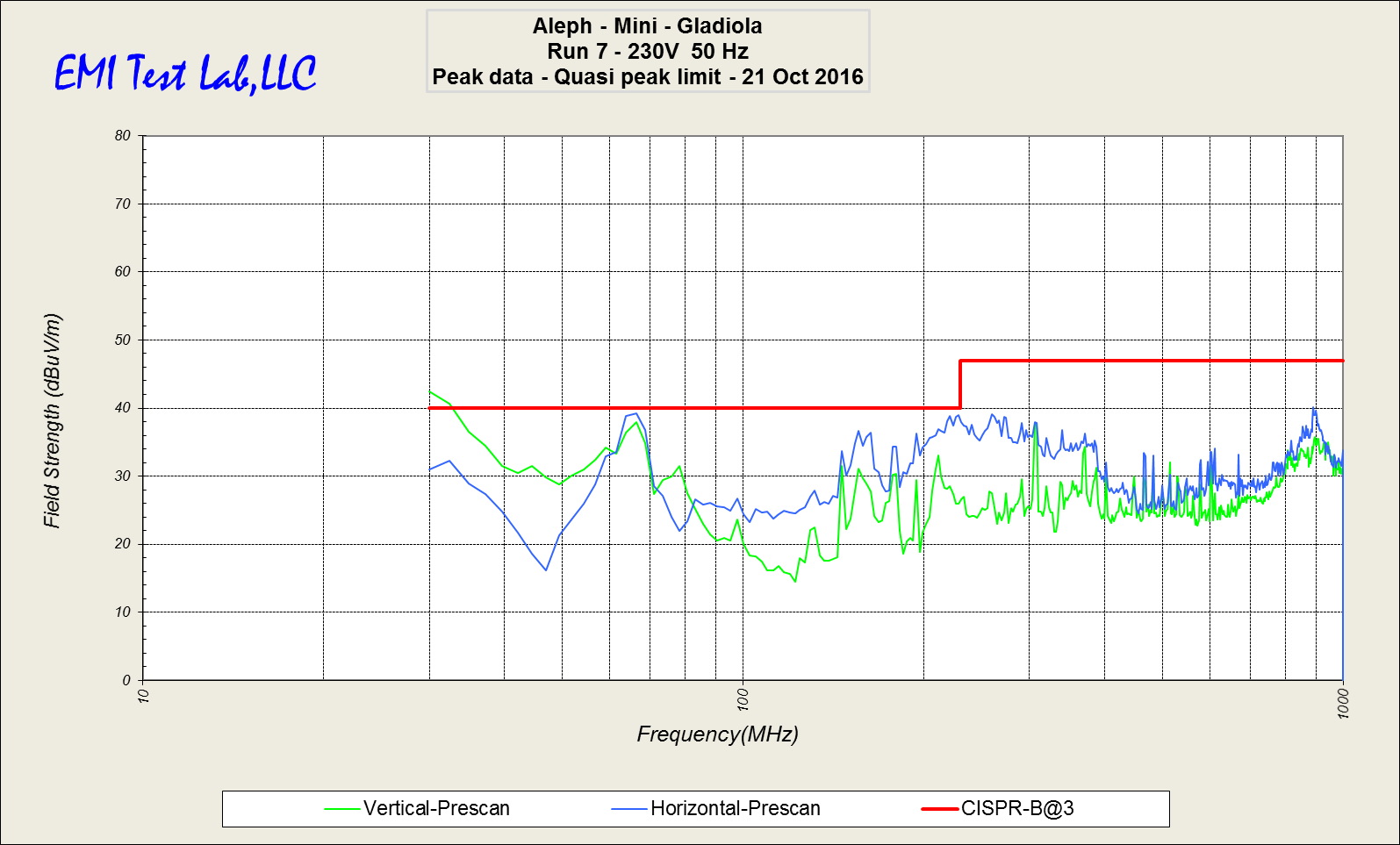
[picture p233: figure]
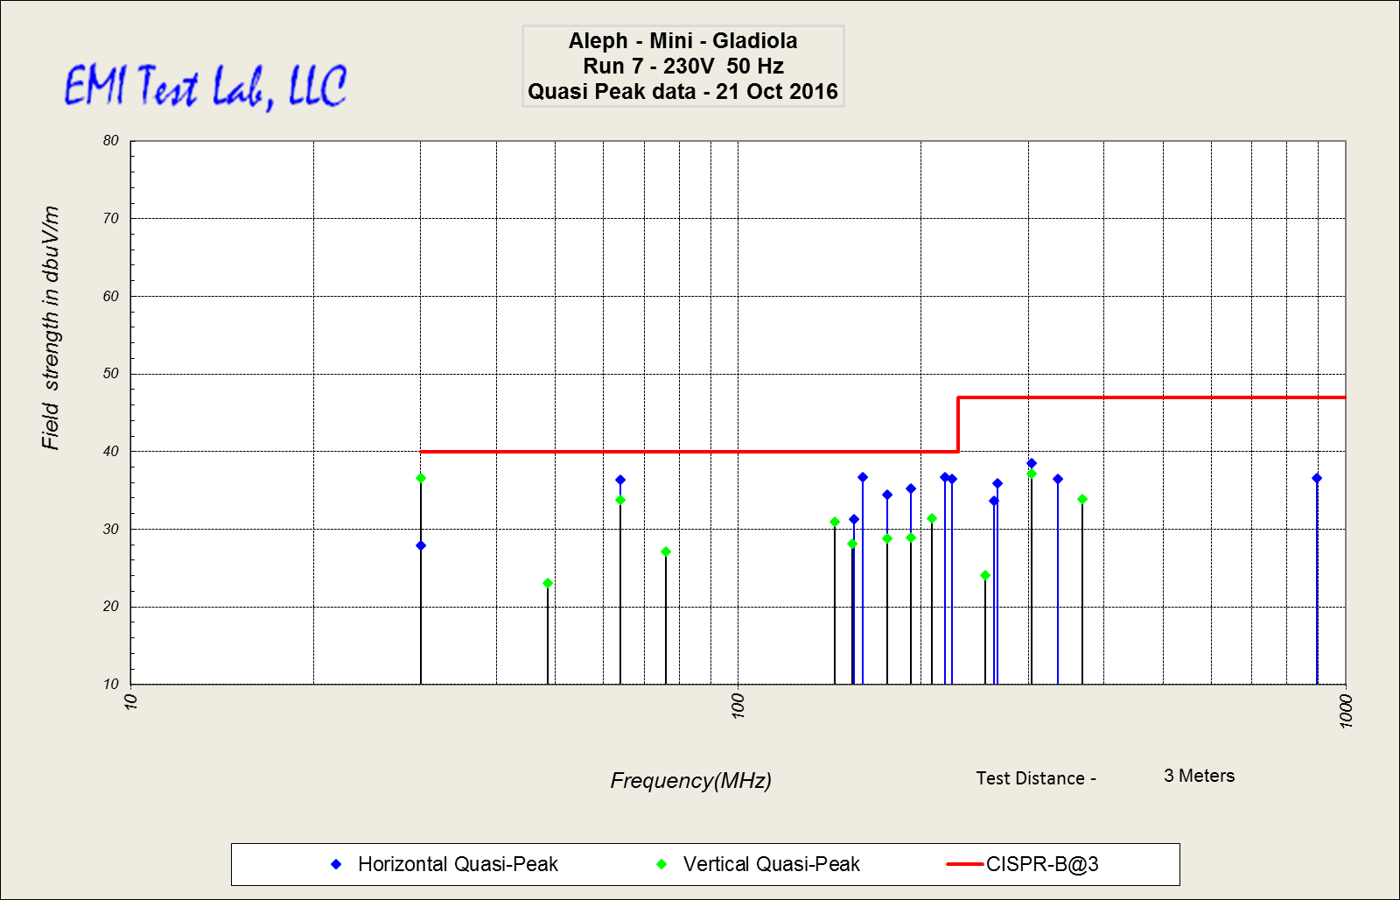
[picture p234: figure]

The following data was gathered on 09/26/2016 when Gladiola Mini passed radiated emissions:

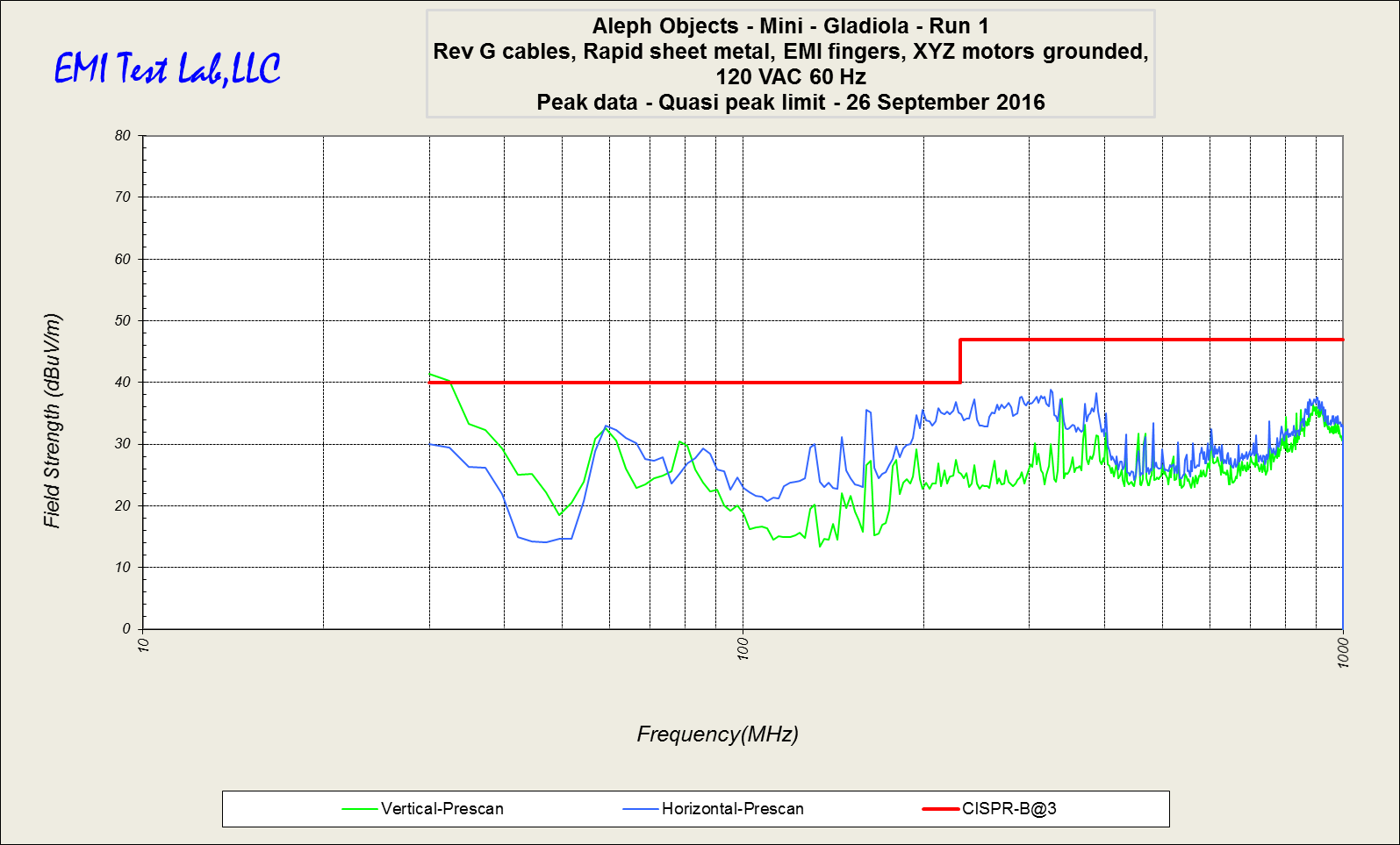
[picture p235: figure]
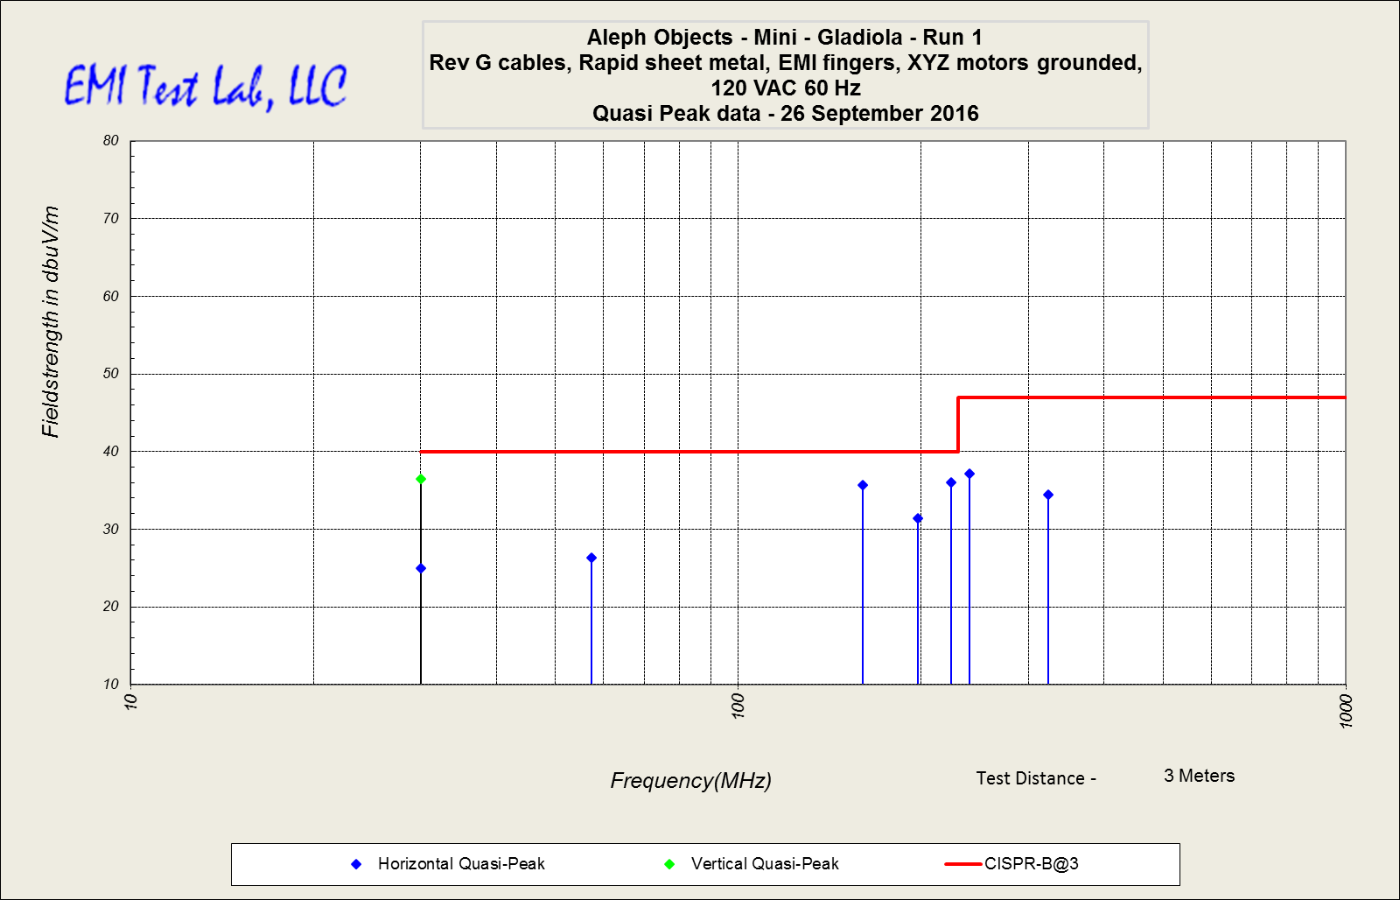
[picture p236: figure]

Quasi-peak Table:

Here is a table showing the unit passing on 09/26/16 with all margins -0.98dBμV/m or (absolute) greater from the CISPR 22 limit line:

Run 1:

Run 2:

Run 3:

Here is a table showing the unit passing on 09/26/16 with all margins -3.5dBμV/m or (absolute) greater from the CISPR 22 limit line:

LULZBOT TP-RD-00016, Test Plan
