reprapperMC/mini-gladiola/production_parts/machined_parts/hexagon_hotend/Testing/test_chart.ods

 |  |  | 104NT-4-R025H43G |  |  |  | 104NT-4-R025H42G
 | Current | Current | 3G, Crimp | 3G, crimp | 3G, solder | 3G, Solder | 2G, Crimp | 2G, Crimp | 2G, Crimp | 2G, Crimp
Set Point | Test #1 | Test #2 | Test #3 | Test #4 | Test #5 | Test #6 | Test #7 | Test #8 | Test #9 | Test #10
50 | 49.8 | 50.1 | 48.8 | 48.5 | 48.8 | 49 | 49.9 | 49.9 | 50.1 | 49.9
100 | 98.9 | 99.2 | 97.2 | 96.2 | 96.5 | 96.8 | 99.2 | 99.1 | 99.5 | 99.3
150 | 148.4 | 149 | 145.1 | 144.2 | 144.5 | 144.6 | 149.1 | 149 | 149.3 | 149
200 | 197.2 | 197.9 | 192.2 | 191 | 190.9 | 191.1 | 198.2 | 198.1 | 198.6 | 198.3
250 | 243.1 | 243.7 | 236 | 235 | 234.5 | 234.8 | 245.1 | 244.4 | 245.3 | 244.6
290 | 280.1 | 281 | 269.9 | 268.2 | 268.5 | 269.2 | 282 | 280.9 | 282 | 281.3
 |  | 1&2 AVG | #3 % diff | #4 % diff | #5 % diff | #6 % diff | #7 % diff | #8 % diff | #9 % diff | #10 % diff
 |  | 49.95 | 2.30% | 2.90% | 2.30% | 1.90% | 0.10% | 0.10% | -0.30% | 0.10%
 |  | 99.05 | 1.87% | 2.88% | 2.57% | 2.27% | -0.15% | -0.05% | -0.45% | -0.25%
 |  | 148.7 | 2.42% | 3.03% | 2.82% | 2.76% | -0.27% | -0.20% | -0.40% | -0.20%
 |  | 197.55 | 2.71% | 3.32% | 3.37% | 3.26% | -0.33% | -0.28% | -0.53% | -0.38%
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
