reprapperMC/mini-gladiola/production_docs/test_docs/Data Summary 26 September 2016.ods

Sheet: Run 3 - Conducted Line
Frequency (MHz) | QP Limit | Average Limit | EUT--Line QP | Average Disturbance | Pre-Scan (Peak) | Average |  | Class B QP CE Limits | Class B Average CE Limits
0.15 | 66.00 | 56.00 |  |  | 45.7 | 25.9 | 0.15 | 66 | 56
0.16 | 65.71 | 55.71 |  |  | 52.7 | 33.8 | 0.5 | 56 | 46
0.17 | 65.43 | 55.43 |  |  | 53.6 | 36.8 | 0.5 | 56 | 46
0.18 | 65.14 | 55.14 |  |  | 53.5 | 35.4 | 5 | 56 | 46
0.19 | 64.86 | 54.86 |  |  | 51.5 | 35.6 | 5 | 60 | 50
0.2 | 64.57 | 54.57 |  |  | 50.1 | 32.4 | 30 | 60 | 50
0.21 | 64.29 | 54.29 |  |  | 50.4 | 25.6
0.22 | 64.00 | 54.00 |  |  | 43.6 | 22.3
0.23 | 63.71 | 53.71 |  |  | 36.8 | 21.5
0.24 | 63.43 | 53.43 |  |  | 34.7 | 21.6
0.25 | 63.14 | 53.14 |  |  | 40.7 | 22.7
0.26 | 62.86 | 52.86 |  |  | 40.9 | 23.7
0.27 | 62.57 | 52.57 |  |  | 40.4 | 23.8
0.28 | 62.29 | 52.29 |  |  | 40.1 | 26.2
0.29 | 62.00 | 52.00 |  |  | 40 | 25.4
0.3 | 61.71 | 51.71 |  |  | 39.6 | 25.3
0.31 | 61.43 | 51.43 |  |  | 39.1 | 25
0.32 | 61.14 | 51.14 |  |  | 38.8 | 22.9
0.33 | 60.86 | 50.86 |  |  | 35.8 | 23.5
0.34 | 60.57 | 50.57 |  |  | 39.2 | 21.8
0.35 | 60.29 | 50.29 |  |  | 40.9 | 22.2
0.36 | 60.00 | 50.00 |  |  | 41 | 23.1
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
