reprapperMC/mini-gladiola/production_parts/machined_parts/hexagon_hotend/Notes_for_changes.odt

Notes for changes

Tested

- New thermistor testing is done – Use the Semtech 104NT-4-R025H42G Thermistor
- New wires, shields and tubing have been chosen
- Leak testing
- Removing tube set screw was a bad idea, add it back
- Add Thermal transfer grease between Center tube and cooling block – Don't put it in
- Press in Center tube and swage in one step. Shouldn't need set screw – We do want set screw – document procedure
- check the tolerances on the short nozzles, make like the long – drawing updated
- long duration prints – Have done several 5-7 hour prints and all have done just fine

Testing

- Test Electroless Nickel with no PTFE – working OK so far

- Testing one in cluster marked as clone (5 dot unit)

- Have run ABS, PLA, PCTPE, Ninjaflex, Semiflex, HIPS, bronzefill and woodfill through

- Tribocoat HT – 750C (398F)
  - How to test?
  - Long term test?
  - Burn?
- Part tolerances – Parts from MBK are iffy
- Having thermistor assemblies made – No on Allcable, find someone else
- New heater cartridges from multiple sources – only one has arrived and the one tested works fine, longer though
- Speed tests – One nozzle given to Brent to do speed tests
- Add more test units to cluster
- Long heater block and nozzle for larger sizes

Future

- Make cooling block round – add set screw
- Increase thermistor groove size to accept both black insulation pieces in
- remove PTFE wire insulation on thermistor wires – smaller size of black insulation?
- Make nozzle flange larger for better seal?
- Add tube set screw back for possible thermal expansion issues – Yes
- Polished Stainless/Nickel with no PTFE/Nickel with PTFE?
- Pick better wire for thermistor
