reprapperMC/mini-gladiola/production_parts/machined_parts/electronics_case/mini_chassis_SilkScreen_Oct2017_outlined.pdf

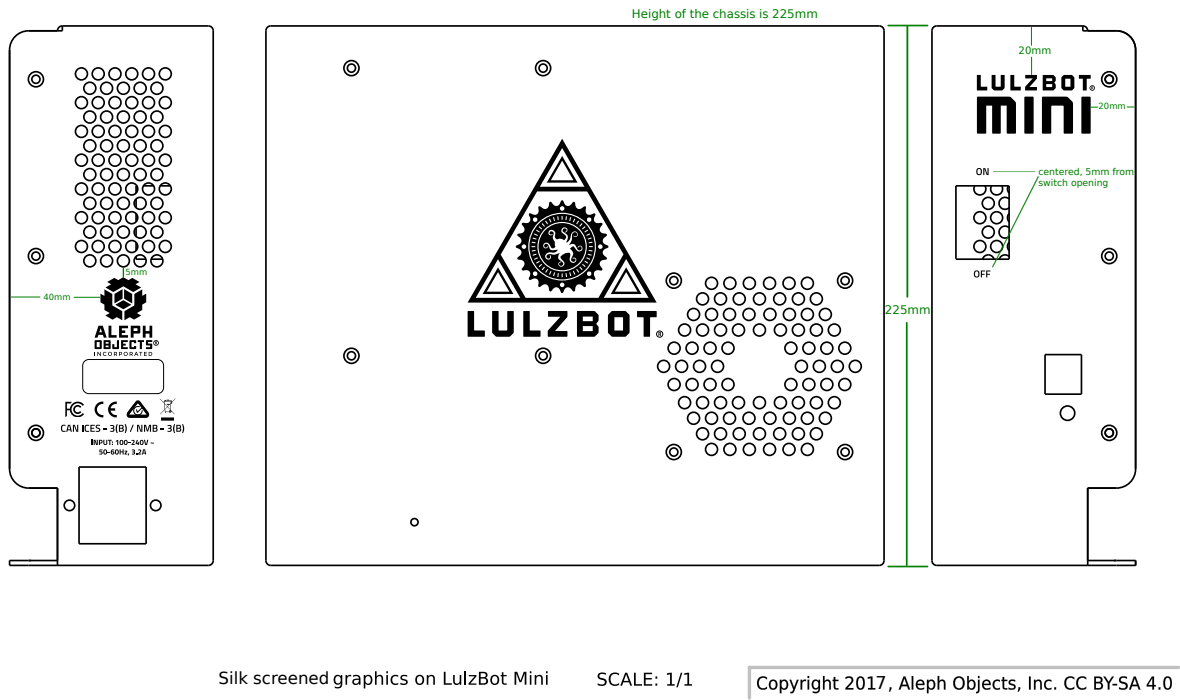
[picture p290: page 1]
centered, 5mm from switch opening; Silk screened

Height of the chassis is 225mm
