reprapperMC/mini-gladiola/production_parts/machined_parts/graphics/mini_chassis_corrected_Sept2016.pdf

# MINI

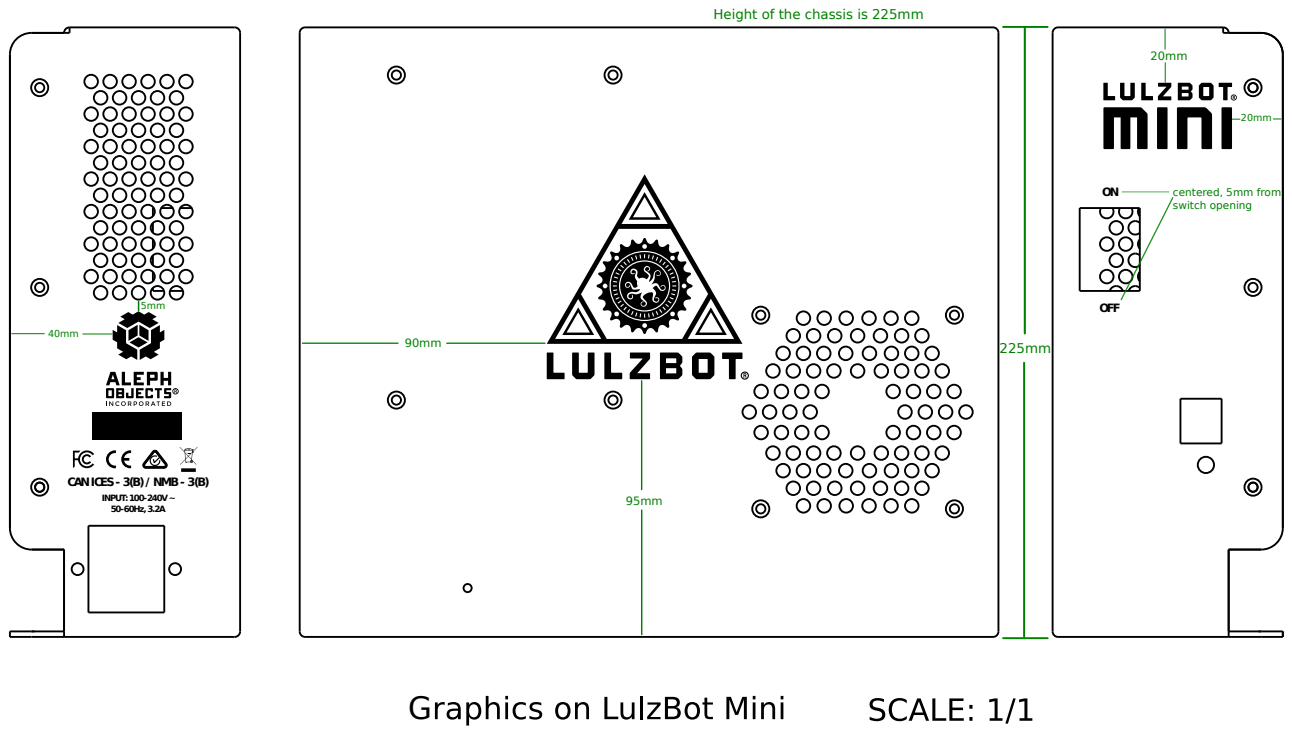
[picture p291: page 1]
OFF; INPUT: 100-240V ~ 50-60Hz, 3.2A; centered, 5mm from switch opening

Height of the chassis is 225mm

CAN ICES - 3(B) / NMB - 3(B)
