reprapperMC/mini-gladiola/production_parts/machined_parts/8_mm_rod/8x19mm_Smooth_Rod_RevB_HD-RD0004.pdf

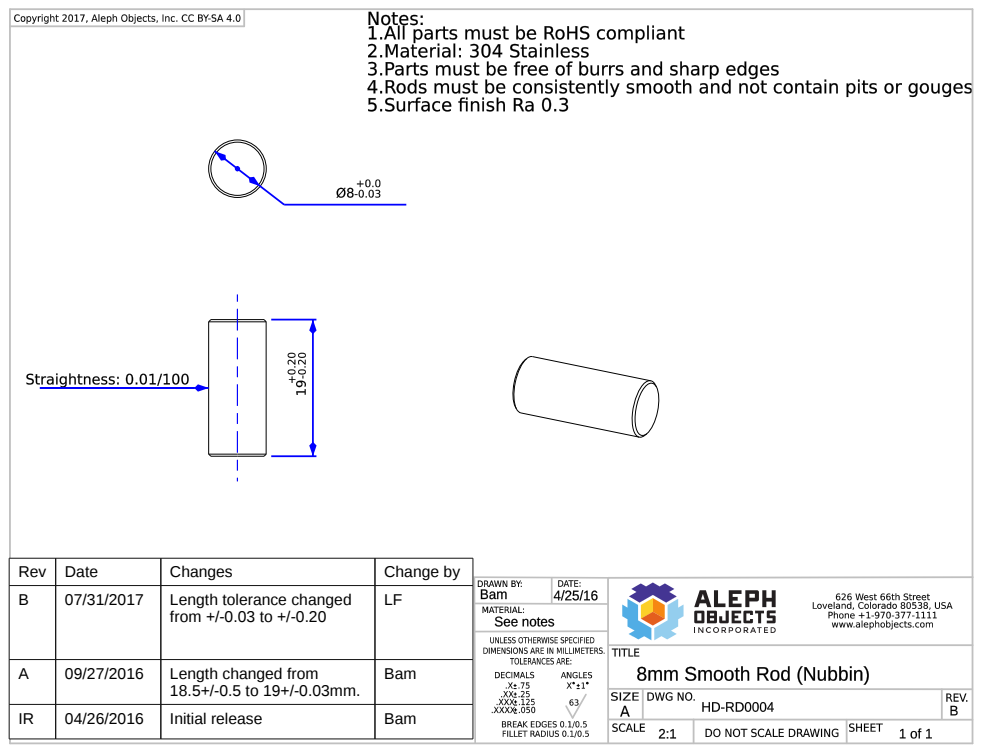
[picture p292: page 1]

Rev | Date | Changes | Change by
B | 07/31/2017 | Length tolerance changed from +/-0.03 to +/-0.20 | LF

A | 09/27/2016 | Length changed from 18.5+/-0.5 to 19+/-0.03mm. | Bam

IR | 04/26/2016 | Initial release | Bam
