reprapperMC/mini-gladiola/production_parts/machined_parts/hexagon_hotend/pdf/Thermistor_Assembly_v1.0.pdf

## 2X EL-MS00?? X 40mm

## 2X HD-TB0058 X 20mm

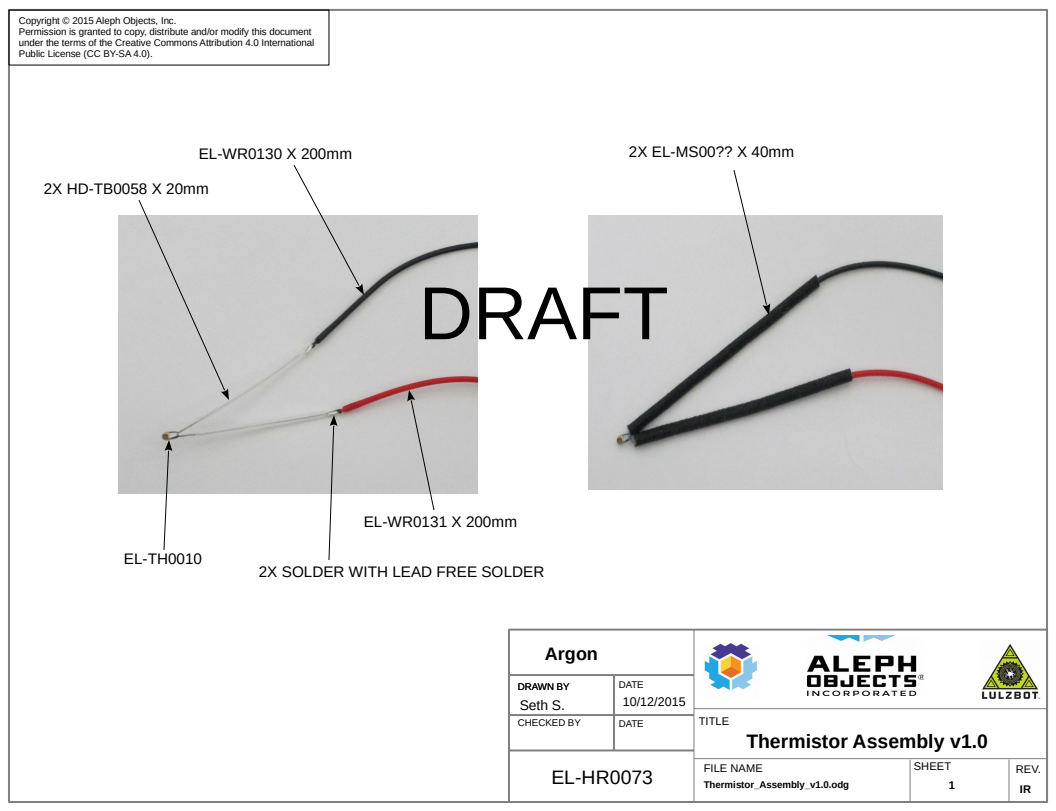
[picture p299: page 1]
TITLE; FILE NAME; SHEET; REV.; Thermistor Assembly v1.0; Thermistor_Assembly_v1.0.odg; DRAFT

Copyright © 2015 Aleph Objects, Inc.
Permission is granted to copy, distribute and/or modify this document
under the terms of the Creative Commons Attribution 4.0 International
Public License (CC BY-SA 4.0).

2X SOLDER WITH LEAD FREE SOLDER

Argon

DRAWN BY DRAWN BY Seth S. | DATE 10/12/2015

CHECKED BY | DATE
