reprapperMC/mini-gladiola/documentation/Manual/exterior_9780989378468.pdf

# FEED your mACHINE

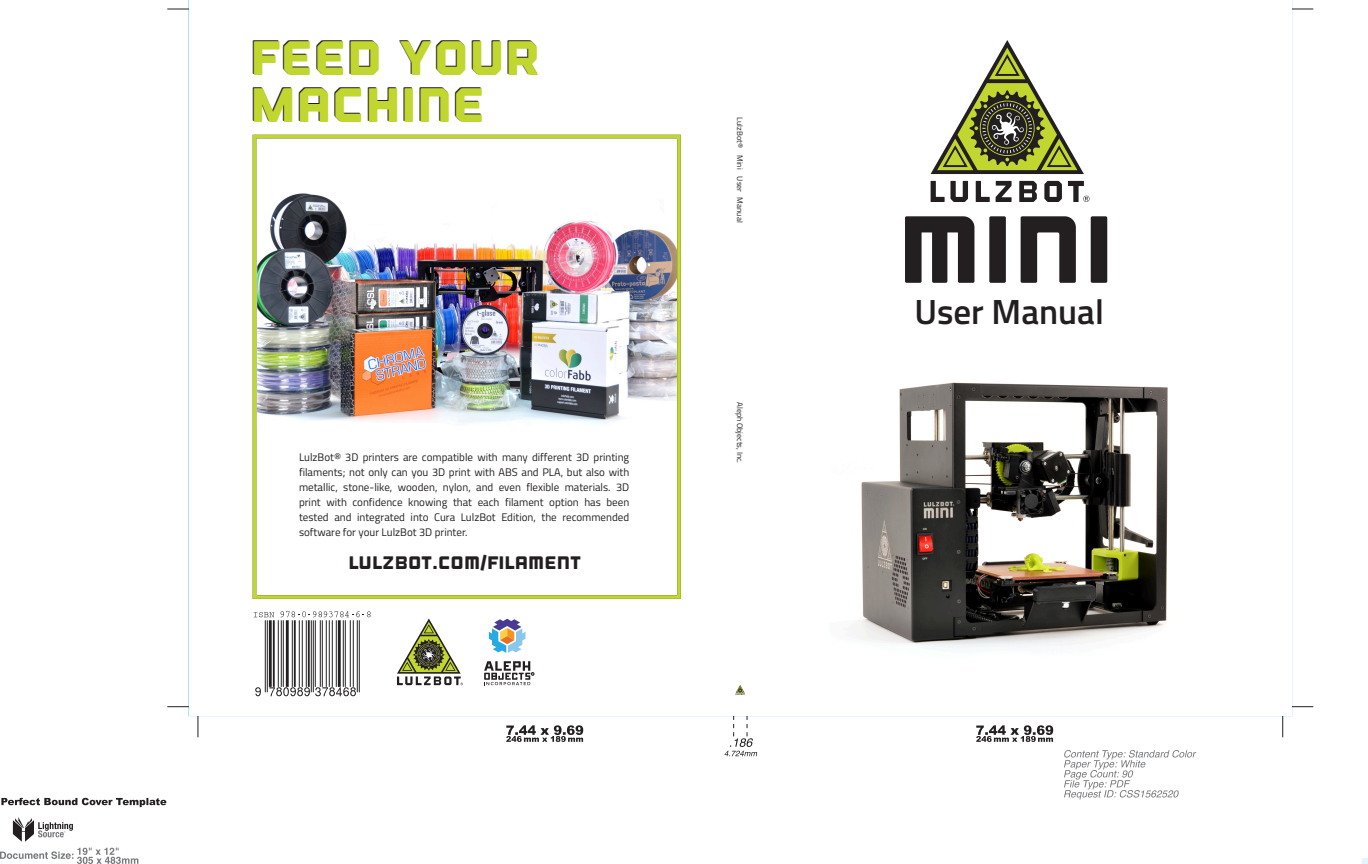
[picture p300: page 1]
User Manual; FEED your mACHINE

LulzBot® Mini User Manual Aleph Objects, Inc.
MINI

LulzBot® 3D printers are compatible with many different 3D printing
filaments; not only can you 3D print with ABS and PLA, but also with
metallic, stone-like, wooden, nylon, and even flexible materials. 3D
print with confidence knowing that each filament option has been
tested and integrated into Cura LulzBot Edition, the recommended
software for your LulzBot 3D printer.
LULZBOT.COM/FILAMENT
