reprapperMC/mini-gladiola/documentation/Quick_Start_Guide/QuickStart_Mini_COVER_8.5x5.5_SPREAD_10-16.pdf

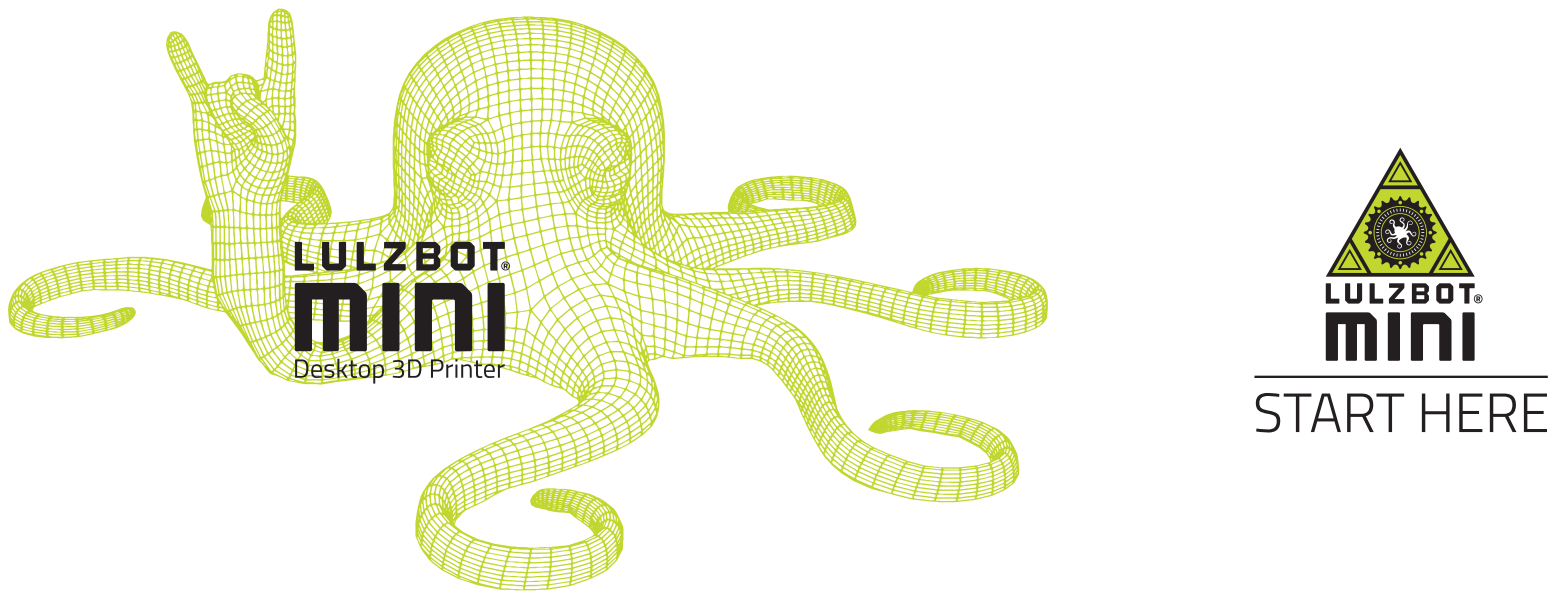
[picture p301: page 1]
