reprapperMC/mini-gladiola/production_parts/machined_parts/hotend_mount_plate/MOARstruder-mount-plate_PP-MP0156_revA.pdf

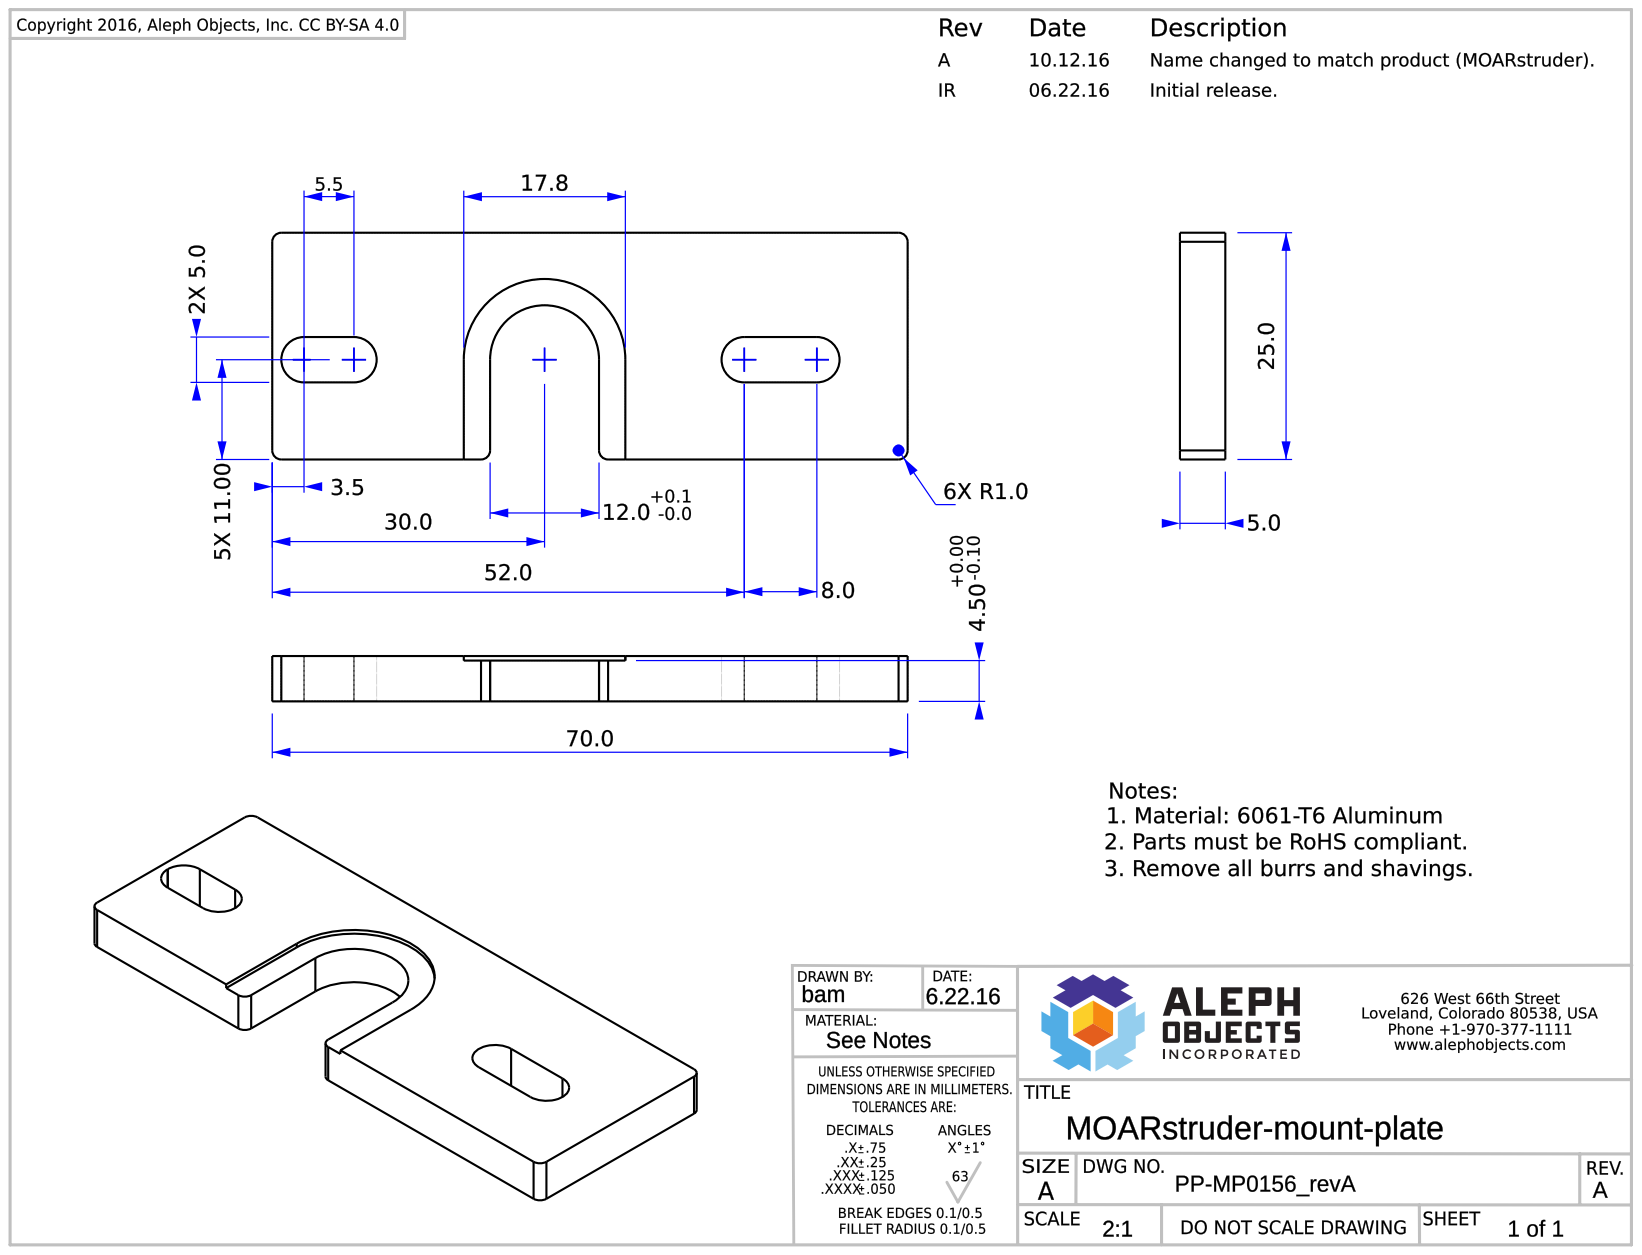
[picture p302: page 1]
