reprapperMC/mini-gladiola/production_parts/machined_parts/bed_mount_plate/bed-mount-plate-mini_PP-FP0138_revF.pdf

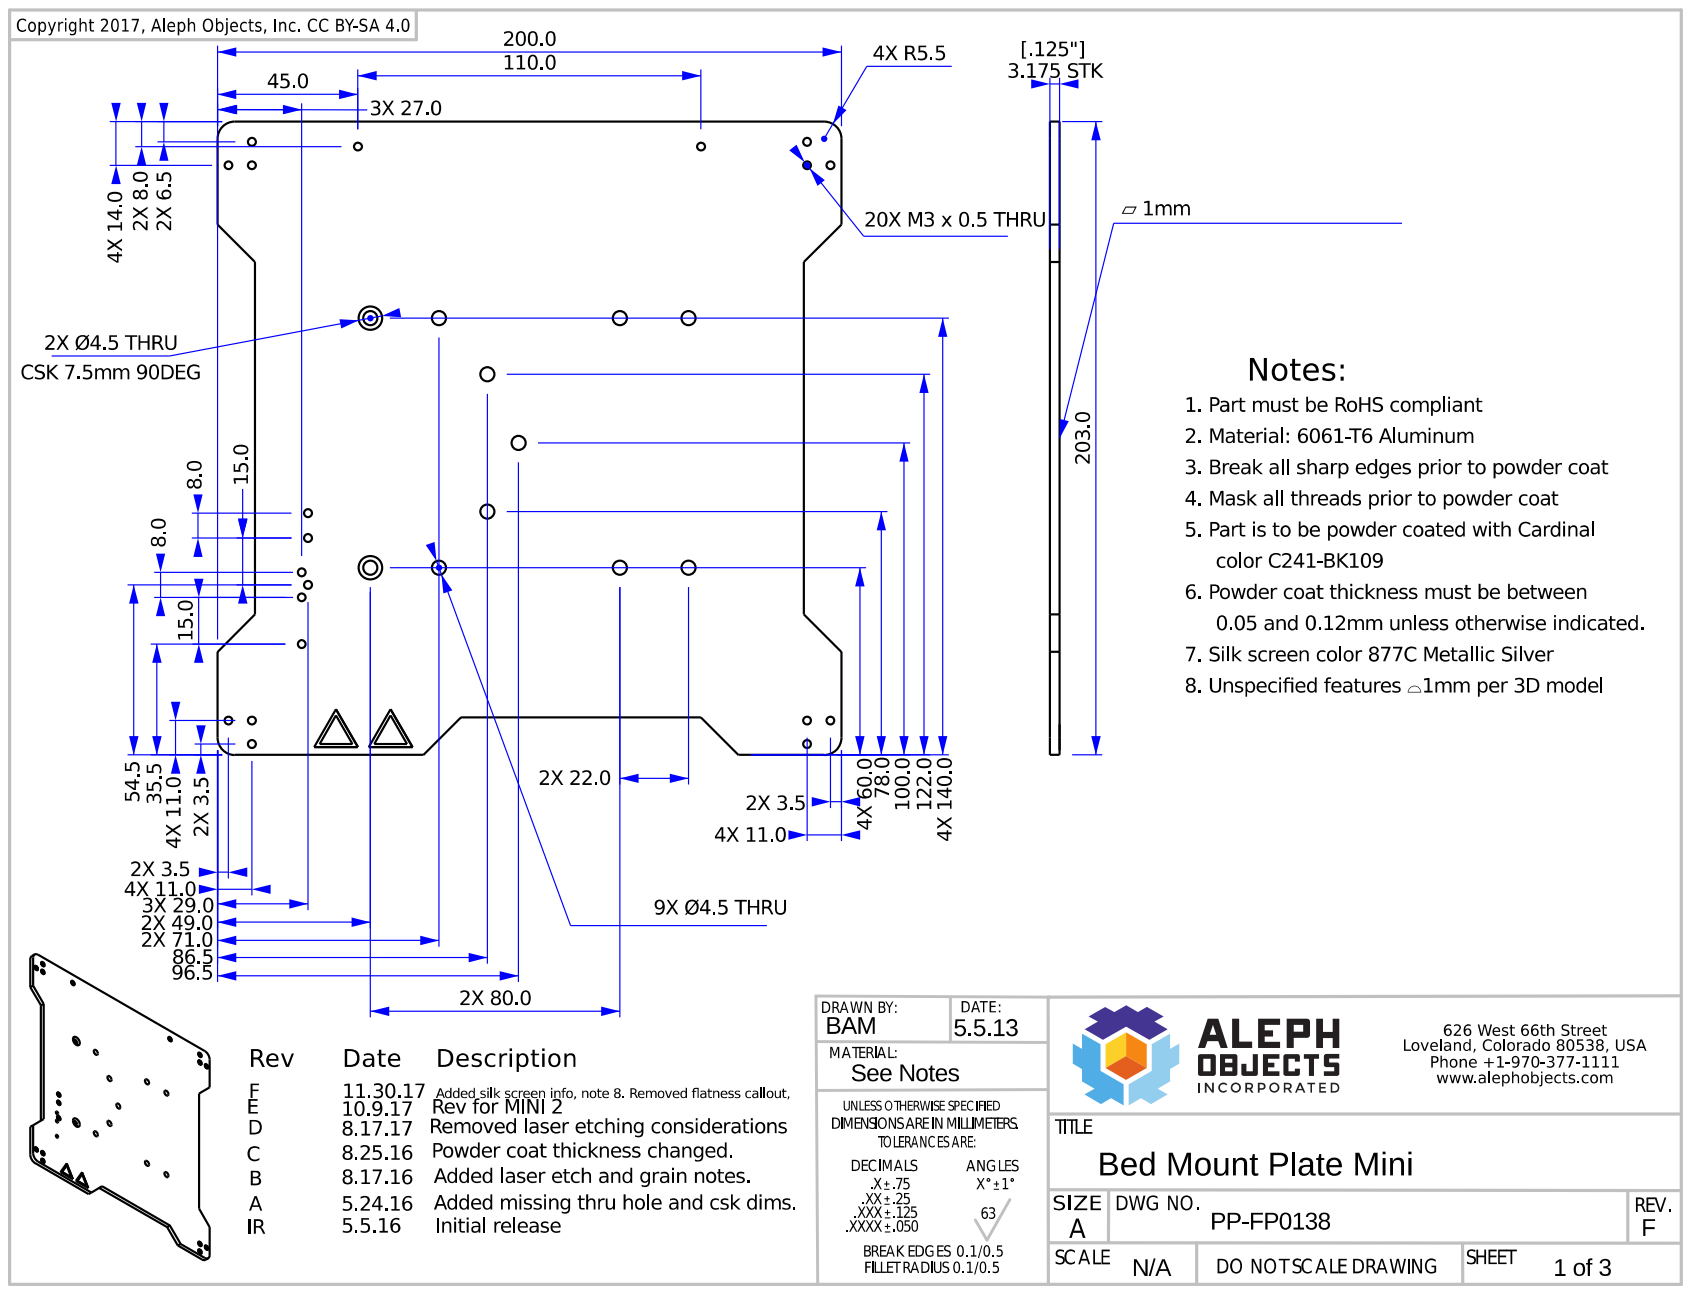
[picture p303: page 1]

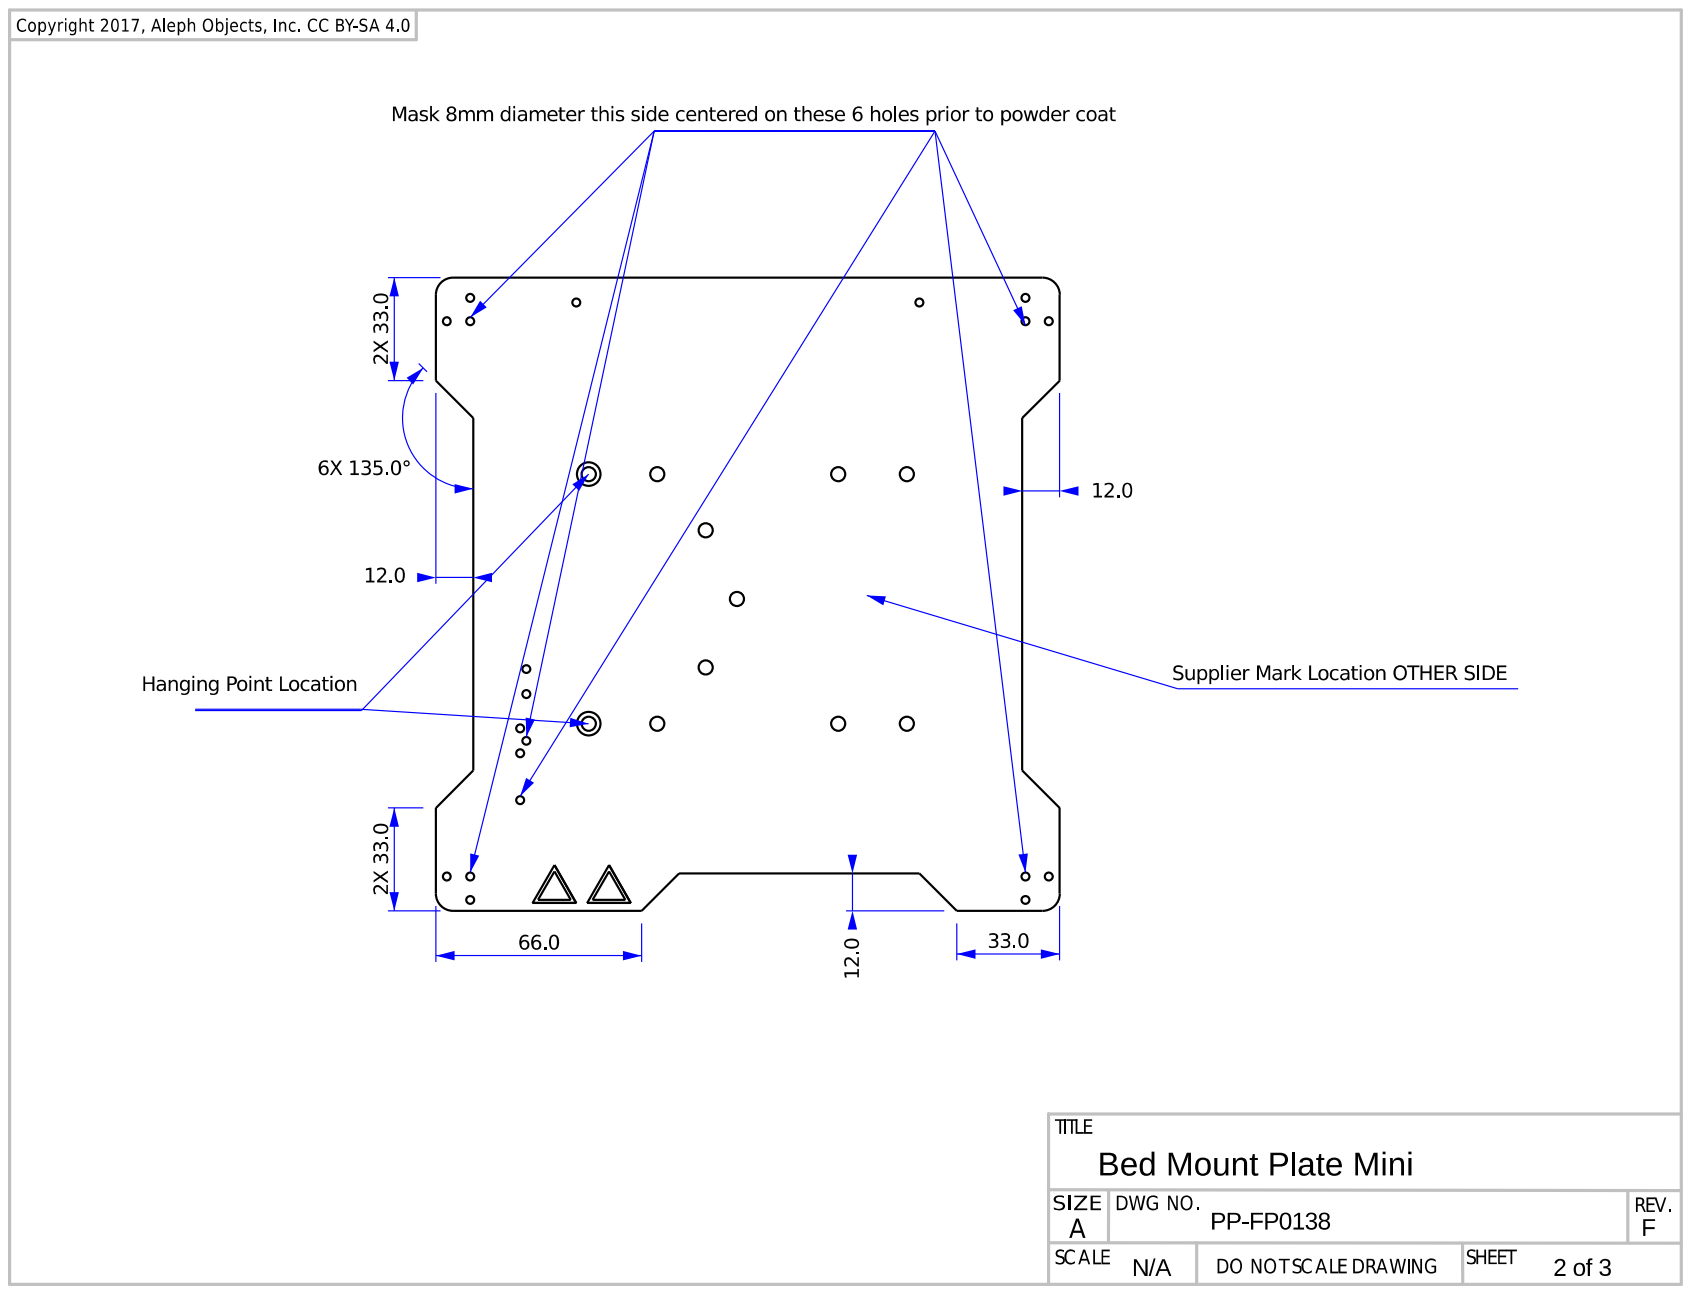
[picture p304: page 2]

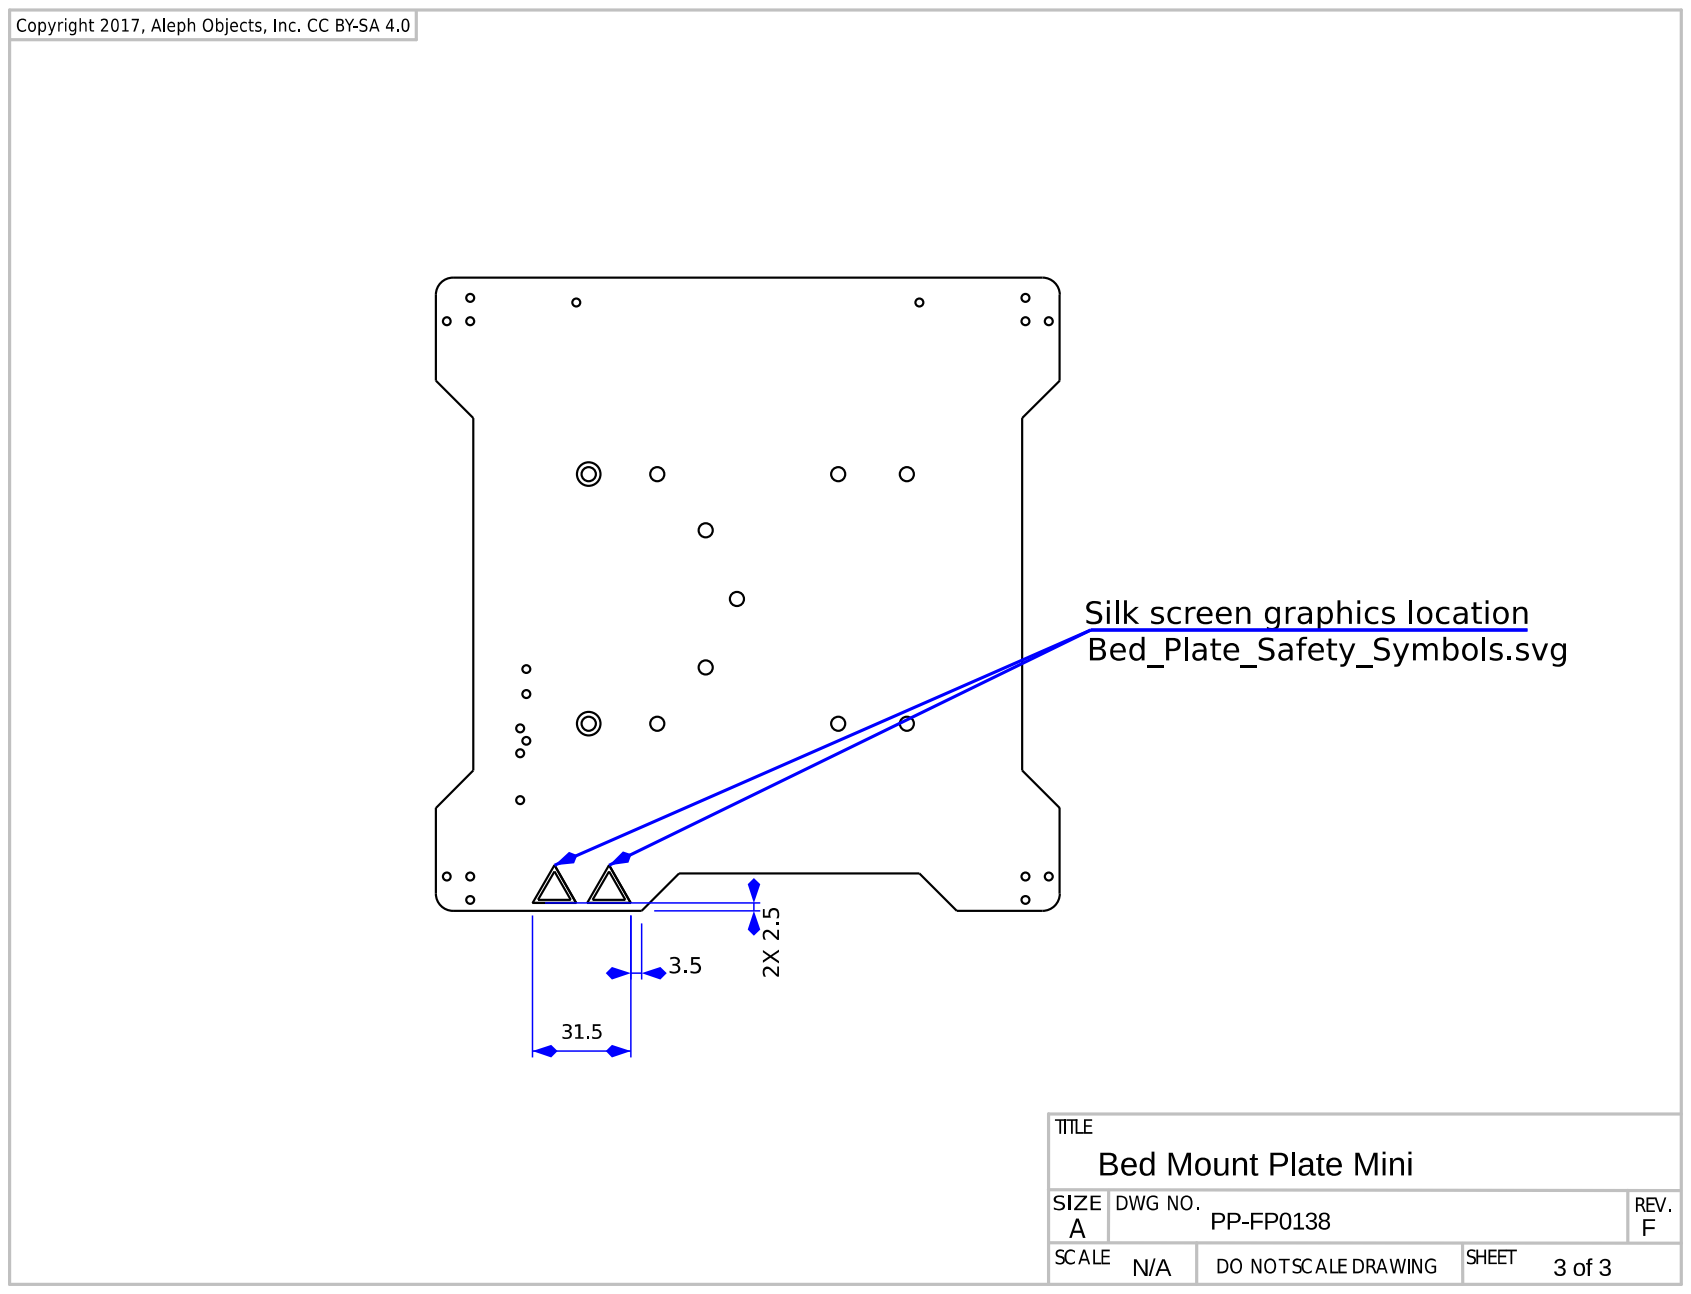
[picture p305: page 3]
