reprapperMC/mini-gladiola/production_parts/machined_parts/top_plate_mini/top-plate-mini_PP-FP0051_revH.pdf

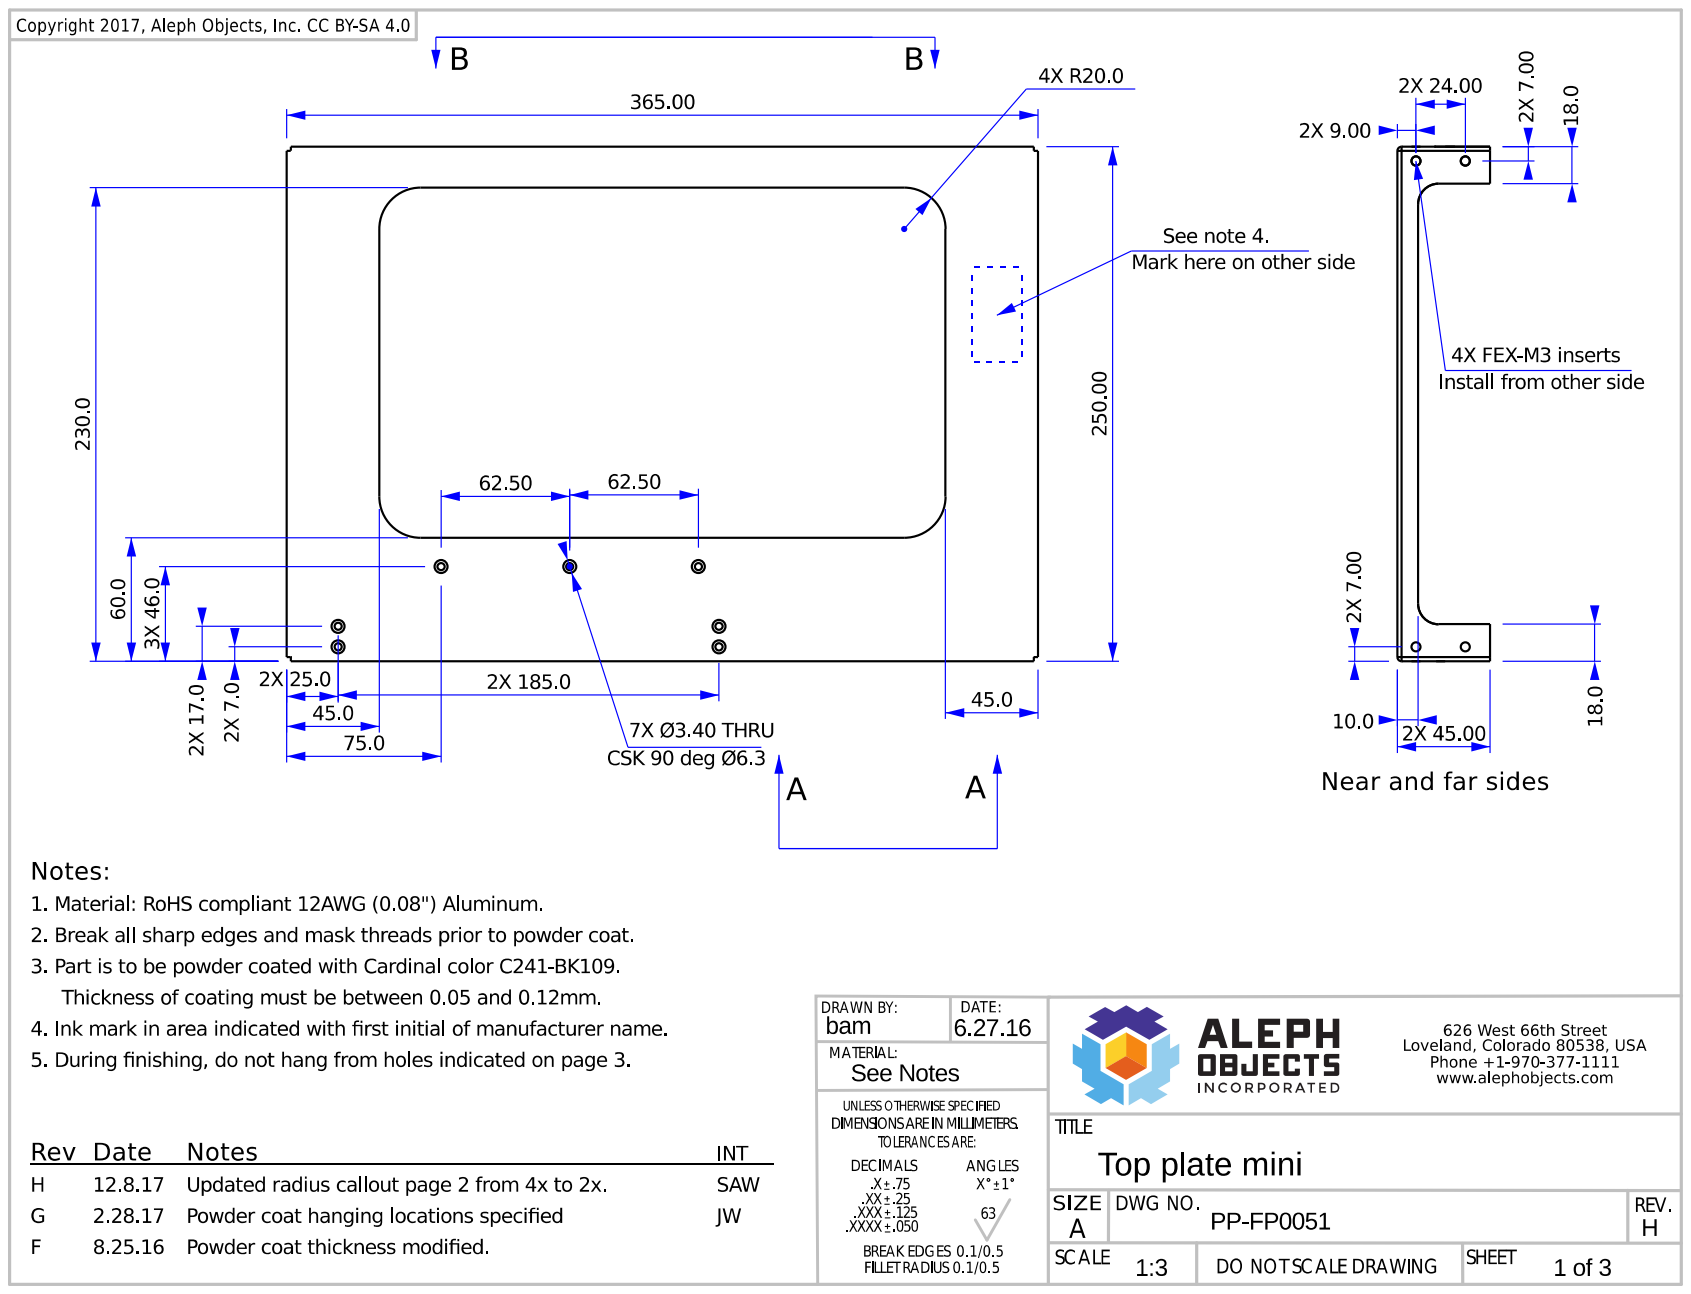
[picture p306: page 1]

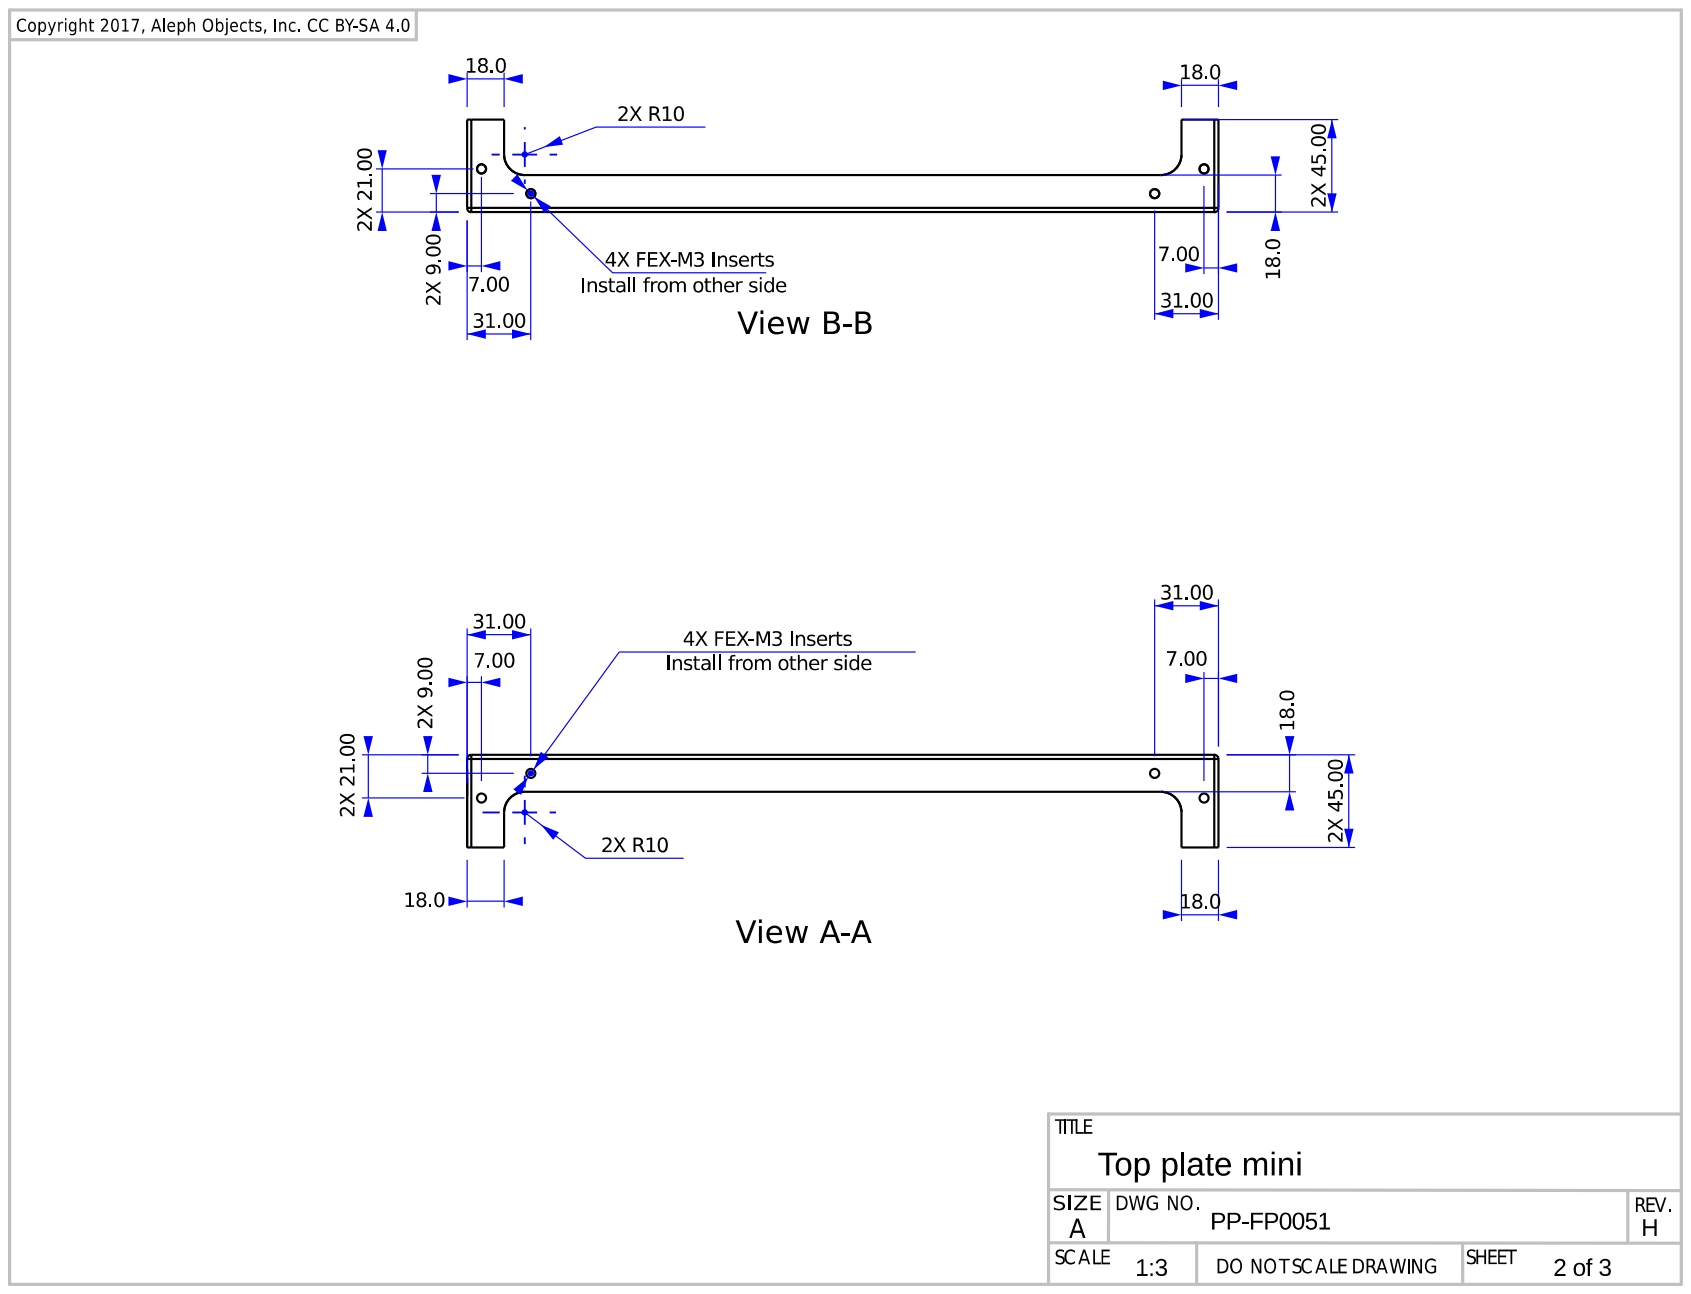
[picture p307: page 2]

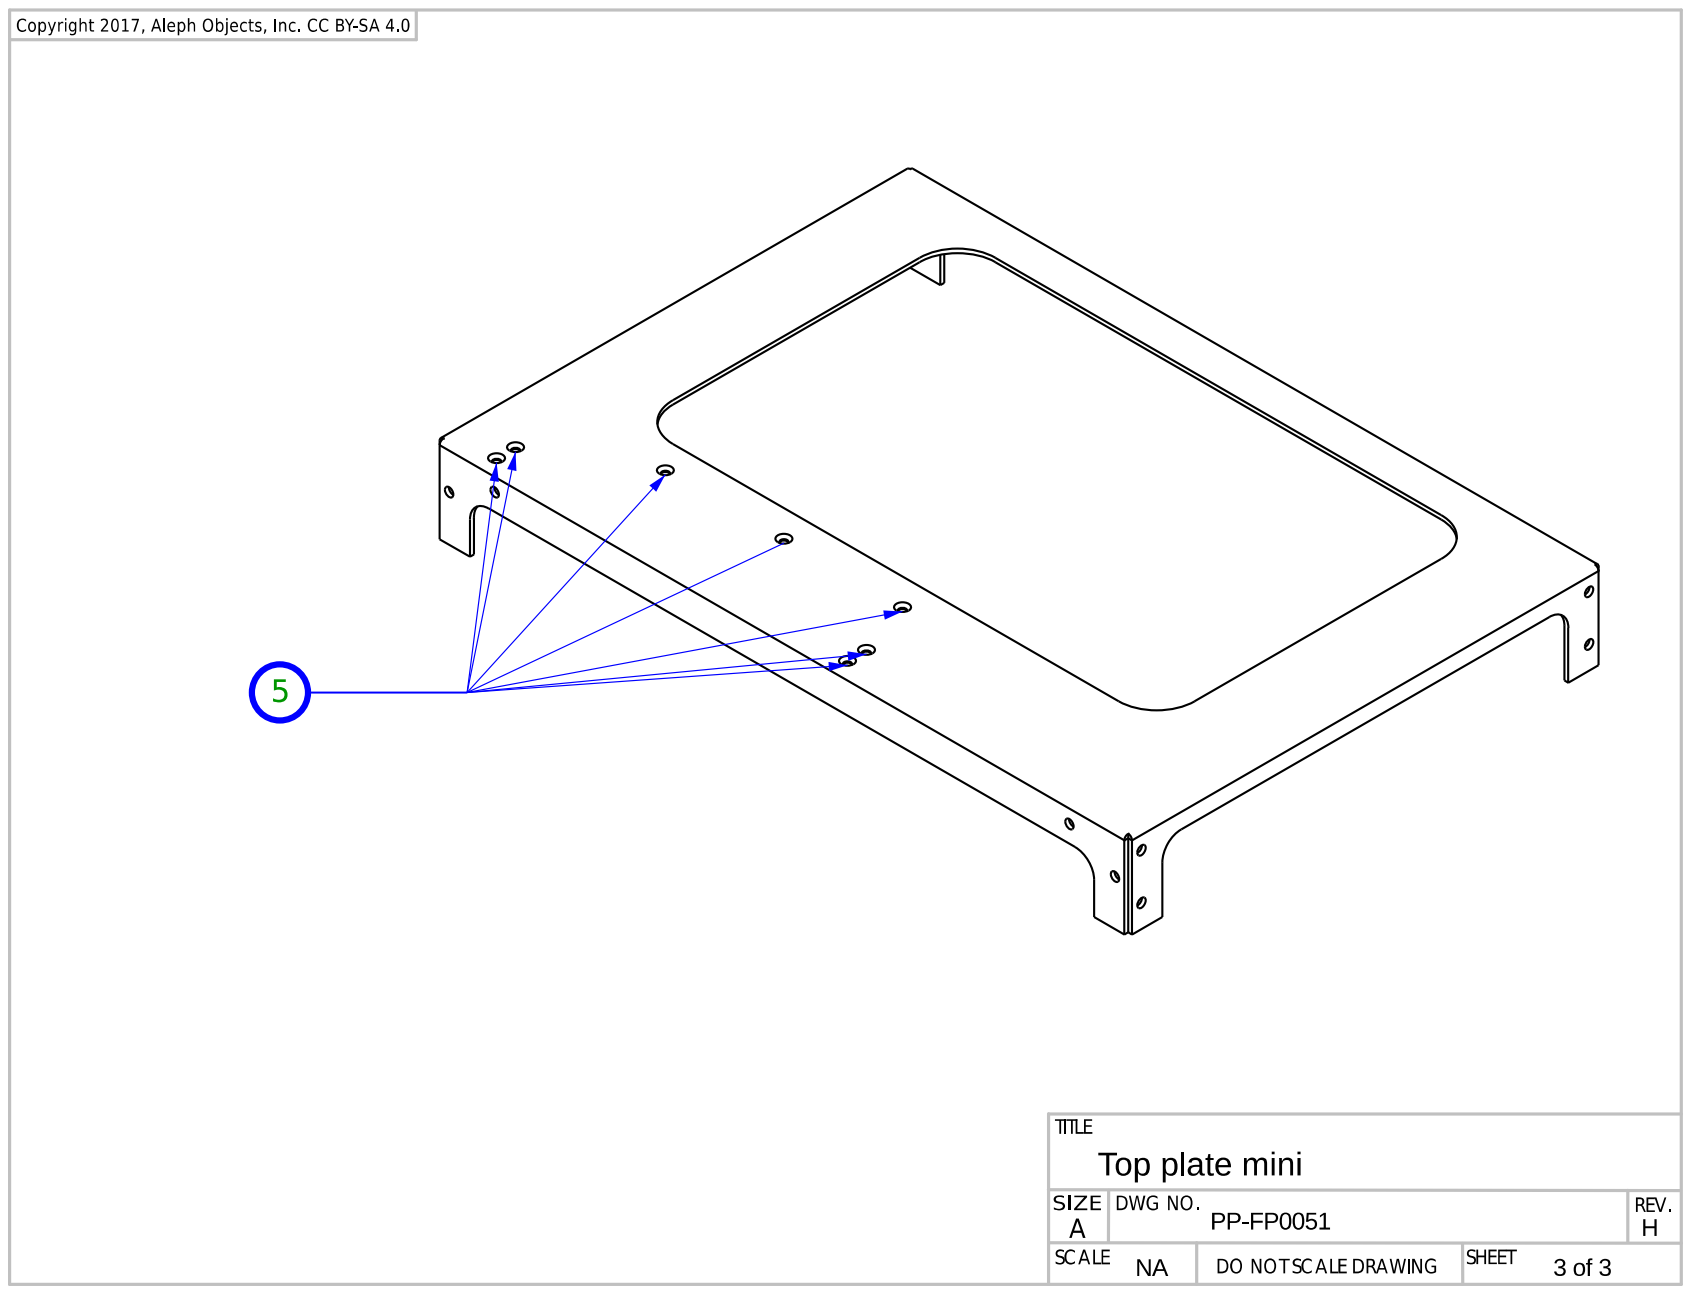
[picture p308: page 3]
