reprapperMC/mini-gladiola/production_parts/machined_parts/graphics/laser_etched_bed_mount_plate_mini_v1.1_PP-FP0081.pdf

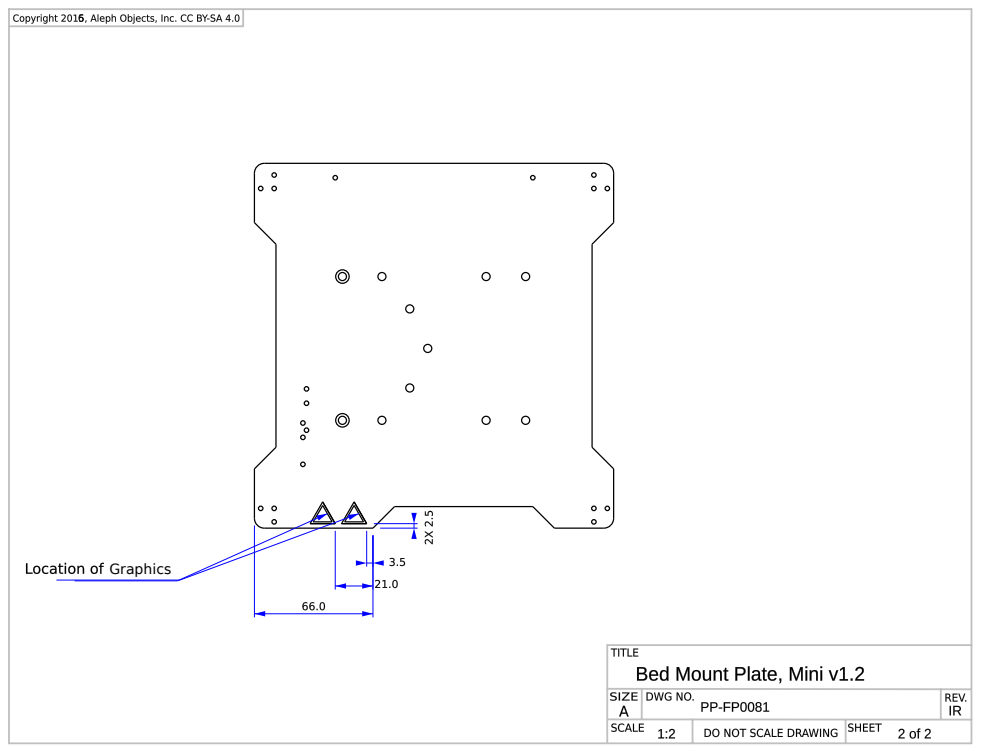
[picture p309: page 1]
Graphics
