reprapperMC/mini-gladiola/production_parts/machined_parts/drive_rods/drive_rod_10mm_mini_HD-RD0037_revF.pdf

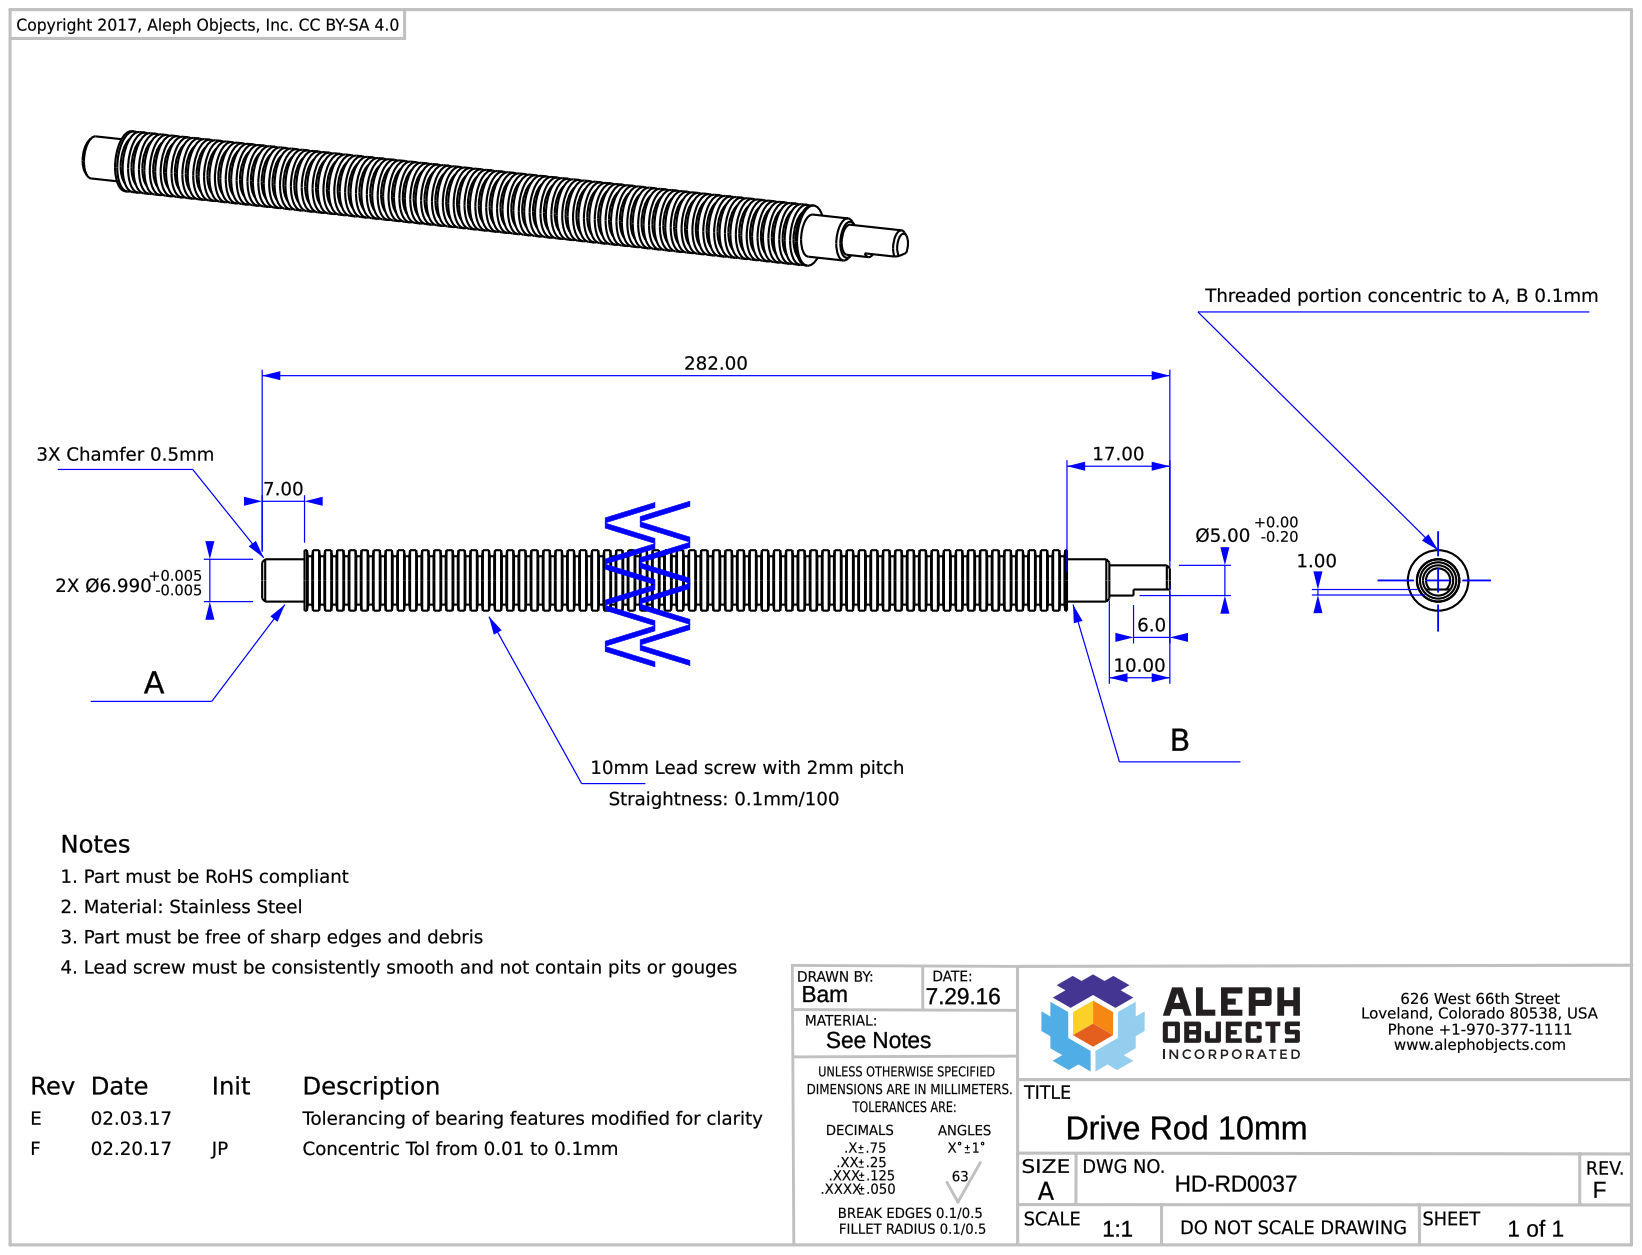
[picture p310: page 1]
