reprapperMC/mini-gladiola/production_docs/Mini_usb_drive_graphic.pdf

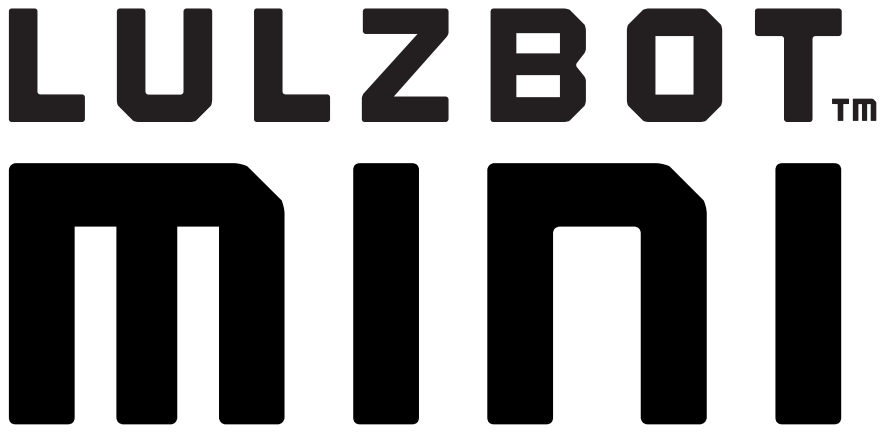
[picture p311: page 1]
