reprapperMC/mini-gladiola/documentation/safety_warnings/safety_warnings_LulzBot_Mini.pdf

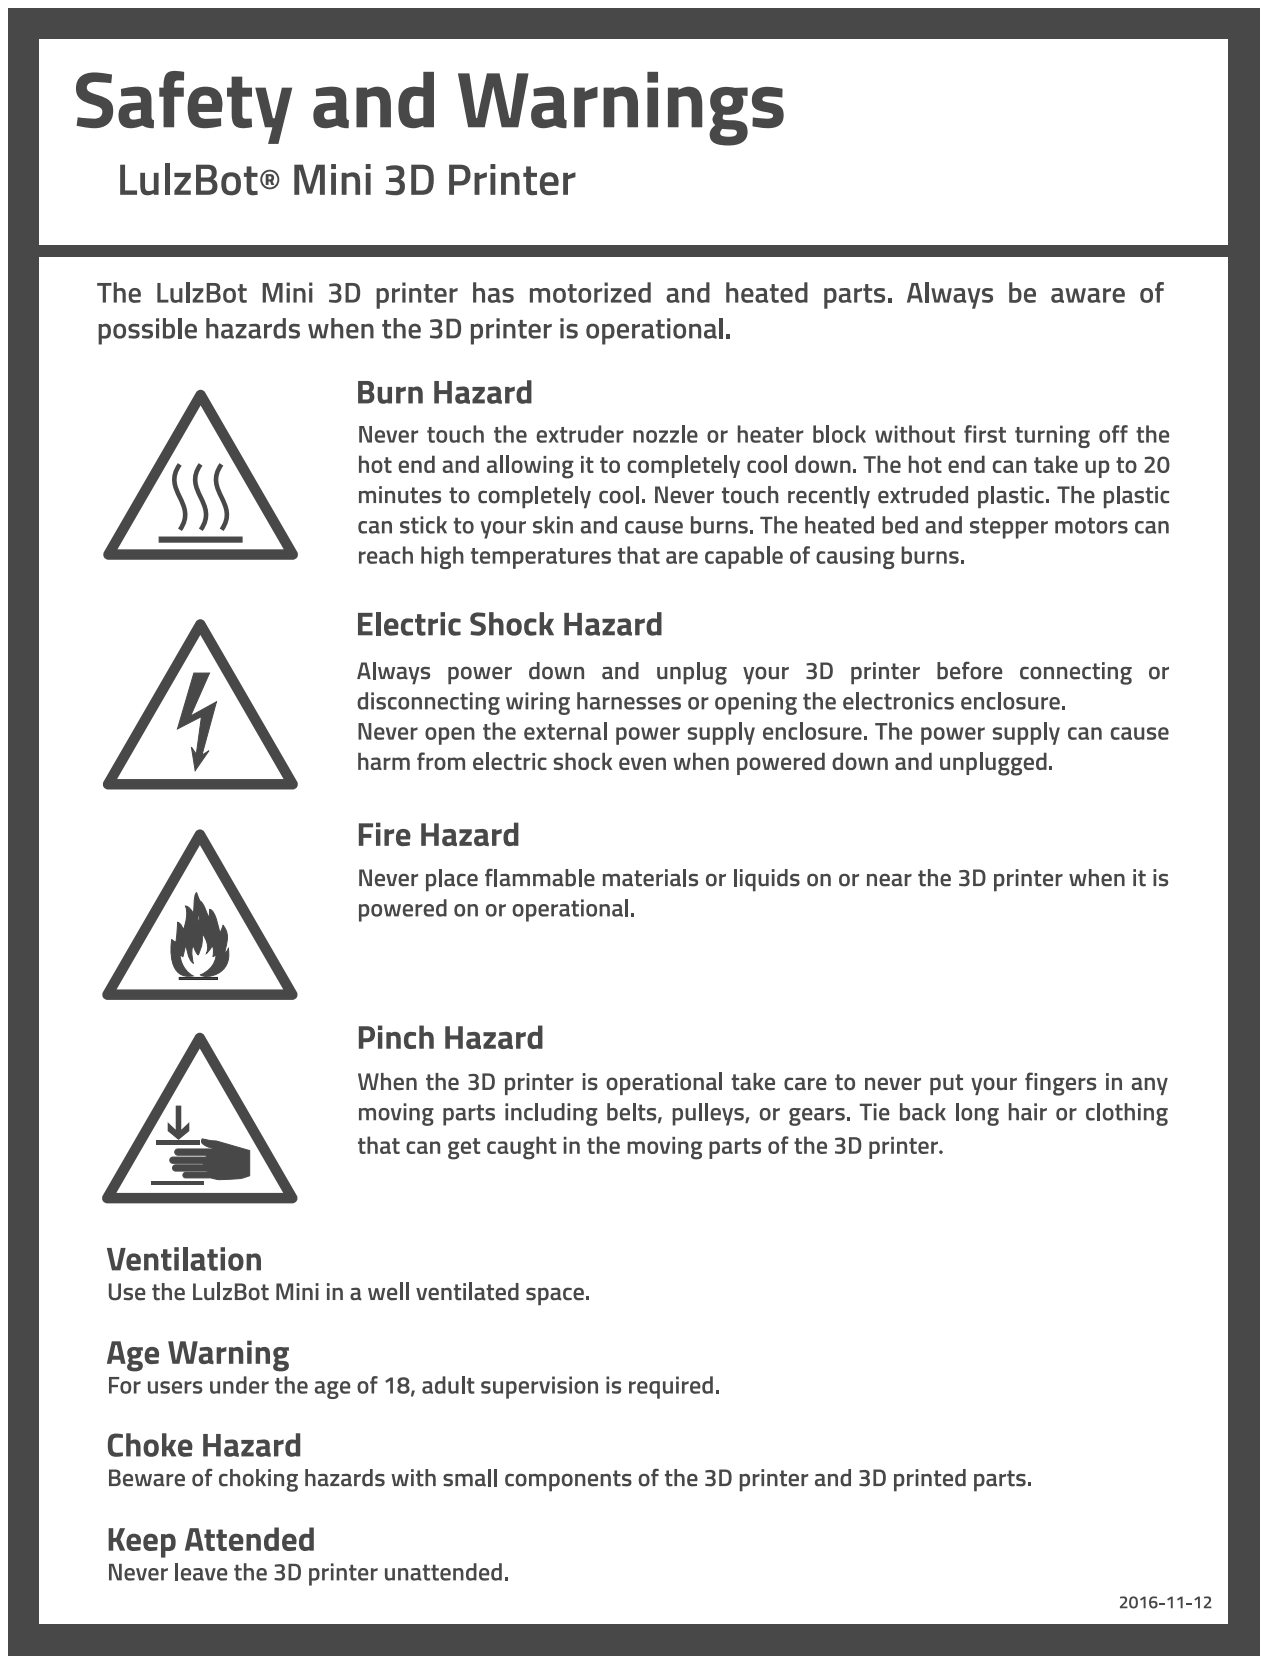
[picture p312: page 1]
