reprapperMC/mini-gladiola/production_docs/labels/sample_filaments_label/mini_filament_samples_label_CMYK.pdf

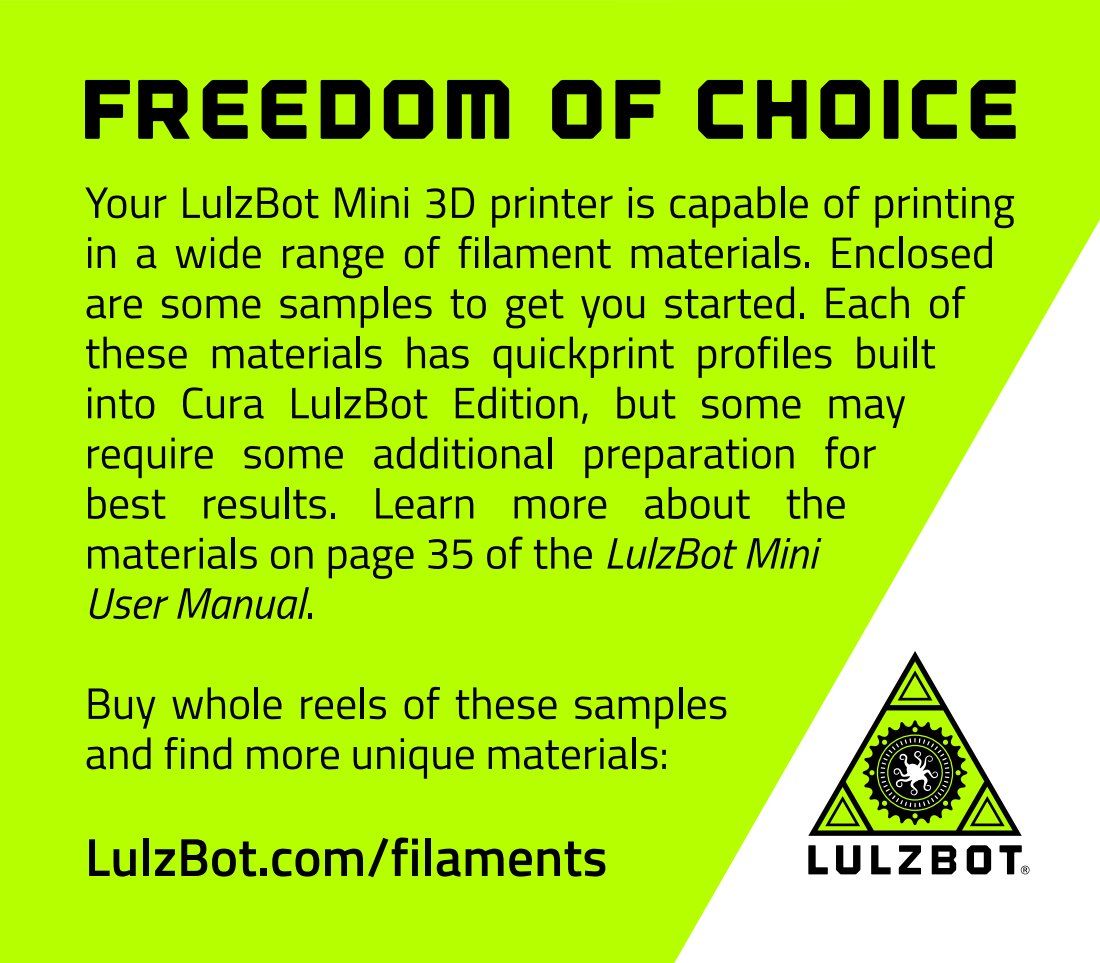
[picture p313: page 1]
