reprapperMC/mini-gladiola/(commit log)

2016-05-03 Initial commit to start the LulzBot Mini Gladiola dev repository
    This commit is using a starting point of the final status of LulzBot Mini 1.03. The source for the LulzBot Mini 1.03 can be found at http://download.lulzbot.com/Mini/1.03/
    [120mm_motor_wire_jig.fcstd, 120mm_motor_wire_jig.stl, 130mm_motor_wire_jig.fcstd, 130mm_motor_wire_jig.stl, 200mm_motor_wire_jig.fcstd, 200mm_motor_wire_jig.stl, 220mm_motor_wire_jig.fcstd, 220mm_motor_wire_jig.stl]
2016-05-05 Changed Marlin source and Mini Manual source into submodules.
2016-05-05 Changed print-profiles directory into a submodule.
2016-05-11 Added new subassembly bill of materials
    This subassembly BOM was copied over from the non-repo Gladiola directory. This new BOM will work as a subassembly BOM in tandem with the flat level purchasing BOM.
    [Mini-Subassembly-BOM.ods]
2016-05-13 old production parts cleared out of repo
    [120mm_motor_wire_jig.fcstd, 120mm_motor_wire_jig.stl, 130mm_motor_wire_jig.fcstd, 130mm_motor_wire_jig.stl, 200mm_motor_wire_jig.fcstd, 200mm_motor_wire_jig.stl, 220mm_motor_wire_jig.fcstd, 220mm_motor_wire_jig.stl]
2016-05-13 new machined parts freecad source and drawings put into repo
    [bed_mount_plate_mini_v1.2.FCStd, bed_mount_plate_mini_v1.2.stl, bottom_plate_mini_v1.2.FCStd, electronics_case_mini_v1.1.fcstd]
2016-05-13 bed harness igus drawing added to repo
2016-05-13 x-extruder harness drawing added to repo
2016-05-13 bed harness drawing added to repo
2016-05-13 chassis ground extension drawing added to repo
2016-05-13 ps to ground post drawing added to repo
2016-05-13 plug to ground post extension harness drawing added to repo
2016-05-13 Added new folder with Galdiola test parts
    [bed_clip.fcstd, bed_clip.stl, bed_clip_v2.fcstd, bed_clip_v2.stl, bed_corner_v2.3.stl, bed_corner_v2.4.fcstd, bed_corner_v2.4.stl, bed_corner_v2.5.fcstd]
2016-05-13 Update file names, create new upper_bearing, delete old upper_bearing folder
    [upper_bearing_holder_v1.2_Mini.STL, upper_bearing_v2.stl, upper_bearing_v3.stl]
2016-05-13 Added files from shared j, started creation of new x end for mini.
    [upper_bearing_v1.1.stl, upper_bearing_v1.2.stl, upper_bearing_v2.fcstd, x-end_motor_v1.1.stl, x_end_motor_v1.fcstd]
2016-05-16 double bearing holder with strain relief started
    [double_bearing_holder_gladiola_v0.1.fcstd]
2016-05-17 Renamed novelties directory to sample_prints
    [XY_resonance_1.0mm_walls.stl, XY_resonance_test.stl, Z_resonance_test.stl, bridging_test.stl, dimensional_accuracy_test.stl, fine_positive_features.stl, logoOSHW.stl, negative_space_tolerance_test.stl]
2016-05-17 Moved calibration directory into sample_prints directory to match current TAZ file structure
2016-05-17 moved parts in test parts folder to printed parts
    [bed_clip.fcstd, bed_clip.stl, bed_clip_v2.fcstd, bed_clip_v2.stl, bed_corner_v2.3.stl, bed_corner_v2.4.fcstd, bed_corner_v2.4.stl, bed_corner_v2.5.fcstd]
2016-05-17 Moved jigs directory into the production_parts directory.
    [heat_pad_alignment_jig_mini.fcstd, heat_pad_alignment_jig_mini.stl, heat_pad_alignment_jig_mini_1.fcstd, heat_pad_alignment_jig_mini_1.stl, z-low3r_spacer_v0.1.fcstd]
2016-05-17 restructured machined parts
    [Cooling_Block_3mm_short.fcstd, Cooling_Block_3mm_short.step, Heat_Break_Tube.fcstd, Heat_Break_Tube.step, Heater_Block_16_x_18_x_17.fcstd, Heater_Block_16_x_18_x_17.step, Heater_Block_16_x_18_x_27.fcstd, Heater_Block_16_x_18_x_27.step]
2016-05-17 toolhead brace notes added to production docs
2016-05-23 Updated marlin source submodule to use Gladiola branch
2016-05-24 New test parts created for Gladiola
    [bed_clip_v3.fcstd, bed_clip_v3.stl, x-end_motor_v1.2.stl, x_end_motor_v1.2.fcstd]
2016-05-24 bed mount plate updated based on star's recommendations
    [bed_mount_plate_mini_v1.2_revA.FCStd, bed_mount_plate_mini_v1.2_revA.step]
2016-05-24 modified double bearing holder with wire strain relief added
    [double_bearing_holder.stl]
2016-05-24 electronics case revised to revA, dimensions and .step file added
    [electronics_case_mini_v1.1_revA.fcstd, electronics_case_mini_v1.1_revA.step]
2016-05-24 Changed hole sizes to insert pullout spec., added goove for soldering iron clearance.
    [x-end_motor_v1.3.stl, x_end_motor_v1.3.fcstd]
2016-05-25 Update cable drawings
    Change cable lengths, strips, cuts, and other details for Igus.
    Use correct AO/LB logo aspect ratios.
2016-05-27 Update bed signal labels for harness drawings
2016-05-27 Update x-motor end and x-idler end to fit larger bed plate
    [x-end_idler.stl, x-end_motor_v1.4.stl, x_end_motor_v1.4.fcstd, z_upper_mini_mod.stl]
2016-05-27 Change so that extruder fan will not intersect part.
    [lower_z_left.stl, lower_z_left_v1.6.fcstd, lower_z_right.stl, lower_z_right_v1.5.fcstd]
2016-05-31 step file exproted of the bed plate
    [bottom_plate_mini_v1.2_PP-MP0149.step]
2016-05-31 Cable drawings - swap the brown and white cables used for the 24V extruder fan
    Increase the X-Extruder drawing to Rev C
2016-05-31 x-carriage cap srouce and stl added
    [x-carriage_cap_v0.1.fcstd, x-carriage_cap_v0.1.stl]
2016-05-31 y-idler redrawn in freecad
    [y_idler_v1.1.fcstd, y_idler_v1.1.stl]
2016-06-01 Add archive of Igus cable photos for their record
2016-06-01 Various part changes and new parts.
    -Change wire routing on x motor carriage.
    -Tighten holes on Z lower added chamfer.
    -Shortened y rod mount to change endstop position.
    [lower_z_left.stl, lower_z_left_1.6.stl, lower_z_left_v1.6.fcstd, lower_z_right.stl, x-end_motor_v1.5.stl, x_end_motor_v1.5.fcstd, y_rod_mount_mini.stl]
2016-06-01 x-carriage cap modified for clearance of top frame
    [x-carriage_cap_v0.1.fcstd, x-carriage_cap_v0.1.stl]
2016-06-01 extruder brace folder renamed to x-carriage cap for clarity
    [extruder_brace_v0.2.fcstd, extruder_brace_v0.2.stl, extruder_brace_v0.3.fcstd, extruder_brace_v0.3.stl, extruder_brace_v0.4.1.stl, extruder_brace_v0.4.fcstd, extruder_brace_v0.5.fcstd, extruder_brace_v0.5.stl]
2016-06-01 obsolete files deleted
    [extruder_brace_v0.2.fcstd, extruder_brace_v0.2.stl, extruder_brace_v0.3.fcstd, extruder_brace_v0.3.stl, extruder_brace_v0.4.1.stl, extruder_brace_v0.4.fcstd, extruder_brace_v0.5.fcstd, extruder_brace_v0.5.stl]
2016-06-01 x-carriage cap model file fixed - had non-manifold errors
    [x-carriage_cap_v0.2.fcstd, x-carriage_cap_v0.2.stl]
2016-06-02 Part changes
    -bed clip now fits with new y bearing holders
    -made mirror or z lower left
    -update insert hole sizes on strain relief mount
    -redraw upper bearing holder
    -minor hole and cosmetic changes for x end motor
    [bed_clip_v3.fcstd, bed_clip_v4.stl, lower_z_right_1.6.stl, strain_releif_mount.stl, strain_relief_mount.fcstd, upper_bearing_v2.fcstd, upper_bearing_v3.fcstd, upper_bearing_v3.stl]
2016-06-02 Merged test parts with production parts
    [bed_clip.fcstd, bed_clip.stl, bed_clip_v2.fcstd, bed_clip_v2.stl, bed_clip_v3.fcstd, bed_clip_v3.stl, bed_clip_v4.stl, lower_z_left.stl]
2016-06-02 Remove test parts folder, all needed files were merged into production parts
    [strain_relief_mount.fcstd, strain_relief_mount.stl]
2016-06-03 Change pockets to larger so that screws do not bottom out in plastic
    [upper_bearing_v3.fcstd, upper_bearing_v3.stl]
2016-06-03 Change name and made mirror of part
    [z_upper_mini_mod.stl]
2016-06-03 Create left and right side for this part
    [z_upper_mini_mod_left.stl, z_upper_mini_mod_right.stl]
2016-06-03 Extend bushing holder for added stability
    [x-end_idler_v2.stl]
2016-06-03 Updated clip so that it fits tighter
    [bed_clip_v3.fcstd, bed_clip_v3.stl, bed_clip_v4.stl]
2016-06-03 Tighten sides of clip to fit better
    [bed_clip_v3.fcstd, bed_clip_v3.stl]
2016-06-06 Part has been drawn with changes in freecad
    [y_rod_mount.fcstd, y_rod_mount_mini.stl]
2016-06-06 Renamed Mini-BOM.ods to Mini-flat-BOM.ods
    [Mini-flat-BOM.ods]
2016-06-06 Drew parts in freecad to allow for larger x carriage bushing holders
    [z_mini_upper.fcstd, z_upper_mini_mod_left_v2.stl, z_upper_mini_mod_right_v2.stl]
2016-06-06 Added column, removed fill
    [Mini-Subassembly-BOM.ods]
2016-06-07 x-end idler modified
    [x-end_idler.fcstd, x_end_idler_mini_v2.2.fcstd, x_end_idler_mini_v2.2.stl, x_end_idler_mini_v2.3.fcstd]
2016-06-07 obsolete files removed from repo
    [x-end_idler.stl, x-end_idler_v2.stl, x_end_idler_mini_v2.3.fcstd]
2016-06-07 Moved motor placement up and removed sharp edges
    [x-end_motor_v1.5.stl, x_end_motor_v1.5.fcstd]
2016-06-08 x-carriage cap modified
    [x-carriage_cap_v0.2.fcstd, x-carriage_cap_v0.2.stl]
2016-06-08 Parts have been re-done if freecad
    [belt_mount.fcstd, belt_mount.stl]
2016-06-08 x-car cap remodified
    [x-carriage_cap_v0.2.fcstd, x-carriage_cap_v0.2.stl]
2016-06-08 y-idler shortened for bed clearance
    [y_idler_v1.2.fcstd, y_idler_v1.2.stl]
2016-06-08 revising Engineering BOM sheet to match OHAI. Not complete
    [Mini-Subassembly-BOM.ods]
2016-06-09 mini-gladiola y-idler updated
    [y_idler_v1.2.fcstd, y_idler_v1.2.stl]
2016-06-09 mini-gladiola y-idler updated ... again ... I forgot the chamfers :( ...
    [y_idler_v1.2.fcstd, y_idler_v1.2.stl]
2016-06-09 Modeled the rest of the spool arm in FreeCAD
    [spool_arm_bracket_v1.00.fcstd, spool_arm_bracket_v1.00.stl, spool_arm_support_v1.00.fcstd, spool_arm_support_v1.00.stl]
2016-06-10 double bearing holder modified for switch clearance
    [double_bearing_holder.stl, double_bearing_holder_gladiola_v0.1.fcstd]
2016-06-10 chamfer added to doubel bearing holder
    [double_bearing_holder.stl, double_bearing_holder_gladiola_v0.1.fcstd]
2016-06-10 Fixing belt path for clamp
    [belt_mount.fcstd]
2016-06-10 Rev. D of Igus harness drawings
    Changelog file included:
    X-Extruder Harness:
    - *No strain-relief teeth on mounting brackets!*
    - *Cut 80mm off X-min endstop wires, not make it's length from the jacket 80mm!*
    - Fix X-Motor label (X, not Z)
    - Increase left-side E-Motor strip length to 80mm
    Bed Harness:
    - *No strain-relief teeth on mounting brackets!*
    - *Cut 40mm off brown diode wire, not make it's length from the jacket 40mm!*
    - Increase right-side Y-Endstop cable strip length to 75mm
    - Move labels to 25mm away from the pin
2016-06-10 Place a note for the length of a wire to be cut OFF using the given length and a note that the labels should be placed 25mm away from the pins
2016-06-10 Place a note that states that the bend radius of the cable chain is 28mm
2016-06-10 For the double ferrite assembly, move the ferrites back by 1cm for better clearance
2016-06-10 Small part changes
    -Belt mount flange increased in size so that it does not break.
    -Larger clearance for belt path underneath.
    -Gap trap for z seam in bushing holder created.
    -Chamfer on bottom of part for easy removal.
    -Bottom gaps on part created to decrease warping.
    [belt_mount.fcstd, belt_mount.stl, x-end_motor_v1.5.stl, x_end_motor_v1.5.fcstd]
2016-06-10 Redrawn x carriage for mini in freecad
    [x_carriage.fcstd]
2016-06-13 printed part status sheet added
    [printed_part_status.ods]
2016-06-13 new version of the extruder idler added to repo
    [beefy extruder idler.fcstd, beefy_extruder_idler.fcstd, beefy_extruder_idler.stl, beefy_extruder_idler_v0.2.fcstd, beefy_extruder_idler_v0.2.stl]
2016-06-15 New stl, update dimensions
    [x_carriage.fcstd, x_carriage.stl]
2016-06-15 Completed Initial BOM -Out for review
    [Mini-Subassembly-BOM.ods]
2016-06-15 Added a few items to the harness subassembly BoMs
    [Mini-Subassembly-BOM.ods]
2016-06-15 Widen bushing holder
    [x_carriage.fcstd, x_carriage.stl]
2016-06-15 Modeled extruder mount in FreeCAD, with the addition for the new heat sink fan
    [extruder_mount_v2.5.fcstd, extruder_mount_v2.5.stl]
2016-06-16 extruder idler modified
    [beefy_extruder_idler_v0.2.fcstd, beefy_extruder_idler_v0.3.stl]
2016-06-16 Update on parts
    [printed_part_status.ods]
2016-06-16 handle redesigned in freecad
    [handle_gladiola.fcstd, handle_gladiola.stl]
2016-06-16 Update cable harness assemblies in the BoM
    [Mini-Subassembly-BOM.ods]
2016-06-17 Proposed changes to bom
    [Mini-Subassembly-BOM.ods]
2016-06-17 x-end idler part designed
    [beefy extruder idler.fcstd, x-end_idler.fcstd]
2016-06-17 comments added to mini-gladiola BOM
    [Mini-Subassembly-BOM.ods]
2016-06-20 Changes to Gladiola BOM
    [Mini-Subassembly-BOM.ods]
2016-06-20 More proposed Gladiola changes
    [Mini-Subassembly-BOM.ods]
2016-06-20 Add internal xy motor harness drawing
2016-06-20 Udated per Patrick and Brent review
    [Mini-Subassembly-BOM.ods]
2016-06-21 Update parts that are ready for printing/slicing.
    [printed_part_status.ods]
2016-06-21 printed part folders cleaned up
    [bed_corner_v2.3.stl, bed_corner_v2.4.fcstd, bed_corner_v2.4.stl, bed_corner_v2.5.fcstd, bed_corner_v2.5.stl, bed_corner_v2.6.fcstd, bed_corner_v2.6.stl, bed_corner_v2.7.fcstd]
2016-06-21 initial gladiola production parts
    [extruder_body_3mm5ex_v1.3.2.stl, heatsink_fan_duct_v0.6.stl, herringbone_small_gear-1.1-highres.stl, lrg_herringbone_gear_v1.3.stl]
2016-06-21 printed part file structure cleaned up and printed part status sheet updated
    [beefy_extruder_idler.fcstd, beefy_extruder_idler.stl, beefy_extruder_idler_toggle_style.fcstd, beefy_extruder_idler_v0.2.fcstd, beefy_extruder_idler_v0.2.stl, beefy_extruder_idler_v0.3.stl, extruder_idler_block_v1.4c.blend, extruder_idler_block_v1.4c.stl]
2016-06-22 double bearing holder gcode
2016-06-22 Moved to from production parts this part will be off the self.
    [fan_guard_v1.fcstd, fan_guard_v1.stl]
2016-06-22 Added to test parts folder
    [fan_guard_v1.fcstd, fan_guard_v1.stl]
2016-06-22 Updated BOM with fan guard
    [Mini-Subassembly-BOM.ods]
2016-06-22 missing parts added to repo, some printed part naming updated
    [beefy_extruder_idler_v0.3.fcstd, beefy_extruder_idler_v0.3.stl, beefy_idler_latch_v2.2.fcstd, beefy_idler_latch_v2.2.stl, extruder_idler_block_v1.4c.blend, extruder_idler_block_v1.4c.stl, printed_part_status.ods, upper_bearing_v3.fcstd]
2016-06-23 Modify extruder mount to fix limit switch misalignment
    [extruder_mount_v2.5.fcstd, extruder_mount_v2.6.fcstd, extruder_mount_v2.6.stl]
2016-06-23 Requests from manufacturing changes
    [x-end_motor_v1.5.stl]
2016-06-23 Part mod request from manufacturing
    [x_end_idler_mini_v2.2.fcstd, x_end_idler_mini_v2.2.stl, z_mini_upper.fcstd, z_upper_mini_mod_left_v2.stl, z_upper_mini_mod_right_v2.stl]
2016-06-23 Idler should be harder to break now
    [x_end_idler_mini_v2.2.fcstd, x_end_idler_mini_v2.2.stl]
2016-06-23 Put chamfer on all M3 insert holes
    [belt_mount.fcstd, belt_mount.stl, lower_z_left.stl, lower_z_left_v1.6.fcstd, lower_z_right.stl, strain_relief_mount_v3.fcstd, strain_relief_mount_v3.stl, upper_bearing_v3.fcstd]
2016-06-23 Add initial design for USB cover
    [usb_support_mini.fcstd, usb_support_mini_v1.stl]
2016-06-23 x-end idler modified - bottom of part lowered for better switch contact, and part strengthened based on prelim testing
    [x_end_idler_mini_v2.2.stl]
2016-06-24 updated sheet metal part nos and revs
    [Mini-Subassembly-BOM.ods]
2016-06-24 x-end idler modified to try to make bearing alignment better
    [x_end_idler_mini_v2.2.stl]
2016-06-27 Part modified to fit new sheet metal fold
    [z_mini_upper.fcstd, z_upper_mini_mod_left_v2.stl, z_upper_mini_mod_right_v2.stl]
2016-06-27 Create pivot table to get totals for parts
    [Mini-Subassembly-BOM.ods]
2016-06-27 Add heatshrink to exposed shielding
2016-06-27 top plate redrawn in freeCAD, flange extended for manufacturability
    [top_plate_mini_v1.1.fcstd, top_plate_mini_v1.1.step]
2016-06-27 updating printed part list
    [printed_part_status.ods]
2016-06-27 formatting printed part list
    [printed_part_status.ods]
2016-06-28 New part redraw started in freecad, spool arm stl flipped, pivot table totals
    [Mini-Subassembly-BOM.ods, extruder_fan_mount.fcstd, spool_arm_v1.04.stl]
2016-06-28 Mickey's changes
    [printed_part_status.ods]
2016-06-28 Update the assembled drawing with the shielding insulation change
2016-06-28 missing and misnamed printed part files added to the bom
    [Mini-Subassembly-BOM.ods, usb_support_mini_v1.0.fcstd, usb_support_mini_v1.0.stl]
2016-06-29 Small mods based on manufacturing feed back
    [bed_clip_v3.fcstd, bed_clip_v3.stl, belt_mount.fcstd, belt_mount.stl, extruder_fan_mount.fcstd, extruder_fan_mount.stl, handle_gladiola.fcstd, handle_gladiola.stl]
2016-06-29 Decreased boss so that screw does not stick out of spool arm support
    [spool_arm_v1.04.fcstd, spool_arm_v1.04.stl]
2016-06-29 Modify extruder mount for fan clearance and limit switch alignment
    [extruder_mount_v2.7.fcstd, extruder_mount_v2.7.stl, extruder_mount_v2.8.fcstd, extruder_mount_v2.8.stl, extruder_mount_v2.9.fcstd, extruder_mount_v2.9.stl, spool_arm_bracket_v1.00.fcstd]
2016-06-29 Bed clip made stronger
    [bed_clip_v3.fcstd, bed_clip_v3.stl, printed_part_status.ods]
2016-06-29 Update XY assembly to use a black wire for the shielding
2016-06-29 pdf for top chassis created
2016-06-29 Add connector for YZ motors and color them
2016-06-29 Increase the shielding cut length and reduce the heatshrink length
2016-06-29 Add panduit to XY assembly
2016-06-29 drive rod drawing created in freeCAD
    [drive_rod_10mm_mini_HD-RD0037.fcstd]
2016-06-29 top plate mini drawing modified based on PPM requests
    [top_plate_mini_v1.1.fcstd]
2016-06-29 typo in description on the drive rod drawing fixed
    [drive_rod_10mm_mini_HD-RD0037.fcstd]
2016-06-29 updated components, P/n and costs
    [Mini-Subassembly-BOM.ods]
2016-06-29 Update the panduit sizes and increase the heatshrink length
2016-06-29 Increase X Extruder harness heatshrink length to 70mm
2016-06-29 cutout for retracts put into the double bearing holder
    [double_bearing_holder.stl, double_bearing_holder_gladiola_v0.1.fcstd]
2016-06-29 Add internal part numbers for harness assemblies
2016-06-29 Update the harness part numbers
    [Mini-Subassembly-BOM.ods]
2016-06-29 Add missing items to xy harness assembly
    [Mini-Subassembly-BOM.ods]
2016-06-29 Reduce the heatshrink length over the shielding
2016-06-30 y-idler modified to be a lil bit shorter and much beefier
    [y_idler_v1.2.fcstd, y_idler_v1.2.stl]
2016-06-30 x-end idler updated for better set screw pem fit
    [x_end_idler_mini_v2.2.stl]
2016-06-30 added tape and fuses, modified flat bom
    [Mini-Subassembly-BOM.ods, Mini-flat-BOM.ods]
2016-07-05 Made smooth rod hole larger
    [lower_z_left.stl, lower_z_left_v1.6.fcstd, lower_z_right.stl]
2016-07-05 Small modifications to x carriage, changed belt mount so it doesnt break
    [belt_mount.fcstd, belt_mount.stl, printed_part_status.ods, x_carriage.fcstd, x_carriage.stl]
2016-07-05 updated Electrical Cover Assembly
    [Mini-Subassembly-BOM.ods]
2016-07-05 Modify spool arm support for manufacturability
    [spool_arm_support_v1.01.fcstd, spool_arm_support_v1.01.stl]
2016-07-05 tweak extruder mount for manufacturability
    [extruder_mount_v2.10.fcstd, extruder_mount_v2.10.stl]
2016-07-06 Increase the Igus bed harness rev to E
    No changes were made, the rev number is kept the same as the x_extruder_harness.odg
2016-07-06 adds a redraw of the right side sheet metal that includes new masking notes
    [right_side_mini_revD.fcstd]
2016-07-06 obsolete files removed
    [bed_mount_plate_mini_v1.2.FCStd, electronics_case_mini_v1.1.fcstd]
2016-07-06 Created new belt clamp, belt clamp peice, widened smooth rod holes in upper z
    [belt_clamp_bottom.fcstd, belt_clamp_bottom.stl, belt_mount.fcstd, belt_mount.stl, z_mini_upper.fcstd, z_upper_mini_mod_left_v2.stl, z_upper_mini_mod_right_v2.stl]
2016-07-07 Fix typo label from X-Motor to E-Motor
2016-07-07 Adds freecad redraw of the left side plate sheet metal which incorporated new masking notes
    [left_side_mini.fcstd]
2016-07-07 Change the xy harness cut and strip lengths and add shielding to the right-side for EMI mitigation
2016-07-07 Shortens USB support to make room for USB grounding clamp
    [usb_support_mini_v1.0.fcstd, usb_support_mini_v1.0.stl]
2016-07-07 Add USB to ground drawing
2016-07-07 Update firmware files
    [Configuration.h, Configuration_adv.h]
2016-07-07 cleaned up extruder mount directory, renamed production part from v2.10 to v3.0, lets stay with this one through production barring any last minute changes
    [extruder_mount_v2.5.fcstd, extruder_mount_v2.5.stl, extruder_mount_v2.6.fcstd, extruder_mount_v2.6.stl, extruder_mount_v2.7.fcstd, extruder_mount_v2.7.stl, extruder_mount_v2.8.fcstd, extruder_mount_v2.8.stl]
2016-07-07 modification of electronics enclosure for the mini started
    [electronics_case_mini_v1.1_revB.fcstd]
2016-07-07 Extruder fan mount mini renamed to v2.0 for clarity
    [extruder_fan_mount_v2.0_mini.fcstd, extruder_fan_mount_v2.0_mini.stl]
2016-07-07 USB brace shortened to make room for the USB ground clamp
    [usb_support_mini_v1.0.stl]
2016-07-07 updated bom from subassy builds
    [Mini-Subassembly-BOM.ods]
2016-07-07 update bom subassy
    [Mini-Subassembly-BOM.ods]
2016-07-08 updating parts list
    [printed_part_status.ods]
2016-07-08 Upate Marlin to 1.1.0.4
    [Configuration.h, Configuration_adv.h, Marlin Logo_old.dxf]
2016-07-08 Update tool head subassy
    [Mini-Subassembly-BOM.ods]
2016-07-08 electronics chassis modified, slots changed to holes
    [electronics_case_mini_v1.1_revB.fcstd]
2016-07-08 usb ground clip created
    [usb_ground_clip_v0.1.fcstd, usb_ground_clip_v0.1.stl]
2016-07-11 All bearing holes modified, to fit better, fan mount opening widened.
    [double_bearing_holder.stl, double_bearing_holder_gladiola_v0.1.fcstd, extruder_fan_mount_v2.0_mini.fcstd, extruder_fan_mount_v2.0_mini.stl, upper_bearing_v3.fcstd, upper_bearing_v3.stl, x-end_motor_v1.5.stl, x_carriage.fcstd]
2016-07-11 Added correct extruder body, new bearing holder style for x end.
    [extruder_body_3mm5ex_v1.3.2.stl, extruder_body_hex_v1.4.1.stl, x-end_motor_v1.5.stl, x_carriage.fcstd, x_carriage.stl]
2016-07-11 Chamfer on bushing holders, idler bushing holder mounting change.
    [double_bearing_holder.stl, double_bearing_holder_gladiola_v0.1.fcstd, upper_bearing_v3.fcstd, upper_bearing_v3.stl, x_end_idler_mini_v2.2.stl]
2016-07-11 drive rod drawing updated with missing dimensions
    [drive_rod_10mm_mini_HD-RD0037.fcstd]
2016-07-12 Add wire drawing for the toolhead
2016-07-14 Adds EMI changed to the bottom plate of the mini, Changes rev from IR to A
    [bottom_plate_mini_v1.2.FCStd, bottom_plate_mini_v1.2_PP-MP0149.step]
2016-07-14 Stl files added for sheet metal for digital/physical lineup
    [left_side.stl, right_side.stl, top_plate.stl]
2016-07-14 Further changes made to mini electronics case for EMI reasons
    [electronics_case_mini_v1.1_revC.fcstd]
2016-07-15 electronics case redrawn - drawings incomplete
    [electronics_case_mini_v1.1_revB.fcstd]
2016-07-19 Modify extruder mount for dimension
    [extruder_mount_v2.11.fcstd, extruder_mount_v2.11.stl]
2016-07-19 x-carriage cap redrawn first model had non-manifold errors that could not be solved.
    [x-carriage_cap_v0.2.fcstd, x-carriage_cap_v0.2.stl]
2016-07-19 clean up extruder mount folder
    [extruder_mount_v3.0_mini.fcstd, extruder_mount_v3.0_mini.stl]
2016-07-19 Moved z max switch upwards so wipe will be backwards compatible.
    [x-end_motor_v1.5.stl]
2016-07-19 updating printed parts list
    [printed_part_status.ods]
2016-07-19 Removed 2mm from endstop edge so probe is the same after extruder mount modification.
    [y_rod_mount.fcstd, y_rod_mount_mini.stl]
2016-07-19 Update Marlin to the 1.1.0.5 changes
    [Configuration.h, Configuration_adv.h, Marlin Logo_old.dxf]
2016-07-19 Update printed parts list.
    [printed_part_status.ods]
2016-07-20 updating parts list status
    [printed_part_status.ods]
2016-07-20 electronics case modifications final, ready for review
    [electronics_case_mini_v1.1_revB.fcstd, electronics_case_mini_v1.1_revB.step]
2016-07-21 Update Marlin
    [Configuration.h, Configuration_adv.h, Marlin Logo_old.dxf]
2016-07-21 Update the cable drawings
    Reduce the left Z-motor cable to 330mm length
    Add 60mm of heat-shrink to the E-motor
2016-07-21 electronics chassis redlines based on r&d redline
    [electronics_case_mini_v1.1_revB.fcstd]
2016-07-21 cleaned up electronics case folder of out of date parts
    [electronics_case_mini_v1.1_revA.fcstd, electronics_case_mini_v1.1_revA.step, electronics_case_mini_v1.1_revC.fcstd]
2016-07-21 updating printed parts status
    [printed_part_status.ods]
2016-07-22 mini electronisc case modified per mfg. redline
    [electronics_case_mini_v1.1_revB.fcstd, electronics_case_mini_v1.1_revB.step]
2016-07-25 Remove material so that new idler wont intersect z upper when homing.
    [z_mini_upper.fcstd, z_upper_mini_mod_left_v2.stl, z_upper_mini_mod_right_v2.stl]
2016-07-25 electronics case rev'D B to C based on Del's feedback
    [electronics_case_mini_v1.1_revB.fcstd, electronics_case_mini_v1.1_revB.step, electronics_case_mini_v1.1_revC.fcstd]
2016-07-26 zip tie loop removed on the double bearing holder
    [double_bearing_holder.stl, double_bearing_holder_gladiola_v0.1.fcstd]
2016-07-26 electronics case revised based on mfg suggestions
    [electronics_case_mini_v1.1_revC.fcstd]
2016-07-26 updated mini subassembly bom
    [Mini-Subassembly-BOM.ods]
2016-07-26 Update printed part status for idler and latch
    [printed_part_status.ods]
2016-07-27 Beeftastic idler modified for even better printing.
    [beefy_extruder_idler_v0.3.fcstd, beefy_extruder_idler_v0.3.stl]
2016-07-27 Masking callouts modified on the left side sheet metal
    [left_side_mini_revF.fcstd]
2016-07-27 Masking callouts modified on the right side sheet metal
    [right_side_mini_revE.fcstd, right_side_mini_revE.step]
2016-07-28 printed parts status update
    [printed_part_status.ods]
2016-07-29 electronics case rev'd to add masking needed for EMI
2016-07-29 electronics case modified for EMI
    [electronics_case_mini_v1.1_revC.fcstd, electronics_case_mini_v1.1_revD.fcstd, electronics_case_revD.step]
2016-07-29 left side sheet metal modified to add masking and modified countersinks
    [left_side.stl, left_side_mini.fcstd, left_side_mini_revF.step]
2016-07-29 right side sheet metal modified for EMI
    [right_side.stl, right_side_mini_revD.fcstd, right_side_mini_revE.fcstd]
2016-07-29 fixed brpoken step file
    [top_plate_mini_v1.1revD.step]
2016-08-01 Use stl with correct file
    [usb_support_mini_v1.0.stl]
2016-08-01 Add earth_gnd_extension and chassis_gnd_extension wires
2016-08-02 Replaced old drawings with newer correct ones.
    [bed_leveling_washer_v2.0_PP-MP0082.fcstd, bed_leveling_washer_v2.0_PP-MP0082_rev_IR.step]
2016-08-02 Update printed part approval list
    [printed_part_status.ods]
2016-08-02 stl did not get mirrored first time
    [lower_z_left.stl, lower_z_right.stl]
2016-08-02 updating printed parts
    [printed_part_status.ods]
2016-08-02 replaced stainless washers with black washers in bom
    [Mini-Subassembly-BOM.ods]
2016-08-02 Update the x_extruder_harness based on radiated emissions test results
    Add shielding to the z motors
    Add grounding to the left sheet metal
    Increment the sheets to rev F
2016-08-04 Update drawings based on Mickey's feedback
    Using solder sleeve in place of the ferrule and heatshrink on the diode
2016-08-05 Update the BoM based on rev F Igus drawing changes
    [Mini-Subassembly-BOM.ods]
2016-08-08 Remove USB to GND wire
    [Mini-Subassembly-BOM.ods]
2016-08-08 Minor adjustment after scrubbing
    [Mini-Subassembly-BOM.ods]
2016-08-09 Update the solder sleeve PN
    Igus is aware of the correct PN
    [Mini-Subassembly-BOM.ods]
2016-08-09 Update Marlin to 1.1.0.8
    [Configuration.h, Configuration_adv.h, Marlin Logo_old.dxf]
2016-08-09 Update part numbers and quanities after reviewing Igus's BoM
    Increment the rev to G
    [Mini-Subassembly-BOM.ods]
2016-08-10 Update the title block of the extruder pin assignments drawing
2016-08-10 Update the extruder drawing based on more measurements
2016-08-11 Update printed part status
    [printed_part_status.ods]
2016-08-11 Update to parts based on feed back from manufacturing
    -x-end idler, adjusted Nut positioning and created nut trap
    -y-idler, 8mm holes wider, bearing hole wider, and created clearance for double bearing part
    -lower relief mount, add chamfer to m3 through holes to remove overhang
    [strain_releif_mount_lower_1.2.fcstd, strain_releif_mount_lower_1.2.stl, x_end_idler_mini_v2.2.stl, y_idler_v1.2.fcstd, y_idler_v1.2.stl]
2016-08-11 Tighten smooth rod holes slightly for better fit
    [y_idler_v1.2.fcstd, y_idler_v1.2.stl]
2016-08-11 Remove this printed part, grounding the usb across the board was transmitting clock harmonic into the usb cord
    [usb_ground_clip_v0.1.fcstd, usb_ground_clip_v0.1.stl]
2016-08-12 updated printed parts list
    [printed_part_status.ods]
2016-08-12 Bed clip change to be a little tighter, nut hole is smaller
    [bed_clip_v3.fcstd, bed_clip_v3.stl, extruder_body_hex_v1.4.1.stl]
2016-08-12 adding approved gcode, updated printed parts list
    [printed_part_status.ods]
2016-08-15 Redesign for internal mount and greater stability
    [usb_support_mini_v1.0.fcstd]
2016-08-15 Extruder mount redraw with fan mount angle adjust. Spool arm hole is smaller.
    [extruder_mount_v2.11.fcstd, extruder_mount_v2.11.stl, spool_arm_support_v1.01.fcstd, spool_arm_support_v1.01.stl]
2016-08-15 M3 insert holes are now wider.
    [double_bearing_holder.stl, double_bearing_holder_gladiola_v0.1.fcstd]
2016-08-16 Change retainer ring dimensions for improved capture of bearing
    [upper_bearing_v3.fcstd, upper_bearing_v3.stl]
2016-08-16 added extruder washer folder and stl file from TAZ olive
    [extruder_washer_v3.0-x16.stl]
2016-08-17 Update the names of the earth and chassis extension drawings
2016-08-17 Update the Y motor shielding to use a fork terminal on the motor side; shorten the shielding wire by 5mm
2016-08-18 Top plate modified for new powder coat thickness spec
    [top_plate.stl, top_plate_mini_v1.1.fcstd, top_plate_mini_v1.1_revE.fcstd, top_plate_mini_v1.1_revE.step, top_plate_mini_v1.1revD.step]
2016-08-18 Top plate modified for new powder coat thickness spec - additional drawing files
2016-08-18 Right side modified for new powder coat thickness spec
    [right_side_mini_revF.fcstd, right_side_mini_revF.step]
2016-08-18 Left side modified for new powder coat thickness spec
    [left_side_mini_revG.fcstd, left_side_mini_revG.step]
2016-08-18 Electronics case modified for new powder coat thickness spec
    [electronics_case_mini_v1.1_revE.fcstd, electronics_case_revE.step]
2016-08-18 Bottom plate modified for new powder coat thickness spec
    [bottom_plate_mini_v1.2_revB.FCStd]
2016-08-18 Bed mount plate modified for new powder coat thickness spec
    [bed_mount_plate_mini_v1.2_revB.FCStd, bed_mount_plate_mini_v1.2_revB.step]
2016-08-18 Obsolete drawings removed from the glad repo
    [bed_mount_plate_mini_v1.2_revA.FCStd, bed_mount_plate_mini_v1.2_revA.step, electronics_case_mini_v1.1_revD.fcstd, electronics_case_revD.step, left_side_mini_revF.fcstd, left_side_mini_revF.step, right_side_mini_revE.fcstd, right_side_mini_revE.step]
2016-08-18 Rename the title of the drawing to reflect the correct name of the YZ Motor Harness
2016-08-18 Bearing holder rings made tighter on all parts listed.
    [x-end_motor_v1.5.stl, x_carriage.fcstd, x_carriage.stl, x_end_idler_mini_v2.2.stl]
2016-08-18 Include Marlin as a submodule
    [Configuration.h, Configuration_adv.h, Marlin Logo_old.dxf]
2016-08-18 Use the https URL for the Marlin submodule
2016-08-18 Split up the two left-side Z motor shielding wires
2016-08-18 Update the panduit lengths to fit the cables more completely
2016-08-18 Heat shrink over the right-side Z shielding should be 40mm
2016-08-18 Update in-house drawings after review
    Waiting on AO part number to be created for "Extruder Pin Assignment" assembly
2016-08-19 Create new stl for usb support
    [usb_support_mini_v1.0.stl]
2016-08-22 added x-carriage, e-end idler, and x-end motor gcodes for test
2016-08-22 add mini-gladiola full bom
    [Mini_Gladilola_BOM.ods]
2016-08-22 dropping bed temp on layer 2 for x carriage, x idler, x motor.
2016-08-23 adding Slic3r test for cluster, x end motor
2016-08-23 file name convention fixed for strain relief mount
    [strain_releif_mount_lower_1.2.fcstd, strain_releif_mount_lower_1.2.stl, strain_relief_mount_v3.fcstd, strain_relief_mount_v3.stl]
2016-08-24 Adjust ring that holds busings in for tighter fit.
    [double_bearing_holder.stl, double_bearing_holder_gladiola_v0.1.fcstd]
2016-08-24 New mounting adjustment for y axis to align the belt.
    [y_rod_mount.fcstd, y_rod_mount_mini.stl]
2016-08-24 New inserts for idler to allow for easier adjustment with y_rod_mount
    [y_idler_v1.2.fcstd, y_idler_v1.2.stl]
2016-08-24 Small tweaks to new y rod mount
    [nut_insert_tool.fcstd, nut_insert_tool.stl, y_rod_mount.fcstd, y_rod_mount_mini.stl]
2016-08-24 Belt mount and clamp shortened by 1.5mm to allow for more clearance.
    [belt_clamp_bottom.fcstd, belt_clamp_bottom.stl, belt_mount.fcstd, belt_mount.stl]
2016-08-24 revA of the bed leveling washer created
    [bed_leveling_washer_revA.fcstd]
2016-08-24 Spool arm is longer to accommodate larger reels, x uppers insert hole depth change for new sheet metal
    [spool_arm_v1.04.fcstd, spool_arm_v1.04.stl, z_mini_upper.fcstd, z_upper_mini_mod_left_v2.stl, z_upper_mini_mod_right_v2.stl]
2016-08-24 file name cleanup
    [extruder-body-hex_black_v1.4.1.stl, spool_arm_support_v1.00.fcstd, spool_arm_support_v1.00.stl]
2016-08-24 spool arm bracket renamed according to new convention
    [spool-arm-bracket_black_v1.0.fcstd, spool-arm-bracket_black_v1.0.stl]
2016-08-24 cleanup of printed part names
    [heatsink-fan-duct_black_v0.6.stl, spool-arm-bracket_black_v1.0.fcstd, spool-arm-bracket_black_v1.0.stl, spool-arm-mini_black_v1.4.fcstd, spool-arm-mini_black_v1.4.stl, spool-arm-support_black_v1.1.fcstd, spool-arm-support_black_v1.1.stl, x-carriage-mini_black_v1.1.fcstd]
2016-08-24 Printed part name cleanup continues...
    [belt-clamp_black_v1.1.fcstd, belt-clamp_black_v1.1.stl, belt-mount_black_v1.1.fcstd, belt-mount_black_v1.1.stl, handle-bar_black_v2.5.fcstd, handle-bar_black_v2.5.stl, upper-bearing-holder_black_v3.0.fcstd, upper-bearing-holder_black_v3.0.stl]
2016-08-24 Printed part source and stl names changed to reflect new naming convention
    [belt-mount_black_v1.1.fcstd, belt-mount_black_v1.1.stl, double-bearing-holder_black_v1.4.fcstd, double-bearing-holder_black_v1.4.stl, herringbone_small_gear-1.1-highres.stl, lower-z-left-mini_lulz-green_v1.6.fcstd, lower-z-left-mini_lulz-green_v1.6.stl, lower-z-right-mini_lulz-green_v1.6.fcstd]
2016-08-24 pp name change tracker added
    [printed_part_name_modifications_8-24-16.ods]
2016-08-24 printed part name change sheet modified for clarity
    [printed_part_name_modifications_8-24-16.ods]
2016-08-25 The heater wire length should not be measured from the tip of the cartridge
2016-08-25 bed leveling washer spec updated
    [bed_leveling_washer_revA.fcstd]
2016-08-25 Update Marlin after small bugfix
2016-08-25 Electronics chassis drawing modified with new powder coat spec. is now fevF.
    [electronics-case-mini_PP-FP0082_revF.fcstd, electronics-case-mini_PP-FP0082_revF.step, electronics_case_mini_v1.1_revE.fcstd]
2016-08-25 Bed mount plate modified based on meeting with PMM. Revised to revC
    [bed-mount-plate-mini_PP-MP0146_revC.fcstd, bed-mount-plate-mini_PP-MP0146_revC.step, bed_mount_plate_mini_v1.2.stl, bed_mount_plate_mini_v1.2_revB.FCStd]
2016-08-25 Top plate modified, is now revF
    [top-plate-mini_PP-FP0051_revF.fcstd, top-plate-mini_PP-FP0051_revF.step, top_plate_mini_v1.1_revE.fcstd]
2016-08-25 Right side of the mini sheet metal updated with new spec for powder coat thickness
    [right-side-mini_PP-FP0052_revF.fcstd, right-side-mini_PP-FP0052_revF.step, right_side_mini_revF.fcstd]
2016-08-25 Left side sheet metal modified based on PMM feedback
    [left-side-mini_PP-FP0055_revG.fcstd, left-side-mini_PP-FP0055_revG.step, left_side_mini_revG.fcstd]
2016-08-25 bottom plate sheet metal updated
    [bottom-plate-mini_PP-MP0149_revB.fcstd, bottom-plate-mini_PP-MP0149_revB.step, bottom_plate_mini_v1.2.FCStd, bottom_plate_mini_v1.2_revB.FCStd]
2016-08-25 Add chamfer to prevent cable chain interference
    [strain-relief-upper_black_v3.0.fcstd, strain-relief-upper_black_v3.0.stl]
2016-08-25 Remove linear pocket pattern on bottom of part to hopefully decrease warping
    [x-end-idler-mini_black_v2.5.stl]
2016-08-25 Add SS hardware to frame assembly Add inserts, nuts, and screws to Y axis assembly Add EMI gasket to cover assembly Add mini-RAMBo correct part number to BOM Update 22 printed part numbers
    BOM parts available to purchase except those listed below
    EL-HR0102
    PP-MP0146
    PP-MP0149
    PP-FP0051_rC
    PP-FP0052_rC
    PP-FP0055_rD
    PP-FP0083
    PP-FP0082_rf
    PP-MP0049
    [Mini_Gladilola_BOM.ods]
2016-08-25 Update Marlin after another small bug fix
2016-08-26 z upper insert holes and pocket for sheet metal clearance have been modified.
    [z-upper-mini-left_black_v2.0.fcstd, z-upper-mini-left_black_v2.0.stl, z-upper-mini-right_black_v2.0.stl]
2016-08-26 Pushed incorrect file first time
    [z-upper-mini-left_black_v2.0.fcstd, z-upper-mini-right_black_v2.0.stl]
2016-08-26 Use red and black heatshrink on the Z motor wires to differentiate them
2016-08-26 Update Marlin after another minor bugfix
2016-08-26 Increment the Marlin version number
2016-08-26 Change angle of x max switch
    [extruder_fan_mount_v2.0_mini.fcstd, extruder_fan_mount_v2.0_mini.stl]
2016-08-26 Reorient y idler mount so there are no overhangs
    [y-motor-mount_black_v1.4.stl]
2016-08-29 Add chamfer to screw and insert holes
    [extruder_fan_mount_v2.0_mini.fcstd, extruder_fan_mount_v2.0_mini.stl]
2016-08-29 Add small amount of material and chamfer to bottom insert on part so there is less of an overhang
    [upper-bearing-holder_black_v3.0.fcstd, upper-bearing-holder_black_v3.0.stl]
2016-08-30 added distributor information to BoM
    [Mini_Gladilola_BOM.ods]
2016-08-30 added RFQ information to BoM
    [Mini_Gladilola_BOM.ods]
2016-08-31 Fan is shorter so that hotend does not melt it, pocket is 2 mm less on upper zs
    [extruder_fan_mount_v2.0_mini.fcstd, extruder_fan_mount_v2.0_mini.stl, z-upper-mini-left_black_v2.0.fcstd, z-upper-mini-left_black_v2.0.stl, z-upper-mini-right_black_v2.0.stl]
2016-09-01 added PO information to BoM
    [Mini_Gladilola_BOM.ods]
2016-09-01 purchasing information
    [Mini_Gladilola_BOM.ods]
2016-09-01 Create z coupler jig
    [15mm_z_motor_jig.fcstd, 15mm_z_motor_jig.stl]
2016-09-01 Update printed parts status
    [printed_part_status.ods]
2016-09-02 added EDC PO information
    [Mini_Gladilola_BOM.ods]
2016-09-02 added PO information
    [Mini_Gladilola_BOM.ods]
2016-09-02 updated distributor information on BoM
    [Mini_Gladilola_BOM.ods]
2016-09-04 Change SH-PH0075 with SH-PS0112 Add SH-PG0113 SH-PG0114 SH-PG0146 SH-PG0147 Foam kit broken into individual items
    [Mini_Gladilola_BOM.ods]
2016-09-06 electronics chassis modified
    [bottom-plate-mini_PP-MP0149_revB.step, electronics-case-mini_PP-FP0082_revF.fcstd, electronics-case-mini_PP-FP0082_revF.step]
2016-09-06 mini electronics chassis laser etching files added to repo from j/dox/creative/industrial design
2016-09-06 Removed set screw and changed distance for y rod motor mount
    [y-idler-mini_black_v1.4.fcstd, y-idler-mini_black_v1.4.stl, y-motor-mount_black_v1.4.fcstd, y-motor-mount_black_v1.4.stl]
2016-09-06 updated printed parts status
    [printed_part_status.ods]
2016-09-06 bottom plate mini step file fixed, bam saved wrong file
    [bottom-plate-mini_PP-MP0149_revB.step]
2016-09-06 purchasing info
    [Mini_Gladilola_BOM.ods]
2016-09-07 Testing new version of x-end-motor with linear pattern removed from bottom
    [x-end-motor-mini_black_v1.8.stl]
2016-09-07 added approved gcodes
    [wiper_mount_x3.stl]
2016-09-08 Execute ECO 1
    [Mini_Gladilola_BOM.ods]
2016-09-08 restore PO information
    [Mini_Gladilola_BOM.ods]
2016-09-08 cleaned formatting on Purchasing tab of BoM
    [Mini_Gladilola_BOM.ods]
2016-09-08 Allow for larger tolerance of plastic to be pushed through when inserting smooth rods.
    [y-motor-mount_black_v1.4.fcstd, y-motor-mount_black_v1.4.stl]
2016-09-08 Reduce EL-MS205 Qty 4 to Qty 2 on Extruder BOM wrong Part Add EL-MS0212 Qty 2 to Extruder BOM Remove HD-BT0038 Qty 1 from BOM Wrong Part Increase EL-BT107 Qty 10 to Qty 11
    [Mini_Gladilola_BOM.ods]
2016-09-09 Bushing holder base was widened so effects of warping would be minimized.
    -New g code with 2 walls instead of 3 and less fan throughout the print.
    [x-end-motor-mini_black_v1.9.stl]
2016-09-12 Update ground wires
2016-09-12 x-end idler updated with alignment issues fixed, version bumped to v2.6
    [x-end-idler-mini_black_v2.5.stl, x-end-idler-mini_black_v2.6.stl]
2016-09-12 Update state of approval for cluster to print for 29 parts add Odoo part number and formal name
    [printed_part_status.ods]
2016-09-13 chamfer on bottom of mini x end idler increased to 1mm
    [x-end-idler-mini_black_v2.7.stl]
2016-09-15 added electronics chassis artwork
2016-09-16 Move ridge to catch bushings up so it will be flush with bottom of part
    [x-end-idler-mini_black_v2.8.stl]
2016-09-19 updating gcode/parts list
    [printed_part_status.ods]
2016-09-19 Change the angle of the fan from 111 to 107.
    -Edge of shroud was intersecting wiper pad on full build volume prints.
    -Changing the angle of shroud moves it up 3 mm away from wiper pad.
    [extruder_fan_mount_v2.0_mini.fcstd, extruder_fan_mount_v2.0_mini.stl]
2016-09-19 Up the version number and remove old freecad files
    [extruder_fan_mount_v2.1_mini.fcstd, extruder_fan_mount_v2.1_mini.stl]
2016-09-20 Left side rev'd from G to H, the dimension for the masking was modified for clarity and a typo fixed.
    [left-side-mini_PP-FP0055_revG.fcstd, left-side-mini_PP-FP0055_revH.fcstd, left-side-mini_PP-FP0055_revH.step]
2016-09-20 added printed parts gcode
2016-09-20 Add AO part numbers to the extruder assembly cable drawings
2016-09-20 Include the individual part numbers in the master extruder pin assignments drawing
2016-09-21 Only one purple wire assembly is now in the x_max_switch_harness drawing
2016-09-22 Add case fan assembly drawing
2016-09-22 Mini electronics case modified to make internal flange 5mm longer, is now rev G
    [electronics-case-mini_PP-FP0082_revF.fcstd, electronics-case-mini_PP-FP0082_revF.step, electronics-case-mini_PP-FP0082_revG.fcstd, electronics-case-mini_PP-FP0082_revG.step]
2016-09-22 part number for the electronics case updated to PP-FP0082_revG
    [electronics-case-mini_PP-FP0082_revG.fcstd]
2016-09-22 BOM change EL-MS0059 for EL-MS0001 1 for 1 BOM change SH-PG0146 for SH-PG0149 1 for 3 Cable drawings checke by MIC for Eric K for cables EL-HR0128 EL-HR0118 EL-HR0117 EL-HR0068 EL-HR0069 EL-HR0106 EL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
    [Mini_Gladilola_BOM.ods]
2016-09-23 Add PDF files for printing
2016-09-23 Add bed_harness_igus.pdf for printing
2016-09-23 Increase BOM qty for HD-WA0035 from 2 to 6- Eng request for frame grounding
    [Mini_Gladilola_BOM.ods]
2016-09-29 handle widened by 4mm to overlap the sheet metal edge
    [handle-bar_black_v2.6.fcstd, handle-bar_black_v2.6.stl]
2016-09-30 laser etching updated for the electronics case
2016-09-30 added updated gcode for belt mount
2016-09-30 New drawing for mini smooth rods in freecad, add a tolerance to smooth rod length
    [8mmx305_rod_v1.0.fcstd]
2016-10-05 Add emissions data from Sept 26 testing
    [Data Summary 26 September 2016.ods]
2016-10-07 Update to z upper right source to contain mirror operation
    [z-upper-mini-left_black_v2.0.fcstd, z-upper-mini-right_black_v2.0.fcstd, z-upper-mini-right_black_v2.0.stl]
2016-10-07 Update lower z right source to contain mirror operation
    [lower-z-right-mini_lulz-green_v1.6.fcstd, lower-z-right-mini_lulz-green_v1.6.stl]
2016-10-10 gcode file updates
    [handle-bar_black_v2.5.fcstd, handle-bar_black_v2.5.stl, printed_part_status.ods, x-end-idler-mini_black_v2.6.stl, x-end-idler-mini_black_v2.7.stl]
2016-10-10 file adjustments
    [printed_part_status.ods]
2016-10-10 Mini Packing List update logo to R logo, update font, update filament type, change file name, add PDF file
2016-10-11 nut pocket deepened for better fit
    [beefy_extruder_idler_v0.4.fcstd, beefy_extruder_idler_v0.4.stl]
2016-10-12 Remove obsolete Flat BOM Remove incorrectly named BOM Gladilola
    [Mini-flat-BOM.ods, Mini_Gladilola_BOM.ods]
2016-10-12 Update BOM PP-FP0082 Rev F to Rev G Add HD-BL0015 x2 to BOM Correct BOM name Gladiola
    [Mini_Gladiola_BOM.ods]
2016-10-13 add modification warning insert folder with source and PDF for print, add updated safety warnings source and PDF, delete old safety warnings source
2016-10-14 add filament samples label source and PDF
2016-10-14 Changed CE document file name, added signature, and generated CE document PDF print file
2016-10-14 Split out foxglove and gladiola labels and updated gladiola label documents to new set of serial numbers
    [sn_merge_mini-AU.csv, sn_merge_mini-EU.csv, sn_merge_mini-NA.csv]
2016-10-14 Fixed serial numbers as the gladiola and foxglove numbers were swapped
    [sn_merge_mini-AU.csv, sn_merge_mini-EU.csv, sn_merge_mini-NA.csv]
2016-10-14 Mini packing list, upper case B as in Bot
2016-10-17 Dimension for drawing update to correct value
    [8mmx305_rod_v1.0.fcstd, 8mmx315_rod_v1.0.fcstd]
2016-10-18 Added 80mm Fan Jig
    [Glad_80mmFanJig.fcstd, Glad_80mmFanJig.stl]
2016-10-20 Made new calibrattion octo g code for pla
2016-10-20 Clean up a no longer used part
    [fan_guard_v1.fcstd, fan_guard_v1.stl]
2016-10-21 Add 8mmx19mm rod source
    [8x19mm_smooth_rod_revA.fcstd]
2016-10-21 Update and rearrange source for herringbone gears
    [Large-Herringbone_gears_hi-res_chamfer.scad, Small-Herringbone_gears_hi-res.scad, configuration.scad, functions.scad, herringbone_small_gear-1.1-highres.stl, jonaskuehling-default.scad, lrg_herringbone_gear_v1.3.stl, metric.scad]
2016-10-21 Rename a few firmware files
    Conflicts:
    software/firmware/Marlin_Mini_v1.1.0.9
2016-10-21 Update Cura source submodule and add binaries
    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
2016-10-21 Remove older generation of idler
    [beefy_extruder_idler_v0.3.fcstd, beefy_extruder_idler_v0.3.stl]
2016-10-24 Add X motor jig and Y motor jig and Y-extension radius jig to Jigs folder
    [Gladiola_x_motor_jig.fcstd, Gladiola_x_motor_jig.stl, Gladiola_y_motor_jig.fcstd, Gladiola_y_motor_jig.stl, Y-Extension_Radius_Jig.fcstd, Y-Extension_Radius_Jig.stl]
2016-10-24 Add October 21 radiated emissions test data
    [Data Summary 21 October 2016.ods]
2016-10-25 bed plate laser etching files moved to correct location
2016-10-25 added test version of the spool arm to improve drop test results
    [spool-arm-support_black_v1.2.fcstd, spool-arm-support_black_v1.2.stl]
2016-10-25 To BOM Add PP-FP0081 Etched bed plate, PP-MP0146 is a sub part to this item Add DC-MN0014- Packaging Add DC-LB0095- Packaging Add DC-LB0111- Packaging Add DC-MN0014- Packaging Add SH-PG0030- Packaging
    [Mini_Gladiola_BOM.ods]
2016-10-25 another test version of the spool arm support added
    [spool-arm-support_black_v1.3.fcstd, spool-arm-support_black_v1.3.stl]
2016-10-26 Remove old stl file and unused operation in freecad file
    [x-end-motor-mini_black_v1.7.stl, x-end-motor-mini_black_v1.8.stl, x-end-motor-mini_black_v1.9.stl]
2016-10-28 added ECO purchasing information
    [Mini_Gladiola_BOM.ods]
2016-11-02 Remove PP-MP0049 heat sink from BOM
    [Mini_Gladiola_BOM.ods]
2016-11-03 handle modified for easier heat set installation
    [handle-bar_black_v2.7.fcstd, handle-bar_black_v2.7.stl]
2016-11-04 x-end motor modified to reduce plastic bloom
    [x-end-motor-mini_black_v2.0.stl]
2016-11-04 added beefy-idler gcode
2016-11-07 Added Gladiola Control Box Tie Down Jig
    [Glad_tie_down_jig.fcstd, glad_tie_down_jig.stl]
2016-11-08 x-end-motor modified to allow more room for cableflex wiring
    [x-end-motor-mini_black_v2.1.stl]
2016-11-09 Updated Gladiola Control Box Tie Down Jig
    [Glad_tie_down_jig.fcstd, glad_tie_down_jig.stl]
2016-11-09 New revision of y idler adjusted smooth rod pocket, insert holes
    [y-idler-mini_black_v1.5.fcstd, y-idler-mini_black_v1.5.stl]
2016-11-10 y-idler updated to v1.6, new design allows ~1mm more clearance in order to lower fallout
    [y-idler-mini_black_v1.6.fcstd, y-idler-mini_black_v1.6.stl]
2016-11-10 added updated gcodes
    [x-end-motor-mini_black_v1.9.stl, x-end-motor-mini_black_v2.0.stl, y-idler-mini_black_v1.4.fcstd, y-idler-mini_black_v1.4.stl, y-idler-mini_black_v1.5.fcstd, y-idler-mini_black_v1.5.stl]
2016-11-12 Replace SH-PG0147 with SH-PG0150 5” long smooth rod foam on BOM with start of Galdiola build Confirm purchase order change for SH-PG0150 from ECO 3 is started
    PP-GP0267 X carriage motor design change for Extruder harness clearance, phased in change
    PP-GP0263 Y ilder design change to rod pocket to accommodate allowable frame deflection
    Increase 1x of HD-MS0058 Cable tie to Y Axis assembly
    Increase 1x of HD-MS0058 Cable tie to Z left assembly
    Decrease 2x of HD-WA0038 from Y Axis Damper assembly
    Decrease 40mm of EL-MS0073 to 910mm for better fit of loom that was 140mm long
    [Mini_Gladiola_BOM.ods]
2016-11-14 update PP-GP0263 to PP-GP0264 in ECO details
    [Mini_Gladiola_BOM.ods]
2016-11-14 Reduce 140mm length of EL-MS0073 to 100mm
    Remove downlevel versions
2016-11-15 Remove Marlin submodule (about to re-add in a cleaner way)
2016-11-15 Add source code for Marlin as a submodule
2016-11-16 Add radiated emissions data taken on November 15 2016
    [Data Summary 15 November 2016.xlsx]
2016-11-16 Added YZ Harness jig
    [YZharnessjig1.fcstd, yz_harness_jig1.stl]
2016-11-16 added assembly directory & step files for assem
    [608ZZ_bearing.fcstd, 608ZZ_bearing.step, 8mmx315_rod_v1.0.step, 8x19mm_smooth_rod_revA.step, AO-Hexagon-Hotend.fcstd, Beltmount_Clamp.fcstd, Boro-Glass_bed_170x170.fcstd, Hotend_Step.step]
2016-11-16 Add heatshrink to right-end of Z-max&X-min cable
2016-11-16 Replace xlsx file with an ods format
    [Data Summary 15 November 2016.ods, Data Summary 15 November 2016.xlsx]
2016-11-16 dodo assembly updated, Removed production_parts/assembly dir to match Olive assembly dir structure
    [608ZZ_bearing.fcstd, 608ZZ_bearing.step, AO-Hexagon-Hotend.fcstd, Beltmount_Clamp.fcstd, Boro-Glass_bed_170x170.fcstd, Hotend_Step.step, Hotend_Step2.step, RJM_01_08_1.stp]
2016-11-16 glad assembly updated
    [lower-z-right-mini_lulz-green_v1.6.obj, mini-gladiola_v1.fcstd]
2016-11-16 created 627 bearing, full length drive rod and z coupler step files.
    [627_bearing.fcstd, 627_bearing.step, drive_rod_10mm_mini_full_length.step, z_coupler.step]
2016-11-16 Add spacing to use a pre-printed sticker in firmware version space
2016-11-16 added idler gcode 2432
2016-11-17 Prepare to make a change to calibration print
2016-11-17 Update part removal temperature on calibration print
2016-11-18 updated dodo asm,built x axis asm, updated glad asm with tool head and x
2016-11-18 "updated dodo asm,built x axis asm, updated glad asm with tool head and x"
    [MTS10x2m_lead_nut.step, MTS10x2m_leadnut.fcstd, mts10x2m.stp, x_idler_end_assm.fcstd, x_motor_end_assm.fcstd]
2016-11-18 Updated glad assm with updated x axis, added power switch, added dampers to y and z motors
    [nema17_damper.fcstd, nema17_damper.step, power_switch.fcstd]
2016-11-21 Rescale to 95% so models fit the build volume of a LulzBot Mini
    [rocktopus_nsedit.stl]
2016-11-23 Added Beefy Idler Spacer, And X-Min Wrap Jig
    [X-MIN_WRAP_JIG.fcstd, X-MIN_WRAP_JIG.stl, beefy_spacer_v0.3.fcstd, beefy_spacer_v0.3.stl]
2016-11-23 Added 80mm Gladiola Harness spacer jig
    [EL-HR0108_80mm_spacer.stl, EL-HR0180_80mm_spacer.fcstd]
2016-11-28 Add belt mount v1.2
    [belt-mount_black_v1.2.fcstd, belt-mount_black_v1.2.stl]
2016-11-28 tready belt clamp added (v1.2)
    [belt-clamp-mini_black_v1.2.fcstd, belt-clamp-mini_black_v1.2.stl]
2016-12-01 organized files
    [belt-clamp_black_v1.1.fcstd, belt-clamp_black_v1.1.step, belt-clamp_black_v1.1.stl, belt-mount_black_v1.1.fcstd, belt-mount_black_v1.1.step, belt-mount_black_v1.1.stl]
2016-12-01 belt mount and clamp gcodes added
2016-12-01 Release Odoo subassemblies to BOM ECO 11
    [Mini_Gladiola_BOM.ods]
2016-12-02 new x-carriage cap added (v2.5)
    [x-carriage-cap_black_v2.5.fcstd, x-carriage-cap_black_v2.5.stl]
2016-12-06 add assembly AS-CB0007 and AS-CB0008 odoo numbers to BOM remove place holders for same Correct AS-PR0035 with KT-PR0035
    [Mini_Gladiola_BOM.ods]
2016-12-07 x carriange cap gcode update
    [x-carriage-cap_black_v2.4.fcstd, x-carriage-cap_black_v2.4.step, x-carriage-cap_black_v2.4.stl]
2016-12-08 Replace AS-CB0007 with AS-CB0024 and replace AS-CB0008 with AS-CB0025
    [Mini_Gladiola_BOM.ods]
2016-12-08 Replace 0.5mm_hotend_harness with AS-CB0024 and AS-CB0025
    Replace extruder_pin_assignments with AS-TH0022_Mini_extruder_pin_assignment_revB
2016-12-15 Correct minor formatting issue and typo changes have no impact on Odoo or manufacturing
    [Mini_Gladiola_BOM.ods]
2016-12-16 Release Rev B of AS-CB0024 for wire strip length
2016-12-19 Replace PP-GP0258 with PP-GP0280 implement use in production 12/19
    [Mini_Gladiola_BOM.ods]
2016-12-21 Update Marlin firmware to v1.1.0.11
2016-12-21 Add SH-PG0150 to lookup list item was on MBOM and Purchase BOM
    [Mini_Gladiola_BOM.ods]
2016-12-22 Revise wire strip length for FASTON/ PIDG connector for EL-HR0068 EL-HR0069 EL-HR0104 EL-HR0106 EL-HR0107 EL-HR0127 EL-HR0125
2017-01-03 test versions of the x-carriage added
    [x-carriage-mini_black_v1.2.fcstd, x-carriage-mini_black_v1.2.stl, x-carriage-mini_black_v1.3-0.5mm.fcstd, x-carriage-mini_black_v1.3-0.5mm.stl, x-carriage-mini_black_v1.3-1mm.fcstd, x-carriage-mini_black_v1.3-1mm.stl]
2017-01-03 test file name modified and unused files deleted
    [x-carriage-mini_black_v1.3-0.5mm.fcstd, x-carriage-mini_black_v1.3-0.5mm.stl, x-carriage-mini_black_v1.3.fcstd, x-carriage-mini_black_v1.3.stl]
2017-01-05 x-carriage v1.4 added, decreases size of bearing rings to try to lower cluster fallout for tight bushings
    [x-carriage-mini_black_v1.4.fcstd, x-carriage-mini_black_v1.4.stl]
2017-01-06 anti-warp feature added to the x-carriage
    [x-carriage-mini_black_v1.4.fcstd, x-carriage-mini_black_v1.4.stl]
2017-01-10 Removed one bearing from bore to prevent over constraint
    [x-carriage-mini_black_v1.5.fcstd, x-carriage-mini_black_v1.5.stl]
2017-01-10 Made cosmetic change to bearing bore
    [x-carriage-mini_black_v1.5.fcstd, x-carriage-mini_black_v1.5.stl]
2017-01-12 Add second retainer ring for stability
    [x-carriage-mini_black_v1.5.1.fcstd, x-carriage-mini_black_v1.5.1.stl]
2017-01-12 Constrict bore for tighter bearing fit
    [x-carriage-mini_black_v1.5.1.fcstd, x-carriage-mini_black_v1.5.1.stl]
2017-01-13 updated pp-gp0232 gcode name
    [handle-bar_black_v2.6.fcstd, handle-bar_black_v2.6.stl]
2017-01-13 updated pp-gp0191 gcode name
    [Large-Herringbone_gears_hi-res_chamfer.scad, Small-Herringbone_gears_hi-res.scad, configuration.scad, functions.scad, herringbone_small_gear-1.1-highres.stl, jonaskuehling-default.scad, lrg_herringbone_gear_v1.3.stl, metric.scad]
2017-01-13 updated pp-gp0265 gcode name
    [spool-arm-support_black_v1.2.fcstd, spool-arm-support_black_v1.2.stl, spool-arm-support_black_v1.3.fcstd, spool-arm-support_black_v1.3.stl]
2017-01-13 updated as-pr0056 gcode name
    [x-carriage-mini_black_v1.1.fcstd, x-carriage-mini_black_v1.1.step, x-carriage-mini_black_v1.1.stl, x-carriage-mini_black_v1.2.fcstd, x-carriage-mini_black_v1.2.stl, x-carriage-mini_black_v1.3.fcstd, x-carriage-mini_black_v1.3.stl, x-carriage-mini_black_v1.4.fcstd]
2017-01-16 updated idler latch gcode name
2017-01-20 updated file name
    [Large-Herringbone_gears_hi-res_chamfer.scad, Small-Herringbone_gears_hi-res.scad, configuration.scad, functions.scad, jonaskuehling-default.scad, metric.scad, nuts_and_bolts.scad, parametric_involute_gear_v5.0.scad]
2017-02-03 Remove obsolete parts
    [x-carriage-mini_black_v1.5.1.fcstd, x-carriage-mini_black_v1.5.1.stl, x-carriage-mini_black_v1.5.fcstd, x-carriage-mini_black_v1.5.stl]
2017-02-03 drive rod drawing updated to improve clarity, is now rev E
    [drive_rod_10mm_mini_HD-RD0037.fcstd, drive_rod_10mm_mini_HD-RD0037_revE.fcstd]
2017-02-07 typo fixed in leadscrew drawing
    [drive_rod_10mm_mini_HD-RD0037_revE.fcstd]
2017-02-20 modified 10mm drive rod tolerance
    [drive_rod_10mm_mini_HD-RD0037_revF.fcstd]
2017-03-08 Updated drawing to rev G new hanging locations for powder coat
    [top-plate-mini_PP-FP0051_revG.fcstd]
2017-03-20 Updated X extruder harness drawing
2017-06-19 Added y_rod mount nylock nut insert jig
    [Gladiola_y_rod_mount_insert_jig.stl, glad_y_rod_mount_insertion_jig.fcstd]
2017-06-21 Added smaller y rod mount insert jig
    [Gladiola_y_rod_mount_insert_jig_0.2.stl]
2017-06-29 Added strengthened extruder mount
    [extruder_mount_v2.12.blend, extruder_mount_v2.12.stl]
2017-07-06 added strengthened extruder mount FreeCAD file
    [extruder_mount_v2.12.fcstd]
2017-07-06 added extruder mount v2.13 - additional strengthening/fan mount correction added extruder mount v2.14 - 11mm thick variant for testing added readme file to extruder mount testing folder explaining ve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
    [extruder_mount_v2.13.fcstd, extruder_mount_v2.13.stl, extruder_mount_v2.14.fcstd, extruder_mount_v2.14.stl]
2017-07-17 Added more support to address drooping cable chains
    [x-end-motor-mini_black_v2.2.stl]
2017-07-17 Added source file for drooping cable chain fix
    [x-end-motor-mini_black_v2.2.blend]
2017-07-21 Added cable guide beam to patch drooping cable chain
    [CableGuideBeam-Gladiola7.stl]
2017-07-31 Updated HD-RD0004 drawing to reflect expanded length tolerance, previous tolerance found to be too restrictive
    [8x19mm_smooth_rod_revB.fcstd]
2017-08-08 pp-gp0254 stl new v 1.3
    [spool-arm-support_black_v1.3.stl]
2017-08-14 Added test_part_files directory to Z-Upper Left and Right
    This directory contains test parts for Mini Z-Upper Left/Right with a widened bearing hole to reduce Z-Wobble artifacts in prints, see README
    [MiniZ-UpperLeft_24mmBearingHole.fcstd, MiniZ-UpperLeft_24mmBearingHole.stl, MiniZ-UpperRight_24mmBearingHole.fcstd, MiniZ-UpperRight_24mmBearingHole.stl]
2017-08-18 Removed laser etching from PP-MP0146 and PP-FP0082
    [bed-plate-mini_PP-MP0146_revD.fcstd, electronics-case-mini_PP-FP0082_revH.fcstd]
2017-08-21 Change laser etching to graphics in dir and drawings
2017-08-22 Update bed mount graphic drawing
2017-08-25 added .step files for revH electronics case and revD bed mount plate
    [bed-mount-plate-mini_PP-MP0146_revD.step, electronics-case-mini_PP-FP0082_revH.step]
2017-08-28 Removed link from x cable chain EL-HR0108.
2017-08-30 Corrected heat shrink tubing part number to HD-TB0066 on EL-HR0115
2017-08-30 Added new jig for drilling center hole on small herringbone gears titled HerringBone6shooter
    [Herring6shooterTOP.stl, HerringBone6shooter.stl, HerringBone6shooterTOP.fcstd]
2017-09-13 pp-gp0191 gcode update
    [lrg_herringbone_gear_v1.3.stl]
2017-09-25 Update Black Heat Shrink tubing p/n on EL-HR0114 from EL-MS0439 to EL-MS0247
2017-10-10 Reverted EL-HR0108 to revI
    We currently have enough to complete Mini v1.04, Mini2 does not include the revJ change,
    therefore cables will not be ordered according to revJ drawing.
2017-12-07 added welding callout
    [bottom-plate-mini_PP-MP0149_revD.fcstd]
2017-12-08 drawing updates for silkscreen and from feedback
    [bed-mount-plate-mini_PP-FP0138_revF.fcstd, bottom-plate-mini_PP-MP0149_revD.fcstd, electronics-case-mini_PP-FP0139_revJ.fcstd, top-plate-mini_PP-FP0051_revH.fcstd]
2017-12-14 removed old revisions of recently updated drawings
    [bed-mount-plate-mini_PP-MP0146_revC.fcstd, bed-mount-plate-mini_PP-MP0146_revC.step, bed-mount-plate-mini_PP-MP0146_revD.step, bed-plate-mini_PP-MP0146_revD.fcstd, bottom-plate-mini_PP-MP0149_revB.fcstd, bottom-plate-mini_PP-MP0149_revB.step, electronics-case-mini_PP-FP0082_revG.fcstd, electronics-case-mini_PP-FP0082_revG.step]
2017-12-18 Added z-tops with 24mm bearing holes
    [MiniZ-UpperLeft_24mmBearingHole.fcstd, MiniZ-UpperLeft_24mmBearingHole.stl, MiniZ-UpperRight_24mmBearingHole.fcstd, MiniZ-UpperRight_24mmBearingHole.stl]
2018-01-23 Generated aerostruder slice for pp-gp0248 mini flexy bed corner
2018-01-31 Generated new slice for PP-GP0186 extruder body hex to conform to taz prints
2018-01-31 updated slice for spool arm support, part B PP-GP0318
2018-01-31 Update slice for 2 piece spool arm support. Part A from frame to spool arm support
2018-03-05 Update PP-MP0149 bottom plate to RevE.
    [bottom-plate-mini_PP-MP0149_revD.fcstd, bottom-plate-mini_PP-MP0149_revE.fcstd, bottom-plate-mini_PP-MP0149_revE.step]
2018-03-06 updated drawing to remove obstructive leader line center points
    [bottom-plate-mini_PP-MP0149_revE.fcstd]
2018-05-15 Updates slice for PP-GP0191 herringbone large gear green to be printed on hibiscus machines T2490
2018-07-24 Add QA record to print for Refurb
2018-09-17 Added tool head test stand gcodes to sample_prints/calibration T3548
2018-10-09 Add final BoM after change order clean up
    [Mini_Gladiola_BOM_OCA_AU.ods, Mini_Gladiola_BOM_OCA_EU.ods, Mini_Gladiola_BOM_OCA_NA.ods]
2019-01-09 Add E3D mount plate to replace RepRape T5110
    [MOARstruder-mount-plate_PP-MP0156_revA.fcstd]
2019-03-19 Updates slice for PP-GP0245 beefy idler latch v2.2 T6276
    removes ~33mm of skirt extruded per print
